wrbell/dad-ornithopter/INDEX.md

# MCO-1D Master Catalog & File Index

Comprehensive index of all active engineering assets and quarantined archives in the MCO-1D repository.

- **[ACTIVE]**: Authoritative configuration, firmware, parametric CAD, or documentation used for the physical build.
- **[ARCHIVE]**: Quarantined legacy iterations, duplicate modules, or unverified prototypes retained for reference.

---

## 1. Single Source of Truth & Governance (`config/`, `bom/`, `tools/`)

| File | Status | Description |
| :--- | :---: | :--- |
| [`config/airframe_spec.json`](config/airframe_spec.json) | **[ACTIVE]** | Canonical JSON specification for airframe mass (`3.642 kg` installed), geometry (`2.20 m` span, `0.28 m` chord, `2.24 m²` area), `10.0:1` capstan drivetrain, CAN nodes `0..7`, and GPIO pins. |
| [`firmware/mco_config.py`](firmware/mco_config.py) | **[ACTIVE]** | Python loader exposing `MCOConfig` to all firmware modules, CAD generators, and tests. |
| [`bom/bom.csv`](bom/bom.csv) | **[ACTIVE]** | Standard 39-component Bill of Materials CSV generated by [`scripts/mco_bom_tool.py`](scripts/mco_bom_tool.py) and validated by [`tools/bom_lint.py`](tools/bom_lint.py). |
| [`willem-suggestions.md`](willem-suggestions.md) | **[ACTIVE]** | Comprehensive technical audit, hardware/CAD/firmware bug post-mortem, and refactoring roadmap. |
| [`AGENTS.md`](AGENTS.md) / [`CLAUDE.md`](CLAUDE.md) | **[ACTIVE]** | Root and domain-specific (`firmware/`, `cad/`, `scripts/`, `docs/`, `tests/`) AI agent instructions. |
| [`tools/`](tools/) | **[ACTIVE]** | Collection standards linters (`agents_md_lint.py`, `ai_file_lint.py`, `bom_lint.py`, `check_docs.py`, `check_prints.py`). |

---

## 2. MCO-1D Mark 1 Documentation Suite (`docs/mark1/`)

| File | Status | Description |
| :--- | :---: | :--- |
| [`MCO-1D_Mark1_Master_Specification.md`](docs/mark1/MCO-1D_Mark1_Master_Specification.md) | **[ACTIVE]** | Master design specification: cascade geometry, S1223 aerodynamics, `10.0:1` capstan drivetrain, mass balance, and power budget. |
| [`MCO-1D_Mark1_Bill_of_Materials.md`](docs/mark1/MCO-1D_Mark1_Bill_of_Materials.md) | **[ACTIVE]** | Auto-generated 39-item procurement and mass ledger (`3,642 g` installed airframe mass; `6,150 g` shipped total; `$3,757.58 USD`). |
| [`MCO-1D_Mark1_Manufacturing_Guide.md`](docs/mark1/MCO-1D_Mark1_Manufacturing_Guide.md) | **[ACTIVE]** | Airframe fabrication manual: LW-PLA rib printing, carbon spar assembly, and `180 N` Dyneema capstan rigging. |
| [`MCO-1D_Mark1_Commissioning_Manual.md`](docs/mark1/MCO-1D_Mark1_Commissioning_Manual.md) | **[ACTIVE]** | Step-by-step airframe assembly, 8x ODrive CAN configuration, 16x AGFRC servo travel setup, and MCP3208 SPI ADC zeroing. |
| [`MCO-1D_Mark1_Operator_Manual.md`](docs/mark1/MCO-1D_Mark1_Operator_Manual.md) | **[ACTIVE]** | Pilot Operating Handbook (POH): Unified Wave Lever zones, takeoff/landing profiles, and emergency checklists. |
| [`MCO-1D_Mark1_Flight_Test_Protocol.md`](docs/mark1/MCO-1D_Mark1_Flight_Test_Protocol.md) | **[ACTIVE]** | 4-phase progressive test clearance: TC-01 (Bench), TC-02 (Tethered lift), TC-03 (Truck sweep), TC-04 (First free flight). |
| [`MCO-1D_Mark1_Builder_Calibration_Sheet.md`](docs/mark1/MCO-1D_Mark1_Builder_Calibration_Sheet.md) | **[ACTIVE]** | Post-build hardware measurement manifest (`FIG-01` to `FIG-08`) and pre-flight signoff sheet ([`PDF`](docs/mark1/MCO-1D_Mark1_Builder_Calibration_Sheet.pdf)). |
| [`MCO-1D_Mark1_Test_Card_Worksheets.md`](docs/mark1/MCO-1D_Mark1_Test_Card_Worksheets.md) | **[ACTIVE]** | Field data worksheets (`WS-00` through `WS-04`) and printable PDFs in [`docs/mark1/worksheets/`](docs/mark1/worksheets/). |
| [`MCO-1D_Mark1_Flight_Envelope_Specification.md`](docs/mark1/MCO-1D_Mark1_Flight_Envelope_Specification.md) | **[ACTIVE]** | Operating corridors, $V$-$n$ structural limits (`[-1.0g, +2.2g]`), and stall speed scaling. |
| [`MCO-1D_Mark1_Software_Reference.md`](docs/mark1/MCO-1D_Mark1_Software_Reference.md) | **[ACTIVE]** | 50 Hz executive loop architecture, safety governors, and CAN frame reference. |
| [`MCO-1.5D_SD7062_Specification.md`](docs/mark1/MCO-1.5D_SD7062_Specification.md) | **[ACTIVE]** | Alternate SD7062 lower-camber wing panel specification. |
| [`MCO-1D_Fasteners_and_Inserts_Mass_Budget.md`](docs/mark1/MCO-1D_Fasteners_and_Inserts_Mass_Budget.md) | **[ACTIVE]** | Fastener, bearing, dead-axle, and heat-set insert mass ledger. |
| [`MCO-1D_Hierarchical_Exploded_Installation_Guide.pdf`](docs/mark1/MCO-1D_Hierarchical_Exploded_Installation_Guide.pdf) | **[ACTIVE]** | 2-page 3-tier installation guide (Bevel Wrist -> Stagecoach Shoulder -> Fuselage Collar). |
| [`MCO-1D_V10_Powertrain_Mount_Installation_Guide.pdf`](docs/mark1/MCO-1D_V10_Powertrain_Mount_Installation_Guide.pdf) | **[ACTIVE]** | V10 Powertrain Stand, Dual-Shear Top Brace, and ODrive mounting manual. |
| [`MCO-1D_V10_Stagecoach_Wrist_Assembly_Guide.pdf`](docs/mark1/MCO-1D_V10_Stagecoach_Wrist_Assembly_Guide.pdf) | **[ACTIVE]** | V10 7-spoke Stagecoach sector drum and 2-DOF bevel wrist assembly guide. |
| [`MCO-1D_Electronics_and_Systems_Guide.pdf`](docs/mark1/MCO-1D_Electronics_and_Systems_Guide.pdf) | **[ACTIVE]** | Avionics, CAN bus topology, and dual-SBEC 7.4V servo power distribution guide. |

---

## 3. Core Flight Software (`firmware/`)

| File | Status | Description |
| :--- | :---: | :--- |
| [`mco_main.py`](firmware/mco_main.py) | **[ACTIVE]** | 50 Hz flight executive loop, sensor polling, command dispatch, and failsafe handling. |
| [`mco_config.py`](firmware/mco_config.py) | **[ACTIVE]** | Single-source-of-truth configuration loader reading [`config/airframe_spec.json`](config/airframe_spec.json). |
| [`mco_kinematics.py`](firmware/mco_kinematics.py) | **[ACTIVE]** | Deterministic 50 Hz metachronal phase oscillator, control allocation mixer, and 8-wing kinematics synthesizer (`MetachronalSynthesizer`), verified by [`tests/test_mco_kinematics.py`](tests/test_mco_kinematics.py). |
| [`mco_odrive_interface.py`](firmware/mco_odrive_interface.py) | **[ACTIVE]** | SocketCAN (`can0`) driver for 8x ODrive controllers (`10.0:1` capstan ratio, reciprocating velocity commands). |
| [`mco_odrive_setup.py`](firmware/mco_odrive_setup.py) | **[ACTIVE]** | ODrive CAN provisioner and calibration script. |
| [`mco_flight_governor.py`](firmware/mco_flight_governor.py) | **[ACTIVE]** | Envelope protection, WIG floor governor, load-factor limiter, and servo rate clamping. |
| [`mco_intent_control.py`](firmware/mco_intent_control.py) | **[ACTIVE]** | 5-channel pilot stick and unified wave-lever intent arbitration. |
| [`mco_performance_model.py`](firmware/mco_performance_model.py) | **[ACTIVE]** | Analytical aerodynamic performance estimator reading `MCOConfig`. |
| [`mco_cg_estimator.py`](firmware/mco_cg_estimator.py) | **[ACTIVE]** | Longitudinal Center of Gravity moment-arm calculator. |
| [`mco_build_measurements.py`](firmware/mco_build_measurements.py) | **[ACTIVE]** | Builder measurement ingestion tool (`knowledge/build_measurements.json`). |
| [`mco_preflight_checks.py`](firmware/mco_preflight_checks.py) | **[ACTIVE]** | Pre-flight Built-In Test (BIT) checking bus voltages, sensors, ADCs, and disk space. |
| [`mco_test_cards.py`](firmware/mco_test_cards.py) | **[ACTIVE]** | Test card runner for TC-01 through TC-04. |
| [`mco_first_run_wizard.py`](firmware/mco_first_run_wizard.py) | **[ACTIVE]** | Interactive hardware commissioning wizard. |
| [`mco_rc_verify.py`](firmware/mco_rc_verify.py) | **[ACTIVE]** | RC transmitter channel and detent verification utility. |
| [`mco_vibration_check.py`](firmware/mco_vibration_check.py) | **[ACTIVE]** | MPU-6050 accelerometer FFT vibration and capstan slip check. |
| [`mco_taxi_park.py`](firmware/mco_taxi_park.py) | **[ACTIVE]** | Ground taxi and wing stow/park coordinator. |
| [`mco_loadcell.py`](firmware/mco_loadcell.py) | **[ACTIVE]** | HX711 24-bit ADC driver for bench load-cell thrust measurements. |
| [`mco_logger.py`](firmware/mco_logger.py) / [`mco_log_analysis.py`](firmware/mco_log_analysis.py) | **[ACTIVE]** | 50 Hz CSV telemetry logger and post-flight log analyzer. |
| [`mco_mavlink.py`](firmware/mco_mavlink.py) | **[ACTIVE]** | Serial MAVLink v2 heartbeat and telemetry interface. |
| [`mco_ground_station.py`](firmware/mco_ground_station.py) / [`mco_gs_server.py`](firmware/mco_gs_server.py) / [`mco_ws_bridge.py`](firmware/mco_ws_bridge.py) | **[ACTIVE]** | Terminal CLI, HTTP server, and WebSocket telemetry bridge. |
| [`mco_panel.py`](firmware/mco_panel.py) / [`mco_sync.py`](firmware/mco_sync.py) / [`mco_hypothesis_tool.py`](firmware/mco_hypothesis_tool.py) | **[ACTIVE]** | Onboard SPI touchscreen diagnostic panel, log sync, and hypothesis inspector. |
| [`mco_wave_library.py`](firmware/mco_wave_library.py) / [`mco_advanced_physics.py`](firmware/mco_advanced_physics.py) | **[ACTIVE]** | Legacy wave hypothesis library (scheduled for replacement per [`willem-suggestions.md`](willem-suggestions.md)). |

---

## 4. Parametric CAD, Print Packages & Tooling (`cad/`, `scripts/`)

| File / Directory | Status | Description |
| :--- | :---: | :--- |
| [`scripts/mco_cli.py`](scripts/mco_cli.py) | **[ACTIVE]** | Unified CLI backing `./mco` (`doctor`, `test`, `sim`, `cad`, `slice`, `bom`, `docs`). |
| [`scripts/mco_bom_tool.py`](scripts/mco_bom_tool.py) | **[ACTIVE]** | Dynamic BOM calculator exporting [`bom/bom.csv`](bom/bom.csv), updating [`config/airframe_spec.json`](config/airframe_spec.json), and generating [`docs/mark1/MCO-1D_Mark1_Bill_of_Materials.md`](docs/mark1/MCO-1D_Mark1_Bill_of_Materials.md). |
| [`scripts/cad/`](scripts/cad/) | **[ACTIVE]** | 15 parametric CadQuery and DXF generators for wing root, S1223/SD7062 wings, and fuselage. |
| [`scripts/docs/`](scripts/docs/) | **[ACTIVE]** | ReportLab PDF assembly manual and field worksheet generators. |
| [`scripts/renders/`](scripts/renders/) | **[ACTIVE]** | PyVista off-screen technical rendering scripts. |
| [`scripts/mcp/prusaslicer_mcp_server.py`](scripts/mcp/prusaslicer_mcp_server.py) | **[ACTIVE]** | FastMCP server driving PrusaSlicer CLI & GUI. |
| [`cad/print_package_wing_root/`](cad/print_package_wing_root/) | **[ACTIVE]** | Wing root 3D print package (`01`–`08` + `PLATE_01_PA12CF_ALL_STRUCTURAL_PARTS.stl`). |
| [`cad/manufactured/`](cad/manufactured/) | **[ACTIVE]** | Generated `.step`, `.stl`, `.3mf`, `.dxf`, and `.f3d` models and render directories. |
| [`cad/slicer_profiles/`](cad/slicer_profiles/) | **[ACTIVE]** | PrusaSlicer `.ini` profiles (`pa12cf_structural`, `pa12cf_solid_gears`, `lwpla_aero_fairing`, `pla_prototype`). |
| [`cad/coordinates/`](cad/coordinates/) | **[ACTIVE]** | Selig S1223 and SD7062 airfoil coordinate files. |
| [`cad/drawings/`](cad/drawings/) | **[ACTIVE]** | 2D engineering drawings and HTML schematics. |

---

## 5. Quarantined Archives (`archive/`, `*/archive/`)

| Archive Location | Status | Contents |
| :--- | :---: | :--- |
| [`firmware/archive/legacy_modules/`](firmware/archive/legacy_modules/) | **[ARCHIVE]** | 14 duplicate/superseded firmware modules (`mco_preflight.py`, `mco_mavlink_bridge.py`, `mco_certification_tools.py`, etc.). |
| [`scripts/archive/fake_audits/`](scripts/archive/fake_audits/) | **[ARCHIVE]** | 18 quarantined fake FEA/CFD/LEGO/interference scripts that printed hardcoded `CERTIFIED` banners. |
| [`archive/tests_tautological/`](archive/tests_tautological/) | **[ARCHIVE]** | 47 quarantined tautological dictionary-lookup test suites. |
| [`archive/ui_claude_artifacts/`](archive/ui_claude_artifacts/) | **[ARCHIVE]** | 5 orphaned React `.jsx` artifacts with no bundler or backend integration. |
| [`docs/archive/`](docs/archive/) & [`docs/latest/`](docs/latest/) | **[ARCHIVE]** | Historical v1–v25 PDFs, quarantined synthetic CFD reports, and Mark 2 conceptual notes. |
