wrbell/dad-ornithopter/docs/latest/MCO_1D_Technical_Handover_v2.docx

MCO-1D METACHRONAL CASCADE ORNITHOPTER

DRONE PROTOTYPE

COMPLETE TECHNICAL HANDOVER DOCUMENT — REVISION 2

Requirements • Assumptions • Design Decisions • Algorithms • Formulae • Constraints • Bibliography

Wave Library: Rev-H-A-B-C-D-E-F-G-H-I-J-K-L-M-N-O2-O3-P

Document Date: 2026-06-11 | Supersedes Revision 1 (2026-06-10)

Classification: Engineering Design Record — Not for Distribution

Revision 2 additions: sprint sweep correction • trim zone analysis • ballistic descent clarification •

crab manoeuvre deep-dive • X-29 analysis • Rev O3-P (Boyd PI anti-windup, stoop latch, intent reset) • external submission evaluation

# 1. Programme Identity and Mission

## 1.1 Project Overview

The Metachronal Cascade Ornithopter (MCO) programme produces a small unmanned drone prototype (MCO-1D, 3.448 kg) as a technology demonstrator for a full-scale piloted Search-and-Rescue aircraft (MCO-1A, 376 kg). The core propulsion mechanism is four cascade-arranged wing pairs, each executing a metachronal stroke — sequential phase offsets between pairs, analogous to crustacean locomotion.

## 1.2 Requirements

- Sustained forward flight at cruise ≥ 9 m/s (17.5 kt).
- Metachronal cascade flapping as the sole propulsion and lift mechanism.
- Intent-based flight control architecture validated on MCO-1D before scaling to MCO-1A.
- Mountain and wilderness SAR mission capability at full scale.
- No hover requirement. No vertical take-off. Forward flight only.
- All wing parameters must stay within physical hardware limits enforced in software unconditionally.

## 1.3 Vehicle Specifications

Parameter | Value / Specification
Designation | MCO-1D (drone prototype)
MTOW | 3.448 kg
Stall speed Vs | 9.42 kt = 4.848 m/s (computed from MTOW, S, CL_max)
Design cruise speed | 9.0 m/s (17.5 kt)
Sprint speed | 14 m/s (27 kt)
Vne (structural limit) | 28 m/s (54 kt)
Total wing area S | 0.9796 m² (4 pairs, both sides; per geometry table)
Wing pairs | 4 (W1 foremost → W4 rearmost)
Chord (all pairs) | 165 mm (constant)
Airfoil | UIUC S1223 (Selig, Re ≈ 200,000)
CL_max | 2.40 (S1223 + VGs at 17%c + Gurney flap at 1%c + raked tip)
Effective AR at 90° sweep | ≈ 4.5
Oswald efficiency e | 0.78 (estimate — # CAL:)
Flap stroke amplitude | ±80° (full stroke = 160°)
Max flap frequency | 3.0 Hz (ODrive + 7:1 rope drive ceiling)
Sweep range | 0° (full forward) to 210° (stowed) — DS3225 mechanical stops
Longitudinal stagger | 138 mm between adjacent wing-pair roots

## 1.4 Wing Semi-Spans and Areas

Wing Pair | Semi-span (m) | Pair area (m²)
W1 (foremost) | 0.772 | 0.2548
W2 | 0.749 | 0.2472
W3 | 0.735 | 0.2426
W4 (rearmost) | 0.712 | 0.2350
Total | — | 0.9796 m²

# 2. Drivetrain and Hardware

Component | Specification
Flap motor (×8) | GoolRC 5010 360 KV brushless, one per wing
Motor controller (×8) | ODrive Micro (CAN-FD bus)
Gear ratio | 7:1 rope drive (motor to wing root)
Drive medium | Dyneema rope over aluminium pulleys
Sweep servo (×8) | DS3225 MG 25 kg·cm (2.45 N·m) at 6 V, 375°/s no-load, 270° range
Pitch servo (×8) | Emax ES08MD II metal gear, ±90° range
Servo PWM board | PCA9685 I²C
Flight computer | Raspberry Pi Zero 2W (mission logic at 50 Hz)
Autopilot / IMU | Pixhawk 6C Mini + M9N GPS + ASPD-4525 airspeed
Rangefinder | TFMini-S (TF-Luna) for AGL altitude
RC link | ExpressLRS 900 MHz
Telemetry | SiK 915 MHz radio
Battery | 6S LiPo 5000 mAh ≈ 540 g — largest single mass item
Computer bus | CAN-FD (ODrive) + I²C (servos) + UART (Pixhawk MAVLink)

## 2.1 DS3225 Sweep Servo Engineering Verification

The sweep servo resists only drag-induced torque about the vertical sweep axis. Lift forces create spar bending moments, not sweep torques.

F_drag = CD_profile × q × S_wing_one_side at V=14m/s, f=3Hz

τ_sweep = F_drag × semi × 0.4 = 0.257 N·m (W1, worst case)

DS3225 rated: 2.45 N·m → Safety factor = 9.5× at sprint speed

At forward sweep the drag moment is restoring (tries to sweep aft) — easier to hold than aft positions.

# 3. Wing Structure (Locked Rev H)

Element | Specification
Airfoil | UIUC S1223 (high-camber, high-lift, Re=200k)
Chord | 165 mm (all pairs)
Vortex generators | At 17%c → raises CL_max from ~1.8 to 2.40
Gurney flap | 1% chord (1.65 mm) at trailing edge
Raked tip | Applied to all pairs
Primary structure | D-box CF skin LE to 65%c
D-box skin | 100 gsm 2×2 twill CF, 0.1 mm thickness
D-box depth | 20 mm at max thickness (20%c)
Spars (3 per wing) | A: 20%c, B: 10%c, C: 55%c — 2.0 mm OD / 1.0 mm ID CF tube
Spar material | Pultruded CF, 600 MPa flexural (conservative)
Spar cross-section | Round (isotropic — identical stiffness in all sweep directions)
Rear membrane | Ripstop 65%c to 100%c
Ribs | LW-PLA, ~20 mm spacing, 3 mm solid root rib

## 3.1 Structural Safety Factors (Confirmed)

Load case | Safety factor
D-box bending at cruise (1g) | 121×
D-box bending at 3.8g (utility category) | 32×
D-box torsion at cruise | 147×
Torsional divergence speed V_div | 128.9 m/s = 4.6 × Vne (28 m/s)
Sweep servo torque at sprint speed | 9.5× (0.257 N·m demand vs 2.45 N·m capacity)

## 3.2 X-29 Aeroelastic Divergence — Does Not Apply

X-29 divergence requires a fixed root that resists torsional twist (forward sweep → bending → wash-in → more lift → catastrophic loop). MCO wings pivot freely — the sweep servo simply holds the commanded angle. No fixed root → no divergence loop. D-box GJ ≈ 0.26 N·m²; V_div = 128.9 m/s.

## 3.3 X-29 Advantages That Do Apply

- Root-first stall: at forward sweep, spanwise flow is inward → root stalls before tip → pitch servos at tips remain in attached flow → retained pitch authority past normal stall AoA.
- X-29 demonstrated control to 67° AoA using this mechanism. MCO pitch limit extended to 14° (vs normal 12°) when forward sweep mode active.
- Forward sweep is dynamically unstable → faster pitch response → more agile. FCC at 50 Hz handles the correction rate required.
- Stronger root LEV during CF-1 clap-and-fling when wings approach from forward-sweep pre-position.

## 3.4 Stagger — Engineering Decision

STAGGER_MM = 138.0 mm. This equals 0.836 × chord. The stagger is set by physical layout constraints and metachronal timing requirements. Proposals to increase stagger to "resolve vortex choking" were evaluated and rejected:

- "Vortex choking" is not a recognised aerodynamic phenomenon.
- Adjacent-wing wake interaction is real but is mitigated by cascade phase offsets, not physical separation.
- Increasing stagger to 247.5 mm would lengthen the fuselage by 79%, shift CG 55 mm aft, and require a complete layout redesign.
- Larger stagger reduces metachronal cascade timing benefit (mechanism relies on proximity).

# 4. Physical Envelope — Hard Limits

ALL limits are enforced unconditionally by enforce_physical_limits() inside ControlState.update(), executing as the final step every 50 Hz loop. No behaviour, CG compensator, external command, or numeric error can produce servo outputs outside these values.

Parameter | Limit and Physical Basis
Flap frequency | 0.0 – 3.0 Hz (ODrive + rope drive hard ceiling)
Wing sweep | 0° – 210° (DS3225 mechanical stops; 0° = full forward, 210° = stowed)
Wing dihedral | −20° – +60° (structural and aerodynamic bounds)
Wing pitch / AoA — normal flight | −8° – +12° (S1223 stalls at ~14°; 2° safety margin)
Wing pitch — fin mode (W1+W4 only) | ±90° (full servo range; fin mode exempt from AoA limit)
Wing pitch — X-29 high-AoA mode | −8° – +14° (root-first stall retains tip authority)
Flap stroke amplitude | ±80° nominal; ±85° hardware stop
Airspeed maximum (Vne) | 28 m/s
Airspeed minimum | Vs × 1.05 = 5.09 m/s (stall check auto-boosts frequency)
Maximum load factor (utility) | 3.8g (per 14 CFR Part 23 and FAA-H-8083-25B)

▸ Fin mode is flagged in _fin_mode_pairs. When W1 and/or W4 are in fin mode, those wings use ±90°; W2 and W3 always use ±12°.

▸ X-29 mode activates when V < 1.4 × Vs AND mean sweep ≈ 30°. Detected via intent flag, not sweep value (sweep may be in transition).

# 5. Aerodynamic Design Decisions

## 5.1 Drag Model — Correct Decomposition

Profile drag and induced drag must be treated separately. Profile drag uses actual wetted area (constant with sweep). Induced drag uses effective lifting area (varies with sweep angle):

D_profile = CD0 × q × S_actual (wetted area constant; CD0 ≈ 0.030 # CAL:)

S_eff = S × |sin θ| (θ = sweep angle from fuselage)

AR_eff = 4 × semi_mean² × |sin θ| / S (effective AR maximised at θ = 90°)

CDi = CL² / (π × AR_eff × e) (induced drag)

D_induced = CDi × q × S_eff

Key result: 90° sweep (straight lateral) minimises total drag at all speeds because AR_eff is maximised. This resolved the sprint sweep error.

## 5.2 Sprint Sweep Correction (Audit Finding 2026-06-10)

Three successive errors in sprint sweep were identified and corrected:

Version | Sprint sweep | Status
Rev A (original) | 135° | WRONG — increases induced drag 30–43% vs 90°
Rev O2 initial | 25–30° (forward) | WRONG — reduces AR_eff, increases CDi
Rev O2 audit (current) | 90° | CORRECT — max AR_eff, min drag at all speeds

The jet-wing analogy (aft sweep = fast) does not apply at low Re where there are no shocks. At V = 14 m/s sprint speed: D(90°) = 5.29 N vs D(135°) = 7.06 N — 25% higher drag at old setting.

## 5.3 Stall Speed

Vs = √(2W / (ρ × S × CL_max))

= √(2 × 33.83 / (1.225 × 0.979 × 2.40))

= 4.848 m/s = 9.42 kt

## 5.4 Lever Speed Zones

Lever % | Zone | Key parameters | Design intent
0–15 | SPRINT | f=2.5→3.0Hz sw=90° dih=−8° | Max thrust, min drag; 90° = max AR
16–30 | POWERED_CRUISE | f=3.0→1.5Hz sw=90°→60° | Deploy as V reduces
31–45 | STD_CRUISE | f=1.5→0.8Hz sw=80°→60° | Normal cruising
46–55 | TRIM | f=0.8→0.2Hz sw=60° | Brackets Ps=0 equilibrium
56–65 | CLEAN_GLIDE | f=0.2→0.15Hz dih=0°→8° | Minimum sink glide
66–75 | APPROACH | f=0.15→0.3Hz dih=8°→18° | Stabilised approach
76–85 | STEEP_DESCENT | f→0.5Hz sw→90° dih→35° | High drag descent
86–95 | NEAR_VERTICAL | f→0.8Hz sw→120° dih→45° | Very steep
96–100 | MAX_AIRBRAKE | f→1.0Hz sw→135° dih→55° | Maximum drag

## 5.5 Trim Zone Analysis

The TRIM zone (45–55%) brackets the Ps=0 equilibrium but does not place it exactly at lever=50%. The correct thrust model uses stroke velocity only (not combined airspeed):

T = CT × 0.5 × ρ × V_stroke_rms² × S × η (stroke velocity only)

D = (CD0 + CDi) × 0.5 × ρ × V_fwd² × S (forward speed only)

Working backwards from STD_CRUISE design intent (f=1.033 Hz holds level flight at V=9 m/s):

V_stroke_rms = 2π × 1.033 × AMP_rad × r_mean / √2 = 2.853 m/s

Required CT×η = D / (q_stroke × S) = 0.736 → CT ≈ 1.13 (# CAL:)

With calibrated CT, Ps=0 falls near lever=40–43% (STD_CRUISE mid-zone). The TRIM zone at 45–55% is a transition band — slight positive Ps at 47% (holds altitude in headwind), near Ps=0 at ~49%, and negative Ps at 53% (transition to glide). The exact equilibrium lever position must be measured at first flight.

⚠ All CT, η values are # CAL: placeholders. The equilibrium lever position will be measured in flight and zone boundaries adjusted if required.

# 6. Boyd Energy-Manoeuvring Theory

## 6.1 Fundamental Formulae

Ps = (T − D) × V / W [specific excess power, m/s]

Es = h + V²/(2g) [specific energy, metres]

Ps > 0: gaining energy. Ps = 0: holding energy state. Ps < 0: spending energy.

## 6.2 Boyd Frequency Controller — Rev O3-P (PI with Anti-Windup)

Original (Rev N): pure proportional → steady-state Ps offset persists.

Rev O3-P upgrade: PI controller with anti-windup:

error = Ps_target − Ps_measured

p_term = K_P × error (K_P = 0.08, unchanged)

i_tent = integral + K_I × error × dt (K_I = 0.04, new)

raw = freq_current + p_term + i_tent

if freq_min ≤ raw ≤ freq_max: integral = i_tent ← anti-windup gate

freq_out = clamp(raw, freq_min, freq_max)

Anti-windup mechanism: the integral only accumulates when the output is not saturated. This prevents the integral from winding up during prolonged sprint (at 3.0 Hz ceiling) or stall recovery, which would then fight the system when the limit condition cleared.

Integral reset: boyd_freq_command.reset() is called by IntentInterpreter._on_intent_change() on every intent transition via BehaviourDispatcher. This prevents cruise integral carrying into a dive or vice versa.

## 6.3 Ps Target Table (17 entries)

Ps Target | Intent | Design Rationale
+3.00 | sprint | Maximise surplus — accelerate
+1.00 | climb | Use surplus for altitude gain
+0.50 | power_dive | Gravity + thrust controlled dive
+0.20 | cruise | Slight surplus — maintain height
+0.20 | turn_gentle | Maintain energy through gentle turn
+0.10 | loiter | Minimal surplus — station keeping
+0.00 | chandelle | Trade V→h on Ps=0 boundary
+0.00 | stoop_pullout | Boyd zero-crossing pullout trigger
+0.00 | turn_moderate | Fly the Ps=0 boundary
+0.00 | zoom_climb | V→h on Ps=0 boundary
−0.30 | spiral | Controlled Es reduction
−0.50 | approach | Deliberate glide-path energy drain
−0.50 | turn_hard | Accept energy loss
−1.00 | landing | Drain Es to Vs²/(2g) at threshold
−2.00 | airbrake | Deliberate Es destruction
−9.99 | stoop_dive | Gravity powered — Ps irrelevant

# 7. Flight Control Architecture

## 7.1 Three-Layer Stack

1. Intent layer (IntentInterpreter): reads RC sticks and switches, detects gestures via GestureDetector, outputs Intent enum value + confidence. Resets Boyd integral on every intent change.
2. Behaviour layer (BehaviourDispatcher): maps Intent → BehaviourNode, runs tick() at 50 Hz, writes target values to ControlState._tgt_*.
3. Execution layer (ControlState.update()): applies bell-curve smoothing (smootherstep), classifies urgency, then calls enforce_physical_limits() and stall_speed_check() as the unconditional final step.

No behaviour or external function can write directly to servos. All output passes through ControlState.update().

## 7.2 Stick and Lever Assignment (Mode 2 TX)

Channel | Function
CH1 (roll stick) | Turn authority / crab direction / lateral input
CH2 (pitch stick) | Pitch attitude control / gesture input
CH3 (throttle) | Not used for thrust (thrust controlled by frequency, not throttle)
CH4 (yaw stick) | Yaw: cascade phase offset / fin pitch
CH5 (mode switch) | 0 = normal flight, 1 = flat-turn / fin mode / crab enable
CH6 (gl_lever) | Glide lever: 0% = sprint → 50% = trim → 100% = max airbrake
CH7 (macro switch) | Macro trigger: opens gesture detection window

## 7.3 Bell-Curve Smoothing (Rev M)

smooth_step(current, target, rate, dt, urgency)

→ smootherstep s(t) = 6t⁵ − 15t⁴ + 10t³ (zero-jerk quintic)

urgency = classify_urgency(intent, Ps, bank, V, h)

Urgency values: 1.0 = recover/emergency; 0.8 = stoop/dart/stoop_auto; 0.6 = zoom_climb; 0.5 = power_dive; 0.3 = cruise/turn/sprint; 0.0 = default/glide.

## 7.4 Stall Detection and X-29 Recovery

q = 0.5 × ρ × V²

n = 1 / cos(bank_deg) (load factor)

S_eff = S × mean(|sin θ_sweep|) (effective lifting area)

CL_req = W × n / (q × S_eff)

CAUTION at CL_req ≥ 0.80 × CL_max. STALL at CL_req ≥ CL_max. Auto-boost adds STALL_RECOVERY_FREQ_BOOST_HZ (0.30 Hz/s) until clear.

X-29 high-AoA mode activates when V < 1.4 × Vs: all wings sweep to 30°, pitch limit extended to 14°. Root stalls first → tip pitch servos retained in attached flow throughout recovery.

# 8. Intent and Behaviour Catalogue (44 Intents)

Intent | Behaviour Class | Category
cruise | CruiseBehaviour | Normal flight
climb | ClimbBehaviour | Normal flight (X-29 mode near stall)
descend / glide / soar | GlideBehaviour | Normal flight
sprint | SprintBehaviour | Performance (90° sweep, Ps=+3)
turn_left / turn_right | TurnBehaviour | Manoeuvre
tight_turn / slip / skid | TurnBehaviour | Manoeuvre
flat_turn_left / flat_turn_right | FlatTurnBehaviour | Manoeuvre (fin + W4 vectored)
crab_left / crab_right | CrabBehaviour | Advanced (Rev O3)
zoom_climb | ZoomClimbMacro | Advanced (inertial pitch assist)
power_dive | PowerDiveBehaviour | Advanced (lever-scaled Ps)
stoop / stoop_auto | StoopMacro | Advanced (gesture-triggered)
dart_left / dart_right | DartMacro | Advanced (fin + fling)
chandelle | ChandellesMacro | Advanced
cf1_burst | CF1Macro | Advanced (5° clap, Rev O2)
spiral_down | GlideBehaviour | Descent
loiter | LoiterBehaviour | Station-keeping
orbit_left / orbit_right | OrbitBehaviour | Station-keeping
approach_normal/steep/abort/site | GlideBehaviour / ClimbBehaviour | Approach
land | GlideBehaviour | Landing
emergency_land / recover | RecoverBehaviour | Safety (X-29 stall recovery)
rth | CruiseBehaviour | Safety
inspection | InspectionBehaviour | Ground / low speed
taxi_fwd / taxi_rev | TaxiFwd / TaxiRevBehaviour | Ground
wing_all/partial/single/slot/gap/rear | WingConfigBehaviour | Wing configuration

# 9. Gesture Detection

## 9.1 GestureDetector (Rev N + Rev O3-P Latch)

Maintains a 0.4-second (20-sample at 50 Hz) rolling history of stick position and lever. Three gestures:

Gesture | Conditions
zoom_climb | Pitch stick pulled back FAST (rate ≥ +1.5 sticks/s) + lever ≤ 20%
stoop_auto | Amplitude ≥ 0.85 full-fwd + rate ≤ −1.5 sticks/s (time-latched) + lever > 60%
power_dive | Steady fwd pitch (−0.3 to −0.7) sustained ≥ 22 samples + lever 25–50%

## 9.2 Stoop Gate — Three Mandatory Conditions (Rev N + Rev O3-P)

Wing stow triggers ONLY when ALL THREE conditions are simultaneously satisfied:

- AMPLITUDE: pitch stick at ≥ 85% of full forward travel.
- RATE: stick reached that position at ≥ 1.5 sticks/second — full travel in < 0.67 s.
- LEVER: lever in glide zone (> 60%).

⚠ Nothing else triggers wing stow. IMU pitch alone never triggers stow. Steady stick at full forward does not trigger stow. Lever on power side never triggers stow.

## 9.3 Rev O3-P Time-Latch Improvement

The rate condition is now time-latched for 0.35 seconds after detection. If a valid fast-push is detected at sample N, the rate gate remains active until t_N + 0.35 s. This prevents a single dropped sample on the RPi Zero 2W shared bus from falsely failing the rate check when the pilot did genuinely throw the stick.

_stoop_rate_latch_t updated each call: self._t_last += dt (0.02 s per sample)

rate_latched = fast_enough OR (t_now − latch_time) ≤ 0.35 s

# 10. Key Manoeuvres — Physics and Parameters

## 10.1 Dart Manoeuvre

- W1 and W4 pitch to 75° (vertical fin mode). W2 and W3 sustain lift at CL = 0.50.

M_yaw = 10.30 N·m → 2.43g lateral at V=14 m/s → 90° in 0.145 s

Phases: PREBUILD → ENGAGE → PIVOT → DISENGAGE (continuous fling, Rev O3) → RESUME.

Rev O3 DISENGAGE — no dead stroke: W1+W4 un-pitch and sweep to 0° simultaneously (Phase A, 0.05 s), then fling stroke 0°→135° immediately (Phase B). First post-dart stroke begins from 0° running start — biologically faithful, no pause.

## 10.2 Enhanced CF-1 Clap-and-Fling (Rev O2)

- Clap angle: 5° (tip gap = 135 mm = 0.82 × chord — safe clearance).
- Vortex strength: Γ ∝ 1/gap → 9.94× stronger than original 35° clap.
- ΔCL ≈ 1.80 (capped at CL_max). Fling tip velocity: 12.7 m/s (running start from 0°).
- Pair sequence: W1 → W3 → W2 → W4 (non-adjacent first for spatial diversity).

## 10.3 Crab Manoeuvre (Rev O3)

Four simultaneous independent control axes — lateral translation without heading change:

Axis | Implementation
Lateral thrust | All port wings at 30° sweep → F_lat = 17.0 N = 3.5g
Heading hold | W1+W4 fin pitch 44° → 5.05 N·m yaw moment cancels induced yaw
Forward thrust | Stbd wings at 60° deployed → normal propulsion
Altitude | Flap frequency maintained at cruise level

Rigorous force decomposition (3D cross-product):

span = (cos θ, sin θ, 0)

V_rel = (V_fwd, 0, −V_stroke)

F_dir = (span × V_rel) / |span × V_rel|

= (−sinθ × V_s, cosθ × V_s, −sinθ × V_fwd) / |...|

At θ=30° port, θ=90° stbd: F_lat = 17.0 N, a_lat = 3.5g (verified)

Yaw balance:

M_induced = F_lat × arm = 17.0 × 0.297 = 5.05 N·m (nose-left)

Fin pitch 44° → M_fin = 10.3 × 44/90 = 5.04 N·m (nose-right)

Residual = 0.01 N·m ≈ zero ✓

Crosswind tolerance: 17 N overcomes crosswind drag to ~13 m/s. Combined with partial heading-into-wind: ~18–20 m/s effective tolerance. Trigger: flat_turn mode (CH5=1) + roll stick > 0.2.

## 10.4 Zoom Climb

Phases: ENTRY (V→Ps=0), CLIMB (Ps=0, h gaining), APEX (V near Vs, switch).

Inertial pitch assist (Rev O3): W1 pre-positioned to 0° over 0.67 s before trigger. At entry, W1 sweeps 0°→90° with first stroke. Angular momentum transfer: 51°/s nose-up reaction for 1.0 s, speed-independent.

## 10.5 Split-Wing Descent (formerly Ballistic Descent)

Name corrected: not ballistic (uncontrolled) — this is a controlled gravity-driven descent.

Configuration: W1+W4 at 0° (edge-on to flow — minimum drag). W2+W3 at 90° (straight lateral — maximum effective area, highest n_max). Frequency: 0.2 Hz maintenance.

Physics: gravity provides the propulsive component along the descent path (W×sin γ). W2+W3 provide the lift component (W×cos γ).

At V=14m/s, 30° descent: n_max (W2+W3 at 90°) = 4.17g (sufficient for pullout)

The 90° sweep for W2+W3 is confirmed correct. 90° maximises S_eff and AR_eff → lowest required CL → maximum stall margin → best pullout load factor.

This function has no active dispatch path currently — it is a correctly-specified placeholder.

## 10.6 Vectored Lateral Thrust

At port sweep θ < 90°, port-side thrust is redirected laterally. The sweet spot is θ_port = 25–35° (stbd CL safe, maximum F_lat). At θ=0° stbd CL approaches CL_max at slow speeds.

All-port at 30°: F_lat = 17.0 N = 9.3× stronger than Rev O2 (W4 only at 0°: 1.82 N)

## 10.7 X-29 High-AoA Mode (Rev O3)

Activates at V < 1.4 × Vs. All wings sweep to 30°. Root stalls first → pitch servos at tips retained. Pitch limit extended to 14°. Used in ClimbBehaviour, RecoverBehaviour, and stall recovery.

# 11. Weight and Balance (FAA-H-8083-1B Method)

## 11.1 CG Formula

CG_mm = Σ(weight_i × arm_i) / Σ(weight_i)

CG_%MAC = (CG_mm − LEMAC_mm) / MAC_mm × 100

## 11.2 Reference Geometry

Parameter | Value
Datum | Nose tip of fuselage (all arms positive aft)
LEMAC | 280 mm aft of datum [# CAL: measure at build]
MAC | 165 mm (= chord)
Forward CG limit | 15% MAC [to be confirmed by flight test]
Aft CG limit | 35% MAC [to be confirmed by flight test]

## 11.3 Three-Layer CG System

4. CGStaticModel (preflight, ground): arm table + pilot weights → CG. Pre-flight BIT gate. All weights # CAL:.
5. CGFlightEstimator (every 5 s): pitch trim deviation (pitch_cmd − pitch_model → delta_AoA × K_pitch → delta_CG). Lateral sweep asymmetry → lateral CG. Kalman-style update α = 0.08 per observation.
6. CGCompensator (50 Hz): adjusts _tgt_pitches and _tgt_sweeps. Authority: ±4° AoA differential W1/W4 ≈ ±10 mm longitudinal. Max 30 mm compensation range.

⚠ All CG calibration gains (K_pitch, K_lateral, K_rate) are # CAL: placeholders. Calibrate at first flight.

# 12. Software Architecture

## 12.1 Module Inventory

Module | Purpose and current line count
mco_wave_library.py | All wave parameters, physics, constants. Rev O3-P. ~6,400 lines.
mco_intent_control.py | Intent enum, 44 behaviours, dispatcher. ~1,010 lines.
mco_main.py | 50 Hz main loop, CG integration, dispatcher. ~484 lines.
mco_cg_estimator.py | Three-layer W&B system. ~642 lines.
mco_preflight.py | BIT checks, pre-flight W&B gate. ~762 lines.
mco_performance_model.py | Thrust/drag/Ps model, calibration params. ~779 lines.
mco_flight_recorder.py | Telemetry logging. ~286 lines.
mco_optimiser.py | In-flight parameter tuning. ~624 lines.
mco_taxi_park.py | Ground operations. ~550 lines.
mco_odrive_interface.py | CAN-FD motor control.
mco_servo_interface.py | I²C PCA9685 servo interface.
mco_mavlink_bridge.py | MAVLink bridge to Pixhawk.
mco_first_run_wizard.py | First-flight calibration wizard.

## 12.2 50 Hz Loop Sequence

7. Read sensors: IMU, GPS, airspeed, rangefinder, battery voltage/current.
8. Build context dict.
9. GestureDetector.update(): slide rolling window, detect zoom/stoop/power_dive.
10. BehaviourDispatcher.update(): detect intent change → _on_intent_change() (resets Boyd integral) → run active behaviour tick() → write _tgt_* values to ControlState.
11. CGFlightEstimator.update() every 250 loops (5 s): update CG offset estimate.
12. CGCompensator.apply(): modulate _tgt_pitches and _tgt_sweeps for CG offset.
13. ControlState.update(): bell-curve smooth toward targets → classify urgency → enforce_physical_limits() → stall_speed_check() — unconditionally last.
14. Write outputs: ODrive motor commands (CAN-FD) + servo PWM (I²C).
15. Log telemetry.

## 12.3 Version String

Rev-H-A-B-C-D-E-F-G-H-I-J-K-L-M-N-O2-O3-P 2026-06-11

▸ Addendum P = Boyd PI anti-windup + stoop rate latch + intent reset on transition

# 13. Calibration Requirements Before First Flight

All items marked # CAL: in the codebase must be measured before the first sortie:

Calibration Item | Measurement Method
Component weights (all COMPONENT_ARMS entries) | Weigh each item on calibrated scale before installation
Component arms (all COMPONENT_ARMS entries) | Measure from nose tip with steel rule after assembly
LEMAC position | Measure leading edge of mean chord from nose tip after build
CT_cal (thrust coefficient × efficiency) | Note lever position holding altitude at cruise; back-calculate from T=D condition
K_pitch (CG longitudinal estimator) | Fly at known battery position; measure trim AoA deviation; K = known_offset / measured_error
K_lateral (CG lateral estimator) | Fly straight with deliberate lateral CG offset; measure sweep asymmetry
CG envelope limits (15–35% MAC) | Confirm by test: fly at forward limit loading; check pitch authority; fly at aft limit; check stability
Stall speed Vs (actual) | Measure in flight; compare to 4.848 m/s prediction
STALL_RECOVERY_FREQ_BOOST_HZ | Tune during low-speed flight testing
Trim lever position for Ps=0 | Measure directly: note lever at which aircraft holds altitude at cruise speed
Oswald efficiency e | Back-calculate from measured glide ratio vs predicted
Boyd PI gains (K_P, K_I) | Tune in flight if Ps tracking is oscillatory or sluggish

# 14. Pending Items and Open Decisions

## 14.1 Open Engineering Tasks

- Add preflight_wb_check() call to Tier 1 BIT in mco_preflight.py.
- Implement run_cf1_clap_fling() execution path (O-C1).
- STOOP priority interrupt to FCC — safety critical, must be hardware-level (O-C2).
- GPS terrain trigger for mountain mode (O-D7).
- T-MT1 validation procedure (O-D8).
- split_wing_descent_params() is an orphan — no active dispatch path. Wire to an intent when stoop continuation is implemented.
- Tier 2 all-pair 0° sweep (with 135° phase offset): defer until single-pair validated in flight.
- NumPy vectorisation of ControlState: valid target for RPi Zero 2W performance, but requires rewriting the 44-behaviour interface. Separate engineering task.

## 14.2 Test Status

⚠ T1–T14 all PENDING. The craft has not yet been built. All # CAL: constants are design estimates.

## 14.3 Design Decisions Awaiting Flight Data

- Exact trim lever for Ps=0 (depends on CT_cal).
- CG envelope limits 15–35% MAC (confirm by test).
- Cascade phase offset for multi-pair 0° sweep.
- STALL_RECOVERY_FREQ_BOOST_HZ optimum value.
- Boyd PI gains K_P = 0.08, K_I = 0.04 (physically motivated estimates; tune in flight).

# 15. Key Assumptions and Constraints

## 15.1 Aerodynamic

- CL_max = 2.40 is the UIUC tunnel value for S1223 + VGs at Re ≈ 200,000. May differ at the MCO's operating Re.
- CD0 = 0.030 is an estimate. Actual value depends on membrane tension, rib finish, and construction quality.
- Oswald efficiency e = 0.78 is estimated from similar configurations. # CAL:
- CT and η (flapping thrust coefficient and efficiency) are # CAL:. The Boyd controller, Ps calculations, and trim lever position all depend on these.
- Static stall model in stall_speed_check(). Dynamic stall during active flapping may differ.

## 15.2 Structural

- D-box analysis uses simplified thin-wall beam model. Actual failure mode depends on adhesive bond quality.
- Wing mass estimates are from material densities. All must be measured.
- Spar isotropic assumption is correct for round pultruded CF tubes.

## 15.3 Control

- FCC loop rate is a true 50 Hz. RPi Zero 2W shared bus (CAN-FD + I²C simultaneously) must sustain this without jitter. Validate before first flight.
- Boyd PI gains K_P = 0.08, K_I = 0.04 are physically motivated. Integral windup is prevented by anti-windup gate and intent reset. Actual tuning required in flight.
- GPS accuracy adequate for RTH and orbit modes. Mountain terrain may produce multipath.

## 15.4 Safety-Critical Constraints (Non-Negotiable)

- enforce_physical_limits() MUST be the final step in every ControlState.update() call. No exception.
- Wing stow triggers only on three simultaneous conditions: amplitude ≥ 0.85, rate ≥ 1.5 sticks/s (time-latched), lever in glide zone. No other path.
- IMU pitch angle alone NEVER triggers wing stow or dive-stow.
- Dive stow only activates with lever on glide side (> 52.5%). Power lever side = power dive, no stow.

# 16. External Submission Evaluation (2026-06-11)

A partial rewrite of mco_wave_library.py was submitted for evaluation. The submission comprised approximately 5% of the library content (four new classes). Evaluation result:

## 16.1 Adopted

Improvement | Decision and Rationale
Boyd PI controller with anti-windup | ADOPTED. Valid engineering improvement. Eliminates steady-state Ps error. Anti-windup gate prevents integrator rundup at saturation. Integrated as Rev O3-P with intent-change reset.
Time-latched stoop rate detection | ADOPTED. Addresses genuine fragility: a single dropped sample on the shared bus could fail the rate gate. 0.35 s latch maintains gate across transient dropouts. Integrated as Rev O3-P.

## 16.2 Rejected

Proposed Change | Rejection Reason
STAGGER_MM = 247.5 (from 138.0) | REJECTED. "Vortex choking" is not a recognised aerodynamic phenomenon. The mitigation for wake re-ingestion is cascade phase offsets (already implemented). Increasing stagger by 79% would lengthen the fuselage from 414 mm to 742 mm, shift CG 55 mm aft, require full layout redesign, and reduce metachronal coupling benefit.
X-29 mode detected by np.isclose(sweeps, 30.0) | REJECTED. Fragile: sweep value is 29.8° during bell-curve transition. Must use intent flag or dedicated boolean, not a live servo value.
NumPy vectorised ControlState as replacement | NOT ADOPTED THIS SESSION. Valid performance target for RPi Zero 2W but requires rewriting the interface all 44 behaviours depend on. Separate future task.

# Appendix A — Complete Physical Constants

Constant | Value and Basis
MTOW_KG | 3.448 kg
RHO | 1.225 kg/m³ (ISA sea level)
G | 9.81 m/s²
VS_KT | 9.42 kt = 4.848 m/s (computed)
CL_MAX | 2.40 (S1223 + VGs + Gurney, UIUC)
CHORD_MM | 165.0 mm
STAGGER_MM | 138.0 mm (0.836 × chord — confirmed, not to be changed)
FLAP_AMP_DEG | ±80.0°
REDUCER_RATIO | 7 (rope drive)
FREQ_LIMIT_MAX_HZ | 3.0 Hz
FREQ_LIMIT_MIN_HZ | 0.0 Hz
SWEEP_LIMIT_MIN_DEG | 0.0° (full forward — confirmed safe, no divergence)
SWEEP_LIMIT_MAX_DEG | 210.0° (stowed)
DIHEDRAL_LIMIT_MIN_DEG | −20.0°
DIHEDRAL_LIMIT_MAX_DEG | +60.0°
PITCH_LIMIT_MIN_DEG | −8.0°
PITCH_LIMIT_MAX_DEG | +12.0° (normal) / +14.0° (X-29 high-AoA mode)
FIN_PITCH_LIMIT_DEG | ±90.0° (fin mode W1+W4 only)
V_LIMIT_MAX_MS | 28.0 m/s (Vne)
DART_FIN_PITCH_DEG | 75.0°
CF1_CLAP_SWEEP_DEG | 5.0° (enhanced Rev O2)
CF1_FLING_END_DEG | 135.0°
CF1_CLAP_GAP_MM | 135 mm = 0.82 × chord (safe structural clearance)
CF1_DELTA_CL_ENHANCED | 1.80 (9.94× vortex strength vs 35° original)
STOOP_STICK_AMPLITUDE_MIN | 0.85 (85% of full throw)
STOOP_STICK_RATE_MIN | 1.5 sticks/s
STOOP_AUTO_LEVER_THRESHOLD | 60.0% (glide zone required)
STOOP_RATE_LATCH_S | 0.35 s (Rev O3-P time-latch window)
INERTIAL_PITCH_PREPOS_S | 0.67 s (W1 sweep 60°→0°)
INERTIAL_PITCH_RATE_DPS | 51.0°/s (fuselage reaction at 90°/s sweep rate)
LEVER_SPRINT_END | 15.0%
LEVER_PWR_CRUISE_END | 30.0%
LEVER_STD_CRUISE_END | 45.0%
LEVER_TRIM_END | 55.0%
X29_FORWARD_SWEEP_DEG | 30.0°
X29_AoA_LIMIT_DEG | 14.0°
CRAB_PORT_SWEEP_DEG | 30.0° (sweet spot: F_lat=17N, stbd CL safe)
CRAB_FIN_PITCH_DEG | 44.0° (cancels 5.05 N·m induced yaw)
Boyd K_P | 0.08 (unchanged from Rev N)
Boyd K_I | 0.04 (new Rev O3-P — eliminates steady-state Ps error)

# Appendix B — Key Formulae Summary

## Stall speed

Vs = √(2W / (ρ × S × CL_max)) = 4.848 m/s

## Specific excess power

Ps = (T − D) × V / W [m/s]

## Specific energy

Es = h + V²/(2g) [m]

## Load factor in banked turn

n = 1 / cos(bank_deg)

## Thrust model (stroke velocity only)

T = CT × 0.5 × ρ × V_stroke_rms² × S × η

V_stroke_rms = 2π × f × AMP_rad × r_mean / √2

## Drag model (forward speed only)

D = (CD0 + CDi) × 0.5 × ρ × V_fwd² × S

CDi = CL² / (π × AR_eff × e)

AR_eff = 4 × semi_mean² × |sin θ| / S

## Boyd PI controller

freq_new = freq_old + K_P×error + integral (anti-windup gated)

integral += K_I × error × dt (only when output unsaturated)

## Required CL in flight

CL_req = W × n / (q × S_eff) q = 0.5 × ρ × V²

## Torsional divergence speed

q_div = GJ / (dCL/dα × e_AC × S × semi)

V_div = √(2 × q_div / ρ) = 128.9 m/s (4.6 × Vne)

## CG position (FAA-H-8083-1B)

CG_mm = Σ(w_i × arm_i) / Σ(w_i)

CG_%MAC = (CG_mm − LEMAC_mm) / MAC_mm × 100

## Vectored thrust force decomposition

lift_dir = (span × V_rel) / |span × V_rel|

span = (cos θ, sin θ, 0) V_rel = (V_fwd, 0, −V_stroke)

F_lat at θ=30°: 17.0 N = 3.5g (confirmed numerically)

## Crab yaw balance

M_induced = F_lat × r_mean × 0.4 = 17.0 × 0.297 = 5.05 N·m

Fin pitch for null yaw = (5.05 / 10.3) × 90° = 44°

## Smootherstep (bell-curve, zero-jerk)

s(t) = 6t⁵ − 15t⁴ + 10t³ t ∈ [0, 1]

# Appendix C — Bibliography

## C.1 Aerodynamics — Airfoil Data

Source | Notes
Selig, M.S. et al. — "Summary of Low-Speed Airfoil Data" Vols 1–6 (UIUC Applied Aerodynamics Group) | Primary source for S1223 geometry and CL/CD data. Free: m-selig.ae.illinois.edu/ads.html
UIUC Airfoil Coordinates Database | S1223 .dat file used for Rev H2 wing construction drawing. m-selig.ae.illinois.edu/ads/coord_database.html
Selig, M.S. — "S1223 Retested Data" (UIUC LSAT, 2005) | Pitching moment data. m-selig.ae.illinois.edu/uiuc_lsat/s1223/

## C.2 Flight Performance and Weight-and-Balance

Source | Notes
FAA-H-8083-1B — Aircraft Weight and Balance Handbook (FAA, 2016) | Authoritative W&B methodology. All CG calculations follow this standard. faa.gov/regulations_policies/handbooks_manuals/aviation/
FAA-H-8083-25B — Pilot's Handbook of Aeronautical Knowledge (FAA, 2016) | Load factor tables (3.8g utility), stall speed formulae, turn performance used throughout manoeuvre design.
FAA-H-8083-15B — Instrument Flying Handbook (FAA) | Energy state management concepts and approach procedures.

## C.3 Energy-Manoeuvring Theory

Source | Notes
Boyd, J.R. — "Aerial Attack Study" (USAF, 1964) | Original E-M theory: Ps, Es formulae, zoom-climb and stoop design philosophy.
Boyd, J.R. — "Patterns of Conflict" (briefing, 1986) | OODA loop and decision-cycle theory underlying the intent-based control architecture.
Kershner, W.K. — "The Student Pilot's Flight Manual" (9th ed.) | Practical energy management for approach and landing phase design.

## C.4 Flapping Wing Aerodynamics

Source | Notes
Weis-Fogh, T. — "Quick estimates of flight fitness in hovering animals, including novel mechanisms for lift production" (J. Exp. Biol. 59, 1973) | Original clap-and-fling theory. Basis for CF-1 vortex strength estimates.
Cheng, B. et al. — "Three-dimensional flow visualization and vorticity dynamics in revolving wings" (Exp. Fluids, 2013) | Vortex circulation vs gap relationship for clap-and-fling scaling (Γ ∝ 1/gap).
Ellington, C.P. et al. — "Leading-edge vortices in insect flight" (Nature 384, 1996) | LEV mechanism underlying CF-1 and forward-sweep lift enhancement.
Dickinson, M.H., Lehmann, F.O., Sane, S.P. — "Wing rotation and the aerodynamic basis of insect flight" (Science 284, 1999) | Unsteady aerodynamic mechanisms at stroke reversal; rotational lift.

## C.5 Metachronal Locomotion

Source | Notes
Ford, M.P. et al. — "Hydrodynamics of metachronal paddling: effects of varying duty cycle" (J. R. Soc. Interface, 2019) | Phase offset optimisation directly applied to cascade timing design.
Murphy, D.W. et al. — "Metachronal swimming in Antarctic krill: gait kinematics" (J. Exp. Biol., 2011) | Phase offset data from biological metachronal locomotion.
Alben, S. et al. — "Dynamics of freely swimming flexible foils" (Phys. Fluids 24, 2012) | Wave propagation in multi-appendage systems; theoretical basis for cascade.

## C.6 Forward Swept Wings and Aeroelasticity

Source | Notes
Putnam, T.W. — "The X-29 Flight Research Program" (NASA TM-86869, 1984) | X-29 divergence mechanism and composite tailoring solution. Basis for MCO divergence analysis (non-applicable).
Norris, G. — "X-29: When Forward Was the Way Ahead" (Aviation Week, 2014) | 67° AoA with retained control — applied to MCO pitch servo effectiveness at high AoA.
Grumman Corporation — X-29 ATD design documents (1984–1992) | Wash-in mechanism, composite tailoring, root-stall aerodynamics.

## C.7 Control Theory

Source | Notes
Franklin, G.F., Powell, J.D., Emami-Naeini, A. — "Feedback Control of Dynamic Systems" (8th ed., Pearson) | PI controller design, anti-windup mechanisms, integral reset strategies.
Åström, K.J. and Hägglund, T. — "PID Controllers: Theory, Design, and Tuning" (ISA, 1995) | Anti-windup back-calculation and integral clamping methods.

## C.8 Structural Analysis

Source | Notes
Budynas & Nisbett — "Shigley's Mechanical Engineering Design" (10th ed., McGraw-Hill) | Bending stress in thin-walled sections; Bredt's formula for torsional stiffness (D-box GJ).
Jones, R.M. — "Mechanics of Composite Materials" (2nd ed., Taylor & Francis) | Carbon fibre modulus and strength; isotropic tube assumption.

## C.9 Hardware and Interfaces

Source | Notes
ODrive Robotics — "ODrive Documentation v0.6" (odriverobotics.com) | CAN-FD protocol, current limits, motor configuration. Used in ODrive troubleshooting.
PX4 / Pixhawk 6C Mini documentation (px4.io) | Flight controller integration, MAVLink, sensor fusion.
ExpressLRS documentation (expresslrs.org) | RC link latency and failsafe.

## C.10 Applicable Standards

Standard | Application
14 CFR Part 23 (FAA) | Load factor limits: 3.8g utility, 4.4g acrobatic, 6.0g aerobatic
FAA-H-8083-1B | W&B methodology throughout CG system
FAA-H-8083-25B | Aerodynamic performance, stall, turns, approach
FAA Advisory Circular AC 43.13-1B | Structural standards applied to safety factor requirements
DO-178C (informational only) | Software development levels noted; not formally applied to prototype

End of document.

MCO-1D Technical Handover — Revision 2 — Rev O3-P — 2026-06-11

Rev-H-A-B-C-D-E-F-G-H-I-J-K-L-M-N-O2-O3-P | Page of

MCO-1D Technical Handover Rev 2 | Rev O3-P | Engineering Design Record
