wrbell/dad-ornithopter/cad/drawings/MCO_1D_VG_Design.pdf

MCO-1D WING DESIGN SPECIFICATION Rev E | AIRFOIL CROSS-SECTION — ALL STRUCTURAL ELEMENTS

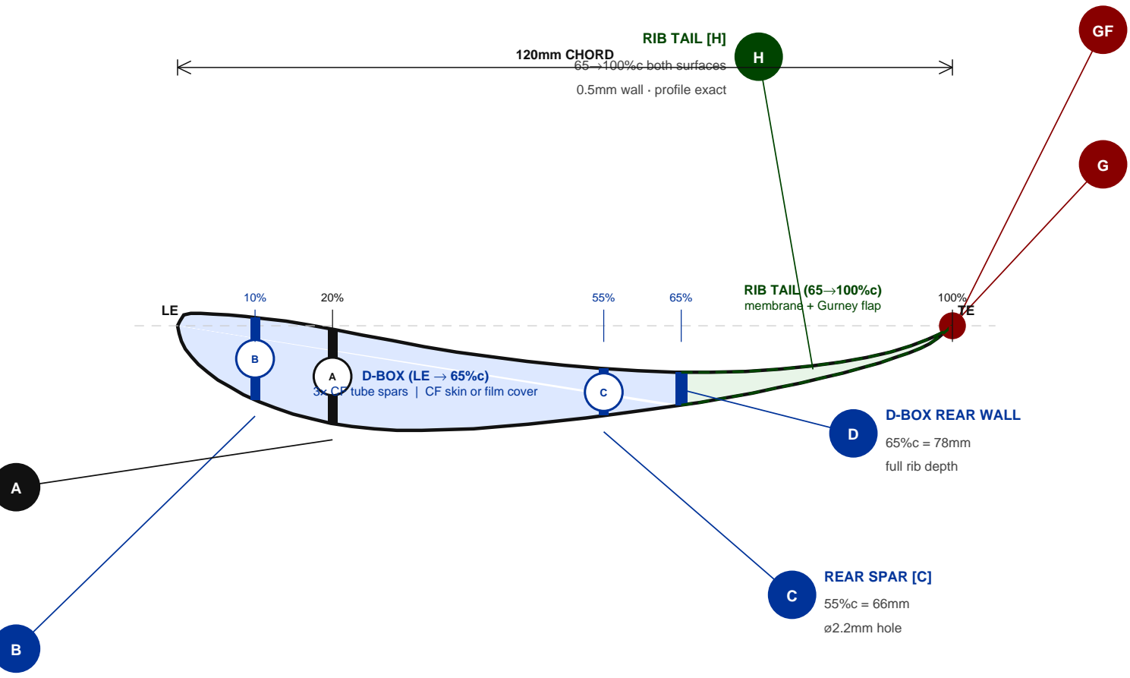
[picture p1: figure]
REAR SPAR [C]; ø2.2mm hole; D-BOX REAR WALL; full rib depth; RIB TAIL [H]; 65→100%c both surfaces; 0.5mm wall · profile exact; D-BOX (LE → 65%c); RIB TAIL (65→100%c) membrane + Gurney flap; 120mm CHORD

DWG: MCO-1D-WING-001 Rev E | May 2026 | S1223 120mm chord | All design decisions consolidated | Page 1 of 5
3× CF tube spars | CF skin or film cover

## DIAGRAM 1 — S1223 SIDE PROFILE: ALL SPARS, D-BOX, RIB TAIL, GURNEY FLAP, TE ROD

MCO-1D WING DESIGN SPECIFICATION Rev E | RIB FACE · HOLE SCHEDULE · VG GEOMETRY

### DIAGRAM 2 — RIB FACE (SPAN-DIRECTION VIEW)

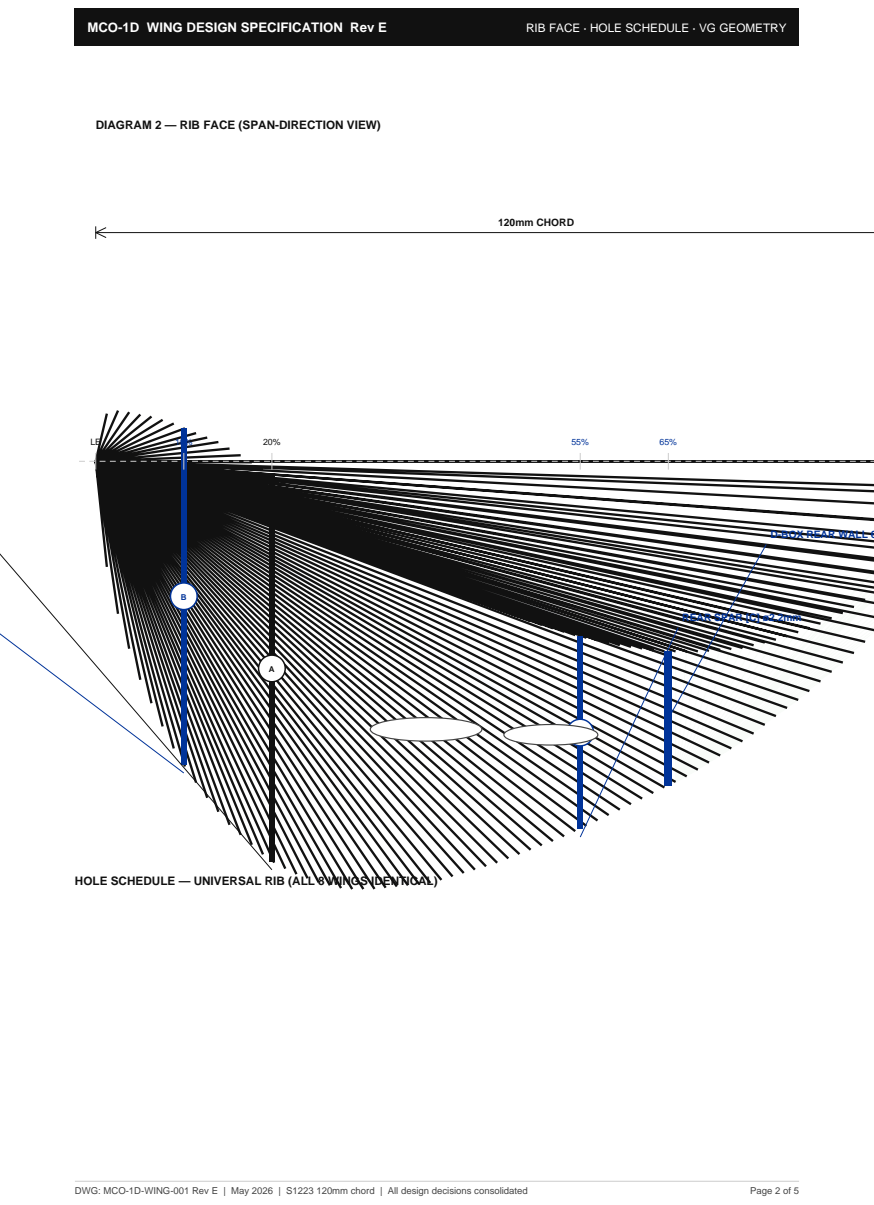
[picture p2: page 2]
DWG: MCO-1D-WING-001 Rev E | May 2026 | S1223 120mm chord | All design decisions consolidated; Page 2 of 5; REAR SPAR [C] ø2.2mm; 120mm CHORD

D-BOX REAR WALL 65%c

HOLE SCHEDULE — UNIVERSAL RIB (ALL 8 WINGS IDENTICAL)

MCO-1D WING DESIGN SPECIFICATION Rev E VORTEX GENERATORS (MICRO AERODYNAMICS STYLE) · COVERT FLAPS

## DIAGRAM 3 — VG BLADE GEOMETRY AND MOUNTING STRIP (ALL VIEWS)

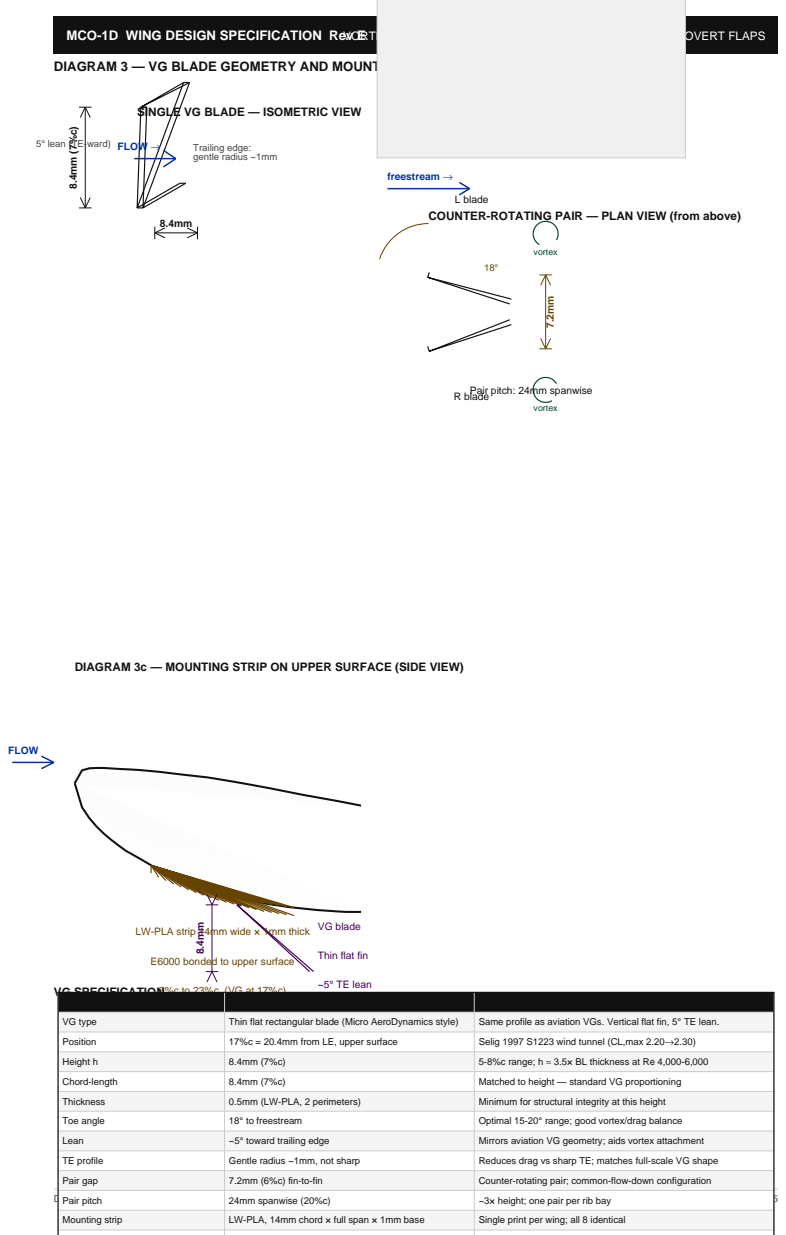
[picture p3: page 3]
DWG: MCO-1D-WING-001 Rev E | May 2026 | S1223 120mm chord | All design decisions consolidated; Page 3 of 5; 5° lean (TE-ward); Trailing edge:; gentle radius ~1mm; FLOW →; freestream →; vortex; VG blade; ~5° TE lean; FLOW; VG SPECIFICATION; Strip bond; E6000 along base; Flexible cure — absorbs flap micro-vibration at 1-2Hz

SINGLE VG BLADE — ISOMETRIC VIEW

L blade
COUNTER-ROTATING PAIR — PLAN VIEW (from above)

R blade Pair pitch: 24mm spanwise

DIAGRAM 3c — MOUNTING STRIP ON UPPER SURFACE (SIDE VIEW) 8.4mm

LW-PLA strip 14mm wide × 1mm thick

E6000 bonded to upper surface

Thin flat fin

Parameter | Value | Basis
VG type | Thin flat rectangular blade (Micro AeroDynamics style) | Same profile as aviation VGs. Vertical flat fin, 5° TE lean.
Position | 17%c = 20.4mm from LE, upper surface | Selig 1997 S1223 wind tunnel (CL,max 2.20→2.30)
Height h | 8.4mm (7%c) | 5-8%c range; h ≈ 3.5× BL thickness at Re 4,000-6,000
Chord-length | 8.4mm (7%c) | Matched to height — standard VG proportioning
Thickness | 0.5mm (LW-PLA, 2 perimeters) | Minimum for structural integrity at this height
Toe angle | 18° to freestream | Optimal 15-20° range; good vortex/drag balance
Lean | ~5° toward trailing edge | Mirrors aviation VG geometry; aids vortex attachment
TE profile | Gentle radius ~1mm, not sharp | Reduces drag vs sharp TE; matches full-scale VG shape
Pair gap | 7.2mm (6%c) fin-to-fin | Counter-rotating pair; common-flow-down configuration
Pair pitch | 24mm spanwise (20%c) | ~3× height; one pair per rib bay
Mounting strip | LW-PLA, 14mm chord × full span × 1mm base | Single print per wing; all 8 identical

MCO-1D WING DESIGN SPECIFICATION Rev E | RAKED WINGTIP · COVERT FLAP · GURNEY FLAP

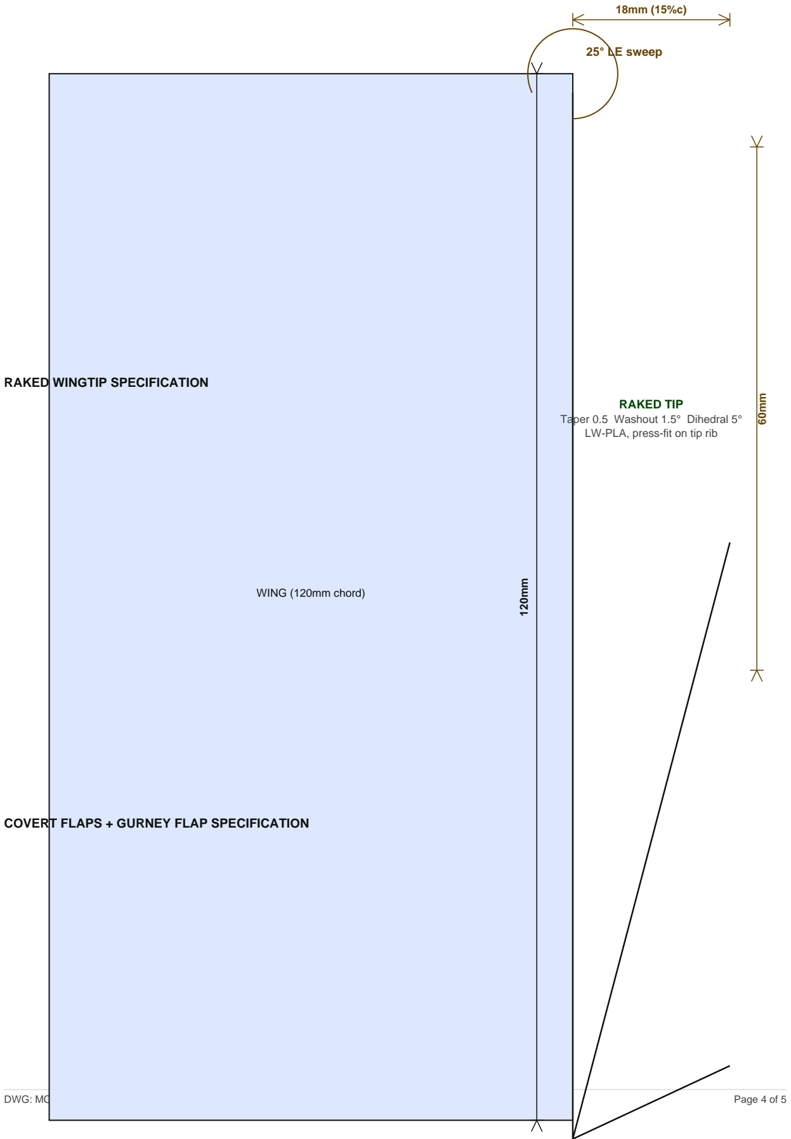
[picture p4: figure]
WING (120mm chord); 25° LE sweep; RAKED TIP Taper 0.5 Washout 1.5° Dihedral 5° LW-PLA, press-fit on tip rib; RAKED WINGTIP SPECIFICATION

DWG: MCO-1D-WING-001 Rev E | May 2026 | S1223 120mm chord | All design decisions consolidated | Page 4 of 5

## DIAGRAM 4 — RAKED WINGTIP PLANFORM AND CROSS-SECTION

### COVERT FLAPS + GURNEY FLAP SPECIFICATION

MCO-1D WING DESIGN SPECIFICATION Rev E | COMPLETE DESIGN SPECIFICATION SUMMARY
DWG: MCO-1D-WING-001 Rev E | May 2026 | S1223 120mm chord | All design decisions consolidated | Page 5 of 5

## MCO-1D WING — CONSOLIDATED SPECIFICATION (ALL CONFIRMED DECISIONS)
