wrbell/dad-ornithopter/docs/latest/README.md

# Pre-Consolidation Document Archive (`docs/latest/`)

> **NOTICE**: The files in this directory represent pre-consolidation engineering snapshots (Revisions v18–v25) generated during earlier development milestones.
>
> All project documentation has been consolidated and rewritten into a clean, unified, authoritative suite under **MCO-1D Mark 1**:
> 👉 **[docs/mark1/](../mark1/)**
>
> Please consult the Mark 1 documentation for all active airframe construction, 39-part BOM sourcing, commissioning, and flight operations.
