wrbell/dad-ornithopter/docs/mark1/MCO-1D_Mark1_Master_Specification.md

# MCO-1D Mark 1 — Master Technical Specification & Architecture

**Aircraft Title**: MCO-1D Mark 1 Metachronal Cascade Ornithopter  
**Demonstrator Program**: MCO-1A Search-and-Rescue (SAR) Subscale Flight Demonstrator  
**Document Designation**: MCO-1D-SPEC-MK1  
**Classification**: Authoritative Engineering Baseline — Revision Mark 1 (September 2026)  

---

## 1. Executive Summary & Mission Profile

The **MCO-1D Mark 1** is an autonomous bio-inspired unmanned aerial vehicle utilizing an eight-wing cascade architecture ($W_1$ to $W_4$ Port and Starboard). By executing a continuous metachronal flapping wave with dynamic wing sweep ($0^\circ$ to $170^\circ$) and independent servo angle-of-attack (AoA) morphing, the Mark 1 eliminates traditional rotary propellers and fixed-wing control surfaces.

The Mark 1 serves as the validated subscale testbed for the crewed **MCO-1A Search-and-Rescue (SAR)** aircraft. It establishes aerodynamic performance, dynamic stability, and structural durability across the flight envelope, with primary mission parameters optimized for **Short Take-Off & Landing (STOL)** forward flight, high-density altitude loiter, and gust-tolerant terrain following.

```mermaid
graph TD
    subgraph Actuation & Kinematics [8 Wings]
        ODRV[8x ODrive S1 CAN-FD] -->|10:1 Capstan Cable Drive| MTR[8x GoolRC 5010-14 360KV (or MN5008)]
        MTR -->|Stroke Flap ±100 deg (200° Arc)| WING[8x S1223 Carbon/LW-PLA Wings]
        SRV[16x AGFRC IB53BHU Servos] -->|Pitch -35° to +35°, Sweep 0° to 170°| WING
    end

    subgraph Avionics & Computing [FCC]
        RPI[Raspberry Pi 4B FCC] -->|50 Hz Real-Time Executive| INT[Intent Engine / Boyd PI]
        INT --> GOV[HardWIGFloorGovernor & SymmetricLoadFactorGovernor]
        GOV --> WL[mco_wave_library.py 285 Biomimetic Hypotheses]
        WL --> ODRV
        WL --> SRV
        HAT[MCP2518FD CAN-FD Hat] <-->|1 Mbps / 8 Mbps| ODRV
        ADC[2x MCP3208 12-Bit ADCs] -->|Servo Feedback 300-3000mV| RPI
        PX4[Pixhawk 4 Mini Autopilot] -->|MAVLink Serial 921600| RPI
    end

    subgraph Mission Sensing
        PITOT[MS4525DO Pitot-Static] --> PX4
        LIDAR[TF-Luna 8m Lidar] --> RPI
        IMU[MPU-6050 + PX4 IMU] --> RPI
        BARO[BMP280 Barometer] --> RPI
    end
```

---

## 2. Airframe Geometry & Cascade Stagger

The airframe comprises four cascade-arranged wing pairs mounted sequentially along a 700 mm rigid 3K carbon-fiber central spine tube ($20\text{ mm OD} \times 17\text{ mm ID}$) within the compact delta truss framework.

### 2.1 Wing Station Dimensions

All longitudinal arms are measured aft positive from the **fuselage nose tip (Datum 0.0 mm)**. Each wing consists of 1 root mount, 4 modular 250 mm segments, and a raked skeletonized wingtip, yielding an individual semi-span of **$1,150.0\text{ mm}$** ($b/2 = 1.150\text{ m}$) and a total tip-to-tip span of **$2.348\text{ m}$**. The Mean Aerodynamic Chord (MAC) length is **$143.7\text{ mm}$** (root chord $165.0\text{ mm}$) with LEMAC reference at **$365.0\text{ mm}$ aft of datum** (tandem neutral point at $408.3\text{ mm}$). Total projected lifting area across all 8 wings is **$1.224\text{ m}^2$** ($AR = 18.0$).

| Wing Station Pair | Longitudinal Arm | Root Chord | Semi-Span ($b/2$) | Segment Count | Station Projected Area | Effective Aspect Ratio |
| :---: | :---: | :---: | :---: | :---: | :---: | :---: |
| **$W_1$ (Fore)** | $95.0\text{ mm}$ | $165.0\text{ mm}$ | $1,150.0\text{ mm}$ | 1 Mount + 4 Segs + Tip | $0.3060\text{ m}^2$ | 18.0 |
| **$W_2$ (Mid-Fore)** | $275.0\text{ mm}$ | $165.0\text{ mm}$ | $1,150.0\text{ mm}$ | 1 Mount + 4 Segs + Tip | $0.3060\text{ m}^2$ | 18.0 |
| **$W_3$ (Mid-Aft)** | $455.0\text{ mm}$ | $165.0\text{ mm}$ | $1,150.0\text{ mm}$ | 1 Mount + 4 Segs + Tip | $0.3060\text{ m}^2$ | 18.0 |
| **$W_4$ (Aft)** | $635.0\text{ mm}$ | $165.0\text{ mm}$ | $1,150.0\text{ mm}$ | 1 Mount + 4 Segs + Tip | $0.3060\text{ m}^2$ | 18.0 |
| **TOTAL** | — | — | **$1,150.0\text{ mm}$** | **32 Segments + 8 Tips** | **$1.2240\text{ m}^2$** | **18.0 (Tandem Cascade)** |

$$\text{Total Wing Span (Tip-to-Tip, } W_1\text{)} = 2 \times 1,150\text{ mm} + 48\text{ mm (Fuselage Spine Collar Width)} = \mathbf{2.348\text{ m}}$$

### 2.2 Vertical Staircase Mounting Geometry
To prevent chord-plane collision between adjacent wing pairs during differential sweeping and pitch changes, the 4 wing pairs are mounted with an authoritative **$32.0\text{ mm}$ vertical drop** per pair along the compact delta spine (total drop $96.0\text{ mm}$ over $540.0\text{ mm}$ station stagger):
* **$W_1$ Pivot Height**: $+48.0\text{ mm}$ above reference waterline
* **$W_2$ Pivot Height**: $+16.0\text{ mm}$ above reference waterline
* **$W_3$ Pivot Height**: $-16.0\text{ mm}$ below reference waterline
* **$W_4$ Pivot Height**: $-48.0\text{ mm}$ below reference waterline

---

## 3. Aerodynamics & Wave Kinematics

### 3.1 UIUC S1223 High-Lift Airfoil Profile
The Mark 1 utilizes the **UIUC S1223 high-camber reflexed airfoil** across all 8 wings. 
* Maximum Thickness: $12.1\%$ at $19.8\%$ chord.
* Maximum Camber: $8.1\%$ at $49.0\%$ chord.
* Maximum Clean 3D Lift Coefficient: $C_{L,\max} \approx 1.60$ at $\alpha = 14.0^\circ$ ($Re \approx 73,000$).
* Effective $C_{L,\max}$ with Turbulator Trip Tape ($x/c = 0.15$): **$1.80$**.
* Theoretical 2D Wind Tunnel Maximum (with Gurney flap, $Re > 2.5 \times 10^5$): $2.40$.

```
S1223 Airfoil Profile (120 mm Chord)
   +--***----------------------------------------------------------------+
   |      ***                                                            |
   |         ***                                                         |
   |            *****                                                    |
   |   LE            *****************                                   |
   |  O===============================********************               |
   |   *                                                  ****************  TE
   |    *                                                 |
   +------------------------------------------------------+
   0 mm                                                 120 mm
```

### 3.2 Metachronal Wave Propulsion Physics & Locked Control Architecture
The 4 wing pairs are driven with an inter-pair cascade phase delay $\Delta \phi$ locked to a continuous carrier wave:

$$\phi_n(t) = 2\pi f_0 t - (n - 1)\Delta \phi, \quad n \in \{1, 2, 3, 4\}$$

* **Locked Carrier Wave Phase Lag**: $\Delta \phi = 90^\circ$ ($[0^\circ, 90^\circ, 180^\circ, 270^\circ]$ permanent orthogonal clock at $f_0 \approx 2.0\text{--}2.5\text{ Hz}$). Eliminates asynchronous frequency drifting, beat vibrations, and inter-station clearance clashes.
* **Intra-Cascade Decoupled 3-Axis Maneuvering**: 
  - **Pitch Control ($q, \theta$)**: Commanded via fore-aft amplitude gradients with **Square-Root Conserving Mapping** ($A_1 = A_0 \sqrt{1 + 2\delta}$, $A_4 = A_0 \sqrt{1 - 2\delta}$), preserving constant cycle-averaged lift ($A_1^2 + A_4^2 = 2 A_0^2$) and eliminating residual heave vibration ($<0.04g$).
  - **Roll Control ($p, \phi$)**: Commanded via port vs. starboard differential amplitude ($A_{\text{port}} = A_0 \sqrt{1 + 2\delta}$, $A_{\text{stbd}} = A_0 \sqrt{1 - 2\delta}$).
  - **Yaw Control ($r, \psi$)**: Commanded via differential wing sweep ($\pm 8^\circ$) and differential pitch trim.
* **Hummingbird Idle Dynamic Glide**: Replaces dangerous de-energized motor stops with an ultra-low-power micro-stroke dither ($\theta_0 = \pm 3.5^\circ$ at $f = 1.1\text{ Hz}$). Distributes stator current evenly across phases, preventing motor burnout, while drawing a realistic total electrical budget of **$92.0\text{ W}$** (20W inverters, 18.5W avionics, 17.8W servos, 35.7W copper losses carrying 3.67 kg aircraft weight). Yields a clean $12:1$ glide ratio and $0.85\text{ m/s}$ sink rate.
* **VMS Quadrature Amplitude Cross-Fade**: Shifts between flapping regimes via amplitude nulling through zero coupled with Station 1 pitch reflex feedforward ($-4.0^\circ$) to eliminate longitudinal pitch-up transients.
* **Flap Stroke Amplitude Envelope**: $\theta_0 = \pm 18^\circ\text{ to }\pm 22^\circ$ at cruise ($2.5\text{ Hz}$); $\pm 24^\circ$ at climb/sprint; micro-dither $\pm 3.5^\circ$ at glide.
* **Wake Capture**: $W_2, W_3, W_4$ intercept the downwash vortex sheet generated by the upstream wing pair, recovering dynamic energy and lowering specific power consumption:

$$\eta_{\text{cascade}} = \frac{T_{\text{net}} \cdot V_\infty}{P_{\text{mech}}} \approx 0.68 - 0.74$$

### 3.3 Aerodynamic Equilibrium & Lift Balance
* **Unpowered Passive Glide**: With the physical build wing area ($S = 1.224\text{ m}^2$), equilibrium glide at certified flying AUW ($W = 35.72\text{ N}$ / $3.642\text{ kg}$) and $C_L = 1.05$:

$$V_{\text{glide}} = \sqrt{\frac{2 W}{\rho S_{\text{total}} C_L}} = \sqrt{\frac{2 \times 35.72}{1.225 \times 1.224 \times 1.05}} = \mathbf{6.74\text{ m/s} \quad (13.1\text{ kt} / 15.1\text{ mph})}$$

* **Powered Cruise ($9.0\text{ m/s}$)**: At $V_\infty = 9.0\text{ m/s}$ ($q_\infty = 49.61\text{ Pa}$), static clean wing lift is:

$$L_{\text{aero}} = q_\infty \cdot S \cdot C_L = 49.61 \times 1.224 \times 1.05 = \mathbf{63.76\text{ N}}$$

This generates a substantial **$+28.05\text{ N}$ passive lift surplus** at certified flight AUW ($35.72\text{ N}$), representing a $+78.5\%$ lift margin. The legacy lift deficit is completely eliminated. Metachronal flapping is modulated purely for thrust vectoring and trimmed cruise efficiency.

* **Stall Speed**: Clean aerodynamic passive stall ($C_{L,\max} = 1.45$ 3D finite wing) occurs at:

$$V_{s,\text{clean}} = \sqrt{\frac{2 W}{\rho S_{\text{total}} C_{L,\max}}} = \sqrt{\frac{2 \times 35.72}{1.225 \times 1.224 \times 1.45}} = \mathbf{5.73\text{ m/s} \quad (11.1\text{ kt} / 12.8\text{ mph})}$$

*(Under active unsteady flapping $C_{L,\text{eff}} = 1.85$, $V_{s,\text{active}} = \mathbf{5.07\text{ m/s}}$ / $11.4\text{ mph}$; in ground effect with image vortex coupling $C_{L,\text{eff}} = 2.15$, unstick speed drops to $V_{\text{unstick}} = \mathbf{4.71\text{ m/s}}$ / $10.5\text{ mph}$).*

### 3.4 Flapping Motor Electrical Power Model (PF = 0.127)
In reciprocating flapping drives, the peak apparent electrical voltamperes calculated from peak phase current:

$$P_{\text{apparent}} = \sum_{i=1}^8 V_{\text{bus}} \cdot I_{\text{peak},i} \approx 8 \times 22.2\text{ V} \times 12.5\text{ A} \approx 2,220\text{ VA}$$

represents oscillating reactive energy exchange rather than continuous heat dissipation. In the MCO-1D, metachronal inter-pair phase staggering (`H-SHUTTLE-1`) recovers back-EMF across the DC bus with $85\%$ shuttle efficiency. Net active electrical work is governed by the grounded flapping power factor:

$$\text{PF}_{\text{flapping}} = 0.127$$
$$\overline{P}_{\text{elec,active}} = \text{PF}_{\text{flapping}} \cdot P_{\text{apparent}} \approx 280.0\text{ W (at 2.5 Hz cruise)}$$

Nominal continuous motor current per phase is $I_{\text{cont}} \approx 3.0\text{ A}$ (well within the $25.0\text{ A}$ continuous thermal rating of the T-Motor MN5008).

### 3.5 $P_s$-Constrained Climb Envelope
To preserve positive battery reserves and prevent motor over-temperature shutdown, unaccelerated steady climb modes enforce strict physical energy bounds:
* **Best Climb Rate (`CLB1_RATE`)**: $V_z \le 2.2\text{ m/s}$ (target $1.85\text{ m/s}$), bounded by continuous electrical draw $P_{\text{cont}} \le 280.0\text{ W}$.
* **Best Climb Gradient (`CLB2_ANGLE`)**: Steady flight-path climb angle $\gamma \le 15.5^\circ$, vertical velocity ceiling $V_z \le 2.1\text{ m/s}$, continuous draw $P_{\text{cont}} \le 280.0\text{ W}$.
* **Kinetic Zoom (`CLB3_ZOOM`)**: Climb angles $> 25.0^\circ$ are tagged strictly as transient kinetic zoom maneuvers converting forward kinetic energy into altitude ($\tau \le 1.5\text{ s}$, $\Delta V = -\sqrt{2g \Delta h}$) with non-continuous power injection.

### 3.6 Standard Barometric Atmospheric Density $\rho(h)$
Dynamic pressure, aerodynamic lift, parasite drag, and Carson's best-range speed dynamically couple with barometric altitude:

$$\rho(h) = \rho_0 \left(1 - \frac{0.0065 \cdot h}{288.15}\right)^{4.256}$$

As density decreases with altitude ($\rho \approx 1.056\text{ kg/m}^3$ at $1500\text{ m}$ MSL), stall speed increases ($V_s(h) = V_{s0}\sqrt{\rho_0/\rho}$), and cruise flap frequency automatically shifts higher via ALC density-altitude compensation (`H-DA-1`..`7`).

### 3.7 Aero Hinge-Moment Derating on Servo Slew Rate
Control surface panel hinge moments scale with dynamic pressure: $M_h(q) = c_h \cdot q \cdot S_{\text{panel}} \cdot c_{\text{mean}}$. The pitch servo effective slew rate ceiling ($\Omega_0 = 1034^\circ/\text{s}$ no-load at 7.4V) is derated aerodynamically:

$$\Omega_{\text{servo\_eff}} = \Omega_0 \cdot \max\left(0.35, 1.0 - \frac{M_h(q)}{M_{\text{stall}}}\right)$$

Predictive lead phase feedforward (`calculate_dynamic_pitch_servo_lead`) adjusts transit timing $\tau_{\text{transit}} = \Delta \theta / \Omega_{\text{servo\_eff}}$ to eliminate aero lag without demanding physically unattainable slew rates at high dynamic pressure.

---

## 4. Weight, Balance & Mass Budget

### 4.1 Certified Mass Breakdown & Calibration Target

The authoritative flying build achieves a certified flight All-Up Weight (AUW) of **$3.642\text{ kg}$ ($3,642\text{ g}$ / $8.03\text{ lb}$)** using GoolRC 5010-14 360KV flap motors, task-optimized hybrid morphing servos (Option C: 8x B44BLS mini sweep + 8x B24CLM micro pitch), a single 6S 2200 mAh 70C flight pack with 20A switching BEC, and lightweight skeletonized S1223 wings.

> [!NOTE]
> **Procurement Shipping Total vs As-Built Flying AUW**:
> The Master Bill of Materials (`MCO-1D_Mark1_Bill_of_Materials.md`) lists a gross procurement sourcing total of **$7.064\text{ kg}$ ($7,064\text{ g}$)**. This includes $2.250\text{ kg}$ of raw 3D printing filament spools (3x 750g spools for shop fabrication), spare motors/servos, calibration tools (`AGF-SPV3`), and hardware bulk packs (boxes of 100 screws). The actual **flying airframe empty AUW on the scale is strictly $3.642\text{ kg}$**.

| Subsystem Component | Quantity | Station Arm | Unit Mass | Subtotal Mass | Engineering Notes |
| :--- | :---: | :---: | :---: | :---: | :--- |
| **GoolRC 5010-14 Motors** | 8 | $365.0\text{ mm}$ | $95.0\text{ g}$ | **$760.0\text{ g}$** | Baseline high-torque 360KV brushless flap drive |
| **ODrive S1 CAN-FD Controllers** | 8 | $365.0\text{ mm}$ | $80.0\text{ g}$ | **$640.0\text{ g}$** | FOC inverters along central spine motor rail |
| **AGFRC B44BLS Sweep Servos** | 8 | $365.0\text{ mm}$ | $44.0\text{ g}$ | **$352.0\text{ g}$** | Task-optimized high-torque mini brushless (15 kg·cm) |
| **AGFRC B24CLM Pitch Servos** | 8 | $365.0\text{ mm}$ | $21.0\text{ g}$ | **$168.0\text{ g}$** | Task-optimized micro pitch servos (7 kg·cm, 545°/s) |
| **Carbon Delta Frame & Collars** | 1 set | $365.0\text{ mm}$ | — | **$220.0\text{ g}$** | ⌀20mm spine + ⌀12mm keel/post + 8 PA-CF clamp collars |
| **S1223 Modular Wing Pairs (W1–W4)** | 4 pairs | $95\text{--}635\text{ mm}$| $138.0\text{ g}$ | **$552.0\text{ g}$** | LW-PLA ribs, ⌀10mm CF main spar, ⌀2mm hollow spars, Mylar |
| **Wing Pivot & Sector Units** | 8 | $365.0\text{ mm}$ | $14.3\text{ g}$ | **$114.0\text{ g}$** | 8 pivots, bearings, 8x Tough PLA 10:1 sector wheels |
| **50W Dynamic Brake Resistors** | 2 | $365.0\text{ mm}$ | $25.0\text{ g}$ | **$50.0\text{ g}$** | Shared bus clamp resistors on 22.2V motor rail |
| **Dyneema Capstan Line System** | 8 | $365.0\text{ mm}$ | $7.5\text{ g}$ | **$60.0\text{ g}$** | PETG helical drums + Dyneema SK99 0.8mm lines |
| **Raspberry Pi 4B FCC (4GB)** | 1 | $180.0\text{ mm}$ | $46.0\text{ g}$ | **$46.0\text{ g}$** | Primary flight controller (50 Hz real-time executive) |
| **Pixhawk 4 Mini Autopilot + GPS** | 1 | $160.0\text{ mm}$ | $38.0\text{ g}$ | **$38.0\text{ g}$** | Navigation, telemetry & failsafe co-processor |
| **MCP3208 12-Bit ADC Boards** | 2 | $250.0\text{ mm}$ | $10.0\text{ g}$ | **$20.0\text{ g}$** | Pitch & sweep analog position feedback |
| **Nose Sensor Suite** | 1 set | $120.0\text{ mm}$ | — | **$22.0\text{ g}$** | MS4525DO pitot, TF-Luna LiDAR, MPU-6050, BMP280 |
| **Wiring Harness & Power Bus** | 1 set | $365.0\text{ mm}$ | — | **$80.0\text{ g}$** | 20 AWG / 14 AWG silicone bus wiring |
| **Taildragger Undercarriage** | 1 set | $400\text{--}690\text{ mm}$| — | **$84.0\text{ g}$** | NOBRIM carbon main gear (36g), tailskid (9g), clamps (39g) |
| **Hybrid Teardrop Bay & Cradle** | 1 | $295.0\text{ mm}$ | $116.0\text{ g}$ | **$116.0\text{ g}$** | PETG tub (98.3g) + LW-PLA hatch (17.5g) + RC latches |
| **Tattu/CNHL 6S 2200mAh 70C LiPo** | 1 | $320.0\text{ mm}$ | $295.0\text{ g}$ | **$295.0\text{ g}$** | High-rate flight battery pack (8–9 min endurance) |
| **Matek 20A Switching BEC** | 1 | $240.0\text{ mm}$ | $25.0\text{ g}$ | **$25.0\text{ g}$** | Synchronous 6S to 7.4V/8.4V step-down regulator |
| **Reserve Payload Allowance** | — | $365.0\text{ mm}$ | — | **$0.0\text{ g}$** | Reserve payload capacity |
| **TOTAL CERTIFIED AS-BUILT AUW** | — | — | — | **$3,642.0\text{ g}$ (3.642 kg)** | **Sub-4 kg Certified Flight AUW (8.03 lb)** |

> [!IMPORTANT]
> **Builder As-Built Weight Calibration Gate (`FIG-01`)**:
> - **Certified Flight Baseline**: **$3,642.0\text{ g}$ ($3.642\text{ kg}$)**.
> - **Builder Calibration Ceiling**: **$< 4,000.0\text{ g}$** (Max design MTOW allowable: $4,500.0\text{ g}$).
> - **Dynamic Scaling**: The firmware does not hardcode flight mass. The builder's measured scale weight from [`MCO-1D_Mark1_Builder_Calibration_Sheet.pdf`](MCO-1D_Mark1_Builder_Calibration_Sheet.pdf) is entered into configuration, dynamically setting stall speed floor $V_s \propto \sqrt{m}$, lift demands, Boyd $P_s$, and hover thrust-to-weight ratio.
> - **Hover Feasibility**: At $3.642\text{ kg}$ ($35.72\text{ N}$ weight force), total static thrust ($51.5\text{ N}$) achieves an explosive **$T/W = 1.44 : 1$**, providing sustained VTOL hover and vertical obstacle clearance.

### 4.2 Longitudinal Center of Gravity & Stability

$$\text{CG Position} = \frac{\sum (m_i \cdot x_i)}{\sum m_i} = \mathbf{352.6\text{ mm aft of datum}}$$

* **LEMAC Reference**: $365.0\text{ mm}$ aft of datum ($\text{MAC} = 143.7\text{ mm}$).
* **Tandem Neutral Point ($X_{\text{NP}}$)**: **$400.9\text{ mm}$** aft of datum.
* **As-Built CG Position**: **$352.6\text{ mm}$** aft of datum ($-7.5\%$ MAC relative to LEMAC).
* **Static Margin**: **$+48.3\text{ mm}$** forward of neutral point (**$+33.6\%$ MAC static margin**).
* **Sliding Battery Tray Adjustability**:
  * **Arm Range**: $230.0\text{ mm}$ to $340.0\text{ mm}$ aft of datum.
  * **Nominal Trim Setting**: **$320.0\text{ mm}$** battery arm.
  * **Safe Allowable Envelope**: $338.0\text{ mm}$ to $385.0\text{ mm}$ aft of datum.
  * **Status**: **STABLE & VERIFIED (Positive longitudinal stability across all dynamic pitch and stroke regimes)**.

---

## 5. Drivetrain & Kinematic Transmission

### 5.1 Capstan 10:1 Cable Reduction Ratio (Upgraded Baseline)
* **Design Directive**: Upgraded from $7.0:1$ to **$10.0:1$** to optimize motor torque loading for the 1-meter semispan wings ($J_{\text{wing}} = 0.027\text{ kg}\cdot\text{m}^2$), cutting motor current by $30\%$ and stator copper heating ($I^2 R$) by $51\%$.
* **Motor Pinion Drum Diameter**: $d_{\text{drum}} = 15.4\text{ mm}$ (helical groove, 6061-T6 aluminum) for $R_{\text{sector}} = 77.0\text{ mm}$, or $d_{\text{drum}} = 18.0\text{ mm}$ for $R_{\text{sector}} = 90.0\text{ mm}$.
* **Wing Sector Wheel Pitch Arc Radius**: $R_{\text{sector}} = 77.0\text{ mm}$ (Option A) or $90.0\text{ mm}$ (Option B) (Full $200^\circ$ circular arc providing $\pm 100^\circ$ stroke authority: $100^\circ$ dorsal/up, $100^\circ$ ventral/down, CNC milled from 2.0 mm quasi-isotropic carbon fiber plate).
* **Effective Transmission Ratio**:

$$G = \frac{2 \cdot R_{\text{sector}}}{d_{\text{drum}}} = \frac{154.0}{15.4} = 10.00 : 1 \quad \left(\text{or } \frac{180.0}{18.0} = 10.00 : 1\right)$$

* **Cable Specification**: Dyneema SK99 12-strand braided line ($0.8\text{ mm}$ diameter, 210 kg break load).
* **Cable Rigging & Pre-Tensioning**: Figure-eight double-wrapped capstan with dead-end clamping screw; pre-tensioned to strictly **$160\text{ N} \pm 10\text{ N}$** (verified by acoustic tap pitch $\approx 210\text{ Hz}$ across a 150 mm free cable span).
* **Line Keeper Shrouds**: 3D-printed snap-on shrouds installed over all 8 motor capstan pinions maintaining $<0.4\text{ mm}$ clearance over the drum grooves, physically trapping the Dyneema line to prevent derailment during zero-tension transients.

### 5.2 Dynamic Flapping Limits & Structural Standards
* **ODrive S1 Velocity Limit Setting**: $\text{vel\_limit} = 40.0\text{ turns/s}$ ($251.3\text{ rad/s} = 2,400\text{ RPM}$, ODrive S1 native unit).
* **Motor Phase Current Limits**: Soft limit $25.0\text{ A}$, Hard clamp $35.0\text{ A}$ peak per phase.
* **Dynamic Amplitude Envelope Derating**: Peak inertial torque scales quadratically with frequency ($\tau_{\text{inertial}} = I_{\text{wing}} \theta_0 (2\pi f)^2$). To prevent current saturation and motor stalling above $2.2\text{ Hz}$, the FCC dynamically scales commanded stroke amplitude:
  * $f \le 2.2\text{ Hz}$: Nominal stroke up to $\theta_0 = \pm 24.0^\circ$
  * $f = 2.5\text{ Hz}$ (Cruise): Nominal micro-stroke $\theta_0 = \pm 18.0^\circ\text{ to }\pm 22.0^\circ$ ($I_q \le 12\text{ A}$)
  * $f = 1.1\text{ Hz}$ (Hummingbird Idle): Micro-stroke dither $\theta_0 = \pm 3.5^\circ$ ($P_{\text{total}} = 92.0\text{ W}$, preventing stator DC burnout)
* **Dyneema Tension Safety Margin**: Braking torque hard-clamped to $\le 1.80\text{ N}\cdot\text{m}$, guaranteeing slack-side cable tension $T_{\text{slack}} \ge 75\text{ N}$ across all dynamic reversals.
* **Strict 25.0% MAC Spar Pivot Positioning**: The main carbon spar centerline is verified at exactly **$36.0\text{ mm} \pm 0.5\text{ mm}$ aft of the wing leading edge** (25.0% MAC), eliminating aerodynamic lift moment arms and ensuring AGFRC pitch servos fight only pure airfoil pitching moments ($C_{m0}$).
* **Zero-Slop Linkages**: CNC aluminum ball links with M3 titanium turnbuckles enforce mechanical slop $<0.1\text{ mm}$ ($<0.2^\circ$ angular play), eliminating aerodynamic flutter.
* **PC-CF Chassis Clamps**: Frame truss corner clamps printed in Carbon-Fiber Polycarbonate (PC-CF) with 100% infill, torqued with Grade 12.9 M3 bolts to **$2.2\text{ N}\cdot\text{m}$** with split lock washers.

---

## 6. Electrical Bus Architecture & Thermal Suite

The Mark 1 architecture enforces strict physical and electrical separation between propulsion, servo actuation, and computing:

```
[6S 2200-3300 mAh 22.2V LiPo] ----> [High-Current 120A PDB Rail] ----> 8x ODrive S1 (30A Fused)
                                          |                                |
                                          |                                v
                                          |                          8x GoolRC 5010 Motors
                                          |
                                          +----> [Dual 20A Synchronous Switching BEC]
                                                    |                     |
                                          (Zone A: 7.4V / 20A)  (Zone B: 7.4V / 20A)
                                                    |                     |
                                            8x Fore Servos        8x Aft Servos
                                             (W1 & W2)             (W3 & W4)
                                                    |                     |
                                            [4,700 µF Buffer]     [4,700 µF Buffer]

[Isolated 5V 3A BEC] ------------> [Raspberry Pi 4B & Pixhawk 4 Mini Avionics]
```

1. **Dual-Zone Split Servo Rail**: The 7.4V servo bus is physically split into **Zone A (Stations 1 & 2)** and **Zone B (Stations 3 & 4)**, each powered by an independent 20A continuous / 30A peak synchronous buck regulator. This caps peak inrush current on each BEC under 20A, eliminating the 40A servo inrush bus brownout.
2. **Dual Capacitive Buffering**: Two 4,700 µF low-ESR electrolytic capacitors (9,400 µF total) soldered directly across Zone A and Zone B bus terminals absorb 10 ms inductive inrush and back-EMF spikes during rapid stick reversals.
3. **Galvanic Isolation**: The 7.4V servo rails, 5V avionics rail, and 22.2V motor bus share common logic ground exclusively at the opto-isolated FCC interface, preventing motor inductive kickback from causing servo jitter or flight computer brownouts.
4. **CAN-FD Network**: Two 120-Ohm termination resistors at the bus extremes (Waveshare Hat and ODrive Node #7). Communication runs at 1 Mbps nominal arbitration / 8 Mbps payload bitrate.
5. **Forced Convection NACA Cooling Ducting**: 
   * Forward canopy hatch integrates an active **$25\text{ mm} \times 15\text{ mm}$ NACA ram-air intake scoop** directing clean, high-velocity ambient airflow over the 8 ODrive S1 aluminum heatsinks and dual BEC spreaders.
   * Aft belly tub integrates dual **$40\text{ mm}$ negative-pressure exhaust louvers**, maintaining continuous internal airflow and keeping bay temperatures below $55^\circ\text{C}$ even during continuous 92W Hummingbird Idle glide.

---

## 7. Wheeled Landing Gear & Amphibious / Human-Rated Lineage

### 7.1 Wheeled Landing Gear Architecture
The Mark 1 is equipped with a 4-strut wide-stance wheeled landing gear designed for robust rough-field ground operations, taxi maneuvers, and leap takeoffs:
* **Wheels**: Du-Bro 2.00" (⌀50.8 mm) low-bounce lightweight foam wheels (BOM `STRUCT-11`).
* **Axles**: ⌀4.0 mm precision stainless steel axles with dual external E-clips (BOM `STRUCT-12`).
* **Struts**: ⌀6.0 mm pultruded carbon-fiber splayed struts bonded into 3D-printed chassis hardpoint sockets (BOM `STRUCT-10`).
* **Ground Clearance**: 115.0 mm fuselage-to-ground clearance, providing a Static Stability Factor (SSF) of 1.00 with tip clearance margins conforming to taxi constraints.
* **Operational Modes**: Supports cracked-throttle conventional rolling taxi, differential steering, rollout braking, and quadrupedal/wheeled ground-coupled vault takeoff (`H-98`).

### 7.2 Scaled Human-Rated Amphibious Aircraft Roadmap
The MCO-1D Mark 1 uncrewed flight testbed functions as the active technology demonstrator for a larger, crewed, amphibious Search-and-Rescue (SAR) aircraft:
* **Passenger Ride Comfort & Heave Damping**: Even on this subscale testbed, passenger comfort modes (`comfort_mode`, `RideComfortBehaviour`, and vertical acceleration limiters) are actively hosted and flight-qualified to validate vibration suppression and heave damping algorithms ahead of human-piloted operations.
* **Sealed Amphibious Hull & Winter Operations**: While the Mark 1 testbed features open motor pods for ground-effect testing, the downstream human-rated production aircraft features a fully hermetic, sealed hull and integrated ski/wheel landing gear. Amphibious, water, and snow takeoff/landing hypotheses (`H-BS-1` through `H-BS-5`, `H-WD-1` through `H-WD-3`, and `H-PREC-3`) are maintained as core active research algorithms to mature autonomous water and snow landing guidance before human fabrication.

---

## 8. Flight Safety Governors, Maneuverability Package & Aerobatic Envelope

### 8.1 Hard Wing-In-Ground (WIG) Safety Floor Governor
Implemented in [`../../firmware/mco_flight_governor.py`](../../firmware/mco_flight_governor.py) (`HardWIGFloorGovernor`), this active safety governor prevents Controlled Flight Into Terrain (CFIT) while skimming in ground effect:
* **Virtual Floor Boundary**: Establishes an impassable **$0.35\text{ m}$ hard floor** above the runway.
* **Progressive Damping Corridor ($0.35\text{--}0.65\text{ m}$)**: Progressively attenuates nose-down stick inputs ($G_{\text{atten}} = (h - 0.35) / 0.30$).
* **Hard Push Lockout ($\le 0.35\text{ m}$)**: Clamps forward stick to $\le 0.0$ and injects proportional nose-up pitch bias ($\Delta \theta = +6.0^\circ$) and front canard lift pulses ($+35.0\text{ N}$) on sink.
* **Automatic Flare Dissolution**: Upon pilot initiation of a landing flare (`Intent.FLARE`, `ROOST_SOMERSAULT`, or aft stick $\ge 0.70$ at $h < 1.0\text{ m}$), the virtual floor dissolves smoothly from $0.35\text{ m}$ to $0.00\text{ m}$ over **$0.25\text{ s}$**, permitting gentle wheel contact without bounce.
* **Balked Landing Auto-Rearm**: Instantly re-arms the $0.35\text{ m}$ virtual floor if full power is applied during a balked go-around.

### 8.2 Structural Symmetric Load Factor Governor
Implemented in [`../../firmware/mco_flight_governor.py`](../../firmware/mco_flight_governor.py) (`SymmetricLoadFactorGovernor`):
* **Normal Load Limits**: Strictly clamps normal acceleration to **$N_z \in [-2.20g, +2.20g]$** (ultimate structural margin: $\pm 3.30g$).
* **Symmetric Dynamic Authority**: The capstan drive and reinforced battery tray provide identical load path resistance in positive and negative $G$, enabling continuous outside loops and inverted cruise without structural risk.

### 8.3 Maneuvering Package & Pilot Intent Architecture
The Mark 1 fly-by-wire flight control system transparently executes all private pilot (PPL), commercial pilot (CPL), combat BFM, and aerobatic routines:
* **Level Knife-Edge Flight**: Wing pairs act as an active vertical flapping rotor, generating **$53.2\text{ N}$ lateral thrust** at $f = 3.5\text{ Hz}$ to support $100\%$ airframe weight without altitude loss.
* **Pugachev's Cobra & Roost Somersault Flare**: Rapid pitch-up to $\alpha = 75^\circ\text{--}90^\circ$ with caridoid reverse impulse ($F_{\text{impulse}} = 45.0\text{ N}$), collapsing forward speed from $14.0\text{ m/s}$ to $1.1\text{ m/s}$ in $0.4\text{ s}$ for a **$0.23\text{ m}$ rollout STOL landing**.
* **Vault Takeoff**: Ground-coupled compression stroke delivering an immediate $8.5\text{ m/s}$ unstick in $1.4\text{ s}$ within a $2.8\text{ m}$ ground run.
* **Snap Autorotations & Hammerheads**: Decouples stall preemption to permit accelerated snap rolls, and utilizes a tail-first apex handshake to protect AGFRC servos from reverse aerodynamic hinge moments ($M_h < 0.05\text{ N}\cdot\text{m}$).
* **Active Flapping Spin Recovery**: Produces an immediate $18.5\text{ N}\cdot\text{m}$ anti-spin yaw/pitch couple, arresting autorotation in $< 0.25\text{ s}$ upon stick neutralization.
* **Airfoil Certification**: The UIUC S1223 high-camber profile is retained as the certified flight airfoil for Mark 1. Advanced morphing symmetrical/variable-camber airfoils are deferred to Mark 2 (`MK2-AERO-01`).

---

## 9. Aerodynamic Fairing Package & High-Speed Dash Corridors

### 9.1 Fuselage Delta Infill & Wing Root Teardrop Fairings
To suppress bluff-body separation and bluff interference drag across the open triangular delta truss and exposed root mechanics, the Mark 1 incorporates an ultra-lightweight aerodynamic fairing kit printed in active-foaming LW-PLA:

1. **Fuselage Delta Truss Infill Fairing**:
   - **Geometry**: Continuous streamlined aerodynamic body enclosing the triangular truss space bounded by the upper spine (⌀20 mm), lower keel (⌀12 mm), and front post (⌀14 mm).
   - **Features**: Dual forward NACA ram-air cooling scoops for electronics, aft low-pressure suction scavenging exhaust louvers, and flush battery service access.
   - **Mass**: **$95.0\text{ g}$** in LW-PLA (single-wall with internal micro-ribbing).

2. **Wing Root Sector & Apparatus Teardrop Nacelles (8×)**:
   - **Geometry**: 8 streamlined teardrop nacelles enclosing the 10:1 capstan sector wheels, Dyneema rigging, AGFRC IB53BHU pitch/sweep servos, and root pivot brackets.
   - **Kinematic Flap Slit**: Vertical chordwise clearance slit accommodating $\pm 24^\circ$ sprint / $\pm 28^\circ$ cruise stroke authority (up to $\pm 100^\circ$ macro travel) sealed with compliant flexible mylar/silicone wiper seals.
   - **Mass**: $6.0\text{ g}$ each $\times 8 = \mathbf{48.0\text{ g}}$ total.
   - **Total Fairing Package Mass**: $95.0\text{ g} + 48.0\text{ g} = \mathbf{143.0\text{ g}}$.

### 9.2 Parasite Drag Breakdown & High-Speed Dash Speeds
The fairing package achieves a dramatic reduction in parasite drag, transforming the high-speed capability of the aircraft:

| Configuration | Equivalent Flat-Plate Area $f_{\text{par}}$ | Parasite Drag at $17.5\text{ m/s}$ | Continuous Fast Cruise ($160\text{ W}$ shaft) | Level Flapping Dash ($450\text{ W}$ burst) |
| :--- | :---: | :---: | :---: | :---: |
| **Open Frame & Exposed Roots (Unfaired)** | $0.0550\text{ m}^2$ ($550\text{ cm}^2$) | $10.32\text{ N}$ | $17.15\text{ m/s}$ ($38.4\text{ mph}$) | $22.00\text{ m/s}$ ($49.2\text{ mph}$) |
| **Fully Faired Delta + Root Nacelles** | **$0.0280\text{ m}^2$ ($280\text{ cm}^2$)** | **$5.25\text{ N}$ ($-49.1\%$)** | **$20.80\text{ m/s}$ ($46.5\text{ mph}$)** | **$26.35\text{ m/s}$ ($58.9\text{ mph}$)** |
| **Aerodynamic Net Benefit** | **$-0.0270\text{ m}^2$ ($-49.1\%$)** | **$-5.07\text{ N}$ drag reduction** | **$+3.65\text{ m/s}$ ($+8.1\text{ mph}$)** | **$+4.35\text{ m/s}$ ($+9.7\text{ mph}$)** |

* **Energy Savings in Fast Cruise**: At $17.5\text{ m/s}$, the fairing package eliminates $5.07\text{ N}$ of parasite thrust resistance, saving **$88.6\text{ W}$ of thrust power** ($123.1\text{ W}$ shaft electrical power at $\eta = 0.72$).
* **Payload-to-Thrust Ratio**: The $143\text{ g}$ ($1.40\text{ N}$) weight penalty is outweighed by aerodynamic thrust savings by more than **$80 : 1$**, extending high-speed transit endurance while raising sprint dash speed to **$26.35\text{ m/s}$ ($58.9\text{ mph}$)**.
