wrbell/dad-ornithopter/docs/archive/MCO_1D_Technical_Handover.docx

MCO-1D METACHRONAL CASCADE ORNITHOPTER

DRONE PROTOTYPE

COMPLETE TECHNICAL HANDOVER DOCUMENT

Requirements • Design Decisions • Algorithms • Formulae • Constraints

Wave Library: Rev-H-A-B-C-D-E-F-G-H-I-J-K-L-M-N-O2-O3

Document Date: 2026-06-11

Classification: Engineering Design Record

# 1. Programme Identity and Mission

## 1.1 Project Overview

The Metachronal Cascade Ornithopter (MCO) is a research programme producing a small unmanned ornithopter drone prototype (MCO-1D) intended as a technology demonstrator and aerodynamic testbed for a full-scale piloted Search-and-Rescue aircraft (MCO-1A).

MCO = Metachronal Cascade Ornithopter. The name describes the core mechanism: four pairs of wings arranged in a cascade (fore-to-aft) each executing a metachronal stroke — a sequential timing offset between adjacent pairs, identical in principle to the limb coordination of swimming crustaceans and flying insects.

## 1.2 Programme Objectives

- Demonstrate sustained forward flight at cruise speed 9 m/s minimum.
- Demonstrate metachronal cascade flapping as a viable multi-wing propulsion scheme.
- Validate the intent-based flight control architecture before scaling to MCO-1A.
- Achieve mountain and wilderness SAR mission capability in the full-scale variant.
- No hover requirement. Forward flight only, no vertical take-off.

## 1.3 Vehicle Specifications

Parameter | Value / Specification
Designation | MCO-1D (drone prototype)
MTOW | 3.448 kg
Stall Speed Vs | 9.42 kt = 4.848 m/s
Design Cruise Speed | 9.0 m/s (17.5 kt)
Sprint Speed | 14 m/s (27 kt)
Vne (structural limit) | 28 m/s (54 kt)
Total Wing Area S | 0.979 m² (4 pairs, both sides)
Number of Wing Pairs | 4 (W1 forward → W4 aft)
Chord (all pairs) | 165 mm (constant)
Airfoil Section | UIUC S1223 (Selig, Re=200,000)
CL_max | 2.40 (S1223 + VGs at 17%c + Gurney flap 1%c)
Aspect Ratio (effective) | ≈4.5 at 90° sweep
Oswald efficiency e | 0.78 (estimated)
Flap stroke amplitude | ±80° (full stroke = 160°)
Max flap frequency | 3.0 Hz (motor + 7:1 rope drive limit)
Sweep range | 0° (forward) to 210° (stowed)
Longitudinal stagger W1–W2–W3–W4 | 138 mm between adjacent roots

## 1.4 Wing Semi-Spans and Areas

Wing Pair | Semi-span (m) | Pair Area (m²)
W1 (foremost) | 0.772 | 0.2548
W2 | 0.749 | 0.2472
W3 | 0.735 | 0.2426
W4 (rearmost) | 0.712 | 0.2350
Total | — | 0.9796 ≈ 0.979 m²

# 2. Drivetrain and Hardware

## 2.1 Propulsion System

Component | Specification
Flap motor (×8) | GoolRC 5010 360 KV brushless, one per wing
Motor controller (×8) | ODrive Micro (CAN-FD bus)
Gear ratio | 7:1 rope drive (motor to wing root)
Drive medium | Dyneema rope over aluminium pulleys
Sweep servo (×8) | DS3225 MG, 25 kg·cm (2.45 N·m) at 6 V, 270° range
Pitch servo (×8) | Emax ES08MD II metal gear, ±90° range
Pitch servo board | PCA9685 PWM, I²C
Flight computer | Raspberry Pi Zero 2W (mission logic, 50 Hz)
Autopilot / IMU | Pixhawk 6C Mini + M9N GPS + ASPD-4525 airspeed
Rangefinder | TFMini-S (TF-Luna) for AGL altitude
Telemetry | SiK 915 MHz radio
RC link | ELRS (ExpressLRS) 900 MHz
Battery | 6S LiPo 5000 mAh (~540 g, largest single mass item)
Control bus | CAN-FD (ODrive) + I²C (servos) + UART (Pixhawk)

## 2.2 DS3225 Sweep Servo — Engineering Verification

Sweep drag torque at sprint (V = 14 m/s, all-aft sweep 90°):

F_drag = CD × q × S_wing = 0.04 × 120.1 × 0.127 = 0.610 N

τ_sweep = F_drag × semi × 0.4 = 0.610 × 0.772 × 0.4 = 0.188 N·m (W1)

DS3225 rated: 2.45 N·m → Safety factor = 2.45 / 0.188 = 13× (corrected field: 9.5× at peak)

Servo torque loads are from DRAG only (not lift). Lift creates bending moments on the spar, not sweep torques. At forward sweep the drag moment is RESTORING (tries to sweep the wing aft) — easier to hold than aft sweep positions.

# 3. Wing Structure

## 3.1 Structural Specification (locked Rev H)

Element | Specification
Airfoil | UIUC S1223 (high-camber, high-lift, Re=200k)
Chord | 165 mm (all pairs)
Vortex generators (VGs) | At 17%c, increase CL_max from ~1.8 to 2.40
Gurney flap | 1% chord (1.65 mm), at trailing edge
Raked tip | Applied to all pairs
Primary structure | D-box, CF skin LE to 65%c
D-box skin | 100 gsm 2×2 twill CF, 0.1 mm thickness
D-box depth | 20 mm at max thickness (20%c)
Spars (3 per wing) | A: 20%c, B: 10%c, C: 55%c — all 2.0 mm OD / 1.0 mm ID CF tube
Spar material | Pultruded CF, 600 MPa flexural strength (conservative)
Spar cross-section | Round (isotropic — same stiffness in all directions)
Rear membrane | Ripstop from 65%c to 100%c
Ribs | LW-PLA, ~20 mm spacing, 3 mm root rib

## 3.2 Structural Safety Factors

Load case | Safety factor
D-box bending at cruise (1g) | 121×
D-box bending at 3.8g (utility category) | 32×
D-box torsion at cruise | 147×
Torsional divergence speed V_div | 128.9 m/s (4.6 × Vne = 28 m/s)
Sweep servo torque at sprint | 9.5× (0.257 N·m demand vs 2.45 N·m cap)

The torsional divergence analysis confirms that the X-29 forward-swept-wing divergence problem does NOT apply to the MCO. Divergence requires a fixed wing root that resists torsional twist. MCO wings pivot freely — the servo holds the sweep angle; there is no fixed root to create the wash-in feedback loop.

## 3.3 Forward Sweep Structural Note

At 0° sweep the wing chord points forward. The round CF spar is isotropic, so structural loading in any direction produces the same bending stiffness. The D-box is symmetric about the chord axis. Forward sweep produces no new structural risk beyond normal flight loads.

X-29 advantages that DO apply to the MCO at forward sweep:

- Root-first stall: spanwise flow inward → root stalls before tip → pitch servos (at tips) remain effective in post-stall regime.
- X-29 demonstrated control to 67° AoA using this mechanism. MCO pitch limit extended to 14° (vs normal 12°) when forward sweep active.
- Static instability at forward sweep → faster pitch response. FCC at 50 Hz handles the corrective loop (X-29 needed 40 corrections/s).

# 4. Physical Envelope — Hard Limits

ALL limits are enforced unconditionally by enforce_physical_limits() inside ControlState.update(), which executes as the final step every 50 Hz loop. No behaviour, function, CG compensator, or external command can produce servo outputs outside these values.

Parameter | Limit and Basis
Flap frequency | 0.0 – 3.0 Hz (ODrive + rope drive hard ceiling)
Wing sweep | 0° – 210° (DS3225 mechanical stops, 0° = full fwd, 210° = stowed)
Wing dihedral | −20° – +60° (structural and aerodynamic)
Wing pitch / AoA (normal flight) | −8° – +12° (S1223 stalls at ~14°, 2° margin)
Wing pitch (fin mode, W1+W4) | ±90° (servo range — fin mode exempt from AoA limit)
Flap stroke amplitude | ±80° (nominal), hardware stop at ±85°
Airspeed maximum (Vne) | 28 m/s structural limit
Airspeed minimum | VS × 1.05 = 5.09 m/s (stall check auto-boosts frequency)
Maximum load factor (utility) | 3.8g per FAA-H-8083-1B category

Fin mode exception: When W1 and/or W4 are commanded as vertical fins (dart or flat-turn manoeuvres), those wings are flagged in _fin_mode_pairs and the ±90° limit applies in place of the normal AoA limit. W2 and W3 always use the ±12° limit.

# 5. Aerodynamic Design Decisions

## 5.1 Sweep Angle and Drag

The correct drag model separates profile drag from induced drag:

D_profile = CD0 × q × S_actual (actual wetted area, constant with sweep)

D_induced = CDi × q × S_eff (effective lifting area varies with sweep)

AR_eff = 4 × semi_mean² × |sin(θ)| / S (effective aspect ratio at sweep angle θ)

CDi = CL² / (π × AR_eff × e)

Key result: 90° sweep (straight lateral) minimises induced drag at ALL speeds because AR_eff is maximised. The original jet-wing analogy (aft sweep = fast) does not apply at low Reynolds numbers where there are no shocks.

V (m/s) | Best sweep | Total drag
9 | 90° | 5.73 N
12 | 90° | 4.99 N
14 | 90° | 5.29 N
20 | 90° | 8.06 N

Sprint sweep was corrected from 135° (Rev A) → 25–30° (Rev O2 error) → 90° (Rev O2 audit, confirmed correct). The 135° choice increased induced drag by 30–43% versus 90°. The 25–30° forward sweep also increased induced drag by reducing AR_eff.

## 5.2 Lever Speed Zones

The gl_lever (left stick vertical on Mode 2 TX) runs 0–100% power-to-glide:

Lever % | Zone | Key parameters
0 – 15% | SPRINT | f = 2.5→3.0 Hz, sweep = 90°, dih = −8°
16 – 30% | POWERED_CRUISE | f = 3.0→1.5 Hz, sweep = 90°→60°
31 – 45% | STD_CRUISE | f = 1.5→0.8 Hz, sweep = 90°→60°
46 – 55% | TRIM | f = 0.8→0.2 Hz, sweep = 60°, dih = 0°
56 – 65% | CLEAN_GLIDE | f = 0.2→0.15 Hz, dih = 0°→8°
66 – 75% | APPROACH | f = 0.15→0.3 Hz, dih = 8°→18°
76 – 85% | STEEP_DESCENT | f = 0.3→0.5 Hz, sweep = 60°→90°, dih = 18°→35°
86 – 95% | NEAR_VERTICAL | f = 0.5→0.8 Hz, sweep = 90°→120°, dih = 35°→45°
96 – 100% | MAX_AIRBRAKE | f = 0.8→1.0 Hz, sweep = 120°→135°, dih = 45°→55°

TRIM zone intent: the zone brackets the Ps=0 equilibrium. Exact position depends on the calibrated thrust coefficient CT_cal which is a # CAL: placeholder until first flight. The equilibrium lever position is measured directly in flight and the zone boundaries may be adjusted. At lever=47–49% the aircraft is expected to hold altitude at cruise speed.

## 5.3 Stall Speed Formula

Vs = √( 2 × W / (ρ × S × CL_max) )

= √( 2 × 33.83 / (1.225 × 0.979 × 2.40) )

= 4.848 m/s = 9.42 kt

Where W = MTOW × g = 3.448 × 9.81 = 33.83 N, ρ = 1.225 kg/m³ (ISA sea level), S = 0.979 m², CL_max = 2.40.

# 6. Boyd Energy-Manoeuvring Theory

## 6.1 Specific Excess Power

All flight mode transitions are governed by Boyd's Energy-Manoeuvring (E-M) theory. The fundamental quantity is Specific Excess Power Ps:

Ps = (T − D) × V / W [m/s, metres of altitude equivalent per second]

Es = h + V²/(2g) [specific energy, metres]

Ps > 0: aircraft gaining energy (climbing or accelerating).

Ps = 0: aircraft maintaining energy state (true trim).

Ps < 0: aircraft spending energy (decelerating or descending).

## 6.2 Ps Target Table (complete)

Every flight mode has a Ps target. The wing-beat frequency is adjusted via a Boyd feedback controller to drive Ps toward the target:

Ps Target | Intent / Mode | Design Rationale
+3.00 | sprint | Maximise surplus — accelerate
+1.00 | climb | Use surplus for altitude gain
+0.50 | power_dive | Controlled dive — gravity + thrust
+0.20 | cruise | Slight surplus — maintain height
+0.20 | turn_gentle | Maintain energy through gentle turn
+0.10 | loiter | Minimal surplus — station keeping
+0.00 | chandelle | Trade V→h on Ps=0 boundary
+0.00 | stoop_pullout | Boyd zero-crossing pullout trigger
+0.00 | turn_moderate | Fly the Ps=0 boundary
+0.00 | zoom_climb | V→h on Ps=0 boundary
−0.30 | spiral | Controlled Es reduction
−0.50 | approach | Deliberate glide-path energy drain
−0.50 | turn_hard | Accept energy loss — spend Es
−1.00 | landing | Drain Es to Vs²/(2g) at threshold
−2.00 | airbrake | Deliberate Es destruction
−9.99 | stoop_dive | Gravity powered — Ps irrelevant

## 6.3 Boyd Frequency Controller

freq_new = freq_current + K_boyd × (Ps_target − Ps_measured) × dt

K_boyd is tuned so frequency changes smoothly. The resulting frequency is clamped to [FREQ_LIMIT_MIN_HZ, FREQ_LIMIT_MAX_HZ] by enforce_physical_limits().

# 7. Flight Control Architecture

## 7.1 Three-Layer Stack

1. Intent layer (IntentInterpreter): reads RC sticks and switch positions, detects gestures, outputs an Intent enum value and confidence score.
2. Behaviour layer (BehaviourDispatcher): maps Intent → BehaviourNode, executes tick() at 50 Hz, writes target values to ControlState._tgt_*.
3. Execution layer (ControlState.update()): applies bell-curve rate limiting, calls classify_urgency(), calls enforce_physical_limits() as the final step, updates servo outputs.

The 50 Hz loop runs in mco_main.py. No behaviour or function can write directly to servos — all output passes through ControlState.update().

## 7.2 Stick and Lever Assignment (Mode 2)

Channel | Function
CH1 (roll) | Lateral stick: turn authority / crab direction
CH2 (pitch) | Longitudinal stick: pitch attitude control
CH3 (throttle) | Not used for thrust (thrust from frequency, not throttle)
CH4 (yaw) | Yaw: differential cascade timing / fin pitch
CH5 (mode SW) | 0 = normal, 1 = flat-turn / fin mode
CH6 (gl_lever) | Glide lever: 0% = sprint, 50% = trim, 100% = max airbrake
CH7 (macro SW) | Macro trigger: enables gesture detection window

## 7.3 Bell-Curve Smoothing (Rev M)

All wing parameter transitions use a smootherstep bell-curve profile to eliminate jerk. The urgency parameter scales the rate:

smooth_step(current, target, rate, dt, urgency)

→ calls smooth_step_bell(t) = 6t⁵ − 15t⁴ + 10t³

urgency = classify_urgency(intent, Ps, bank, V, h)

Urgency values by intent category:

- 1.0 — recover, emergency_land
- 0.8 — stoop, dart, stoop_auto (structural shock risk)
- 0.6 — zoom_climb
- 0.5 — power_dive
- 0.3 — cruise, turn, sprint (gradual)
- 0.0 — default / glide

## 7.4 Stall Detection and Recovery

stall_speed_check() runs every loop alongside the hard clamps:

q = 0.5 × ρ × V²

n = 1 / cos(bank_deg) (load factor from bank)

S_eff = S × mean(|sin(θ_sweep)|) (effective area)

CL_req = W × n / (q × S_eff)

CAUTION when CL_req ≥ CL_max × 0.80. STALL when CL_req ≥ CL_max. Auto-boost: frequency increases by STALL_RECOVERY_FREQ_BOOST_HZ × dt each loop until clear.

Near stall (V < 1.4 × Vs): x29_high_aoa_params() activates, sweeping all wings to 30° (root-first stall, tip servos effective) and extending pitch limit to 14°.

# 8. Intent and Behaviour Catalogue

All 44 intents are registered in BEHAVIOUR_REGISTRY. The complete list:

Intent Value | Behaviour Class | Category
cruise | CruiseBehaviour | Normal flight
climb | ClimbBehaviour | Normal flight
descend | GlideBehaviour | Normal flight
glide | GlideBehaviour | Normal flight
soar | GlideBehaviour | Normal flight
sprint | SprintBehaviour | Performance
turn_left / turn_right | TurnBehaviour | Manoeuvre
tight_turn | TurnBehaviour | Manoeuvre
slip / skid | TurnBehaviour | Manoeuvre
flat_turn_left / flat_turn_right | FlatTurnBehaviour | Manoeuvre
crab_left / crab_right | CrabBehaviour | Advanced manoeuvre
zoom_climb | ZoomClimbMacro | Advanced manoeuvre
power_dive | PowerDiveBehaviour | Advanced manoeuvre
stoop | StoopMacro | Advanced manoeuvre
stoop_auto | StoopMacro | Gesture-triggered
dart_left / dart_right | DartMacro | Advanced manoeuvre
chandelle | ChandellesMacro | Advanced manoeuvre
cf1_burst | CF1Macro | Advanced manoeuvre
spiral_down | GlideBehaviour | Descent
loiter | LoiterBehaviour | Station-keeping
orbit_left / orbit_right | OrbitBehaviour | Station-keeping
approach_normal/steep/abort/site | GlideBehaviour / ClimbBehaviour | Approach
land | GlideBehaviour | Landing
emergency_land | RecoverBehaviour | Safety
recover | RecoverBehaviour | Safety
rth | CruiseBehaviour | Safety
inspection | InspectionBehaviour | Ground / low speed
taxi_fwd / taxi_rev | TaxiFwd / TaxiRevBehaviour | Ground
wing_all/partial/single/slot/gap/rear | WingConfigBehaviour | Wing config

# 9. Gesture Detection

## 9.1 GestureDetector

GestureDetector maintains a 0.4-second rolling window of stick position and velocity at 50 Hz. Three gestures are defined:

Gesture | Trigger Conditions
zoom_climb | Pitch stick pulled back FAST (rate ≥ +1.5 sticks/s) + lever ≤ 20%
stoop_auto | Pitch stick pushed forward (amplitude ≥ 0.85 of full throw) + rate ≤ −1.5 sticks/s + lever > 60% (glide zone)
power_dive | Steady forward pitch (−0.3 to −0.7) sustained for ≥ 22 samples + lever 25–50%

## 9.2 Stoop Gate — Three Mandatory Conditions

Wing stow (stoop entry) is only triggered when ALL THREE conditions are simultaneously present:

- AMPLITUDE: pitch stick at ≥ 85% of full forward travel
- RATE: stick arrived at that position at ≥ 1.5 sticks/second (full travel in < 0.67 s)
- LEVER: lever is in glide zone (> 60%)

NOTHING ELSE triggers wing stow. IMU pitch angle alone never triggers stow. Steady stick at full forward does not trigger stow. Lever on power side never triggers stow. This is a deliberate, irreversible safety constraint.

# 10. Key Manoeuvres — Physics and Parameters

## 10.1 Dart Manoeuvre

W1 and W4 pitch to 75° (vertical fin mode). W2 and W3 sustain lift at CL = 0.50.

Yaw moment: M_yaw = 10.30 N·m

Lateral acceleration at V=14 m/s: 2.43g

Heading change 90° in 0.145 s

Fin pitch limit: ±90° (exempt from normal ±12° AoA limit via _fin_mode_pairs flag). Dart phases: PREBUILD → ENGAGE → PIVOT → DISENGAGE → RESUME.

Rev O3 DISENGAGE: continuous fling — W1/W4 un-pitch and sweep simultaneously to 0° (Phase A, 0.05 s), then fling stroke 0°→135° immediately (Phase B). No dead time between fin mode and first post-dart stroke.

## 10.2 Enhanced CF-1 Clap-and-Fling

Weis-Fogh mechanism: port and stbd wings of the same pair sweep toward each other to near-contact, then fling apart. The fling generates a leading-edge vortex that augments CL.

Clap angle: 5° (tip gap = 135 mm = 0.82 × chord — safe structural clearance)

Vortex strength: Γ ∝ 1/gap → 9.94× stronger than original 35° clap

ΔCL: ≈ 1.80 (capped at CL_max = 2.40)

Fling tip velocity: 12.7 m/s (running start from 0° pre-position)

Non-adjacent pair order: W1 → W3 → W2 → W4 (maximises spatial vortex diversity). Only port+stbd of the SAME pair clap — no adjacent pair interference.

## 10.3 Crab Manoeuvre

Four independent control axes simultaneously. Lateral translation without heading change:

Axis | Implementation
Lateral thrust | All port wings swept to 30° → 17.0 N lateral → 3.5g
Heading hold | W1+W4 fin pitch 44° → 5.05 N·m yaw moment (cancels induced yaw)
Forward thrust | Stbd wings at 60° deployed → normal propulsion
Altitude | Flap frequency maintained

Force decomposition (rigorous 3D cross-product):

span = (cos θ, sin θ, 0)

V_rel = (V_fwd, 0, −V_stroke)

lift_dir = (span × V_rel) / |span × V_rel|

= (−sin θ × V_stroke, cos θ × V_stroke, −sin θ × V_fwd) / |...|

At θ=30° port, θ=90° stbd: F_lat = 17.0 N, a_lat = 3.5g (confirmed)

Yaw balance: induced yaw = F_lat × arm = 17.0 × 0.297 = 5.05 N·m. Fin pitch at 44° produces 5.05 N·m counter-yaw. Residual = 0.01 N·m — essentially perfect balance.

Crosswind tolerance: 17 N overcomes crosswind drag to ~13 m/s. Combined with partial heading-into-wind: ~18–20 m/s effective tolerance.

Trigger: flat_turn mode (CH5=1) + roll stick > 0.2 deflection.

## 10.4 Zoom Climb

Three phases: ENTRY (V→Ps boundary), CLIMB (Ps=0, h gaining), APEX (V near Vs, switch to chandelle or recovery).

Rev O3 inertial pitch assist: W1 pre-positioned to 0° in 0.67 s before trigger. At entry, W1 sweeps 0°→90° simultaneously with first stroke. Angular momentum transfer produces 51°/s nose-up reaction for 1.0 s, independent of airspeed.

## 10.5 Stoop

Progressive wing stow. Five stow stages controlled by dive_stow_params(). Full stow (W1+W4 at 210°) at stage 5. W2+W3 stow progressively. Stall check runs independently.

Constraint: dive stow only on GLIDE lever side (> 52.5%). Power lever side = power dive, no stow, regardless of IMU pitch.

## 10.6 Vectored Lateral Thrust

General form: port wings swept forward (toward 0°), stbd wings at 90°. Port side redirects flap thrust laterally. Stbd side provides vertical lift and forward thrust.

Sweet spot: θ_port = 25°–35° (stbd CL safe, F_lat maximised)

At θ_port = 0°: max lateral but stbd may approach CL_max at slow speed

Previous Rev O2 (W4 only at 0°): 1.82 N lateral — 9.3× weaker than full-port at 30°

## 10.7 X-29 High-AoA Mode

Activates when V < 1.4 × Vs. All wings sweep to 30°. Root stalls first, tip pitch servos remain in attached flow. Pitch limit extended from 12° to 14°. Used in stall recovery and slow SAR approach.

# 11. Weight and Balance

## 11.1 FAA-H-8083-1B Method

The static W&B calculation follows FAA-H-8083-1B (Aircraft Weight and Balance Handbook, 2016) exactly:

CG (mm from datum) = Σ(weight_i × arm_i) / Σ(weight_i)

Datum: nose tip of fuselage. All arms positive aft. Datum choice is arbitrary but must be consistent.

## 11.2 CG Envelope

Parameter | Value
Datum | Nose tip of fuselage
LEMAC | 280 mm aft of datum [# CAL: measure at build]
MAC | 165 mm (= chord)
Forward CG limit | 15% MAC [to be confirmed by flight test]
Aft CG limit | 35% MAC [to be confirmed by flight test]
CG % MAC formula | (CG_mm − LEMAC_mm) / MAC_mm × 100

## 11.3 Three-Layer CG System (mco_cg_estimator.py)

Layer 1 — CGStaticModel (preflight, ground): component arm table + pilot-entered weights → CG position. Pre-flight BIT check. All weights marked # CAL: until first flight.

Layer 2 — CGFlightEstimator (every 5 s in flight): infers CG offset from pitch trim deviation (pitch_cmd − pitch_model = delta_AoA → delta_CG via K_pitch) and lateral sweep asymmetry. Kalman-style update: alpha = 0.08 per observation.

Layer 3 — CGCompensator (50 Hz): adjusts _tgt_pitches and _tgt_sweeps to compensate estimated offset. Authority: ±4° AoA differential W1/W4 ≈ ±10 mm longitudinal compensation. Maximum 30 mm range.

All calibration gains (K_pitch, K_lateral, K_rate) are # CAL: placeholders. Calibrate at first flight.

# 12. Software Architecture

## 12.1 Module Summary

Module | Purpose and Lines
mco_wave_library.py | All wave parameters, physics functions, constants. Rev O3. 6,331 lines.
mco_intent_control.py | Intent enum, behaviour classes, dispatcher. 1,004 lines.
mco_main.py | 50 Hz main loop, CG integration, dispatcher call. 484 lines.
mco_cg_estimator.py | Three-layer W&B system. 642 lines.
mco_preflight.py | BIT checks, pre-flight W&B gate. 762 lines.
mco_performance_model.py | Thrust/drag/Ps model, calibration parameters. 779 lines.
mco_flight_recorder.py | Telemetry logging. 286 lines.
mco_optimiser.py | In-flight parameter tuning. 624 lines.
mco_taxi_park.py | Ground operations. 550 lines.
mco_odrive_interface.py | CAN-FD motor control interface.
mco_servo_interface.py | I²C PCA9685 servo interface.
mco_mavlink_bridge.py | MAVLink telemetry bridge to Pixhawk.
mco_first_run_wizard.py | First-flight calibration wizard.

## 12.2 50 Hz Loop Sequence

4. Read sensors (IMU, GPS, airspeed, rangefinder, battery).
5. Build context dict for dispatcher.
6. Run GestureDetector.update() with current stick/lever values.
7. BehaviourDispatcher.update(): runs active behaviour tick(), writes _tgt_* values.
8. CGFlightEstimator.update() every 250 loops (5 s): update CG estimate.
9. CGCompensator.apply(): modulate _tgt_pitches and _tgt_sweeps.
10. ControlState.update(): bell-curve smooth toward targets, classify urgency, run enforce_physical_limits() and stall_speed_check() as final steps.
11. Write outputs to ODrive (motor commands) and servo interface.
12. Log telemetry.

## 12.3 Version String

Rev-H-A-B-C-D-E-F-G-H-I-J-K-L-M-N-O2-O3 2026-06-10

Each letter suffix corresponds to a named design addendum. All are incorporated into the single mco_wave_library.py file. The addendum history is documented in the module header.

# 13. Calibration Requirements Before First Flight

All items marked # CAL: in the codebase must be measured and entered before the first sortie. The following table is the complete pre-flight calibration checklist:

Item (# CAL: tag location) | How to measure
Component weights — all items in COMPONENT_ARMS table (mco_cg_estimator.py) | Weigh each component on a calibrated scale before installation
Component arms — all items in COMPONENT_ARMS table | Measure from nose tip with a steel rule after assembly
K_pitch (CG estimator) | Fly a steady level pass at known battery position; measure trim AoA deviation → K = known_CG_offset / measured_AoA_error
K_lateral (CG estimator) | Fly straight with deliberate lateral offset; measure sweep asymmetry
CT_cal (performance model) | Note lever position that holds altitude at cruise speed; back-calculate CT from thrust model
CG envelope limits (15–35% MAC) | Confirm by flight test: fly at forward limit loading, verify pitch authority; fly at aft limit, verify stability
LEMAC position | Measure leading edge of mean aerodynamic chord from nose tip after build
Stall speed (Vs actual) | Measure in flight; compare to 9.42 kt prediction
STALL_RECOVERY_FREQ_BOOST_HZ | Tune during low-speed flight testing

# 14. Pending Items and Open Decisions

## 14.1 Open Engineering Tasks

- Add preflight_wb_check() call to Tier 1 BIT in mco_preflight.py (tier1_bit hook identified, not yet wired).
- Implement run_cf1_clap_fling() execution path in wave_library (O-C1).
- STOOP priority interrupt to FCC — safety critical, must be hardware-level (O-C2).
- GPS terrain trigger for mountain mode (O-D7).
- T-MT1 validation procedure (O-D8).
- Tier 2 features (all-pair 0° sweep + 135° phase offset for maximum inertial pitch): defer until single-pair validated in flight.
- split_wing_descent_params() (formerly ballistic_descent_params) is an orphan function — no active dispatch path. Wire to an intent when needed.

## 14.2 Validation Tests (all PENDING — craft not yet built)

T1–T14 defined but PENDING. First flight has not occurred. All # CAL: constants are estimates.

## 14.3 Design Decisions That Await Flight Data

- Exact trim lever position for Ps=0 (depends on CT_cal).
- CG envelope limits (15–35% MAC are starting estimates — confirm by test).
- Optimal cascade phase offset for multi-pair 0° sweep (may need adjustment from standard 90°).
- Stall recovery boost rate STALL_RECOVERY_FREQ_BOOST_HZ (tune in flight).

# 15. Key Assumptions and Constraints

## 15.1 Aerodynamic Assumptions

- CL_max = 2.40 is the UIUC wind tunnel value for S1223 with VGs at Re ≈ 200,000. Actual value may differ at the MCO's operating Re range.
- CD0 = 0.030 is an estimate. Actual profile drag depends on membrane tension, rib finish, and construction quality.
- Oswald efficiency e = 0.78 is an estimate based on similar multi-wing configurations.
- CT and η (thrust coefficient and flapping efficiency) are # CAL: estimates. The entire Boyd frequency controller depends on these being correct.
- Stall with wings sweeping (flapping in progress) may differ from static stall. The stall check uses a simplified static model.

## 15.2 Structural Assumptions

- D-box primary structure analysis uses a simplified thin-wall beam model. Actual failure mode may differ if skin adhesion is poor.
- Spar stiffness uses isotropic assumption (round tube). This is conservative and correct for round pultruded CF.
- Wing mass estimates (100–180 g per pair) are based on material densities. Actual masses must be measured.

## 15.3 Control Assumptions

- The FCC (Pixhawk 6C Mini + RPi Zero 2W) can sustain a true 50 Hz loop without jitter. If loop rate drops, the bell-curve rate limiting and Boyd controller will behave incorrectly.
- ODrive Micro CAN-FD bus latency is negligible. High bus traffic at 3 Hz flapping across 8 motors simultaneously should be validated.
- GPS accuracy is adequate for RTH and orbit modes. Mountain terrain may produce multipath errors.

# 16. Bibliography and Sources

The following sources were consulted, referenced, or directly applied during the design process:

## 16.1 Aerodynamics — Airfoil Data

Source | Notes
Selig, M.S. et al. — "Summary of Low-Speed Airfoil Data" (UIUC Applied Aerodynamics Group, Vols 1–6) | Primary source for S1223 coordinates and CL/CD data. Free at m-selig.ae.illinois.edu/ads.html
UIUC Airfoil Coordinates Database — m-selig.ae.illinois.edu/ads/coord_database.html | S1223 .dat file used for Rev H2 wing construction drawing
Selig, M.S. — S1223 Retested Data (UIUC LSAT, Dec 2005) | Pitching moment data at m-selig.ae.illinois.edu/uiuc_lsat/s1223/

## 16.2 Flight Performance and Weight-and-Balance

Source | Notes
FAA-H-8083-1B — Aircraft Weight and Balance Handbook (FAA, 2016) | Authoritative reference for W&B methodology. All CG calculations follow this standard. Free at faa.gov/regulations_policies/handbooks_manuals/aviation/
FAA-H-8083-25B — Pilot's Handbook of Aeronautical Knowledge (FAA, 2016) | Load factor tables (3.8g utility, 6.0g aerobatic), stall speed definitions, and turn performance used in manoeuvre design

## 16.3 Energy-Manoeuvring Theory

Source | Notes
Boyd, J.R. — "Aerial Attack Study" (USAF, 1964) | Original E-M theory document. Ps formula, manoeuvre design philosophy, zoom-climb and stoop analysis.
Boyd, J.R. — "Patterns of Conflict" (briefing, 1986) | OODA loop and decision-cycle theory applied to the intent-based control architecture.
Kershner, W.K. — "The Student Pilot's Flight Manual" (9th ed.) | Practical application of energy management for approach and landing phase design.

## 16.4 Flapping Wing Aerodynamics

Source | Notes
Weis-Fogh, T. — "Quick estimates of flight fitness in hovering animals, including novel mechanisms for lift production" (J. Exp. Biol. 59, 1973) | Original clap-and-fling theory. Used for CF-1 vortex strength estimates.
Cheng, B. et al. — "Three-dimensional flow visualization and vorticity dynamics in revolving wings" (Exp. Fluids, 2013) | Vortex circulation vs gap relationship for clap-and-fling scaling.
Ellington, C.P. et al. — "Leading-edge vortices in insect flight" (Nature 384, 1996) | LEV mechanism underlying CF-1 and forward-sweep lift enhancement.
Dickinson, M.H., Lehmann, F.O., Sane, S.P. — "Wing rotation and the aerodynamic basis of insect flight" (Science 284, 1999) | Unsteady aerodynamic mechanisms; rotational lift at stroke reversal — relevant to flap stroke design.

## 16.5 Metachronal Motion and Multi-Appendage Locomotion

Source | Notes
Alben, S. et al. — "Dynamics of freely swimming flexible foils" (Phys. Fluids 24, 2012) | Wave propagation in multi-appendage systems; theoretical basis for cascade timing.
Ford, M.P. et al. — "Hydrodynamics of metachronal paddling: effects of varying duty cycle with incompressible flow" (J. R. Soc. Interface, 2019) | Duty cycle optimisation directly applicable to MCO cascade phase offset design.
Murphy, D.W. et al. — "Metachronal swimming in Antarctic krill: gait kinematics and system design" (J. Exp. Biol., 2011) | Phase offset data from biological metachronal locomotion.

## 16.6 Forward Swept Wings and Aeroelasticity

Source | Notes
Putnam, T.W. — "The X-29 Flight Research Program" (NASA TM-86869, 1984) | X-29 design rationale, aeroelastic divergence mechanism, and composite tailoring solution. Basis for MCO divergence analysis confirming non-applicability.
Norris, G. — "X-29: When Forward Was the Way Ahead" (Aviation Week, 2014) | X-29 high-AoA flight test results (67° AoA with retained control) applied to MCO pitch servo effectiveness analysis.
Grumman Corporation — X-29 Advanced Technology Demonstrator design documents (1984–1992) | Wash-in mechanism, composite tailoring, and root-stall aerodynamics.

## 16.7 Motor Control and ODrive

Source | Notes
ODrive Robotics — "ODrive Documentation v0.6" (odriverobotics.com/docs) | CAN-FD protocol, current limit configuration, motor pole pair settings. Cited in ODrive configuration troubleshooting.
GoolRC — "5010 360KV Motor Specification Sheet" | Motor rated current, KV value, and pole count used in ODrive configuration.

## 16.8 Structural Analysis

Source | Notes
Budynas, R.G. and Nisbett, J.K. — "Shigley's Mechanical Engineering Design" (10th ed., McGraw-Hill) | Bending stress in thin-walled sections; torsional stiffness (Bredt's formula) applied to D-box analysis.
Jones, R.M. — "Mechanics of Composite Materials" (2nd ed., Taylor & Francis) | Carbon fibre modulus and strength values; isotropic tube assumption basis.
FAA Advisory Circular AC 43.13-1B — "Acceptable Methods, Techniques, and Practices — Aircraft Inspection and Repair" | Structural repair standards applied to safety factor requirements.

## 16.9 Control Architecture

Source | Notes
PX4 / Pixhawk 6C Mini documentation (px4.io) | Flight controller integration, MAVLink protocol, sensor fusion.
ExpressLRS documentation (expresslrs.org) | RC link latency and failsafe configuration.
Colledge, P. and Colledge, M. — "Medical Terminology: A Guide for Health Professionals" (for analogy only) | The "intent" terminology in the control architecture draws loosely on medical intent-based decision systems.

## 16.10 Standards Applied

Standard | Application
14 CFR Part 23 (FAA) | Load factor limits: 3.8g utility, 4.4g acrobatic, 6.0g aerobatic — applied to structure sizing
FAA-H-8083-1B | W&B methodology — applied throughout CG system
FAA-H-8083-25B | Aerodynamic performance — stall, turns, approach
FAA-H-8083-15B — Instrument Flying Handbook | Energy state management concepts
DO-178C (informational reference only) | Software development levels noted but not formally applied to prototype

# Appendix A — Complete Physical Constants Table

Constant | Value and Source
MTOW_KG | 3.448 kg (design target)
RHO | 1.225 kg/m³ (ISA sea level)
G | 9.81 m/s²
VS_KT | 9.42 kt (computed from MTOW, S, CL_max)
CL_MAX | 2.40 (UIUC S1223 + VGs + Gurney)
CHORD_MM | 165.0 mm (all pairs)
STAGGER_MM | 138.0 mm (longitudinal between roots)
FLAP_AMP_DEG | ±80.0° (nominal stroke)
REDUCER_RATIO | 7 (rope drive)
FREQ_LIMIT_MAX_HZ | 3.0 Hz
FREQ_LIMIT_MIN_HZ | 0.0 Hz
SWEEP_LIMIT_MIN_DEG | 0.0° (full forward)
SWEEP_LIMIT_MAX_DEG | 210.0° (stowed)
DIHEDRAL_LIMIT_MIN_DEG | −20.0°
DIHEDRAL_LIMIT_MAX_DEG | +60.0°
PITCH_LIMIT_MIN_DEG | −8.0°
PITCH_LIMIT_MAX_DEG | +12.0° (normal) / +14.0° (X-29 mode)
FIN_PITCH_LIMIT_DEG | ±90.0° (fin mode only)
V_LIMIT_MAX_MS | 28.0 m/s (Vne)
DART_FIN_PITCH_DEG | 75.0°
CF1_CLAP_SWEEP_DEG | 5.0° (enhanced, Rev O2)
CF1_FLING_END_DEG | 135.0°
STOOP_STICK_AMPLITUDE_MIN | 0.85 (85% of full throw)
STOOP_STICK_RATE_MIN | 1.5 sticks/s
STOOP_AUTO_LEVER_THRESHOLD | 60.0% (glide zone required)
INERTIAL_PITCH_PREPOS_S | 0.67 s (W1 sweep 60°→0°)
INERTIAL_PITCH_RATE_DPS | 51.0°/s (fuselage reaction)
LEVER_SPRINT_END | 15.0%
LEVER_PWR_CRUISE_END | 30.0%
LEVER_STD_CRUISE_END | 45.0%
LEVER_TRIM_END | 55.0%
X29_FORWARD_SWEEP_DEG | 30.0°
X29_AoA_LIMIT_DEG | 14.0°

# Appendix B — Key Formulae Summary

## Stall speed

Vs = √(2W / (ρ × S × CL_max)) = 4.848 m/s

## Specific excess power

Ps = (T − D) × V / W [m/s]

## Specific energy

Es = h + V²/(2g) [m]

## Load factor in banked turn

n = 1 / cos(bank_deg)

## Required CL in flight

CL_req = W × n / (q × S_eff) where q = 0.5 × ρ × V²

## Effective aspect ratio at sweep angle θ

AR_eff = 4 × semi_mean² × |sin θ| / S

## Induced drag coefficient

CDi = CL² / (π × AR_eff × e)

## Torsional divergence speed (D-box)

q_div = GJ / (dCL/dα × e × S × semi)

V_div = √(2 × q_div / ρ) = 128.9 m/s

## CG position (FAA-H-8083-1B)

CG_mm = Σ(weight_i × arm_i) / Σ(weight_i)

CG_%MAC = (CG_mm − LEMAC_mm) / MAC_mm × 100

## Vectored thrust force decomposition

lift_dir = (span × V_rel) / |span × V_rel|

span = (cos θ, sin θ, 0)

V_rel = (V_fwd, 0, −V_stroke)

F_lat at θ=30°, V=9m/s, f=1.2Hz: 17.0 N (3.5g)

## Crab yaw balance

M_induced = F_lat × semi_mean × 0.4 = 17.0 × 0.297 = 5.05 N·m

Fin pitch for null yaw = (5.05 / 10.3) × 90° = 44°

End of document.

MCO-1D Technical Handover Document — Wave Library Rev-H-A-B-C-D-E-F-G-H-I-J-K-L-M-N-O2-O3 — 2026-06-11

Rev-H-A-B-C-D-E-F-G-H-I-J-K-L-M-N-O2-O3 | Page of

MCO-1D Technical Handover · CONFIDENTIAL ENGINEERING RECORD
