wrbell/dad-ornithopter/cad/bread_stamps/stamp_front_and_back_views.png

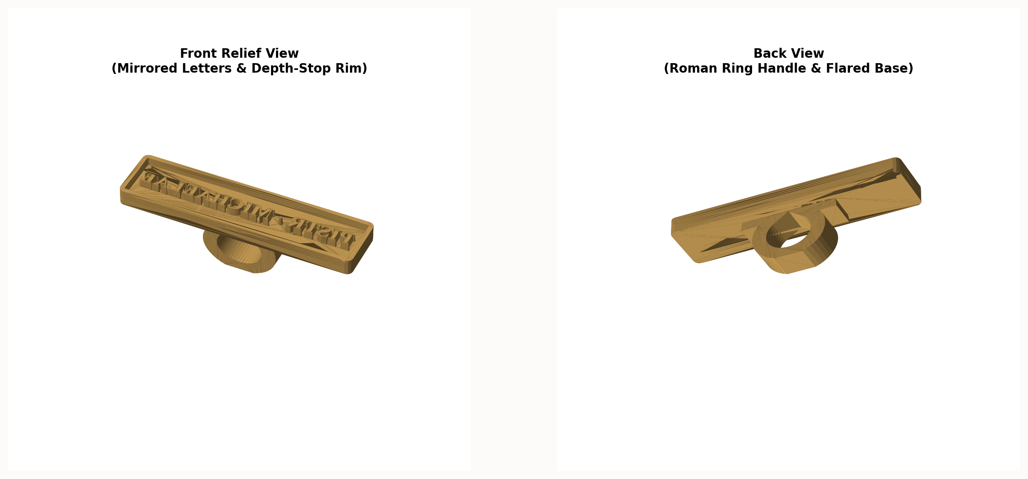
cad/bread_stamps/stamp_front_and_back_views.png
