wrbell/dad-ornithopter/cad/bread_stamps/stamp_vs_bread_imprint.png

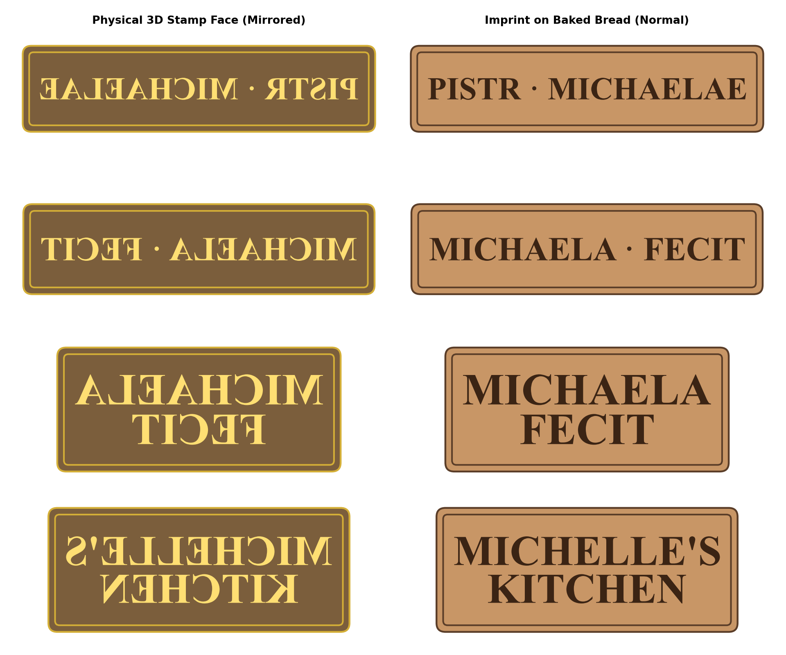
cad/bread_stamps/stamp_vs_bread_imprint.png
