wrbell/dad-ornithopter/cad/bread_stamps/stamps_3d_preview.png

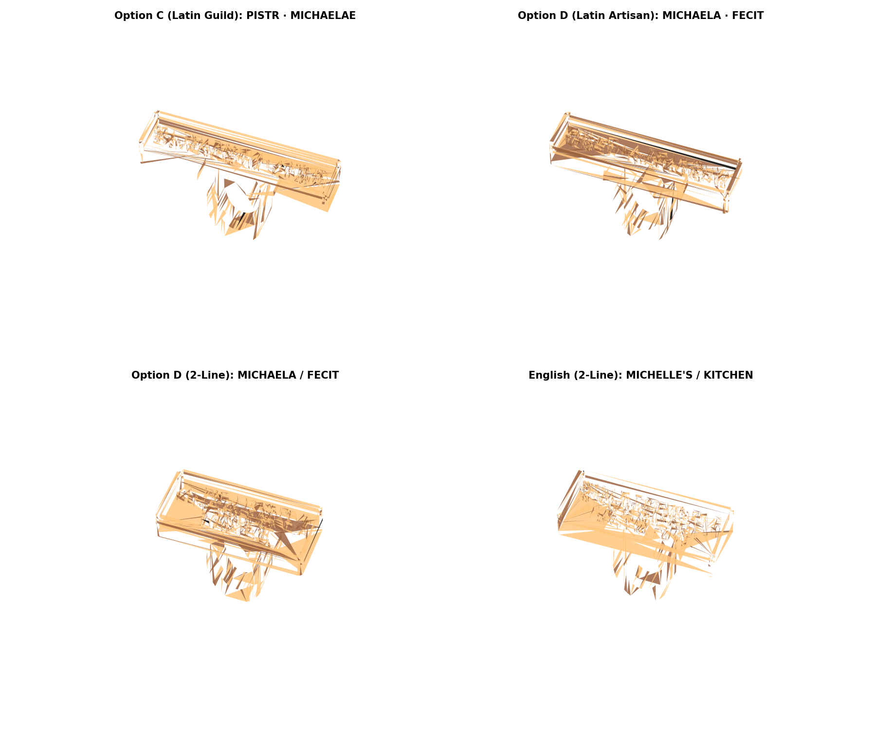
cad/bread_stamps/stamps_3d_preview.png
