wrbell/dad-ornithopter/cad/bread_stamps/stamps_3d_render_composite.png

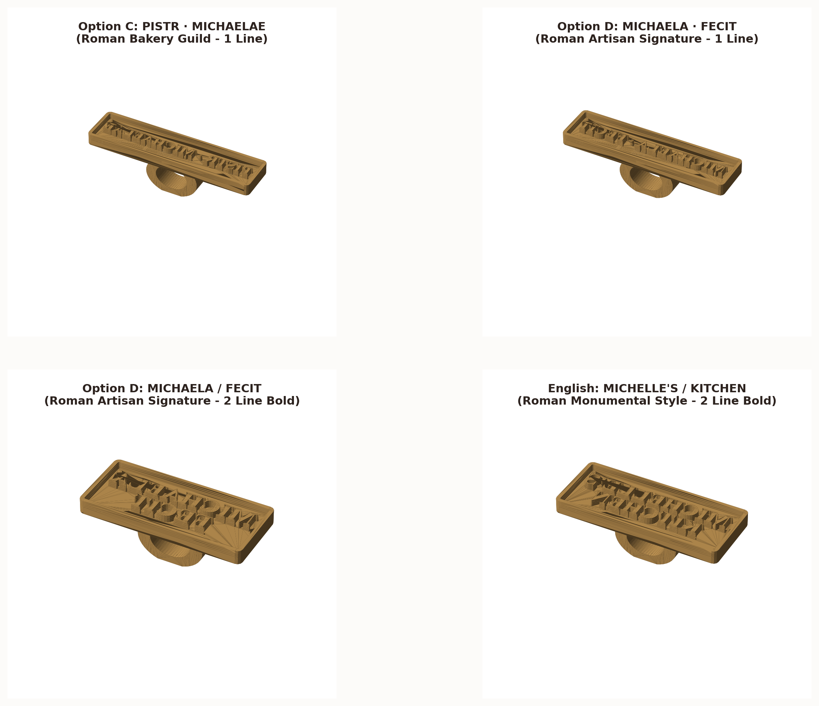
cad/bread_stamps/stamps_3d_render_composite.png
