wrbell/dad-ornithopter/cad/manufactured/mco_core_one_bed_overview.png

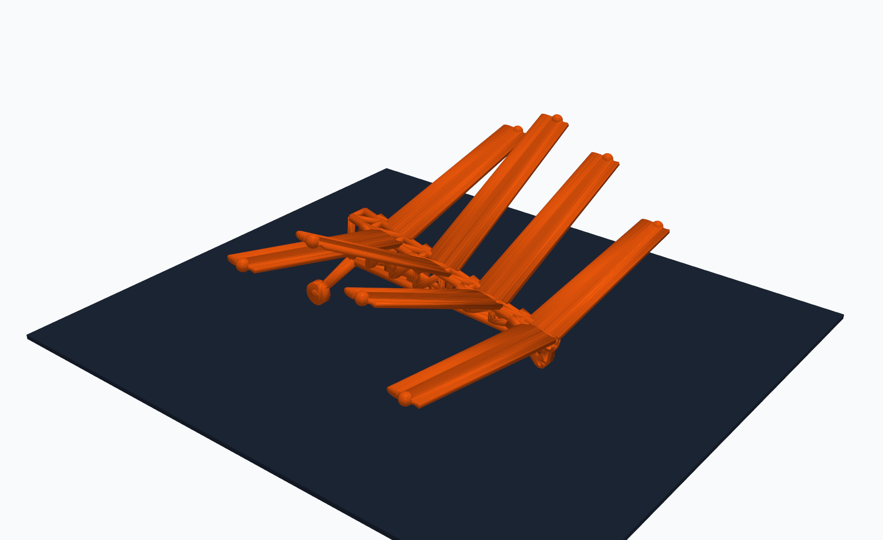
cad/manufactured/mco_core_one_bed_overview.png
