wrbell/dad-ornithopter/bom/bom.csv

level | part_no | rev | description | qty | uom | make_buy | material | source | cad_file | id | category | unit_price | unit_mass_g | installed_mass_g | url | notes
1 | GoolRC-5010-360KV | - | GoolRC 5010-14 360KV High-Torque Multi-Rotor Brushless Motor | 8 | ea | buy | Al/Cu/NdFeB | Amazon / Banggood / AliExpress |  | PROP-01 | 1. Propulsion & Kinematic Drivetrain | 19.50 | 95.00 | 760.0 | https://www.amazon.com/dp/B073F9L5T2 | Baseline flight motor: 95g per motor, 360KV, 6S rated. (T-Motor MN5008 ~200KV retained as heavy-duty upgrade option).
1 | ODR-S1-CAN | - | ODrive S1 High-Performance CAN Motor Controller | 8 | ea | buy | FR4 PCB / Al Heatsink | ODrive Robotics |  | PROP-02 | 1. Propulsion & Kinematic Drivetrain | 79.00 | 80.00 | 640.0 | https://odriverobotics.com/shop/odrive-s1 | 1 per motor. FOC oscillation drive at 50 Hz loop. Node IDs 0-7 on CAN-FD.
1 | KAL50FB2R00 | - | 50W 2.0-Ohm Central Dynamic Bus Brake Resistor (Shared DC Rail) | 2 | ea | buy | Al-Housed Wirewound | ODrive Robotics / Mouser |  | PROP-03 | 1. Propulsion & Kinematic Drivetrain | 3.50 | 25.00 | 50.0 | https://odriverobotics.com/shop/50w-brake-resistor | 2 shared clamp resistors on main 22.2V motor power rail (PDB). Replaces 8 individual per-motor resistors.
1 | SD-M-0001 | - | 10:1 Capstan Sector Wheel (200 deg Arc, 3D-Printed Tough PLA) | 8 | ea | make | Tough PLA (100% Infill) | In-House 3D Print (Tough PLA) | cad/manufactured/v10_stagecoach_sector_drum.step | PROP-04 | 1. Propulsion & Kinematic Drivetrain | 0.75 | 14.30 | 114.0 | https://sendcutsend.com | Legacy ID MCO1D-SEC-10TO1-PLA. 100% infill Tough PLA 10:1 sector wheel (R=60mm, 200 deg arc).
1 | MAR-SK99-08MM | - | Dyneema SK99 0.8mm Braided Capstan Line (100m Spool) | 1 | spool | buy | UHMWPE SK99 | Marlow Ropes / West Marine |  | PROP-05 | 1. Propulsion & Kinematic Drivetrain | 34.00 | 50.00 | 4.0 | https://www.marlowropes.com/product/excel-d12-sk99 | High modulus polyethylene. Break strength 210 kg. Pre-tensioned to 150-200 N on drum.
1 | SD-M-0002 | - | Precision 3D-Printed Helical Capstan Motor Drums (High-Temp PETG / Brass Insert) | 8 | ea | make | PETG + C3604 Brass Insert | In-House 3D Print (PETG) | cad/manufactured/v10_stepped_capstan_pinion.step | PROP-06 | 1. Propulsion & Kinematic Drivetrain | 0.75 | 7.50 | 56.0 | https://sendcutsend.com | Legacy ID MCO1D-DRUM-PETG. 100% infill PETG drum with M3 brass set-screw insert.
1 | B44BLS-SWEEP | - | AGFRC B44BLS High-Torque Mini Brushless Sweep Servos (15 kg-cm) | 9 | ea | buy | Al Case / Steel Gear | AGF-RC Official / Amazon |  | ACT-01A | 2. Morphing Actuation & Servo Systems | 42.00 | 44.00 | 352.0 | https://www.agf-rc.com | 8 installed on wing sweep stations + 1 spare. 15 kg-cm torque @ 8.4V, 444 deg/s.
1 | B24CLM-PITCH | - | AGFRC B24CLM Ultra-Light Micro Coreless Pitch Servos (7.0 kg-cm) | 9 | ea | buy | Al Case / Titanium Gear | AGF-RC Official / Amazon |  | ACT-01B | 2. Morphing Actuation & Servo Systems | 28.50 | 21.00 | 168.0 | https://www.agf-rc.com | 8 installed on wing pitch/AoA stations + 1 spare. 7.0 kg-cm torque @ 8.4V, 545 deg/s.
1 | AGF-SPV3 | - | AGF-SPV3 USB Servo Programmer | 1 | ea | buy | ABS / PCB | AGF-RC Official |  | ACT-02 | 2. Morphing Actuation & Servo Systems | 24.99 | 25.00 | 0.0 | https://www.agf-rc.com/usb-servo-programmer-agf-spv3.html | Mandatory commissioning bench tool: limits travel to 170 deg and configures 333 Hz PWM rate.
1 | CAB-JST-SH-4P-30 | - | JST-SH 4-Pin Shielded Feedback Wire Extensions (30cm) | 16 | ea | buy | Tinned Cu / Silicone | SparkFun / Amazon |  | ACT-03 | 2. Morphing Actuation & Servo Systems | 0.85 | 4.00 | 0.0 | https://www.sparkfun.com/products/14427 | Routes 4th analog position wire (300-3000 mV) to MCP3208 12-bit ADC boards (mass included in PWR-06 harness).
1 | DUB-25T-TI-HORN | - | Titanium Servo Horn Clamps (25T Spline, M2 Hardpoints) | 20 | ea | buy | Ti-6Al-4V / 7075-T6 | Du-Bro / Amazon |  | ACT-04 | 2. Morphing Actuation & Servo Systems | 2.20 | 3.50 | 0.0 | https://www.dubro.com | Clamping style servo horns with zero backlash (mass accounted in ACT-01A/B installed assemblies).
1 | RPI4-MODBP-4GB | - | Raspberry Pi 4B Single Board Computer (4GB RAM) | 1 | ea | buy | FR4 PCB | CanaKit / Adafruit / SparkFun |  | AV-01 | 3. Avionics, Computing & Sensors | 55.00 | 46.00 | 46.0 | https://www.adafruit.com/product/4296 | Primary Flight Control Computer (FCC). Runs 50 Hz real-time executive mco_main.py.
1 | WS-18151-CANFD | - | Waveshare MCP2518FD CAN-FD Hat for Raspberry Pi | 1 | ea | buy | FR4 PCB | Waveshare Official / Amazon |  | AV-02 | 3. Avionics, Computing & Sensors | 19.99 | 22.00 | 0.0 | https://www.waveshare.com/2-ch-can-fd-hat.htm | High-speed SPI CAN-FD Hat. Operates at 1 Mbps nominal bitrate to ODrives (mass accounted in bus harness).
1 | HB-PX4-MINI-KIT | - | Holybro Pixhawk 4 Mini Autopilot & M8N GPS Module | 1 | ea | buy | ABS / PCB | Holybro Official / GetFPV |  | AV-03 | 3. Avionics, Computing & Sensors | 149.00 | 38.00 | 38.0 | https://holybro.com/products/pixhawk-4-mini | MAVLink bridge at 921600 baud. Provides master IMU, barometer, and GPS telemetry.
1 | MS4525DO-DS | - | MS4525DO Digital Pitot-Static Airspeed Sensor | 1 | ea | buy | Al Pitot / PCB | Holybro / Amazon |  | AV-04 | 3. Avionics, Computing & Sensors | 26.00 | 14.00 | 14.0 | https://holybro.com/products/digital-air-speed-sensor | Nose-mounted pitot tube forward of wing wash. Critical for dynamic stall protection.
1 | SEN-16977 | - | Benewake TF-Luna Micro LiDAR Rangefinder (8m I2C) | 1 | ea | buy | ABS / Optical | SparkFun / Benewake |  | AV-05 | 3. Avionics, Computing & Sensors | 24.50 | 5.00 | 5.0 | https://www.sparkfun.com/products/16977 | 0.1 to 8.0 m precision ground altitude. Drives landing flare and terrain-following.
1 | GY-521-MPU6050 | - | MPU-6050 6-Axis IMU Sensor Module | 1 | ea | buy | FR4 PCB | Amazon / SparkFun |  | AV-06 | 3. Avionics, Computing & Sensors | 4.50 | 3.00 | 2.0 | https://www.sparkfun.com/products/11028 | Secondary I2C (0x68) high-frequency body vibration and attitude rate monitor.
1 | ADA-2651 | - | BMP280 Precision Barometric Pressure Sensor | 1 | ea | buy | FR4 PCB | Adafruit / Amazon |  | AV-07 | 3. Avionics, Computing & Sensors | 3.80 | 2.00 | 1.0 | https://www.adafruit.com/product/2651 | I2C (0x76) barometric altitude fallback when LiDAR range exceeds 8.0 m.
1 | MCP3208-CI-P | - | Microchip MCP3208 8-Channel 12-Bit SPI ADC Boards | 2 | ea | buy | Silicon DIP / PCB | Mouser / Microchip |  | AV-08 | 3. Avionics, Computing & Sensors | 4.85 | 10.00 | 20.0 | https://www.mouser.com/ProductDetail/Microchip/MCP3208-CI-P | ADC #1 on CE1 for pitch feedback; ADC #2 on CE0 for sweep feedback (372-3723 counts).
1 | ADA-381 | - | DS18B20 1-Wire Digital Ambient Air Temperature Sensor | 1 | ea | buy | TO-92 | Adafruit / Mouser |  | AV-09 | 3. Avionics, Computing & Sensors | 2.50 | 2.50 | 0.0 | https://www.adafruit.com/product/381 | Connected to GPIO 4 (1-Wire). Computes real-time air density rho for aerodynamic scaling.
1 | FRSKY-AP-RS | - | FrSky Archer Plus RS 2.4 GHz SBUS Receiver | 1 | ea | buy | FR4 PCB | Aloft Hobbies / GetFPV |  | AV-10 | 3. Avionics, Computing & Sensors | 28.00 | 4.50 | 0.0 | https://alofthobbies.com/products/frsky-archer-plus-rs | SBUS input to Pixhawk 4 Mini. Failsafe auto-triggers RTH if link lost > 1.0 s.
1 | SEN-13879-KIT | - | HX711 24-Bit ADC + 5 kg S-Type Precision Load Cell Kit | 1 | kit | buy | Alloy Steel / PCB | SparkFun / Amazon |  | AV-11 | 3. Avionics, Computing & Sensors | 15.00 | 45.00 | 0.0 | https://www.sparkfun.com/products/13879 | Used during TC-01 and TC-02 ground bench test stands for live thrust and lift logging (not flown).
1 | AS5600L-POT | - | AS5600L 12-Bit Programmable I2C Magnetic Rotary Position Encoders | 8 | ea | buy | FR4 PCB / NdFeB | Mouser / Digi-Key / AliExpress |  | AV-12 | 3. Avionics, Computing & Sensors | 4.50 | 2.00 | 0.0 | https://www.mouser.com/ProductDetail/ams-OSRAM/AS5600L | Optional contactless magnetic encoders at pitch shafts (requires I2C multiplexer PCA9548A if installed).
1 | TAT-6S-2200-70C | - | Tattu / CNHL 6S 2200 mAh 70C LiPo Battery (22.2V, XT60) | 1 | ea | buy | LiCoO2 Polymer | Tattu Official / CNHL / Amazon |  | PWR-01 | 4. Power Storage & Electrical Distribution | 39.99 | 295.00 | 295.0 | https://genstattu.com | Locked sweet-spot flight battery (22.2V nominal, 48.84 Wh, 295g).
1 | MTK-UBEC-DUO-40A | - | Dual-Channel High-Current Synchronous Step-Down BEC System (2x 20A Cont / 30A Peak, 6S to 7.4V/8.4V) | 2 | ea | buy | FR4 PCB / Heatsink | Matek Systems / KDE Direct / GetFPV |  | PWR-02 | 4. Power Storage & Electrical Distribution | 24.00 | 25.00 | 25.0 | https://www.mateksys.com/?portfolio=ubec-duo | Dual-channel split power architecture (1 unit installed + 1 spare): powers Zone A and Zone B servo rails.
1 | PBS-SRV-BUS-16-DUAL | - | 16-Port High-Current Servo Power Bus Board (Dual-Zone Isolated Rails, 100A Burst) | 1 | ea | buy | 2oz Cu FR4 PCB | PowerBox Systems / FrSky |  | PWR-03 | 4. Power Storage & Electrical Distribution | 38.00 | 35.00 | 0.0 | https://www.powerbox-systems.com | Distributes 7.4V power with isolated Zone A (Port 1-8) and Zone B (Port 9-16) planes (mass in PWR-06 harness).
1 | EEU-FR1C472 | - | Panasonic 4,700 uF 16V Low-ESR Electrolytic Buffer Capacitors (Dual Zone) | 2 | ea | buy | Al Electrolytic | Mouser / Panasonic |  | PWR-04 | 4. Power Storage & Electrical Distribution | 2.25 | 8.00 | 0.0 | https://www.mouser.com/ProductDetail/Panasonic/EEU-FR1C472 | Soldered directly across Zone A and Zone B bus terminal blocks (<15mm lead length).
1 | MTK-PDB-120A | - | High-Current 8-Way Motor Power Distribution Rail (120A) | 1 | ea | buy | Cu Busbar / FR4 | Matek Systems / Amazon |  | PWR-05 | 4. Power Storage & Electrical Distribution | 14.50 | 18.00 | 0.0 | https://www.mateksys.com | Feeds 22.2V main propulsion power to 8x ODrive S1 units (mass in PWR-06 harness).
1 | AMASS-SIL-CONN-KIT | - | High-Flex 14 AWG / 22 AWG Silicone Wire & XT60/XT30 Connector Kit | 1 | kit | buy | Silicone / Tinned Cu | Amass / Amazon |  | PWR-06 | 4. Power Storage & Electrical Distribution | 18.50 | 120.00 | 80.0 | https://www.amazon.com | Installed airframe silicone wiring harness, PDB busbars, and connectors (80g installed).
1 | TI-INA226-BRK | - | Texas Instruments INA226 High-Side Current & Power Monitor Breakout (0.005 Ohm Shunt) | 1 | ea | buy | FR4 PCB | Adafruit / Mouser / Texas Instruments |  | PWR-07 | 4. Power Storage & Electrical Distribution | 12.50 | 4.50 | 0.0 | https://www.adafruit.com/product/4982 | Inline on 7.4V servo bus, I2C (0x40) to Pi 4B GPIO 2/3.
1 | DP-RND-20X17-1000 | - | High-Modulus 3K Roll-Wrapped Carbon Fiber Upper Spine Longeron (20mm OD x 17mm ID x 1000mm, cut to 700mm) | 1 | ea | buy | 3K Carbon Fiber | DragonPlate / Rock West Composites |  | STRUCT-01 | 5. Airframe, Wing Structure & Mechanics | 42.00 | 92.50 | 65.0 | https://dragonplate.com/carbon-fiber-round-tubes | Locked compact delta frame spine (cut to 700mm, 65g installed). 20mm OD x 1.5mm wall (J=7,508 mm4).
1 | DP-RND-12X10-1000 | - | 3K Roll-Wrapped Carbon Fiber Lower Keel Tube (12mm OD x 10mm ID x 1000mm, cut to 675mm) | 1 | ea | buy | 3K Carbon Fiber | DragonPlate / Rock West Composites |  | STRUCT-02 | 5. Airframe, Wing Structure & Mechanics | 28.00 | 53.60 | 36.0 | https://dragonplate.com/carbon-fiber-round-tubes | Locked compact delta frame keel tension tie (cut to 675mm, 36g installed).
1 | DP-RND-14X12-1000 | - | 3K Roll-Wrapped Carbon Fiber Front Vertical Truss Post (14mm OD x 12mm ID x 1000mm, cut to 160mm) | 1 | ea | buy | 3K Carbon Fiber | DragonPlate / Rock West Composites |  | STRUCT-03 | 5. Airframe, Wing Structure & Mechanics | 32.00 | 63.30 | 10.0 | https://dragonplate.com/carbon-fiber-round-tubes | Locked compact delta frame front post tying Corner 1 to Corner 2 (cut to 160mm, 10g installed).
1 | SD-M-0003 | - | Pinned Split-Clamp Modular Wing Mount Collars (26mm OD, 50mm length, 20mm bore) | 8 | ea | make | PA-CF / 6061-T6 | SendCutSend / In-House Print | cad/manufactured/v10_stagecoach_merged_core.step | STRUCT-04 | 5. Airframe, Wing Structure & Mechanics | 18.00 | 24.50 | 109.0 | https://sendcutsend.com | Legacy ID MCO1-CLAMP-20MM-PINNED. 8 modular clamp collars on 20mm spine (combined with STRUCT-01..03 = 220g delta frame).
1 | SD-M-0004 | - | Universal Rib & Segment Filament: ColorFabb LW-PLA Lightweight PLA (750g Spools) | 3 | spool | make | ColorFabb LW-PLA | ColorFabb Official / MatterHackers | cad/manufactured/s1223_wing_segment_25cm_2.4mm.step | STRUCT-05 | 5. Airframe, Wing Structure & Mechanics | 48.00 | 632.00 | 160.0 | https://colorfabb.com/lw-pla-natural | Legacy ID CF-LW-PLA-750. 3 spools procured; 160g foaming LW-PLA printed across all 8 wing skeletons.
1 | DP-TUBE-10MM-1200 | - | Pultruded Carbon Fiber Leading Edge Spar Tubes (10mm OD x 1.0mm wall x 1200mm, 8 Rods) | 8 | ea | buy | Pultruded Carbon Fiber | DragonPlate / Rock West Composites |  | STRUCT-06 | 5. Airframe, Wing Structure & Mechanics | 12.50 | 58.00 | 280.0 | https://dragonplate.com/carbon-fiber-rods | Continuous main spar at 25.0% MAC (cut to 1150mm, 35ginstalled per wing = 280g across 8 wings).
1 | DP-TUBE-2MM-MICRO | - | Hollow Carbon Fiber Secondary Alignment Spar Tubes (2.0mm OD x 1.0mm ID x 1000mm, 10-Pack) | 4 | pack | buy | Pultruded Carbon Fiber | DragonPlate / Rock West Composites / Amazon |  | STRUCT-07 | 5. Airframe, Wing Structure & Mechanics | 21.99 | 41.25 | 40.0 | https://dragonplate.com | Pultruded micro hollow carbon tubes (40g installed across 8 wings).
1 | ORA-LIGHT-TRANSP | - | Ultralight Mylar Wing Covering Film (Oralight 2m Spools) | 4 | roll | buy | Polyester Film (36 g/m2) | Oracover / Horizon Hobby |  | STRUCT-08 | 5. Airframe, Wing Structure & Mechanics | 24.00 | 72.00 | 72.0 | https://www.oracover.de | 36 g/m2 iron-on covering wrapping all 8 wings (1.224 m2 planform; STRUCT-05..08 = 552g = 4x 138g wing pairs).
1 | SD-M-0005 | - | Hybrid Teardrop Electronics Pod with NACA Ram-Air Duct & Negative-Pressure Louvers | 1 | ea | make | PETG Tub / LW-PLA Hatch | In-House 3D Print (PETG Tub / LW-PLA Hatch) | cad/manufactured/mco_electronics_bay_assembly.step | STRUCT-09 | 5. Airframe, Wing Structure & Mechanics | 5.50 | 118.00 | 116.0 | https://sendcutsend.com | Legacy ID MCO1D-POD-HYBRID-NACA. 370mm pod with integrated NACA nose intake (116g installed).
1 | DUB-200MW | - | Du-Bro 200MW 2.00 in (50mm x 14mm) Super Light Foam Wheels (Flight Spares) | 2 | ea | buy | EVA Foam / Nylon Hub | Du-Bro Official / Horizon Hobby |  | STRUCT-10 | 5. Airframe, Wing Structure & Mechanics | 7.95 | 13.60 | 0.0 | https://www.dubro.com | Closed-cell ultralight EVA foam tires with 4.0mm axle bore (flight-line backup spares).
1 | MMC-1254K18 | - | Precision Ground 4.00mm x 40mm Stainless Steel Axles with Retaining Hardware | 2 | ea | buy | 416 Stainless Steel | McMaster-Carr |  | STRUCT-11 | 5. Airframe, Wing Structure & Mechanics | 4.50 | 3.90 | 0.0 | https://www.mcmaster.com/precision-shafts | 416 stainless ground axle spares with E-clips.
1 | B0BL71QR5G | - | NOBRIM Carbon Fiber Main Landing Gear YAK50E Wheel Kit (Taildragger Main Arch) | 1 | kit | buy | 3K Carbon / EVA Wheels | NOBRIM / FLTHOBBY / Amazon |  | STRUCT-12 | 5. Airframe, Wing Structure & Mechanics | 19.99 | 36.00 | 36.0 | https://www.amazon.com/dp/B0BL71QR5G | Locked taildragger main gear clamped at X=400.0mm. 275mm track, 55mm EVA foam wheels.
1 | SD-M-0006 | - | 3D-Printed Resilient PETG Taildragger Tailskid Assembly | 1 | ea | make | PETG | In-House 3D Print (PETG) | cad/manufactured/mco_representative_tailskid.step | STRUCT-13 | 5. Airframe, Wing Structure & Mechanics | 1.25 | 9.00 | 9.0 | https://sendcutsend.com | Legacy ID MCO1D-SKID-PETG. Curved leaf spring tailskid at Corner 3 (X=690mm, 9g installed).
1 | SD-M-0007 | - | 3D-Printed Carbon-Fiber Polycarbonate (PC-CF) Frame Clamps Kit (Corners 1, 2, 3 & Saddle) | 1 | kit | make | CarbonX PC-CF | In-House 3D Print (PC-CF 100% Infill) | cad/manufactured/mco_clamps_and_skid_complete_kit.step | STRUCT-14 | 5. Airframe, Wing Structure & Mechanics | 9.50 | 48.00 | 39.0 | https://sendcutsend.com | Legacy ID MCO1D-CLAMPS-PCCF. Printed in CarbonX PC-CF with 100% infill (39g installed after trim).
1 | SD-M-0008 | - | Fuselage Compact Delta Truss Aerodynamic Infill Fairing (ColorFabb LW-PLA) | 1 | ea | make | ColorFabb LW-PLA | In-House 3D Print (LW-PLA) | cad/manufactured/mco_compact_delta_fuselage.step | STRUCT-15 | 5. Airframe, Wing Structure & Mechanics | 6.50 | 95.00 | 0.0 | https://colorfabb.com/lw-pla-natural | Legacy ID MCO1D-FAIR-DELTA-PLA. Optional aerodynamic fairing skin (omitted in naked bench/initial flight configuration).
1 | SD-M-0009 | - | Streamlined Teardrop Wing Root Nacelles Kit (8x Units with Flapping Wiper Seals) | 1 | kit | make | ColorFabb LW-PLA | In-House 3D Print (LW-PLA / Mylar) | cad/manufactured/mco_naca0018_wrist_fairing_lwpla.step | STRUCT-16 | 5. Airframe, Wing Structure & Mechanics | 4.50 | 48.00 | 0.0 | https://colorfabb.com/lw-pla-natural | Legacy ID MCO1D-FAIR-ROOTS-8X. Optional 8x 6.0g streamlined teardrop wrist fairings.
1 | SD-M-0010 | - | 3D-Printed Capstan Line Keeper Shrouds Kit (8x Pinion Anti-Derailment Shrouds) | 1 | kit | make | PETG | In-House 3D Print (PETG) | cad/manufactured/v10_powertrain_top_brace.step | STRUCT-17 | 5. Airframe, Wing Structure & Mechanics | 4.50 | 8.00 | 0.0 | https://sendcutsend.com | Legacy ID MCO1D-CAPSTAN-SHROUDS-8X. Snap-on shrouds maintaining <0.4mm clearance over Dyneema SK99 grooves.
1 | BOCA-MF106ZZ-16PK | - | MF106ZZ Flanged Miniature Ball Bearings (6mm ID x 10mm OD x 3mm Width, 16-Pack) | 1 | pack | buy | Chrome Steel | Boca Bearings / Amazon |  | HW-01 | 6. Precision Hardware, Fasteners & Consumables | 32.00 | 38.40 | 0.0 | https://www.bocabearings.com | Double shielded flanged bearings installed in split collars (mass included in STRUCT-04 / PROP-04 subassemblies).
1 | MMC-92745A315 | - | Grade 5 Titanium (Ti-6Al-4V) Precision Ground 6.00mm x 50mm Pivot Pins | 8 | ea | buy | Ti-6Al-4V | McMaster-Carr / Titanium Joe |  | HW-02 | 6. Precision Hardware, Fasteners & Consumables | 9.50 | 6.40 | 0.0 | https://www.mcmaster.com/titanium-pins | High shear strength (880 MPa) pivot pins (mass included in STRUCT-04 / PROP-04 subassemblies).
1 | MMC-91290A124 | - | Grade 12.9 Alloy Steel M3 Socket Head Cap Screws & M3 Nyloc Nuts (100-Piece Assortment) | 2 | pack | buy | Grade 12.9 Alloy Steel | McMaster-Carr |  | HW-03 | 6. Precision Hardware, Fasteners & Consumables | 14.50 | 65.00 | 0.0 | https://www.mcmaster.com/screws | M3x16 and M3x20 clamping bolts (installed fastener mass included in subassembly allocations).
1 | HEN-LOC-243-10ML | - | Loctite 243 Medium Strength Threadlocker & Retaining Compound | 1 | bottle | buy | Anaerobic Methacrylate | McMaster-Carr / Henkel |  | HW-04 | 6. Precision Hardware, Fasteners & Consumables | 14.50 | 15.00 | 0.0 | https://www.mcmaster.com/loctite | Mandatory on all metal-to-metal motor mount, servo horn, and sector wheel fasteners.
1 | MMC-FOAM-NEO-3MM | - | Closed-Cell Neoprene Vibration Dampening Foam Mounts (3mm) | 1 | sheet | buy | Closed-Cell Neoprene | McMaster-Carr |  | HW-05 | 6. Precision Hardware, Fasteners & Consumables | 8.00 | 12.00 | 0.0 | https://www.mcmaster.com/foam | Isolates Pixhawk 4 Mini and Raspberry Pi FCC from 50 Hz airframe motor harmonics.
1 | TE-CAN-120R | - | Aviation 120-Ohm Precision CAN Termination Resistor Jumpers | 2 | ea | buy | Metal Film | Mouser / TE Connectivity |  | HW-06 | 6. Precision Hardware, Fasteners & Consumables | 0.50 | 1.00 | 0.0 | https://www.mouser.com | Installed at the physical ends of the CAN-FD bus (Pi Hat end and Node #7 end).
1 | SEC-CNC-BALL-M3-16PK | - | Zero-Slop CNC Aluminum Ball Links & M3 Titanium Pushrod Turnbuckles Kit (16-Pack) | 1 | kit | buy | 7075-T6 / Ti-6Al-4V | Secraft / Dubro / Amazon |  | HW-07 | 6. Precision Hardware, Fasteners & Consumables | 32.00 | 20.00 | 0.0 | https://www.secraft.net | Zero-backlash (<0.1mm play) linkages connecting AGFRC servos to wing root pitch horns.
1 | MCO1D-TH-GASKET-8PK | - | High-Temp FR4 / Ceramic-Filled Silicone Motor Thermal Isolator Gaskets (0.5mm, 8-Pack) | 1 | pack | buy | FR4 / Silicone | McMaster-Carr / SendCutSend |  | HW-08 | 6. Precision Hardware, Fasteners & Consumables | 6.50 | 4.80 | 0.0 | https://www.mcmaster.com | 0.5mm thermal isolator gaskets mounted between GoolRC 5010 motor faces and brackets.
1 | RUTHEX-ASSORT-M2-M3 | - | C3604 Brass Heat-Set Threaded Inserts Assortment (M2.0, M2.5, M3 Ruthex / CNC Style, 150-Pack) | 1 | pack | buy | C3604 Brass | Ruthex / CNC Kitchen / Amazon |  | HW-09 | 6. Precision Hardware, Fasteners & Consumables | 12.50 | 27.10 | 0.0 | https://www.ruthex.net | 114 inserts required across airframe (installed insert mass included in 3D-printed subassemblies).
