wrbell/dad-ornithopter/cad/manufactured/v9_stepped_pinion_assembly.step

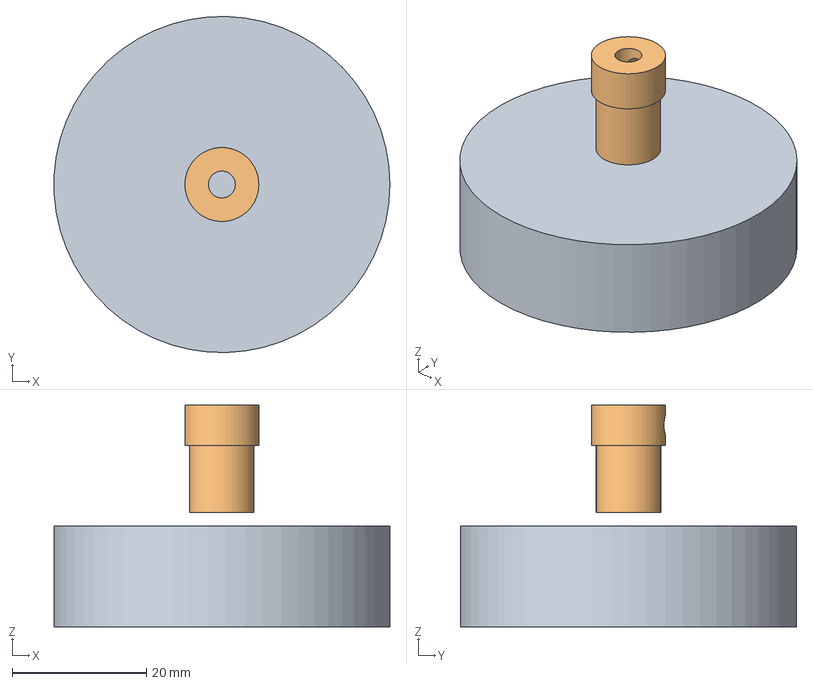
[picture p18: CAD file, 2026-10-16]
cad/manufactured/v9_stepped_pinion_assembly.step
50.0 x 50.0 x 33.0 mm
