wrbell/dad-ornithopter/cad/manufactured/mco_main_gear_saddle_clamp.step

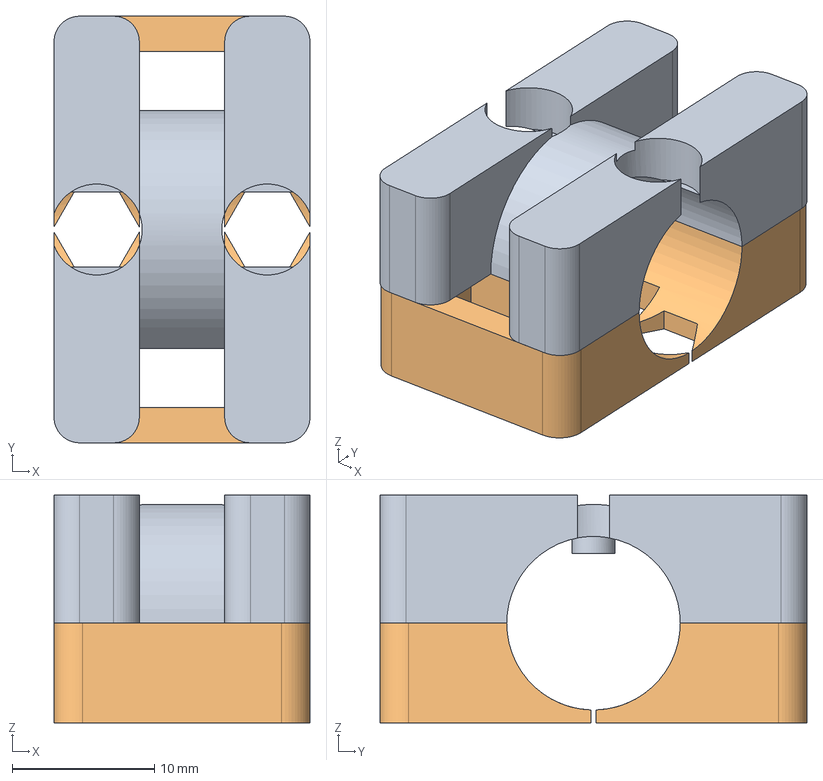
[picture p19: CAD file, 2026-10-16]
cad/manufactured/mco_main_gear_saddle_clamp.step
18.0 x 30.0 x 16.0 mm
