wrbell/dad-ornithopter/cad/manufactured/s1223_full_wing_skeleton_assembly.stl

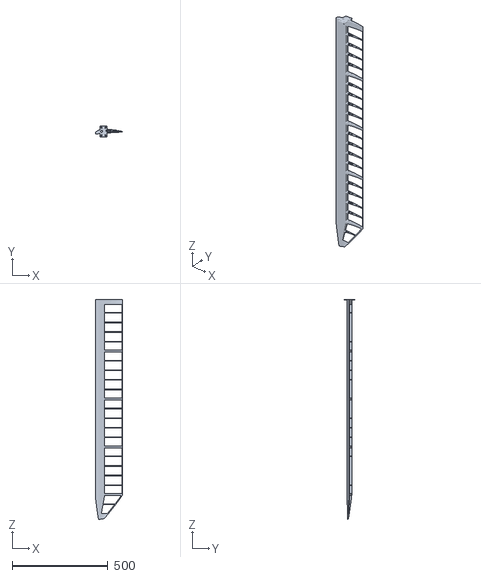
[picture p20: CAD file, 2026-10-16]
cad/manufactured/s1223_full_wing_skeleton_assembly.stl
143.7 x 56.0 x 1149.8
