wrbell/dad-ornithopter/cad/manufactured/v10_complete_wing_root_assembly.step

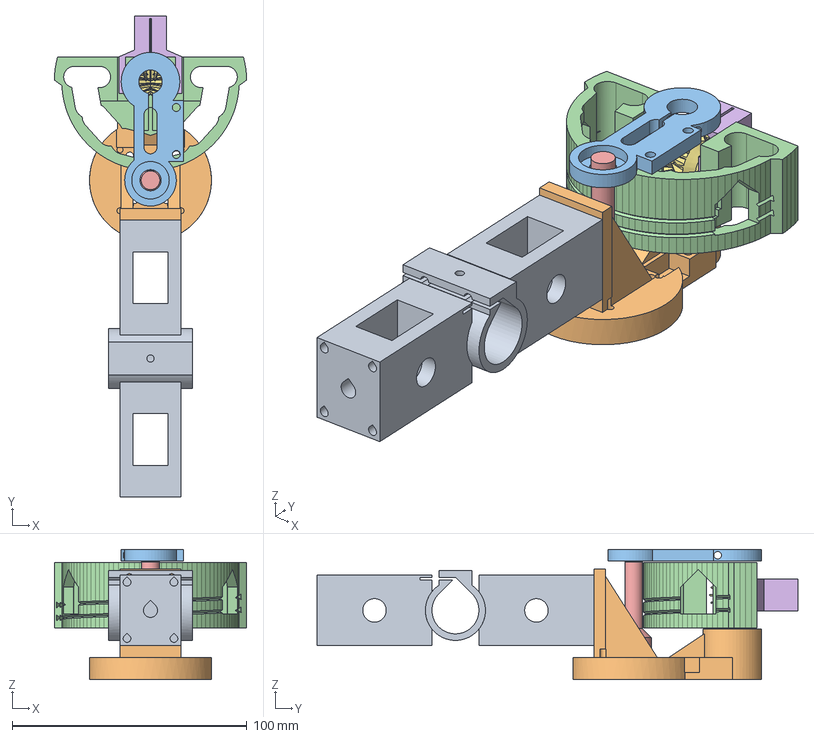
[picture p21: CAD file, 2026-10-16]
cad/manufactured/v10_complete_wing_root_assembly.step
82.0 x 205.0 x 55.5 mm
