wrbell/dad-ornithopter/cad/manufactured/mco_clamps_and_skid_complete_kit.step

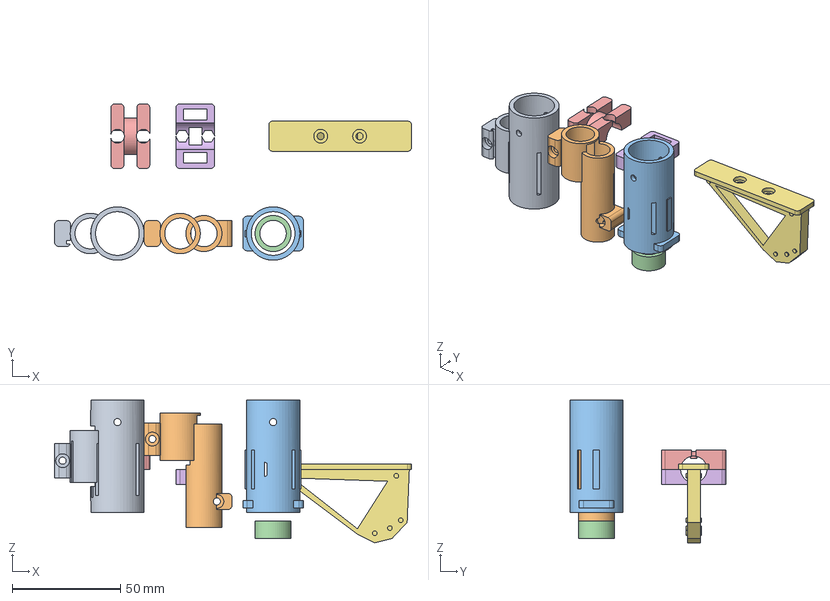
[picture p22: CAD file, 2026-10-16]
cad/manufactured/mco_clamps_and_skid_complete_kit.step
165.1 x 72.3 x 66.0 mm
