wrbell/dad-ornithopter/cad/manufactured/mco_main_gear_saddle_upper.stl

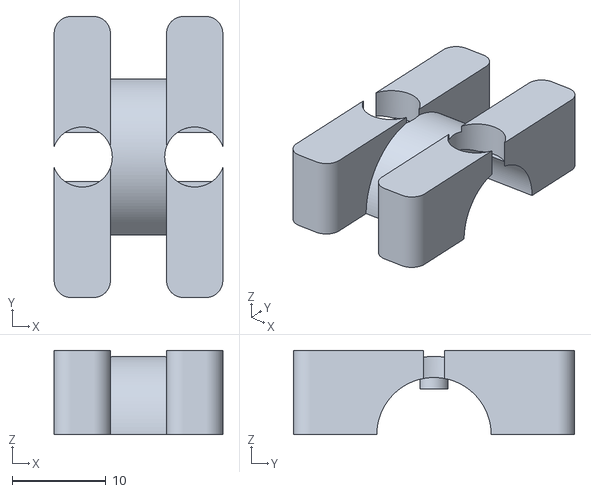
[picture p23: CAD file, 2026-10-16]
cad/manufactured/mco_main_gear_saddle_upper.stl
18.0 x 30.0 x 9.00
