wrbell/dad-ornithopter/cad/manufactured/mco_main_gear_saddle_lower.stl

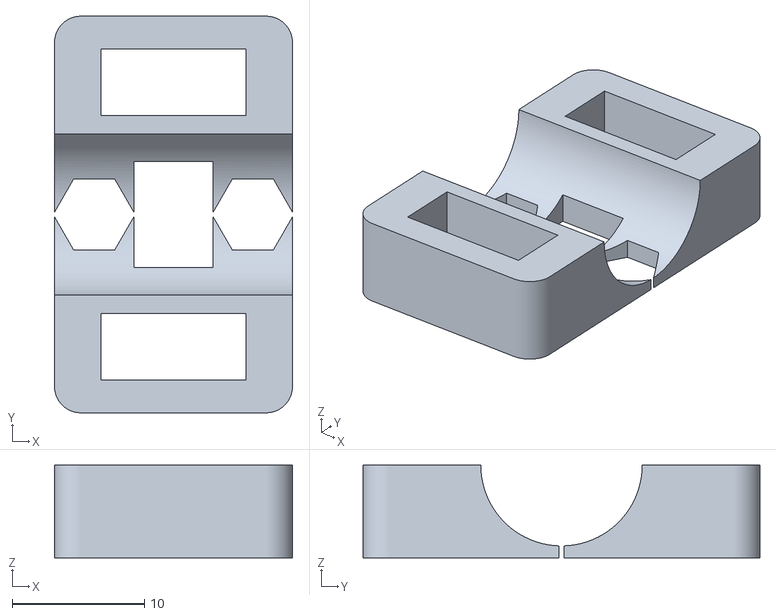
[picture p24: CAD file, 2026-10-16]
cad/manufactured/mco_main_gear_saddle_lower.stl
18.0 x 30.0 x 7.00
