wrbell/dad-ornithopter/cad/manufactured/v10_powertrain_chassis_assembly.step

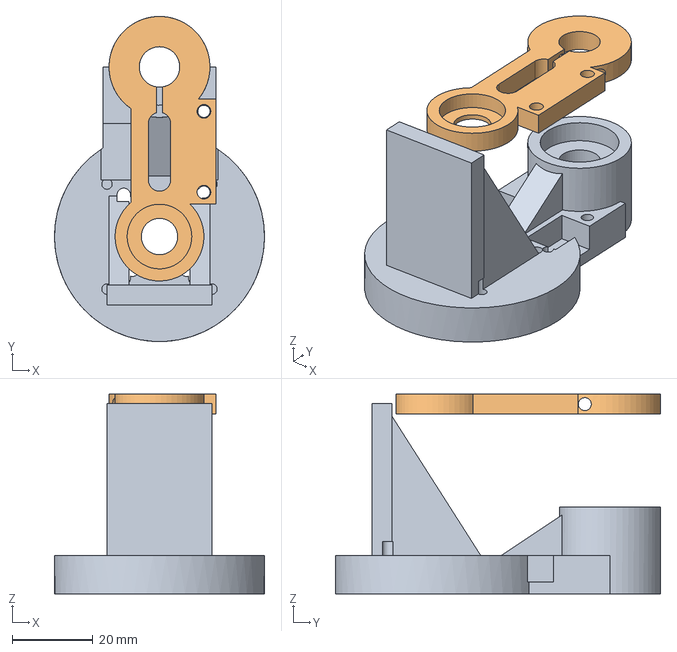
[picture p25: CAD file, 2026-10-16]
cad/manufactured/v10_powertrain_chassis_assembly.step
52.0 x 80.5 x 49.5 mm
