wrbell/dad-ornithopter/cad/manufactured/mco_electronics_bay_assembly.step

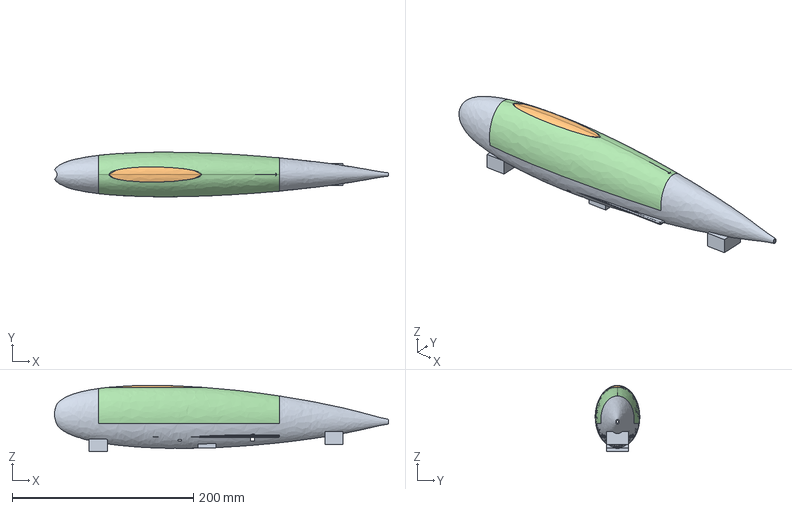
[picture p26: CAD file, 2026-10-16]
cad/manufactured/mco_electronics_bay_assembly.step
368.3 x 49.3 x 73.1 mm
