wrbell/dad-ornithopter/cad/manufactured/mco_fuselage_assembly.step

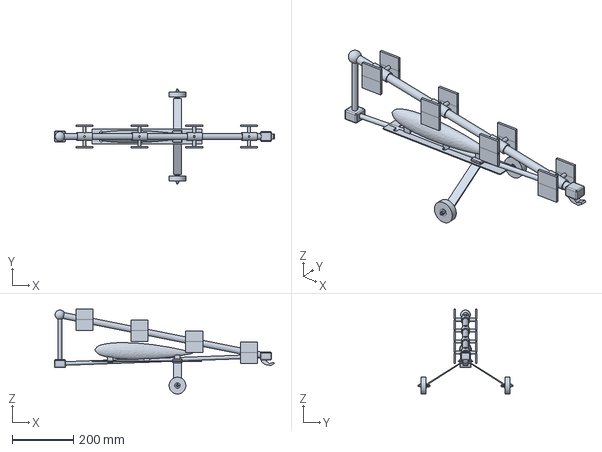
[picture p27: CAD file, 2026-10-16]
cad/manufactured/mco_fuselage_assembly.step
721.0 x 310.0 x 278.2 mm
