wrbell/dad-ornithopter/cad/manufactured/mco_core_one_complete_aircraft.step

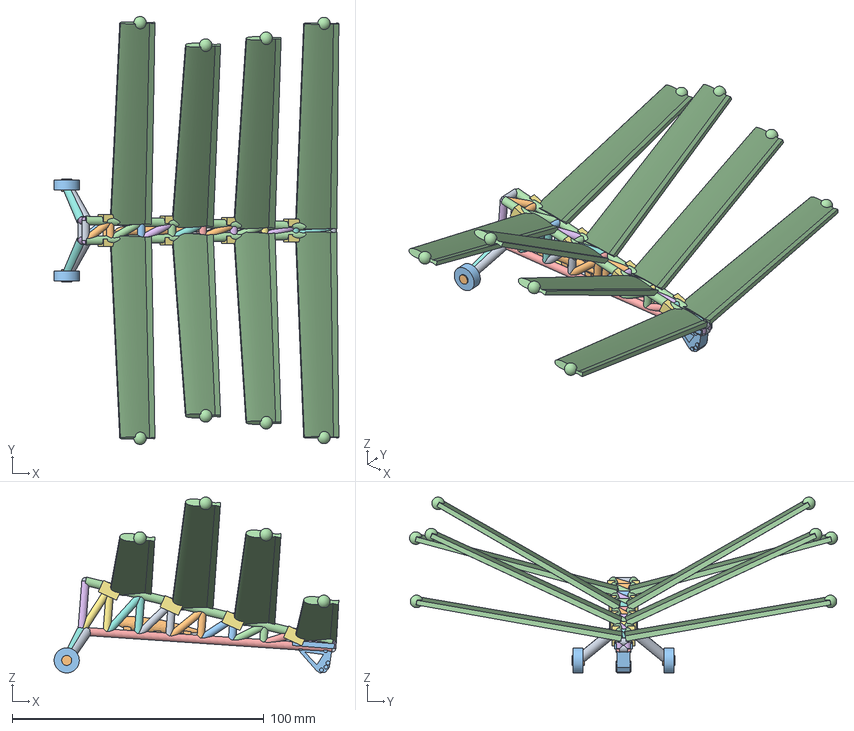
[picture p28: CAD file, 2026-09-30]
cad/manufactured/mco_core_one_complete_aircraft.step
113.0 x 169.9 x 69.8 mm
