wrbell/dad-ornithopter/cad/manufactured/mco_complete_8wing_aircraft.step

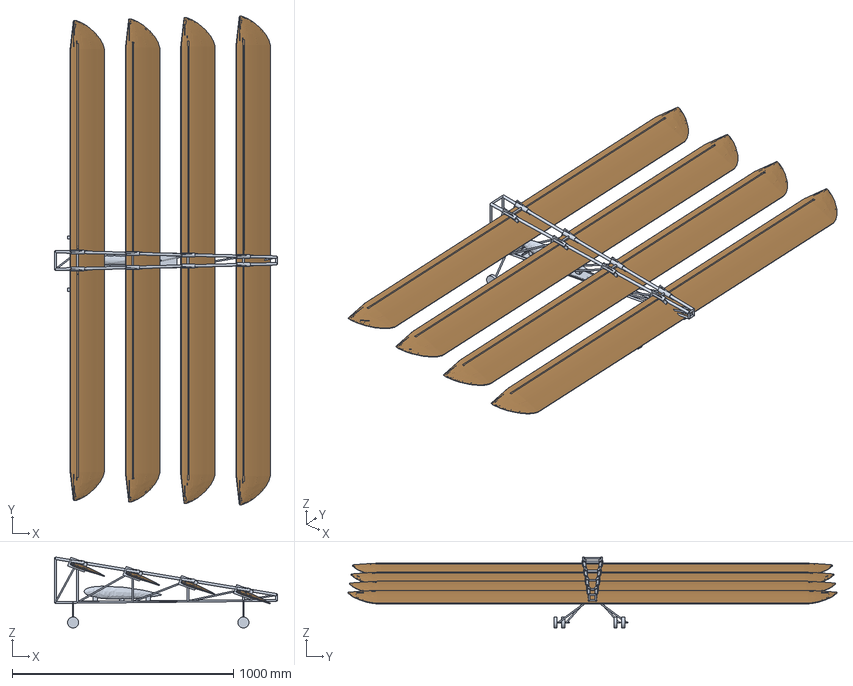
[picture p29: CAD file, 2026-09-28]
cad/manufactured/mco_complete_8wing_aircraft.step
1008.0 x 2208.5 x 320.7 mm
