wrbell/dad-ornithopter/cad/manufactured/stepped_capstan_complete_assembly.stl

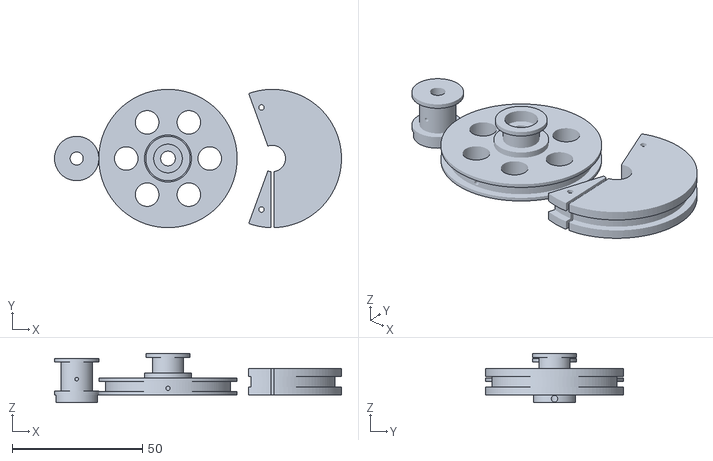
[picture p30: CAD file, 2026-09-28]
cad/manufactured/stepped_capstan_complete_assembly.stl
110.0 x 53.0 x 18.9
