wrbell/dad-ornithopter/cad/bread_stamps/Option_C_PISTR_MICHAELAE_with_handle.stl

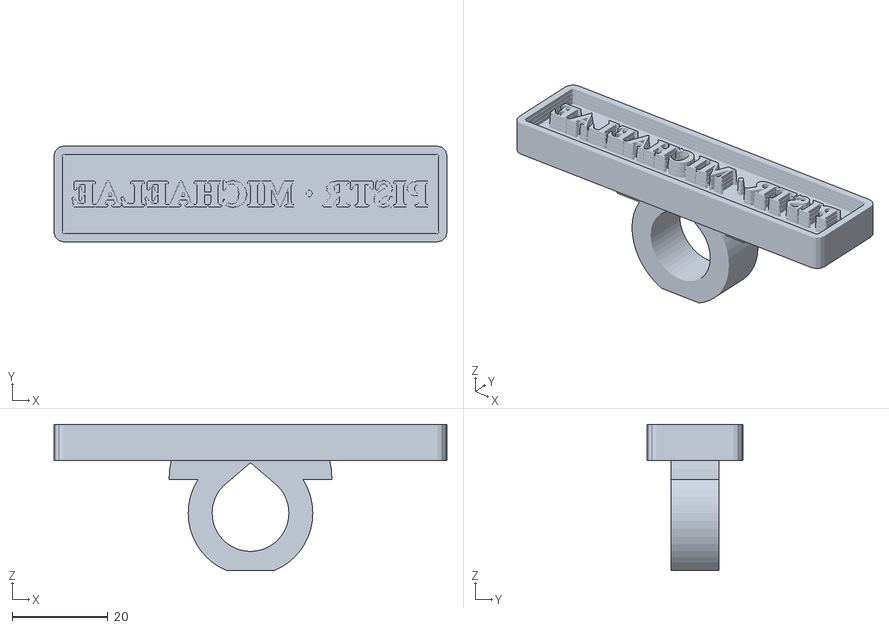
[picture p31: CAD file, 2026-09-28]
cad/bread_stamps/Option_C_PISTR_MICHAELAE_with_handle.stl
82.0 x 20.0 x 30.5
