wrbell/dad-ornithopter/cad/reference/lego/lego_minifigure_seated.stl

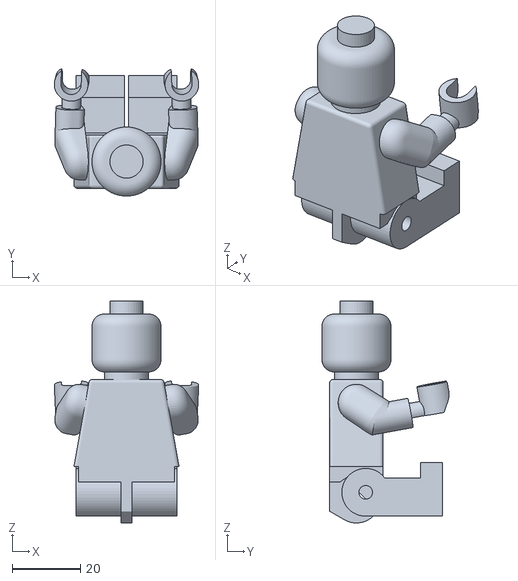
[picture p32: CAD file, 2026-10-16]
cad/reference/lego/lego_minifigure_seated.stl
42.4 x 37.3 x 65.1
