wrbell/dad-ornithopter/cad/S1223-IL Airfoil - 165mm - V1.STEP

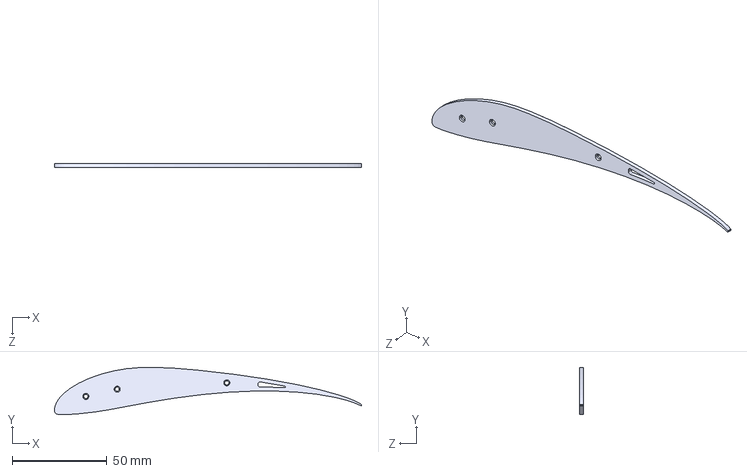
[picture p33: CAD file, 2026-09-28]
cad/S1223-IL Airfoil - 165mm - V1.STEP
161.7 x 24.9 x 2.00 mm
