wrbell/dad-ornithopter/cad/wrist/01_Motor__gear_v8.stl

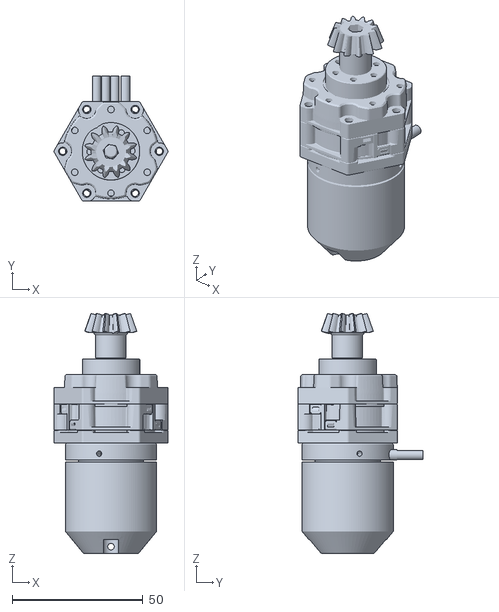
[picture p34: CAD file, 2026-10-16]
cad/wrist/01_Motor__gear_v8.stl
43.6 x 47.8 x 91.8
