wrbell/dad-ornithopter/cad/bread_stamps/English_MICHELLES_KITCHEN_with_handle.stl

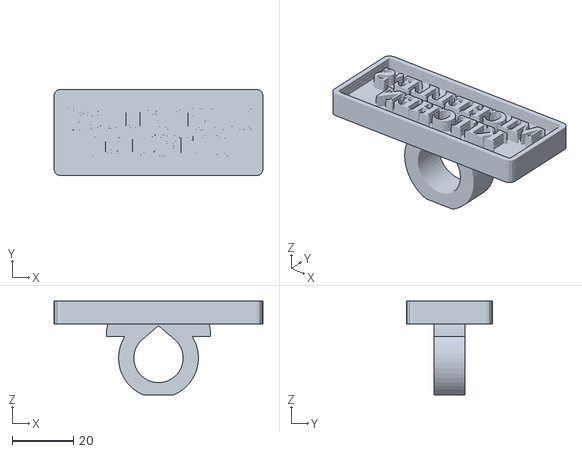
[picture p35: CAD file, 2026-09-28]
cad/bread_stamps/English_MICHELLES_KITCHEN_with_handle.stl
68.0 x 28.0 x 30.5
