wrbell/dad-ornithopter/cad/reference/lego/lego_minifigure_1to1_scale.stl

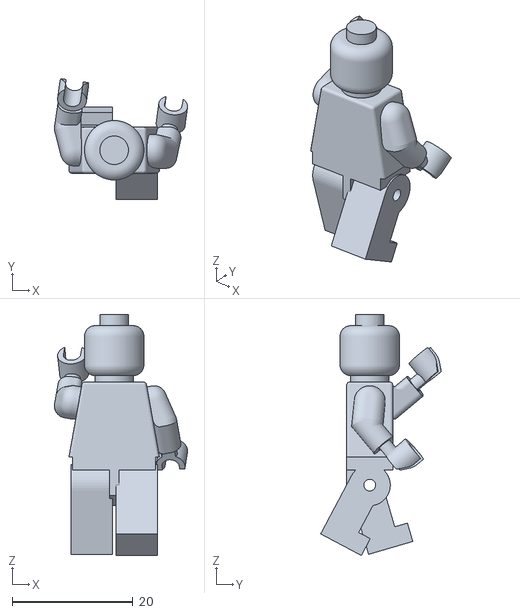
[picture p36: CAD file, 2026-10-16]
cad/reference/lego/lego_minifigure_1to1_scale.stl
22.1 x 20.0 x 40.0
