wrbell/dad-ornithopter/cad/S1223-IL Airfoil Mount - 165mm - V2.STEP

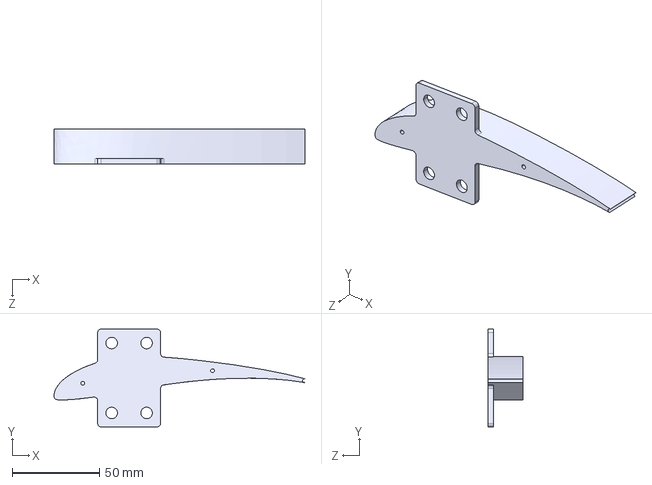
[picture p37: CAD file, 2026-09-28]
cad/S1223-IL Airfoil Mount - 165mm - V2.STEP
143.7 x 56.0 x 20.0 mm
