wrbell/dad-ornithopter/cad/bread_stamps/Option_D_MICHAELA_FECIT_with_handle.stl

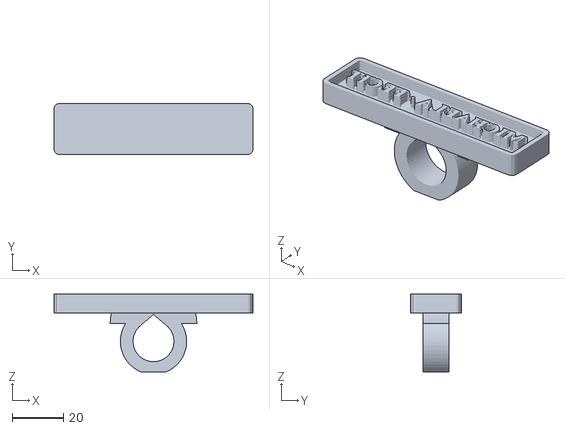
[picture p38: CAD file, 2026-09-28]
cad/bread_stamps/Option_D_MICHAELA_FECIT_with_handle.stl
78.0 x 20.0 x 30.5
