wrbell/dad-ornithopter/cad/reference/lego/lego_minifigure.stl

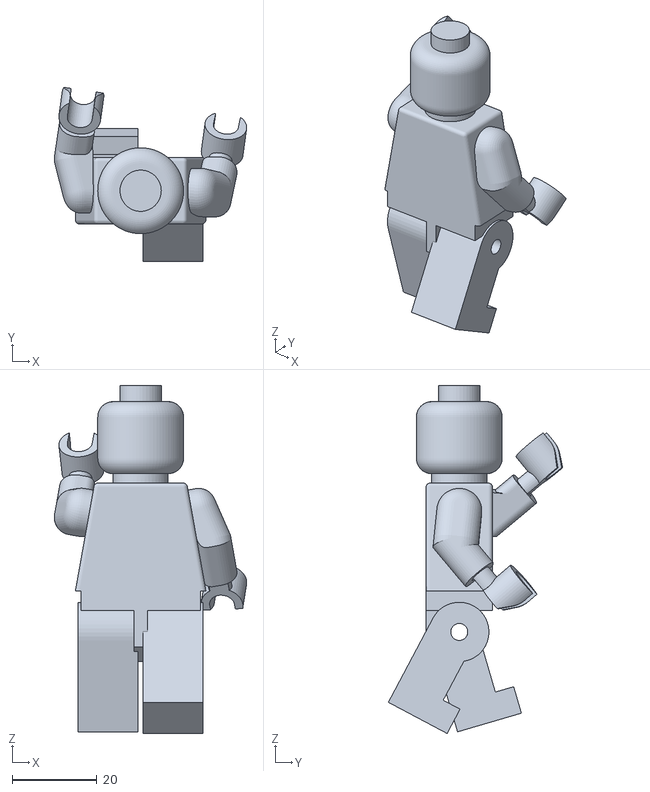
[picture p39: CAD file, 2026-10-16]
cad/reference/lego/lego_minifigure.stl
45.4 x 41.1 x 82.1
