wrbell/dad-ornithopter/cad/wrist/03_New_update_bearings_v28.stl

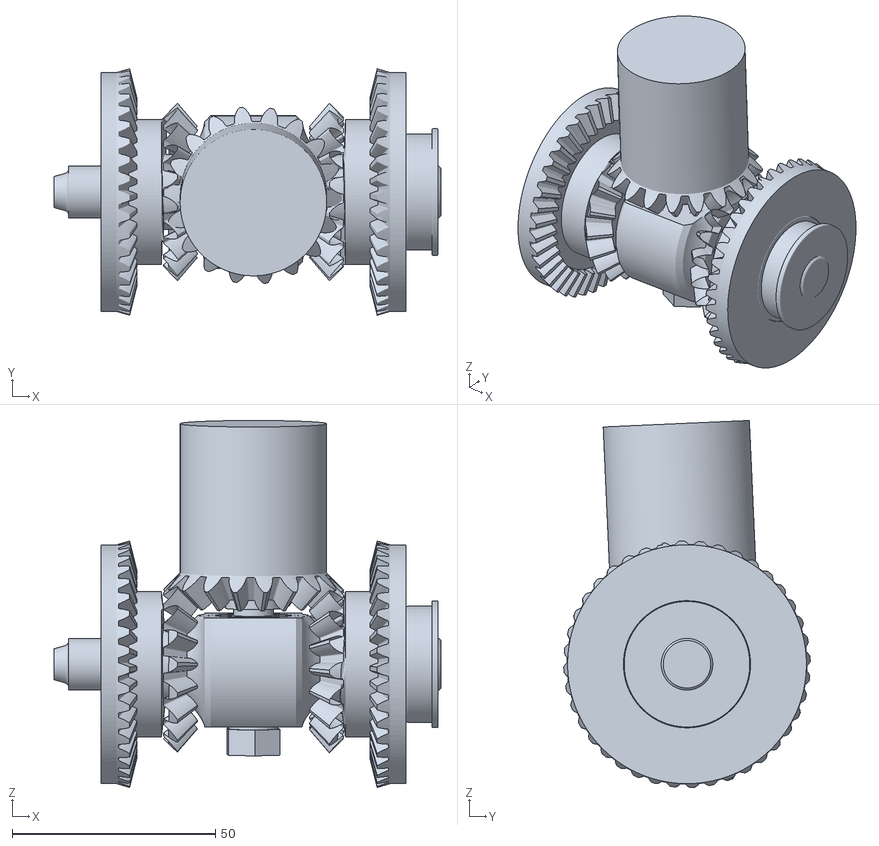
[picture p40: CAD file, 2026-10-16]
cad/wrist/03_New_update_bearings_v28.stl
95.2 x 60.6 x 90.3
