wrbell/dad-ornithopter/cad/bread_stamps/Option_D_2Line_MICHAELA_FECIT_flat_back.stl

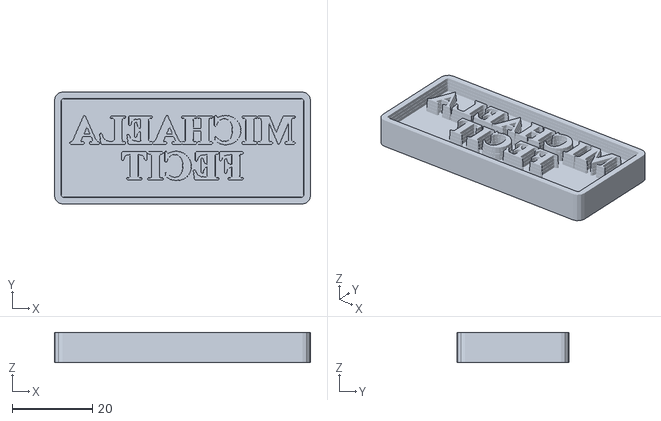
[picture p41: CAD file, 2026-09-28]
cad/bread_stamps/Option_D_2Line_MICHAELA_FECIT_flat_back.stl
64.0 x 28.0 x 7.50
