wrbell/dad-ornithopter/cad/reference/lego/lego_minifigure_seated_1to1_scale.stl

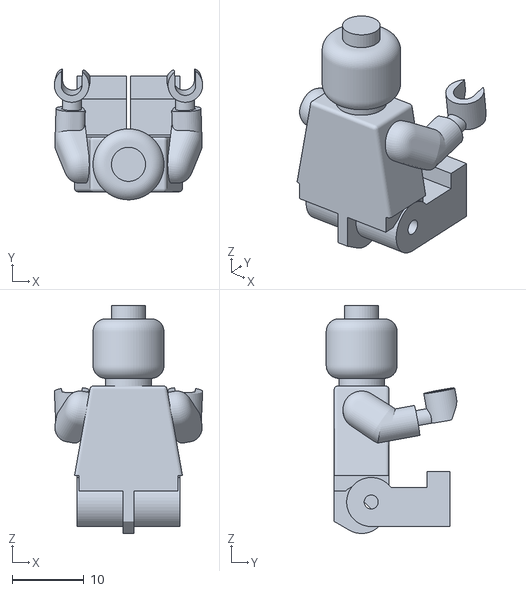
[picture p42: CAD file, 2026-10-16]
cad/reference/lego/lego_minifigure_seated_1to1_scale.stl
20.6 x 18.2 x 31.7
