wrbell/dad-ornithopter/cad/wrist/00_Bottom_Piece_v1_v1.stl

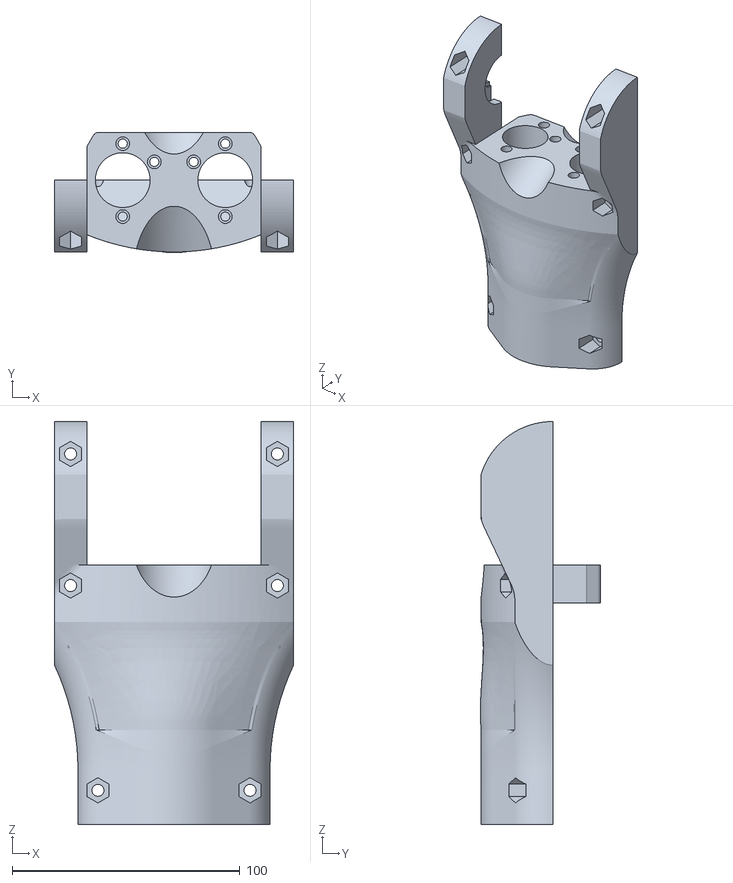
[picture p43: CAD file, 2026-10-16]
cad/wrist/00_Bottom_Piece_v1_v1.stl
105.0 x 52.9 x 176.8
