wrbell/dad-ornithopter/cad/bread_stamps/Option_D_MICHAELA_FECIT_flat_back.stl

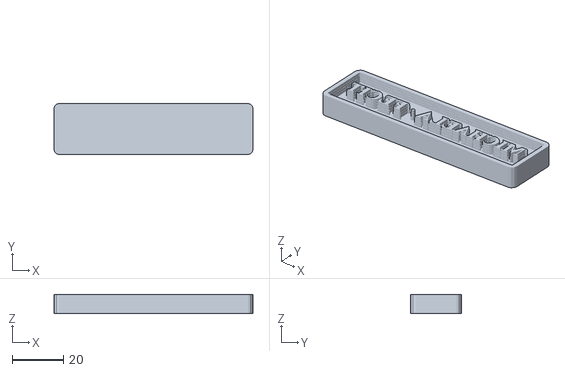
[picture p44: CAD file, 2026-09-28]
cad/bread_stamps/Option_D_MICHAELA_FECIT_flat_back.stl
78.0 x 20.0 x 7.50
