wrbell/dad-ornithopter/cad/wrist/06_Magnet_v1.stl

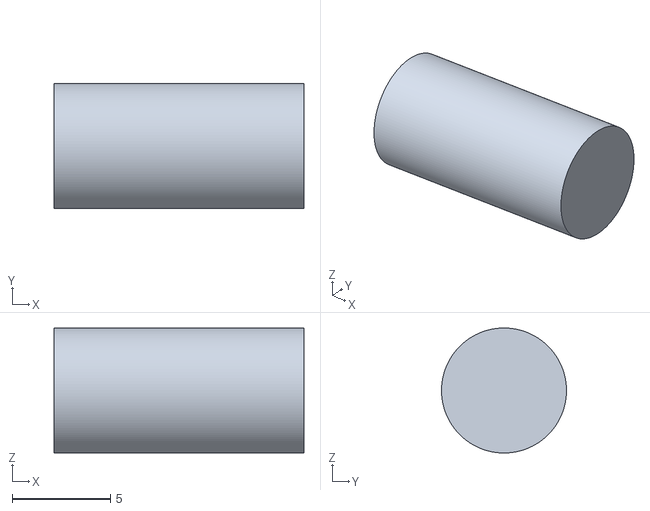
[picture p45: CAD file, 2026-10-16]
cad/wrist/06_Magnet_v1.stl
12.7 x 6.35 x 6.35
