wrbell/dad-ornithopter/cad/bread_stamps/Option_D_2Line_MICHAELA_FECIT_with_handle.stl

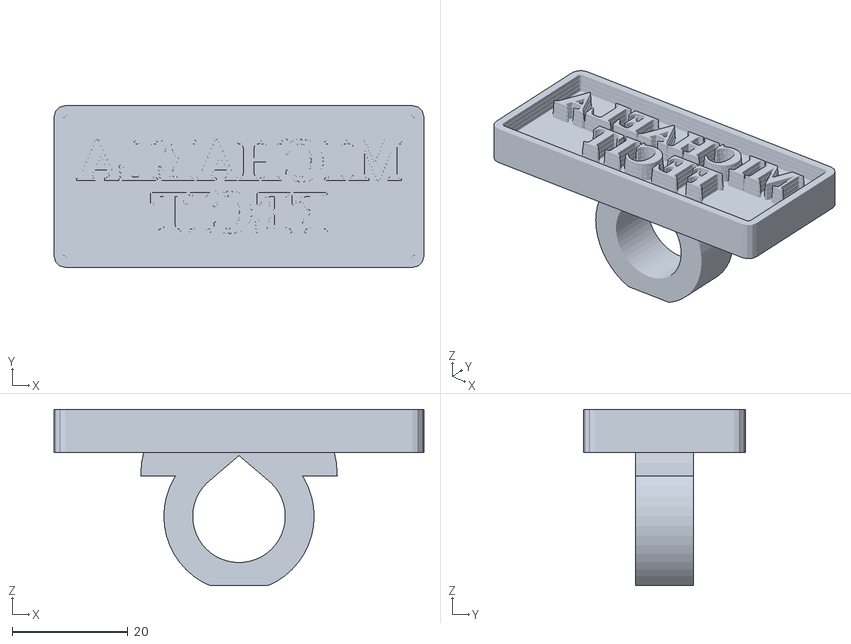
[picture p46: CAD file, 2026-09-28]
cad/bread_stamps/Option_D_2Line_MICHAELA_FECIT_with_handle.stl
64.0 x 28.0 x 30.5
