wrbell/dad-ornithopter/cad/wrist/04_Top_piece_v1.stl

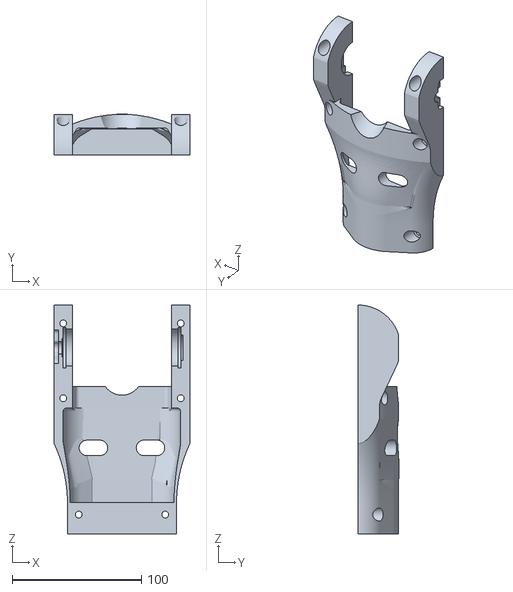
[picture p47: CAD file, 2026-10-16]
cad/wrist/04_Top_piece_v1.stl
105.0 x 31.9 x 176.8
