wrbell/dad-ornithopter/cad/bread_stamps/Option_C_PISTR_MICHAELAE_flat_back.stl

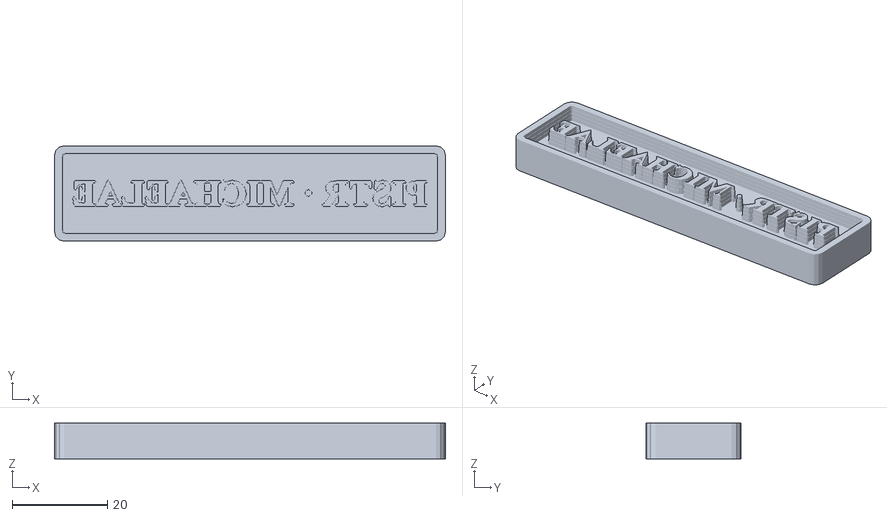
[picture p48: CAD file, 2026-09-28]
cad/bread_stamps/Option_C_PISTR_MICHAELAE_flat_back.stl
82.0 x 20.0 x 7.50
