wrbell/dad-ornithopter/cad/wrist/05_Thrifty_Bot_Absolute_Magnetic_Encoder_v4.stl

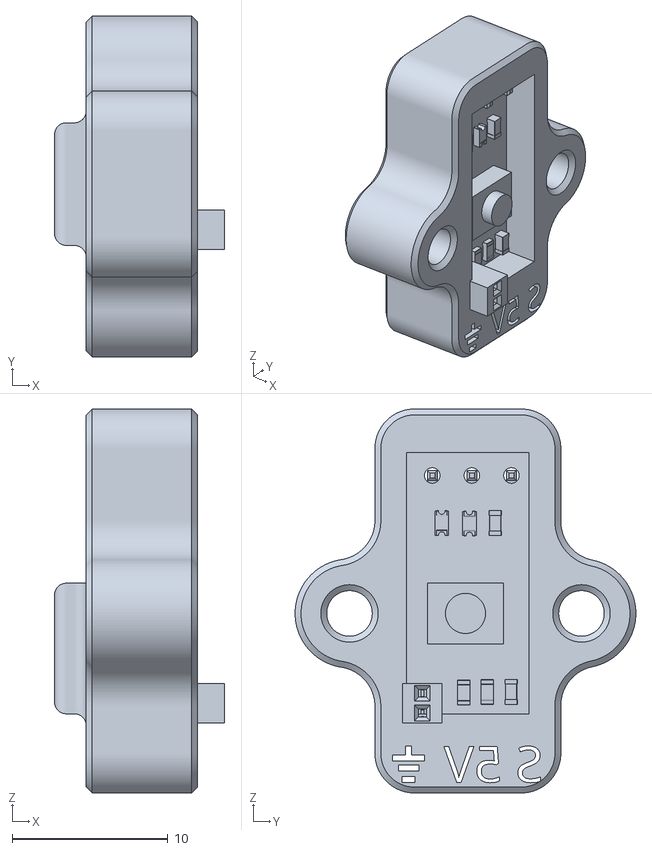
[picture p49: CAD file, 2026-10-16]
cad/wrist/05_Thrifty_Bot_Absolute_Magnetic_Encoder_v4.stl
10.9 x 21.9 x 24.6
