wrbell/dad-ornithopter/cad/bread_stamps/English_MICHELLES_KITCHEN_flat_back.stl

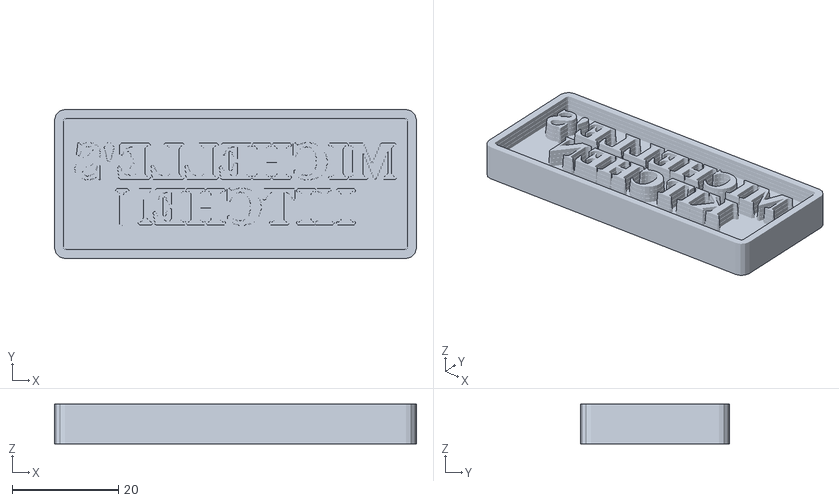
[picture p50: CAD file, 2026-09-28]
cad/bread_stamps/English_MICHELLES_KITCHEN_flat_back.stl
68.0 x 28.0 x 7.50
