wrbell/dad-ornithopter/cad/manufactured/mco_corner2_bot_fwd_clamp.step

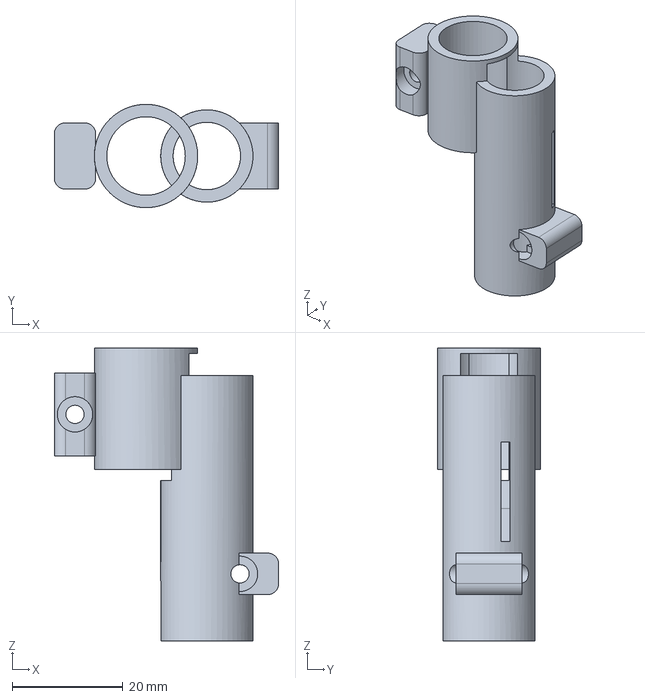
[picture p51: CAD file, 2026-10-16]
cad/manufactured/mco_corner2_bot_fwd_clamp.step
40.6 x 18.7 x 53.0 mm
