wrbell/dad-ornithopter/cad/manufactured/mco_corner1_top_fwd_clamp.step

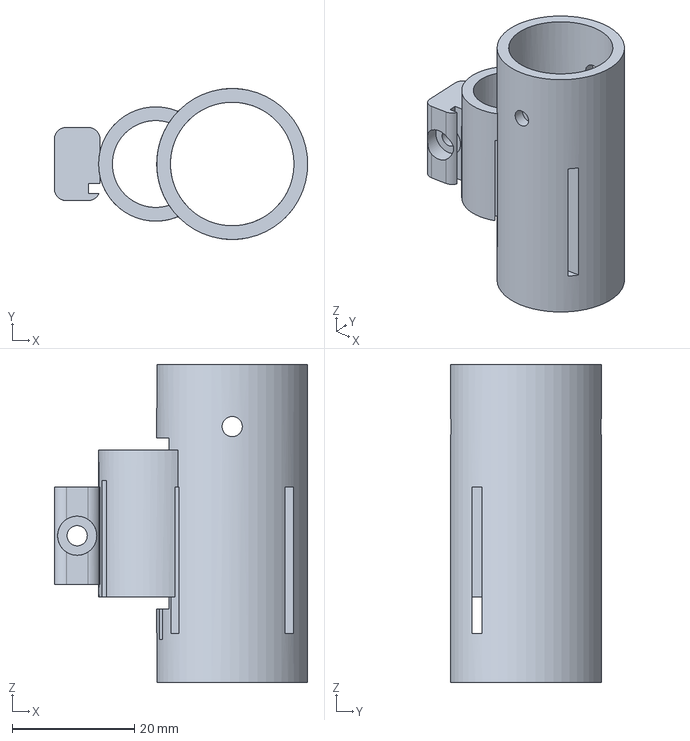
[picture p52: CAD file, 2026-10-16]
cad/manufactured/mco_corner1_top_fwd_clamp.step
41.5 x 24.7 x 52.0 mm
