wrbell/dad-ornithopter/cad/manufactured/sd7062_wing_segment_25cm_starboard_2.4mm.step

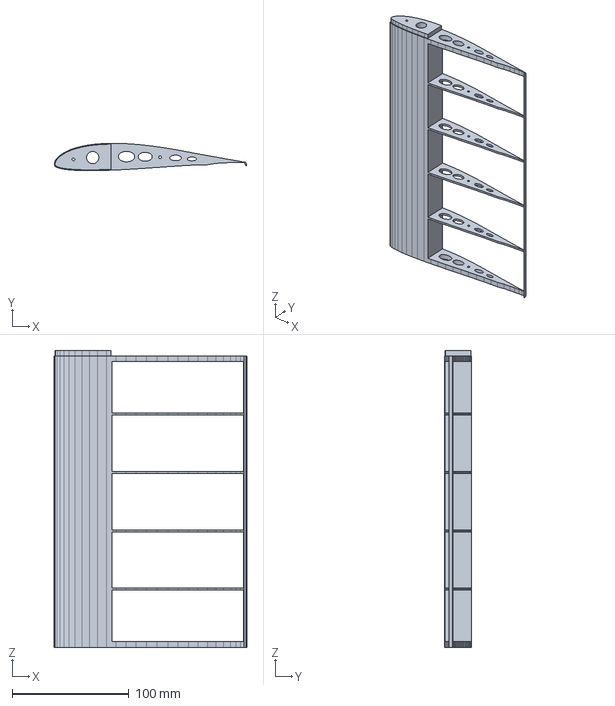
[picture p53: CAD file, 2026-10-16]
cad/manufactured/sd7062_wing_segment_25cm_starboard_2.4mm.step
165.0 x 23.5 x 254.5 mm
