wrbell/dad-ornithopter/cad/manufactured/v10_powertrain_stand.step

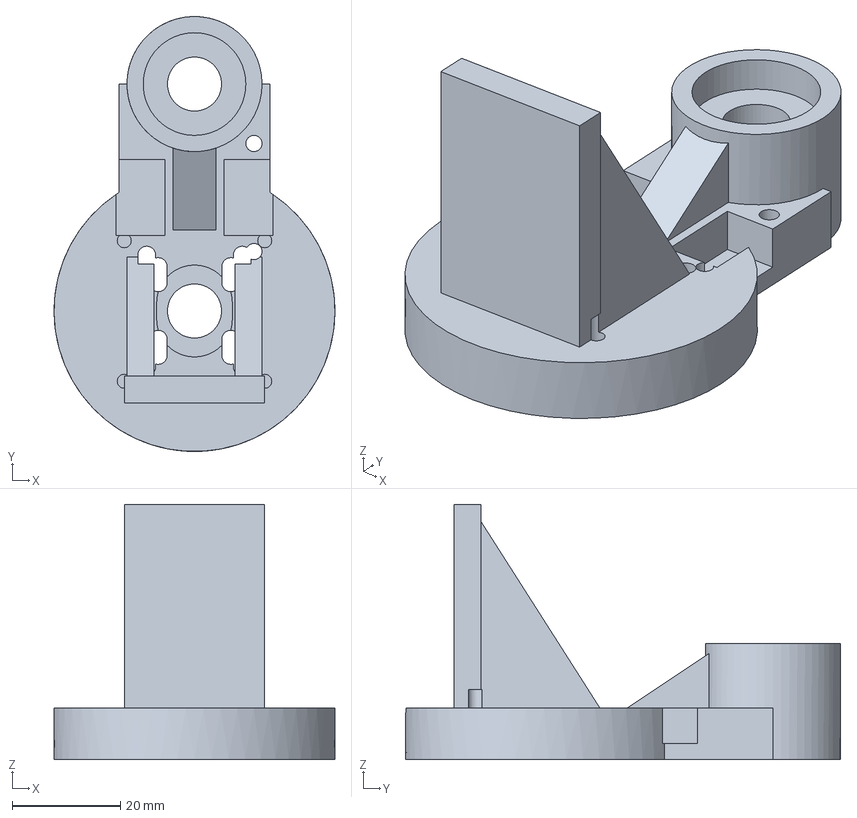
[picture p54: CAD file, 2026-10-16]
cad/manufactured/v10_powertrain_stand.step
52.0 x 80.5 x 47.2 mm
