wrbell/dad-ornithopter/cad/manufactured/v9_topological_sector_drum.stl

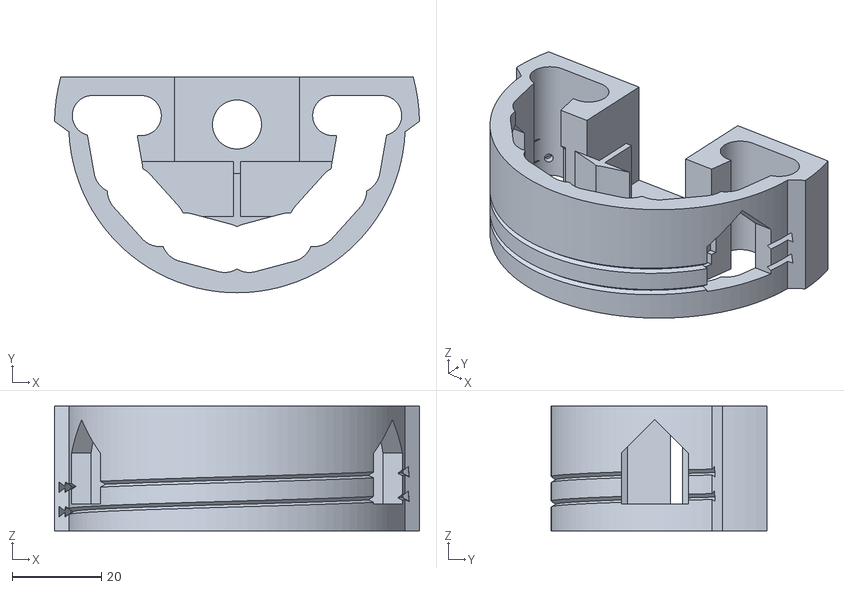
[picture p55: CAD file, 2026-10-16]
cad/manufactured/v9_topological_sector_drum.stl
82.0 x 48.4 x 28.0
