wrbell/dad-ornithopter/cad/manufactured/sd7062_airfoil_mount_port_2.4mm.step

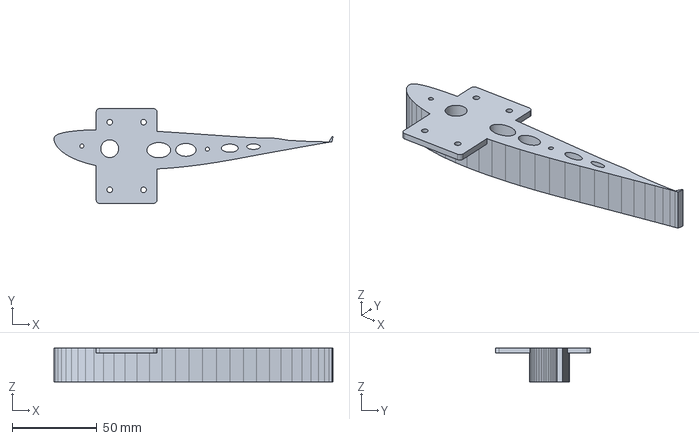
[picture p56: CAD file, 2026-10-16]
cad/manufactured/sd7062_airfoil_mount_port_2.4mm.step
165.0 x 56.0 x 20.0 mm
