wrbell/dad-ornithopter/cad/manufactured/sd7062_wing_joint_coupler_2.4mm.step

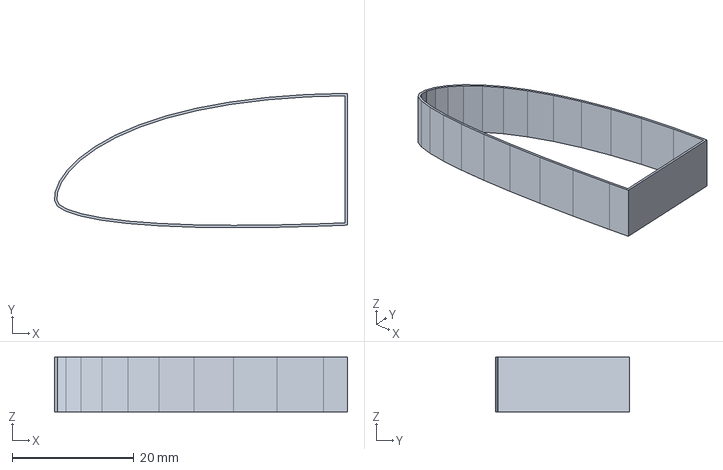
[picture p57: CAD file, 2026-10-16]
cad/manufactured/sd7062_wing_joint_coupler_2.4mm.step
48.0 x 22.0 x 9.00 mm
