wrbell/dad-ornithopter/cad/manufactured/v9_topological_fairing.step

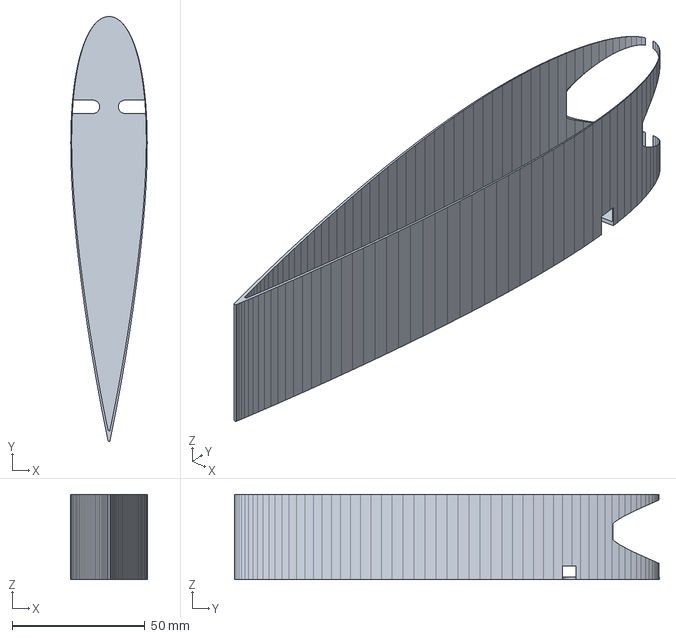
[picture p58: CAD file, 2026-10-16]
cad/manufactured/v9_topological_fairing.step
28.8 x 160.0 x 32.0 mm
