wrbell/dad-ornithopter/cad/manufactured/sd7062_wing_rib_lightened_165mm.stl

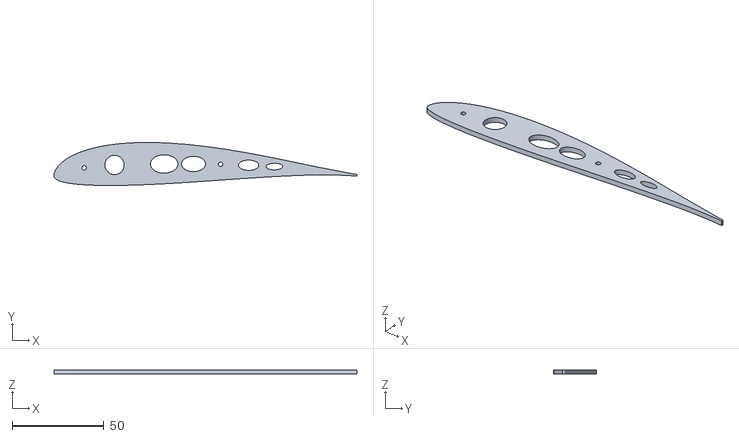
[picture p59: CAD file, 2026-10-16]
cad/manufactured/sd7062_wing_rib_lightened_165mm.stl
165.0 x 23.5 x 2.40
