wrbell/dad-ornithopter/cad/manufactured/mco_corner3_aft_tail_clamp.step

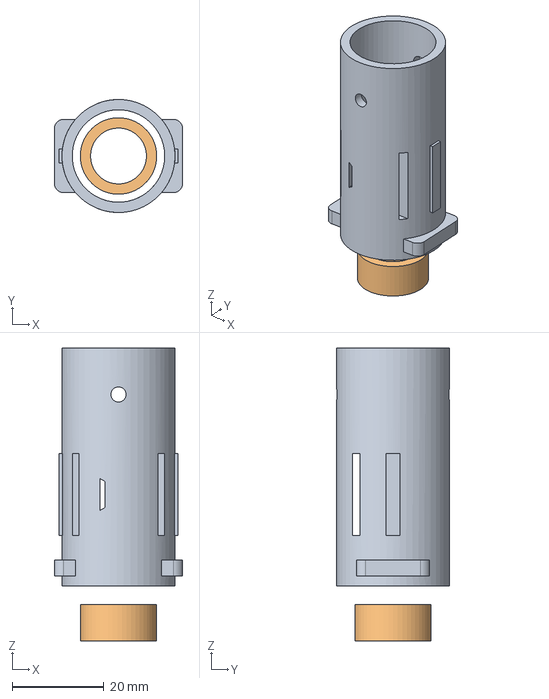
[picture p60: CAD file, 2026-10-16]
cad/manufactured/mco_corner3_aft_tail_clamp.step
28.0 x 24.7 x 64.0 mm
