wrbell/dad-ornithopter/cad/manufactured/sd7062_wing_rib_165mm.step

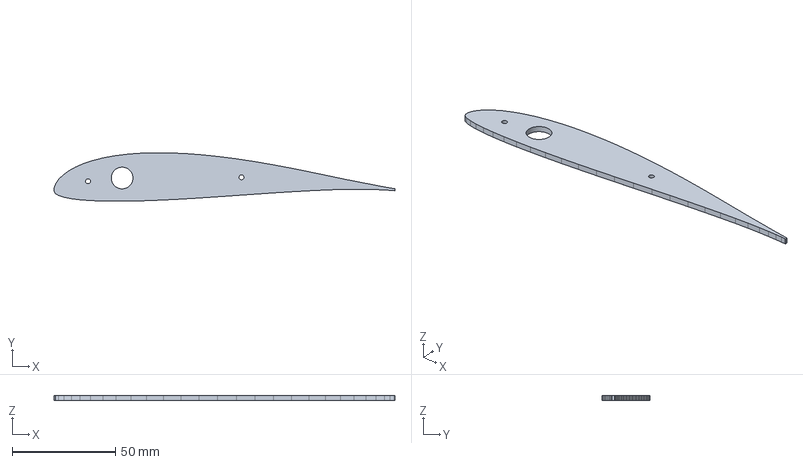
[picture p61: CAD file, 2026-10-16]
cad/manufactured/sd7062_wing_rib_165mm.step
165.0 x 23.5 x 2.40 mm
