wrbell/dad-ornithopter/cad/manufactured/v10_powertrain_top_brace.step

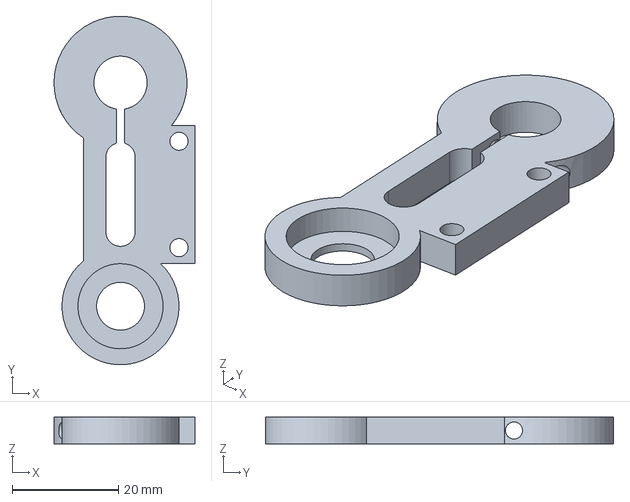
[picture p62: CAD file, 2026-10-16]
cad/manufactured/v10_powertrain_top_brace.step
26.5 x 65.5 x 5.00 mm
