wrbell/dad-ornithopter/cad/manufactured/mco_naca0018_wrist_fairing_lwpla.step

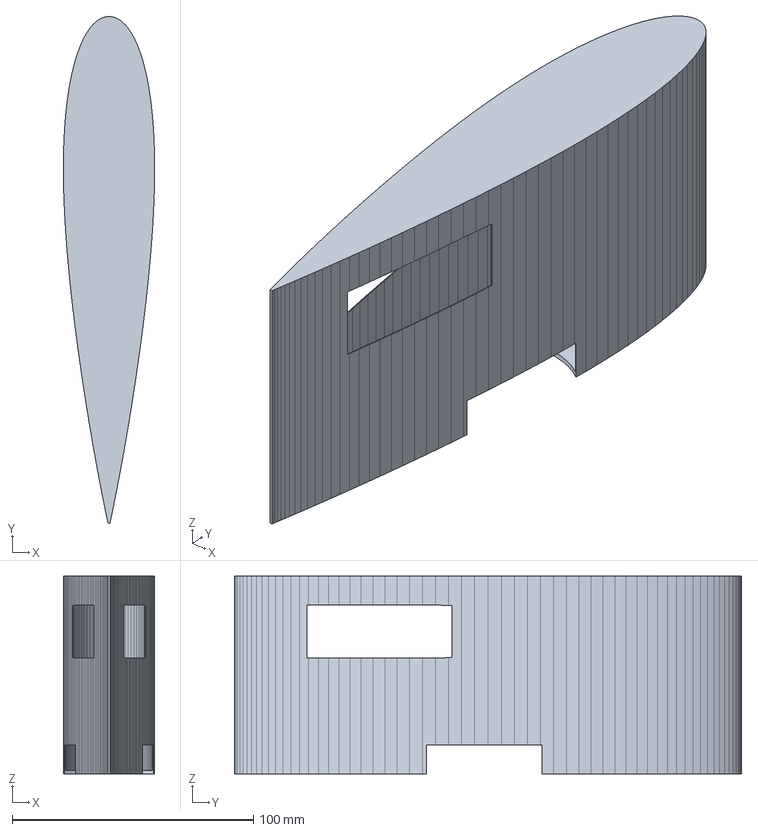
[picture p63: CAD file, 2026-10-16]
cad/manufactured/mco_naca0018_wrist_fairing_lwpla.step
37.8 x 210.0 x 82.0 mm
