wrbell/dad-ornithopter/cad/manufactured/mco_electronics_bay_tub.step

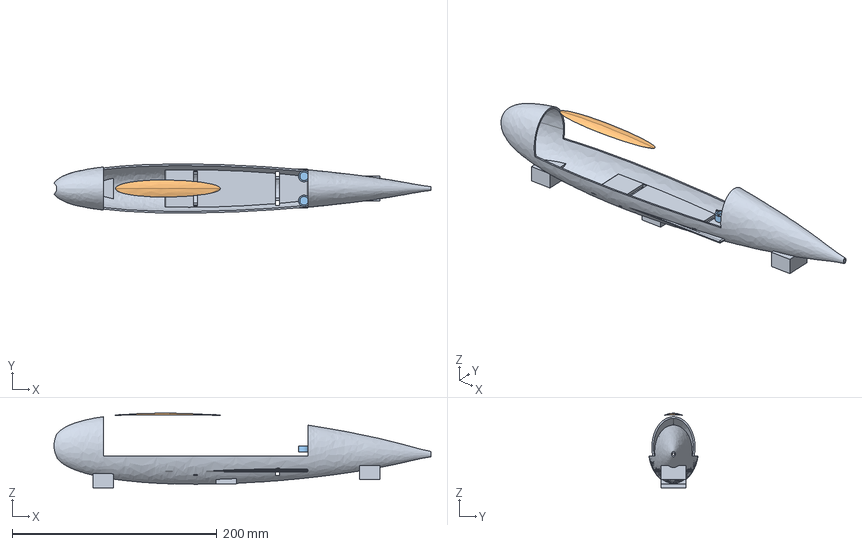
[picture p64: CAD file, 2026-10-16]
cad/manufactured/mco_electronics_bay_tub.step
368.3 x 48.1 x 73.1 mm
