wrbell/dad-ornithopter/cad/manufactured/sd7062_wingtip_smooth_2.4mm.stl

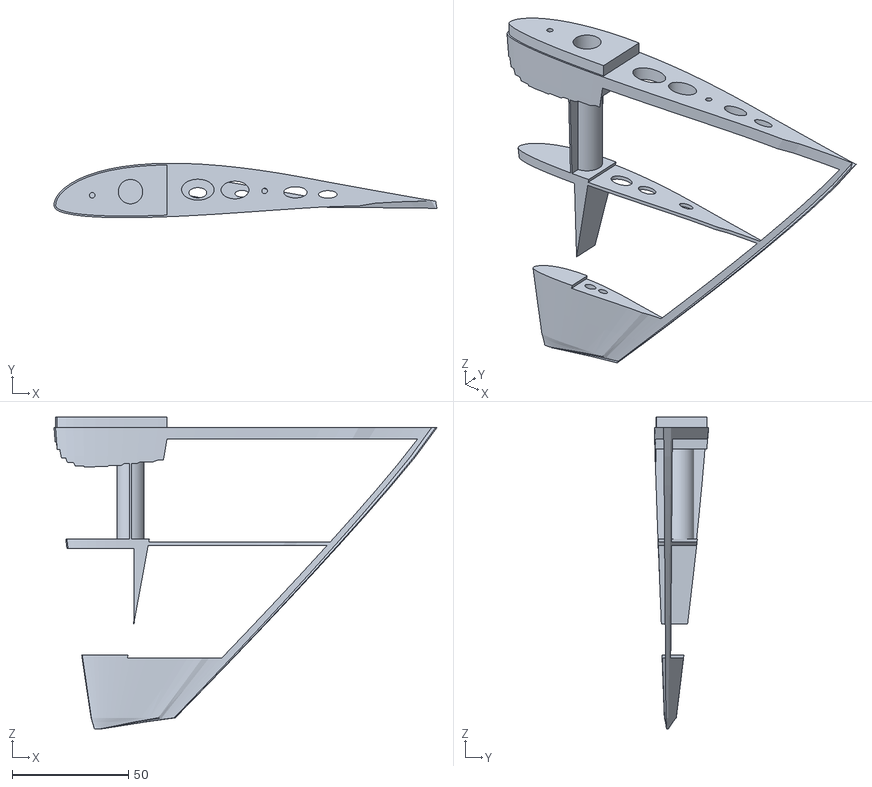
[picture p65: CAD file, 2026-10-16]
cad/manufactured/sd7062_wingtip_smooth_2.4mm.stl
165.0 x 23.5 x 134.2
