wrbell/dad-ornithopter/cad/manufactured/mco_electronics_bay_canopy_hatch.step

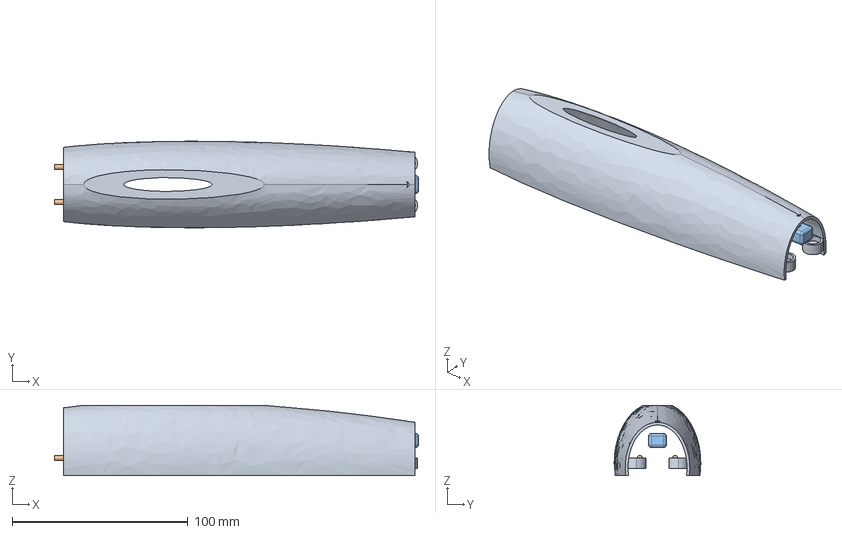
[picture p66: CAD file, 2026-10-16]
cad/manufactured/mco_electronics_bay_canopy_hatch.step
207.0 x 49.3 x 40.0 mm
