wrbell/dad-ornithopter/cad/manufactured/v9_topological_merged_core.stl

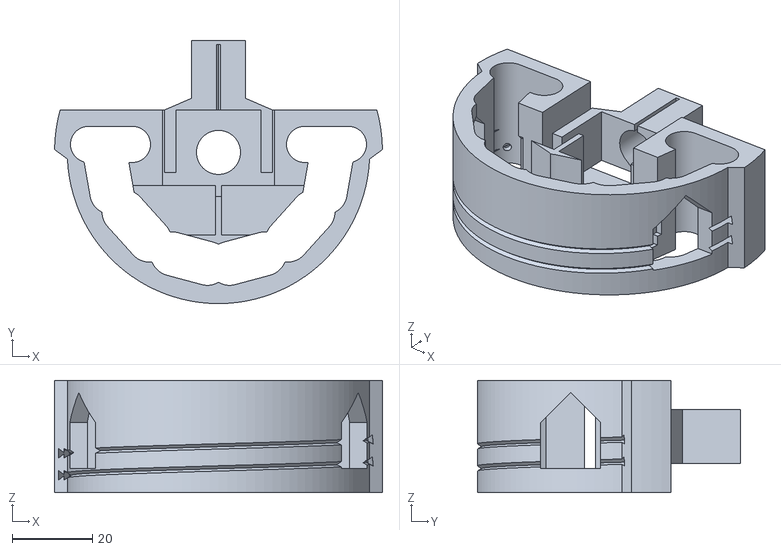
[picture p67: CAD file, 2026-10-16]
cad/manufactured/v9_topological_merged_core.stl
82.0 x 65.8 x 28.0
