wrbell/dad-ornithopter/cad/manufactured/v9_actuation_yoke.step

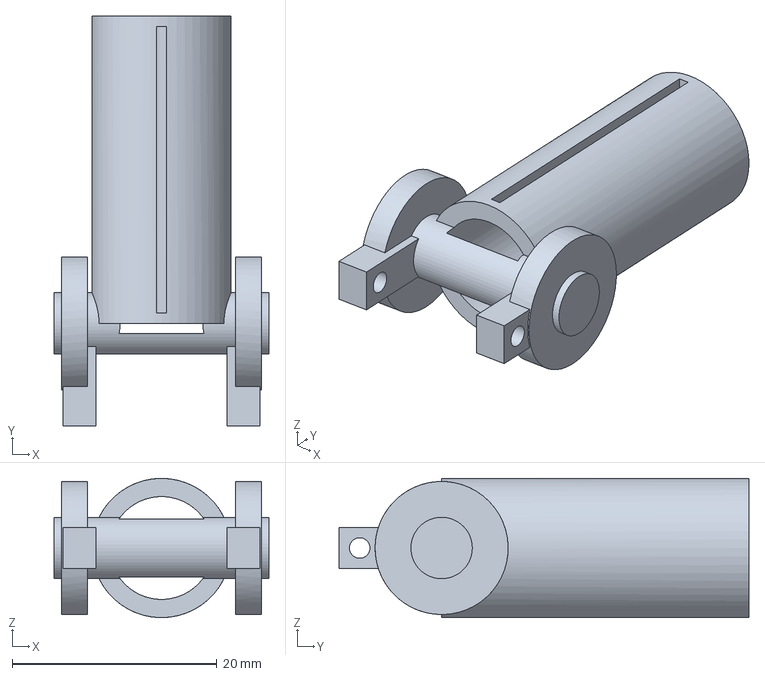
[picture p68: CAD file, 2026-10-16]
cad/manufactured/v9_actuation_yoke.step
21.0 x 40.0 x 13.6 mm
