wrbell/dad-ornithopter/cad/manufactured/mco_topological_wing_collar_v1.step

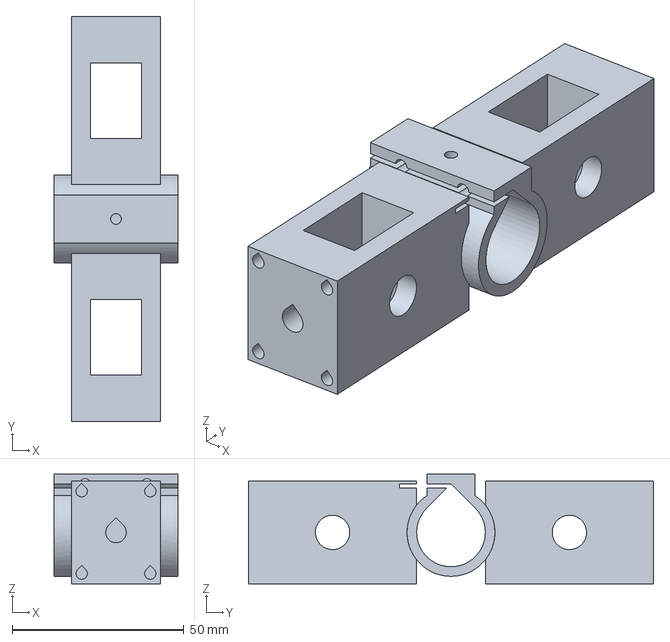
[picture p69: CAD file, 2026-10-16]
cad/manufactured/mco_topological_wing_collar_v1.step
36.0 x 118.0 x 32.0 mm
