wrbell/dad-ornithopter/cad/manufactured/mco_core_one_lego_edition.step

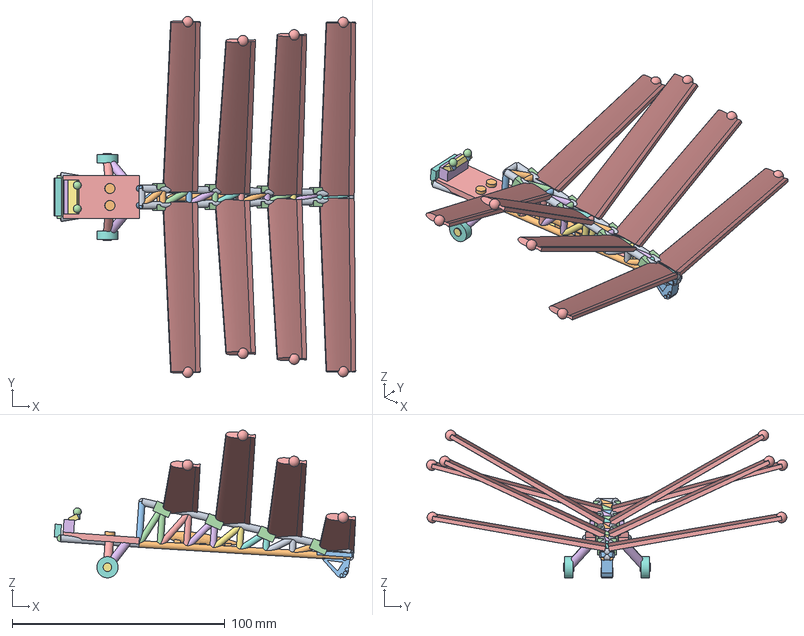
[picture p70: CAD file, 2026-10-16]
cad/manufactured/mco_core_one_lego_edition.step
141.9 x 169.9 x 69.5 mm
