wrbell/dad-ornithopter/cad/manufactured/bearing_6708_annular.stl

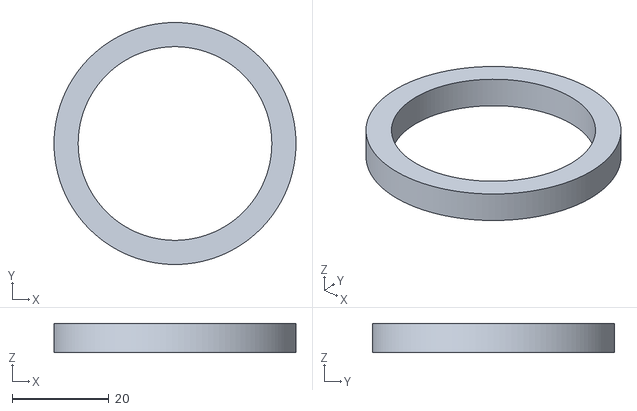
[picture p71: CAD file, 2026-10-16]
cad/manufactured/bearing_6708_annular.stl
50.0 x 50.0 x 6.00
