wrbell/dad-ornithopter/cad/manufactured/mco_representative_tailskid.step

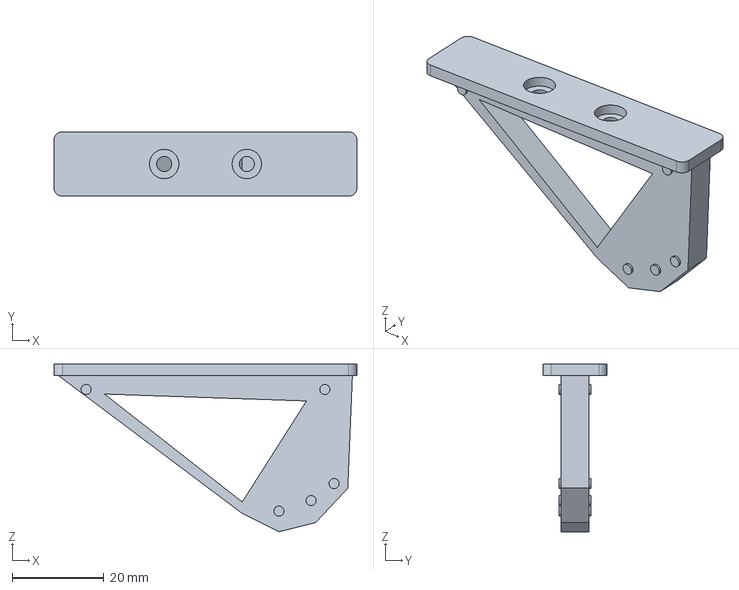
[picture p72: CAD file, 2026-10-16]
cad/manufactured/mco_representative_tailskid.step
66.0 x 14.0 x 36.5 mm
