wrbell/dad-ornithopter/cad/manufactured/v9_topological_spar.stl

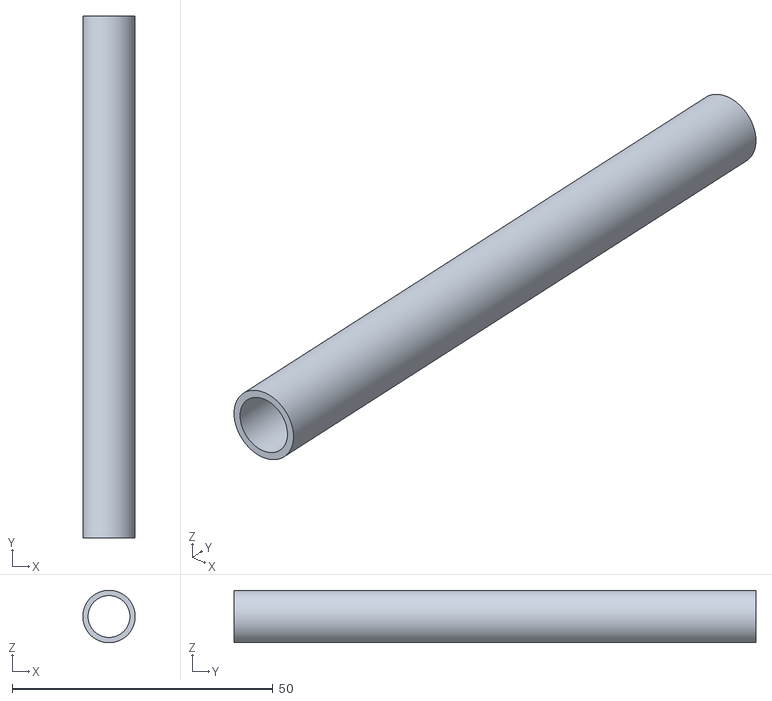
[picture p73: CAD file, 2026-10-16]
cad/manufactured/v9_topological_spar.stl
10.1 x 100.0 x 10.0
