wrbell/dad-ornithopter/cad/manufactured/s1223_wingtip_smooth_starboard_2.4mm.step

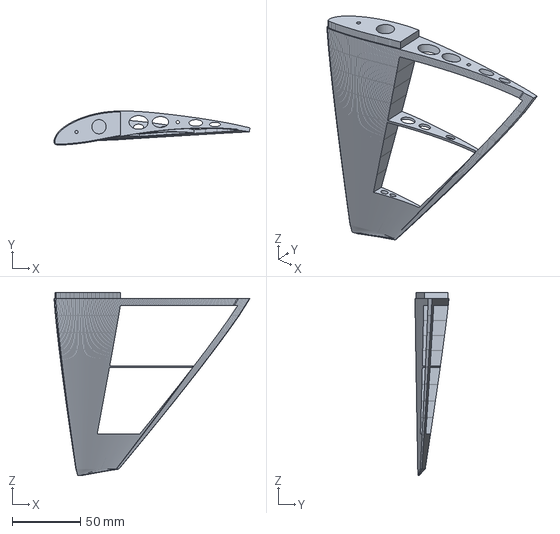
[picture p74: CAD file, 2026-10-03]
cad/manufactured/s1223_wingtip_smooth_starboard_2.4mm.step
143.7 x 24.9 x 134.2 mm
