wrbell/dad-ornithopter/cad/manufactured/s1223_starboard_25acm_segment_2.4mm.step

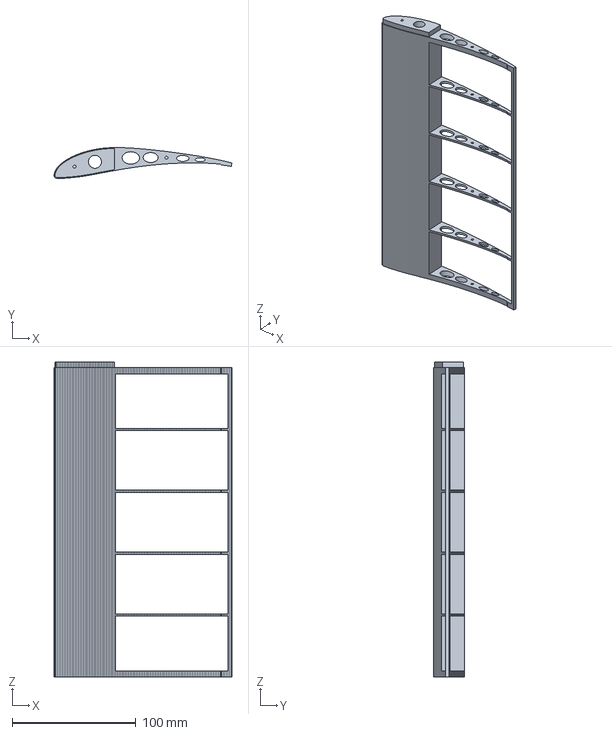
[picture p75: CAD file, 2026-10-03]
cad/manufactured/s1223_starboard_25acm_segment_2.4mm.step
143.7 x 24.9 x 254.5 mm
