wrbell/dad-ornithopter/cad/manufactured/s1223_wing_joint_coupler_2.4mm.step

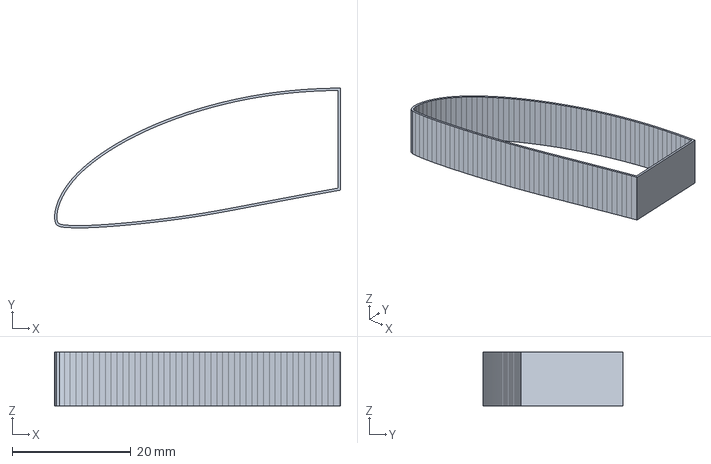
[picture p76: CAD file, 2026-10-03]
cad/manufactured/s1223_wing_joint_coupler_2.4mm.step
48.1 x 23.5 x 9.00 mm
