wrbell/dad-ornithopter/cad/manufactured/s1223_vortex_raked_wingtip_165mm_port.stl

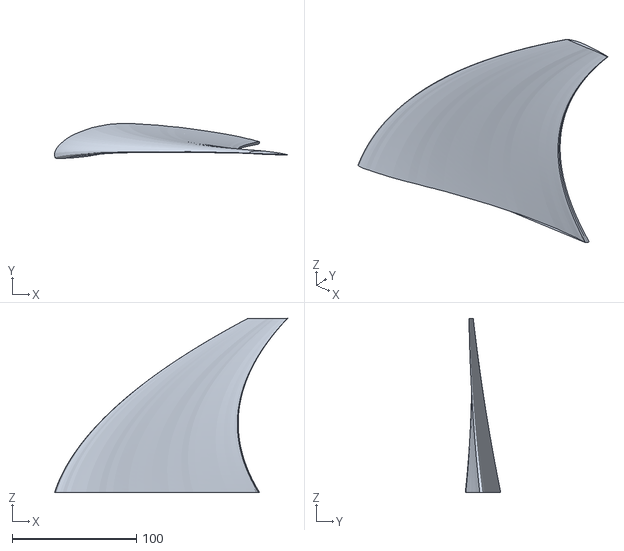
[picture p77: CAD file, 2026-09-28]
cad/manufactured/s1223_vortex_raked_wingtip_165mm_port.stl
187.4 x 28.5 x 140.0
