wrbell/dad-ornithopter/cad/manufactured/Airbus wingtip Right.3mf

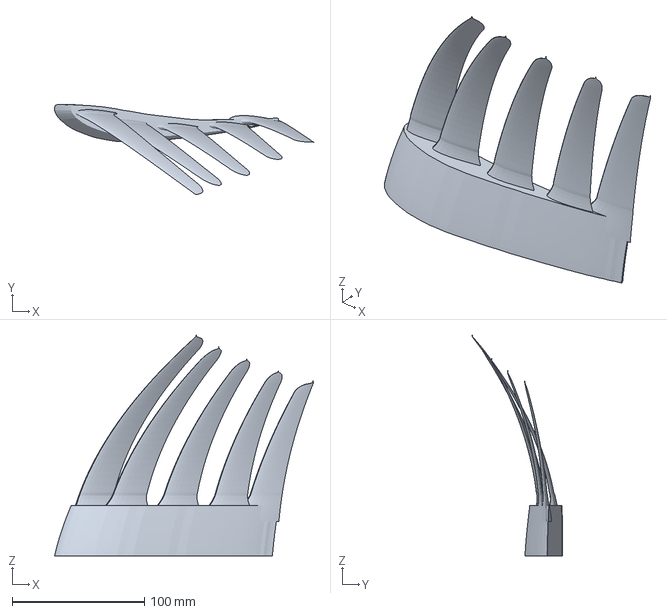
[picture p78: CAD file, 2026-09-28]
cad/manufactured/Airbus wingtip Right.3mf
196.1 x 68.4 x 167.2 mm
