wrbell/dad-ornithopter/cad/manufactured/s1223_vortex_raked_wingtip_starboard.stl

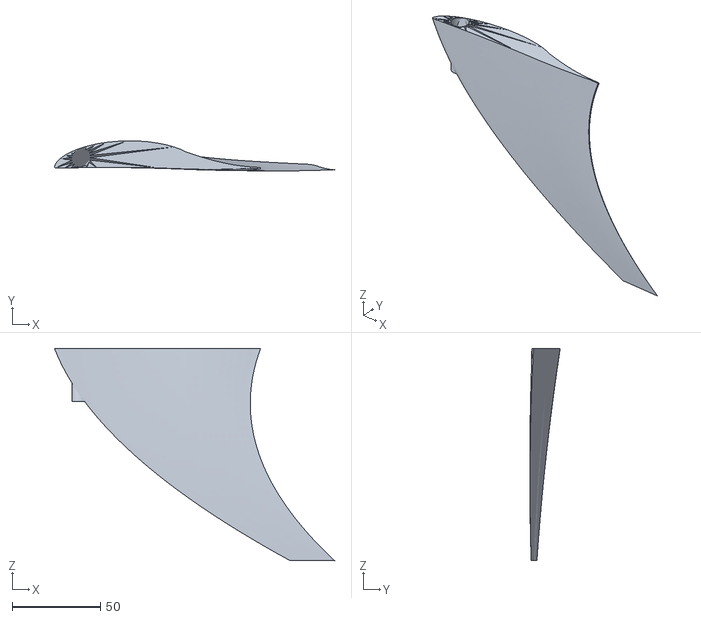
[picture p79: CAD file, 2026-09-28]
cad/manufactured/s1223_vortex_raked_wingtip_starboard.stl
158.4 x 17.2 x 120.0
