wrbell/dad-ornithopter/cad/manufactured/s1223_bird_of_prey_feather_wingtip_starboard.stl

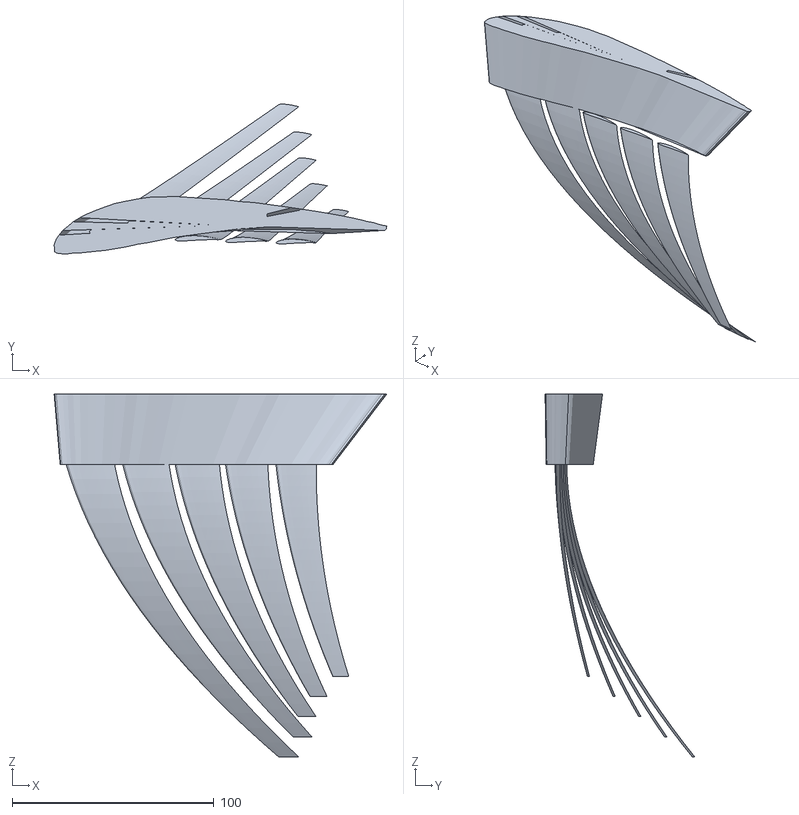
[picture p80: CAD file, 2026-09-28]
cad/manufactured/s1223_bird_of_prey_feather_wingtip_starboard.stl
165.0 x 74.3 x 180.0
