wrbell/dad-ornithopter/cad/manufactured/stepped_capstan_intermediate_pulley.stl

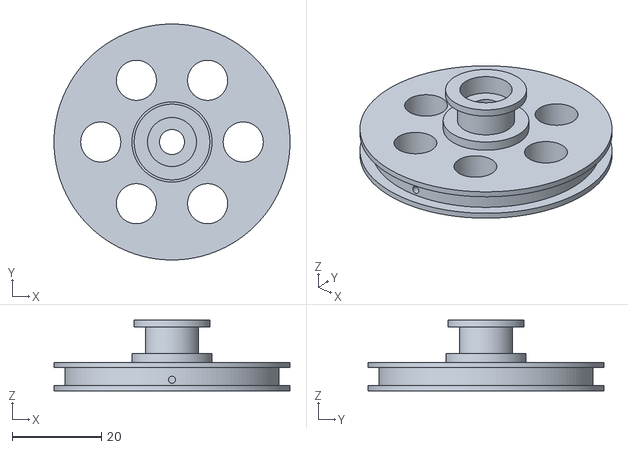
[picture p81: CAD file, 2026-09-28]
cad/manufactured/stepped_capstan_intermediate_pulley.stl
53.0 x 53.0 x 15.9
