wrbell/dad-ornithopter/cad/manufactured/S1223 25cm seg skeleton.3mf

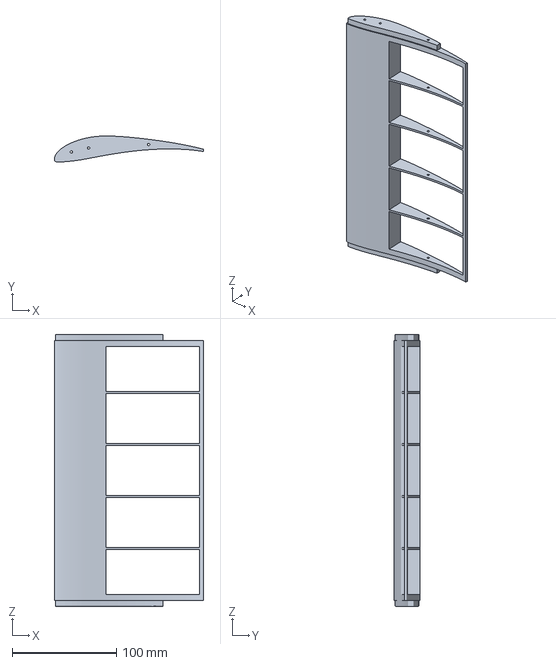
[picture p82: CAD file, 2026-09-28]
cad/manufactured/S1223 25cm seg skeleton.3mf
143.7 x 24.9 x 261.4 mm
