wrbell/dad-ornithopter/cad/manufactured/s1223_optimal_single_wingtip_port.step

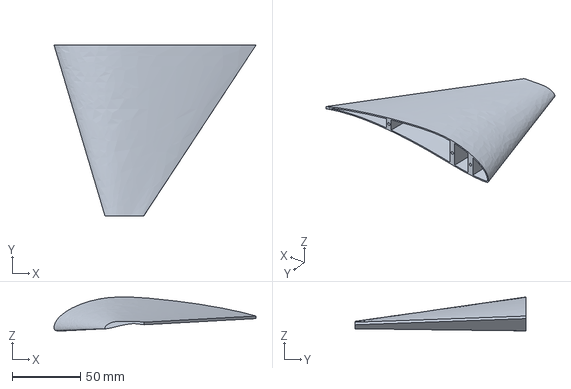
[picture p83: CAD file, 2026-09-28]
cad/manufactured/s1223_optimal_single_wingtip_port.step
148.0 x 125.0 x 24.8 mm
