wrbell/dad-ornithopter/cad/manufactured/s1223_universal_rib_120mm.stl

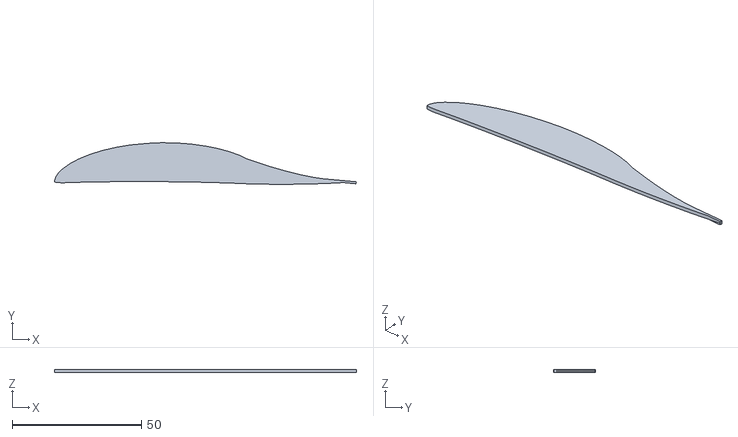
[picture p84: CAD file, 2026-09-28]
cad/manufactured/s1223_universal_rib_120mm.stl
116.6 x 16.1 x 1.20
