wrbell/dad-ornithopter/cad/manufactured/generic_airfoil_wing_starboard.step

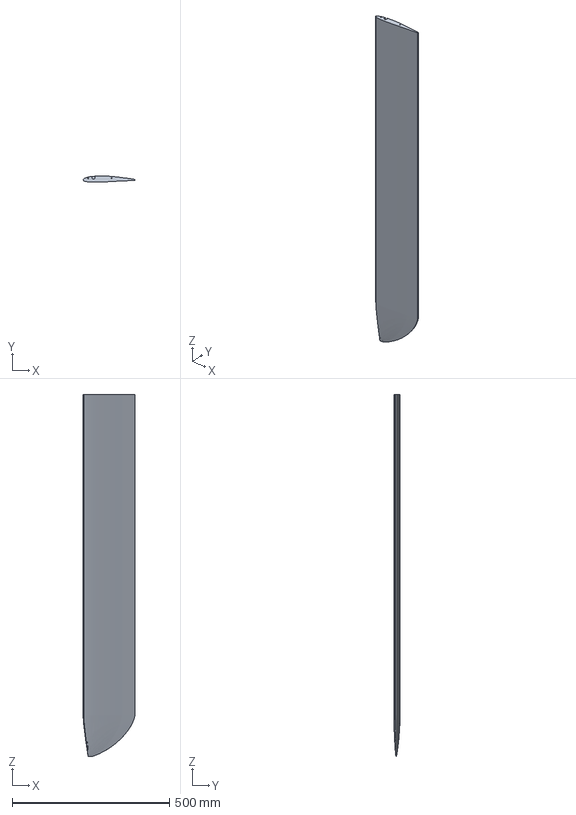
[picture p85: CAD file, 2026-09-28]
cad/manufactured/generic_airfoil_wing_starboard.step
165.0 x 20.1 x 1150.0 mm
