wrbell/dad-ornithopter/cad/manufactured/stepped_capstan_wing_sector_drum.stl

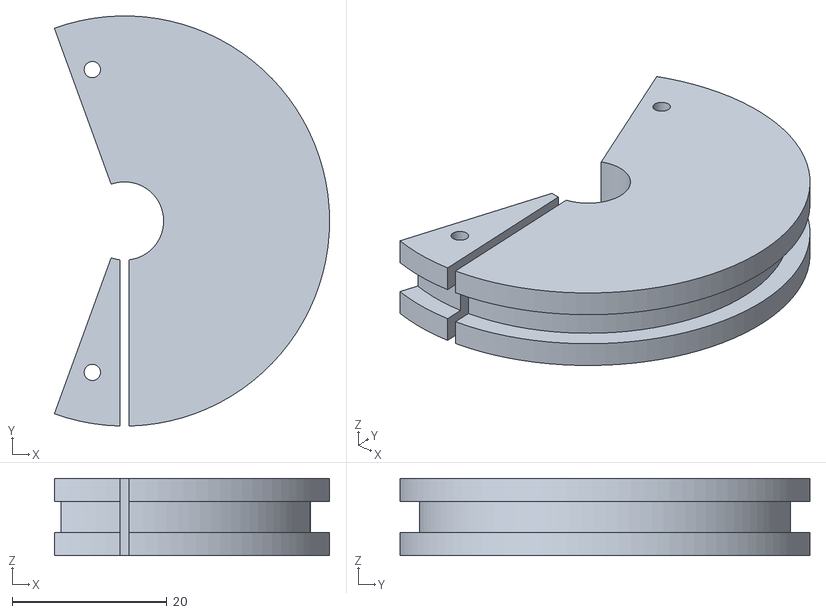
[picture p86: CAD file, 2026-09-28]
cad/manufactured/stepped_capstan_wing_sector_drum.stl
35.6 x 53.0 x 10.0
