wrbell/dad-ornithopter/cad/manufactured/stepped_capstan_motor_pinion.stl

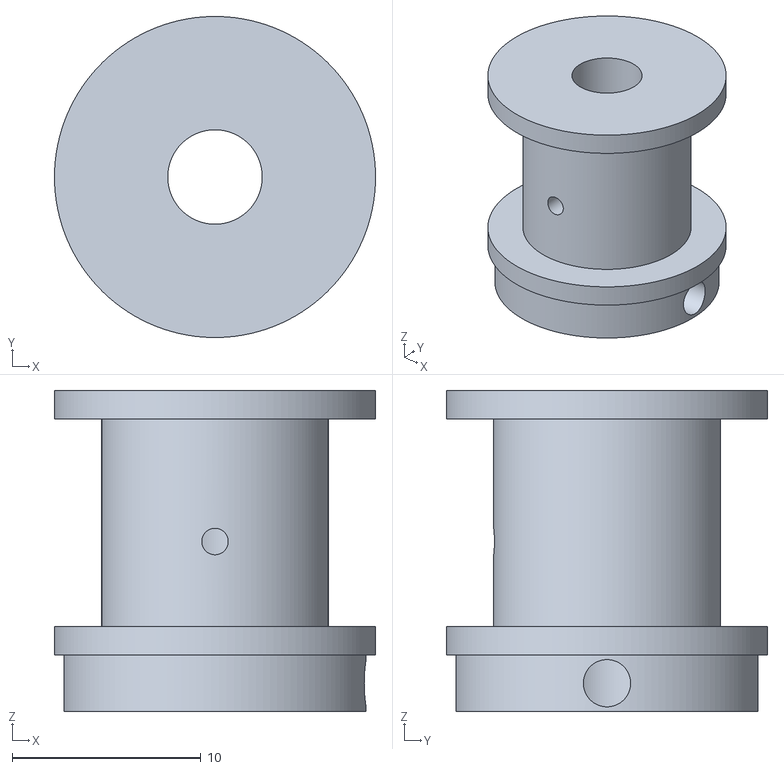
[picture p87: CAD file, 2026-09-28]
cad/manufactured/stepped_capstan_motor_pinion.stl
17.0 x 17.0 x 17.0
