wrbell/dad-ornithopter/cad/manufactured/sector_wheel_7to1_100deg.stl

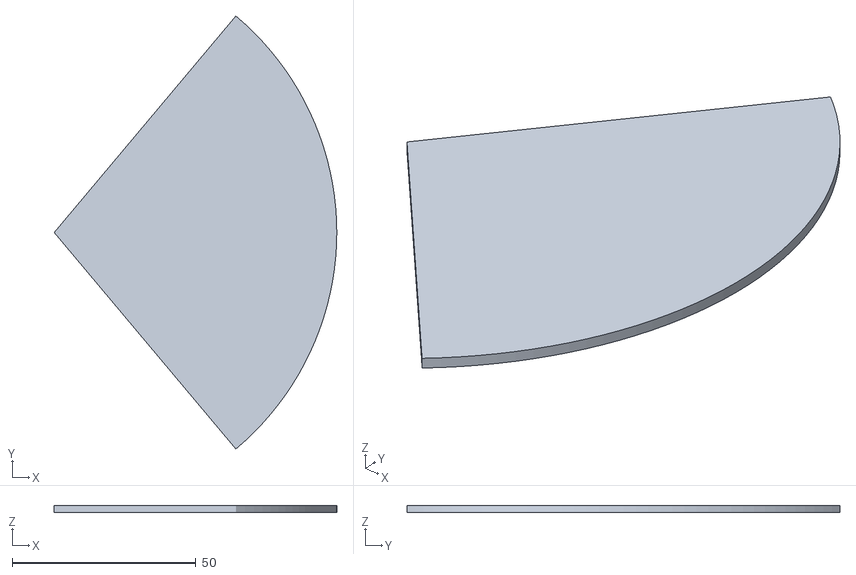
[picture p88: CAD file, 2026-09-28]
cad/manufactured/sector_wheel_7to1_100deg.stl
77.0 x 118.0 x 2.00
