wrbell/dad-ornithopter/cad/manufactured/palm_v2.stl

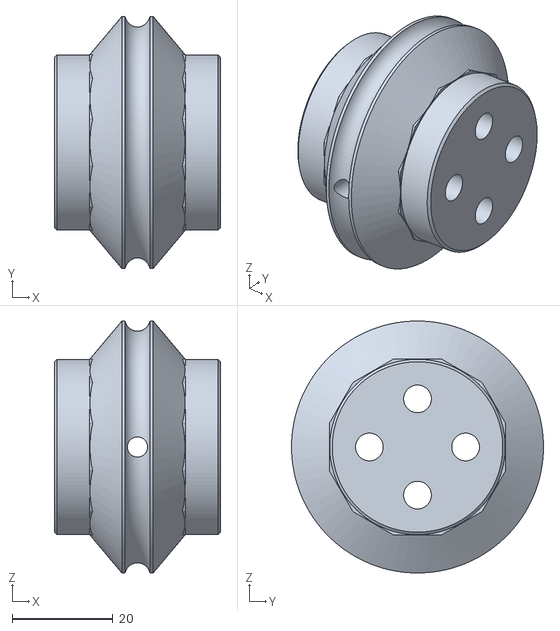
[picture p89: CAD file, 2026-09-28]
cad/manufactured/palm_v2.stl
33.0 x 50.0 x 50.0
