wrbell/dad-ornithopter/cad/manufactured/s1223_wing_segment_10cm_2.4mm_thickskin30.stl

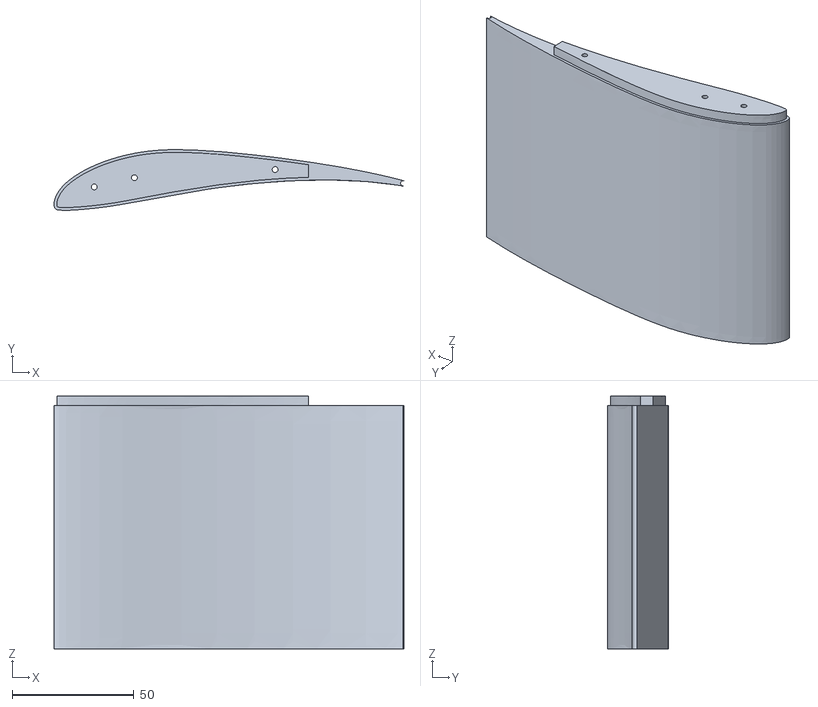
[picture p90: CAD file, 2026-09-28]
cad/manufactured/s1223_wing_segment_10cm_2.4mm_thickskin30.stl
143.7 x 24.9 x 103.8
