wrbell/dad-ornithopter/cad/manufactured/s1223_dbox_modifier_30pct.stl

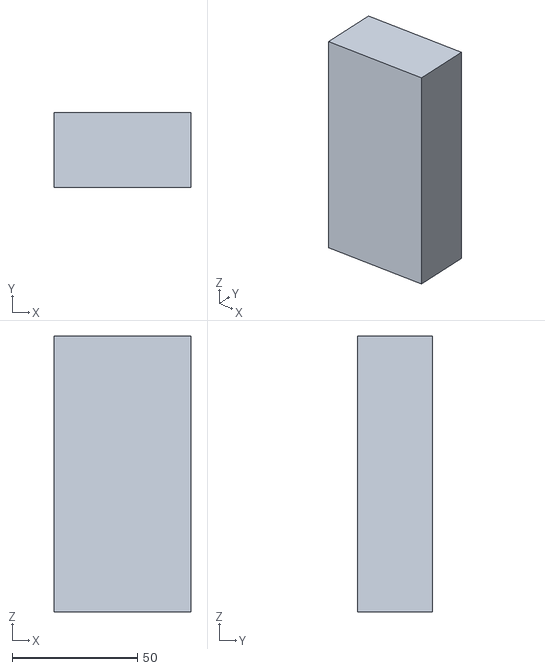
[picture p91: CAD file, 2026-09-28]
cad/manufactured/s1223_dbox_modifier_30pct.stl
54.5 x 30.0 x 110.0
