wrbell/dad-ornithopter/cad/manufactured/test_mount_through.stl

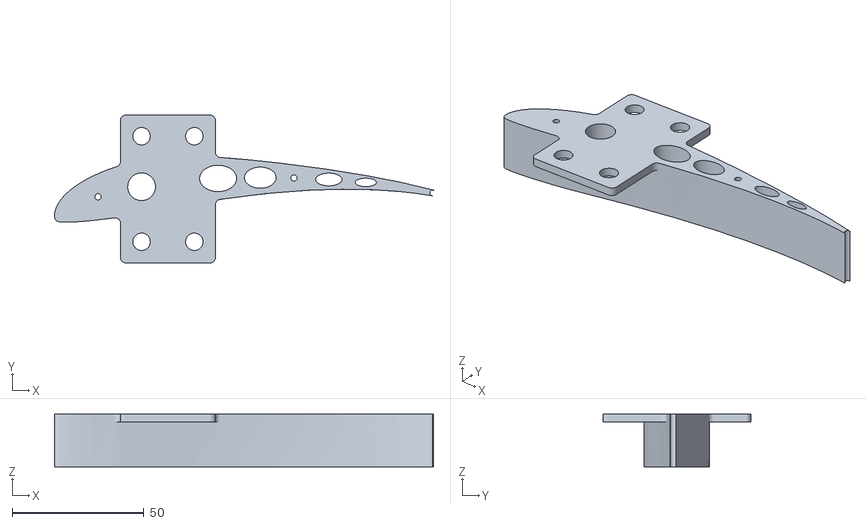
[picture p92: CAD file, 2026-09-28]
cad/manufactured/test_mount_through.stl
143.7 x 56.0 x 20.0
