wrbell/dad-ornithopter/(list of files, cad)

Other CAD files:
cad/manufactured/s1223_matched_full_wing.stl
cad/manufactured/v9_quickswap_bevel_gear_x3.step
cad/print_package_wing_root/05_v10_stepped_capstan_pinion.step
cad/manufactured/v9_differential_gimbal_yoke.step
cad/print_package_wing_root/08_v9_quickswap_bevel_gear_single.step
cad/wrist/02_Motor__gear_v8.stl
cad/manufactured/v9_differential_bevel_wrist_cartridge.step
cad/print_package_wing_root/03_v10_powertrain_dual_shear_top_brace.step
cad/manufactured/v9_quickswap_bevel_gear.step
cad/print_package_wing_root/04_v10_stagecoach_sector_drum.step
cad/manufactured/v10_stagecoach_merged_core.step
cad/print_package_wing_root/01_mco_bilateral_fuselage_collar_v1.step
cad/manufactured/v10_stepped_capstan_pinion.step
cad/print_package_wing_root/07_v9_quickswap_bevel_gear_x3_plate.step
cad/manufactured/v10_stagecoach_sector_drum.step
cad/print_package_wing_root/PLATE_01_PA12CF_ALL_STRUCTURAL_PARTS.step
cad/print_package_wing_root/02_v10_powertrain_mount_stand.step
cad/print_package_wing_root/06_v9_differential_gimbal_yoke.step
cad/manufactured/sd7062_starboard_25cm_segment_2.4mm.step
cad/manufactured/sd7062_wing_segment_25cm_2.4mm.step
cad/manufactured/sd7062_starboard_mount_2.4mm.stl
cad/manufactured/sd7062_wing_rib_chordline_165mm.stl
cad/manufactured/sd7062_port_25cm_segment_2.4mm.stl
cad/manufactured/sd7062_wingtip_smooth_port_2.4mm.step
cad/manufactured/sd7062_wing_segment_25cm_port_2.4mm.step
cad/manufactured/sd7062_airfoil_mount_starboard_2.4mm.step
cad/manufactured/sd7062_wingtip_smooth_starboard_2.4mm.step
cad/manufactured/mco_compact_delta_fuselage.step
cad/manufactured/s1223_wingtip_smooth_2.4mm.step
cad/manufactured/s1223_starboard_wingtip_2.4mm.step
cad/manufactured/s1223_wingtip_smooth_port_2.4mm.step
cad/manufactured/s1223_wing_segment_10cm_2.4mm.step
cad/manufactured/s1223_airfoil_mount_starboard_2.4mm.step
cad/manufactured/s1223_wing_segment_25cm_2.4mm.step
cad/manufactured/s1223_starboard_mount_2.4mm.step
cad/manufactured/s1223_wing_segment_25cm_starboard_2.4mm.step
cad/manufactured/s1223_starboard_25cm_segment_2.4mm.step
cad/manufactured/s1223_bird_of_prey_blended_starboard.step
cad/manufactured/s1223_bird_of_prey_blended_port.step
cad/manufactured/s1223_optimal_single_wingtip_starboard.step
cad/manufactured/s1223_bird_of_prey_symm_rounded_starboard.step
cad/manufactured/s1223_bird_of_prey_continuous_starboard.step
cad/manufactured/s1223_vortex_raked_wingtip_port.stl
cad/manufactured/S1223-IL Airfoil - 165mm - V1.stl
cad/manufactured/s1223_vortex_raked_wingtip_165mm_starboard.stl
cad/manufactured/S1223-IL Airfoil Mount - 165mm - V2.stl
cad/manufactured/s1223_bird_of_prey_equidistant_starboard.step
cad/manufactured/s1223_bird_of_prey_organic_port.step
cad/manufactured/generic_airfoil_wing_port.step
cad/manufactured/s1223_bird_of_prey_fingers_port.step
cad/manufactured/s1223_bird_of_prey_continuous_port.step
cad/manufactured/s1223_bird_of_prey_symm_rounded_port.step
cad/manufactured/s1223_bird_of_prey_feather_wingtip_port.stl
cad/manufactured/s1223_bird_of_prey_equidistant_port.step
cad/manufactured/s1223_bird_of_prey_organic_starboard.step
cad/manufactured/s1223_bird_of_prey_fingers_starboard.step
cad/S1223-IL Airfoil Mount - 165mm - V2.3mf
cad/manufactured/MCO-1D_V10_Wing_Root_Assembly.f3d
cad/manufactured/archive/mco_integrated_2dof_wrist.step
cad/manufactured/archive/mco_integrated_2dof_wrist.stl
cad/manufactured/archive/mco_merged_sector_wrist_assembly.step
cad/manufactured/archive/mco_merged_sector_wrist_assembly.stl
cad/manufactured/archive/mco_skeletonized_sector_wheel.step
cad/manufactured/archive/mco_skeletonized_sector_wheel.stl
cad/manufactured/archive/mco_spine_bilateral_mating_collar.step
cad/manufactured/archive/mco_spine_bilateral_mating_collar.stl
cad/manufactured/archive/mco_ultracompact_2dof_wrist.step
cad/manufactured/archive/mco_ultracompact_2dof_wrist.stl
cad/manufactured/archive/mco_ultracompact_merged_core_10to1.step
cad/manufactured/archive/mco_ultracompact_merged_core_10to1.stl
cad/manufactured/archive/mco_ultracompact_naca0018_fairing.step
cad/manufactured/archive/mco_ultracompact_naca0018_fairing.stl
cad/manufactured/archive/mco_ultracompact_naca0018_fairing_enclosing.step
cad/manufactured/archive/mco_ultracompact_naca0018_fairing_enclosing.stl
cad/manufactured/archive/mco_ultracompact_sector_wheel_10to1.step
cad/manufactured/archive/mco_ultracompact_sector_wheel_10to1.stl
cad/manufactured/archive/v4_2dof_wrist_yoke.step
cad/manufactured/archive/v4_2dof_wrist_yoke.stl
cad/manufactured/archive/v4_goolrc5010_pinion_assembly.step
cad/manufactured/archive/v4_goolrc5010_pinion_assembly.stl
cad/manufactured/archive/v4_merged_core.step
cad/manufactured/archive/v4_merged_core.stl
cad/manufactured/archive/v4_naca0018_fairing.step
cad/manufactured/archive/v4_naca0018_fairing.stl
cad/manufactured/archive/v4_sector_wheel_flatface_spar.step
cad/manufactured/archive/v4_sector_wheel_flatface_spar.stl
cad/manufactured/archive/v4_spar_tube.stl
cad/manufactured/archive/v5_embedded_fairing.step
cad/manufactured/archive/v5_embedded_fairing.stl
cad/manufactured/archive/v5_embedded_sector_drum.step
cad/manufactured/archive/v5_embedded_sector_drum.stl
cad/manufactured/archive/v5_embedded_wrist_yoke.step
cad/manufactured/archive/v5_monolithic_merged_core.step
cad/manufactured/archive/v5_monolithic_merged_core.stl
cad/manufactured/archive/v6_embedded_wrist_yoke.step
cad/manufactured/archive/v6_monolithic_merged_core.step
cad/manufactured/archive/v6_monolithic_merged_core.stl
cad/manufactured/archive/v6_unbroken_fairing.step
cad/manufactured/archive/v6_unbroken_sector_drum.step
cad/manufactured/archive/v6_unbroken_sector_drum.stl
cad/manufactured/archive/v7_skeleton_fairing.step
cad/manufactured/archive/v7_skeleton_fairing.stl
cad/manufactured/archive/v7_skeleton_merged_core.step
cad/manufactured/archive/v7_skeleton_merged_core.stl
cad/manufactured/archive/v7_skeleton_sector_drum.step
cad/manufactured/archive/v7_skeleton_sector_drum.stl
cad/manufactured/archive/v7_skeleton_spar.stl
cad/manufactured/archive/v7_skeleton_wrist_yoke.step
cad/manufactured/archive/v8_rightsized_fairing.step
cad/manufactured/archive/v8_rightsized_fairing.stl
cad/manufactured/archive/v8_rightsized_merged_core.step
cad/manufactured/archive/v8_rightsized_merged_core.stl
cad/manufactured/archive/v8_rightsized_sector_drum.step
cad/manufactured/archive/v8_rightsized_sector_drum.stl
cad/manufactured/archive/v8_rightsized_wrist_yoke.step
cad/manufactured/archive/v8_rightsized_wrist_yoke.stl
cad/manufactured/archive/v8_stepped_pinion_assembly.step
cad/manufactured/generic_airfoil_wing_port.3mf
cad/manufactured/generic_airfoil_wing_port.stl
cad/manufactured/generic_airfoil_wing_starboard.3mf
cad/manufactured/generic_airfoil_wing_starboard.stl
cad/manufactured/mco_clamps_and_skid_complete_kit.3mf
cad/manufactured/mco_clamps_and_skid_complete_kit.stl
cad/manufactured/mco_compact_delta_fuselage.3mf
cad/manufactured/mco_compact_delta_fuselage.stl
cad/manufactured/mco_complete_8wing_aircraft.3mf
cad/manufactured/mco_complete_8wing_aircraft.stl
cad/manufactured/mco_core_one_complete_aircraft.3mf
cad/manufactured/mco_core_one_complete_aircraft.stl
cad/manufactured/mco_core_one_lego_edition.3mf
cad/manufactured/mco_core_one_lego_edition.stl
cad/manufactured/mco_corner1_top_fwd_clamp.3mf
cad/manufactured/mco_corner1_top_fwd_clamp.stl
cad/manufactured/mco_corner2_bot_fwd_clamp.3mf
cad/manufactured/mco_corner2_bot_fwd_clamp.stl
cad/manufactured/mco_corner3_aft_tail_clamp.3mf
cad/manufactured/mco_corner3_aft_tail_clamp.stl
cad/manufactured/mco_electronics_bay_assembly.3mf
cad/manufactured/mco_electronics_bay_assembly.stl
cad/manufactured/mco_electronics_bay_canopy_hatch.3mf
cad/manufactured/mco_electronics_bay_canopy_hatch.stl
cad/manufactured/mco_electronics_bay_tub.3mf
cad/manufactured/mco_electronics_bay_tub.stl
cad/manufactured/mco_fuselage_assembly.3mf
cad/manufactured/mco_fuselage_assembly.stl
cad/manufactured/mco_main_gear_saddle_clamp.3mf
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
