wrbell/dad-ornithopter/cad/drawings/MCO_1D_Wing_Construction.pdf

MCO-1D · WING CONSTRUCTION DRAWING · Rev H2 · June 2026 S1223 AEROFOIL CROSS-SECTION | Page 1 / 3
Coordinates: UIUC Airfoil Database · m-selig.ae.illinois.edu · Max thickness 12.1%c at 19.8%c · Max camber 8.1%c at 49%c

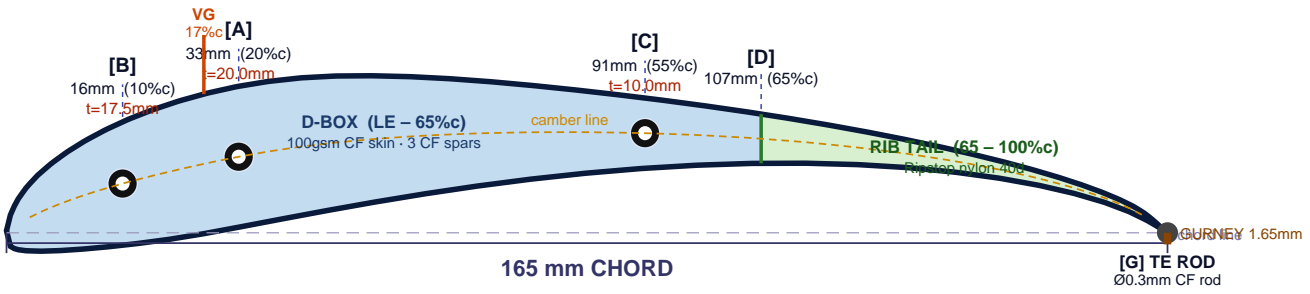
[picture p93: figure]
chord line; 165 mm CHORD; [G] TE ROD Ø0.3mm CF rod; GURNEY 1.65mm; D-BOX (LE – 65%c); camber line; Ripstop nylon 40d

100gsm CF skin · 3 CF spars | RIB TAIL (65 – 100%c)
S1223 (UIUC Selig) · 165mm chord · 100gsm CF skin · 2.0mm CF spars · LW-PLA ribs · Ripstop membrane | DWG: MCO-1D-WING-001 Rev H2
UIUC S1223 · m-selig.ae.illinois.edu/ads/coord/s1223.dat · Selig 1997 · Experimental prototype only | MCO-1D-WING-001 Rev H2

MCO-1D · WING CONSTRUCTION DRAWING · Rev H2 · June 2026 SPAR STATIONS · AEROFOIL THICKNESS | Page 2 / 3

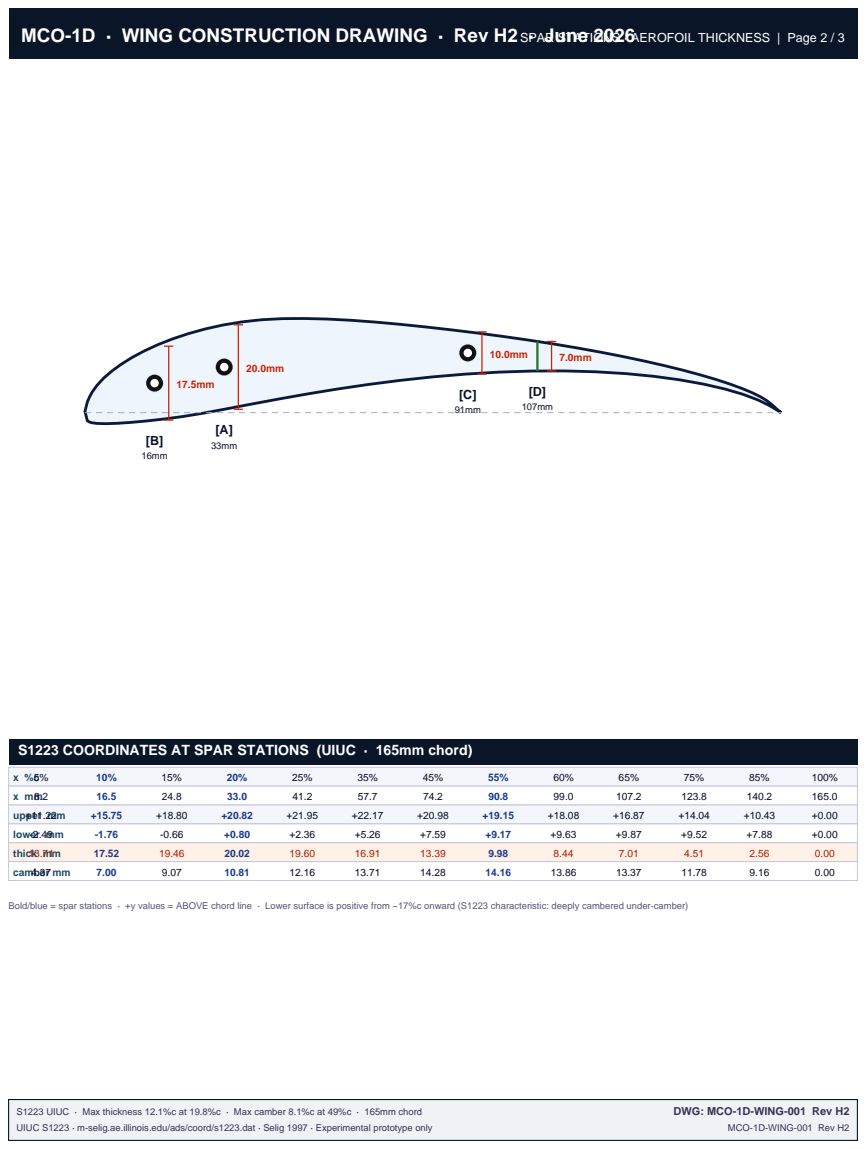
[picture p94: page 2]
upper mm +11.22; lower mm -2.49; thick mm 13.71; camber mm 4.37; S1223 UIUC · Max thickness 12.1%c at 19.8%c · Max camber 8.1%c at 49%c · 165mm chord; DWG: MCO-1D-WING-001 Rev H2

S1223 COORDINATES AT SPAR STATIONS (UIUC · 165mm chord)

Bold/blue = spar stations · +y values = ABOVE chord line · Lower surface is positive from ~17%c onward (S1223 characteristic: deeply cambered under-camber)

MCO-1D · WING CONSTRUCTION DRAWING · Rev H2 · June 2026 COMPLETE BUILD SPECIFICATION | Page 3 / 3

### AEROFOIL

Profile | S1223 — UIUC Airfoil Database (m-selig.ae.illinois.edu/ads/coord/s1223.dat) Selig 1997
Chord | 165 mm (locked Rev H)
Max thickness | 12.1%c at 19.8%c → 20.0mm at 32.7mm from LE
Max camber | 8.1%c at 49%c → 13.4mm at 80.9mm from LE
Lower surface note | POSITIVE (above chord line) from ~17%c to TE — deeply cambered under-camber (S1223 characteristic)
CL,max clean | 2.20 (Re=2×10■, Selig 1997)
CL,max + VGs + Gurney | 2.40

### STRUCTURAL MEMBERS

[A] Main spar | 2.0mm OD / 1.0mm ID pultruded CF tube · 20%c = 33mm · thickness at station 20.0mm · ø2.2mm rib hole · thin CA
[B] Fwd spar | 2.0mm OD / 1.0mm ID pultruded CF tube · 10%c = 17mm · thickness at station 17.5mm · ø2.2mm rib hole · thin CA
[C] Rear spar | 2.0mm OD / 1.0mm ID pultruded CF tube · 55%c = 91mm · thickness at station 10.0mm · ø2.2mm rib hole · thin CA
[D] D-box rear wall | 65%c = 107mm · full-depth LW-PLA element · 0.5mm wall · 3 perimeters · 20% infill · closes torsion box
[G] TE rod | 0.3mm solid CF rod at trailing edge · ø0.5mm rib hole · E6000 hem bond · membrane anchor + TE stiffness + Gurney alignment

### SKIN AND COVERING

CF skin (D-box) | 100gsm 2×2 twill CF woven · 1 ply upper + lower · LE to 65%c · West System epoxy · 0/90° to chord
Membrane (rib tail) | Ripstop nylon 40 denier · E6000 to rib tail edges · 65–100%c both surfaces · TE hemmed around [G] rod

### RIB CONSTRUCTION

Material | LW-PLA · gyroid 12% infill · 3 perimeters
Standard rib wall | 1.0mm (Rev H — ribs are shape-limited; peak load 0.79N in sprint — 1.0mm adequate, saves 84g)
Root rib | 3.0mm solid LW-PLA
Tip rib | 2.0mm solid LW-PLA
Rib spacing | 20mm (17%c) · membrane deflection at cruise: 0.03mm
Lightening hole | 35×9mm oval between [B] and [A] spars

### AERODYNAMIC FEATURES

VGs | 17%c upper surface · h=8.4mm · 18° toe · counter-rotating pairs · LW-PLA strip · E6000
Gurney flap | 1.65mm (1%c) · integral LW-PLA · lower surface at TE · perpendicular to chord
Covert flaps | 0.125mm PET · 50–62%c upper · 3 strips 15mm apart · E6000 hinge at 50%c · passive
Raked wingtip | 25° LE sweep · 15%c (25mm) ext. · 1.5° washout · 5° dihedral

### WING PAIRS

W1 (front) | Semi-span 772mm · tip-to-tip 1544mm · area 0.255m²
W2 | Semi-span 749mm · tip-to-tip 1498mm · area 0.247m²
W3 | Semi-span 735mm · tip-to-tip 1470mm · area 0.243m²
W4 (rear) | Semi-span 712mm · tip-to-tip 1424mm · area 0.235m²
Total | Area 0.979m² · CL,max 2.40 · Vs=4.85m/s at 3.45kg MTOW · stagger 138mm
MCO-1D Wing Build Specification · Rev H2 · UIUC S1223 · 165mm chord | DWG: MCO-1D-WING-001 Rev H2
