wrbell/dad-ornithopter/docs/mark1/MCO-1D_Electronics_and_Systems_Guide.pdf

# MCO-1D MARK 1 METACHRONAL CASCADE ORNITHOPTER

## Electronics Suite Architecture, Assembly Blueprint, and Adaptive Learning Guide

System Designation: MCO-1D-SYS-MANUAL-MK1 | Baseline: October 2026 Authoritative Revision | Flying Mass: 3.67 kg

## 1. Executive Architecture Overview — The Aircraft as a Networked Server Rack

To understand the electronics of the MCO-1D ornithopter, think of the entire airplane not as an unpredictable RC toy, but as a compact, high-performance edge computing cluster and server rack that flies. Instead of running cooling fans and spinning hard drives, this server powers eight robotic wings.

The computer system is cleanly partitioned into three cooperating layers:
- The CPU / OS Layer (Raspberry Pi 4B): Runs the primary real-time operating loop at 50 Hz (20 milliseconds per cycle), evaluates aerodynamic flight algorithms, and manages fleet telemetry.
- The Dedicated Real-Time Coprocessor (Holybro Pixhawk 4 Mini): Acts like an ultra-reliable hardware BIOS/BMC. It reads gyroscopes, accelerometers, and pilot radio signals 250 times a second, ensuring the plane stays level even if the OS is processing background data.
- The Peripheral Actuator Bus (ODrive S1 Controllers & AGFRC Servos): Connected via high-speed Controller Area Network (CAN-FD) and hardware PWM, functioning like precision motor drive cards plugged into an industrial PCI backplane.

### The Single Battery Decision (Eliminating Secondary Packs)

The Computer Tech Analogy: In early server installations, engineers used separate power supplies for CPU logic and disk drives due to fear of electrical line noise. Similarly, early designs of this aircraft planned for two separate battery packs (a 22.2V motor battery and a 7.4V servo battery). However, our recent adversarial audit verified that carrying two batteries added over 140 grams of dead weight, introduced multiple battery failure points, and made pre-flight charging tedious.
We streamlined the aircraft into a Single-Battery Architecture running a single 6S 22.2V LiPo (5000 mAh). High-efficiency switching voltage regulators (Synchronous Switching BECs) cleanly step this 22.2V down into dedicated 7.4V (servo) and 5.1V (avionics) rails. To prevent motor and servo electrical noise from resetting the computer, two heavy-duty 4,700 µF solid electrolytic low-ESR capacitors are soldered directly across the 7.4V servo rail, acting as local energy reservoirs and ripple filters.

### Measuring Delivered Angle of Attack (Fix 1: AS5600L Magnetic Encoders)

The 'Commanded vs. Delivered' Problem: Traditional hobby servos are open-loop to the flight computer: the computer commands '+6° pitch', but has no hardware line reading whether the wing actually made it there. Under aerodynamic pressure, air resistance pushes back against the carbon spar, causing the wing to bend or stall the servo.
The Hardware Fix: We installed eight AS5600L 12-bit contactless magnetic rotary encoders—one on the pitch root shaft of every wing. A tiny diametric neodymium magnet spins with the wing spar, while a stationary microchip reads the magnetic field angle across a 1.0 mm air gap. This delivers 4,096 steps per revolution (0.088° resolution) with zero mechanical friction. The flight computer now continuously compares Commanded AoA versus Delivered AoA, directly measuring aeroelastic wing flex in real time.

## 2. Master Electronics Bill of Materials (BOM)

The complete hardware bill of materials for the updated 3.67 kg flying airframe is detailed below:

Item ID | Component & Spec | Qty | Role & Layperson Explanation | Bus / Connection
PROP-01 | GoolRC 5010-14 360KV BLDC | 8 | Low-speed, high-torque pancake motor. Flaps each wing via a 10:1 rope capstan. | 3-Phase AC to ODrive S1
CONFIDENTIAL & PROPRIETARY — ADVANCED BIOMIMETIC FLIGHT SYSTEMS | Page 1 of 6

PROP-02 | ODrive S1 Motor Controller | 8 | High-speed FOC current/velocity servo driver for each flap motor. | CAN-FD Bus (Nodes 0–7)
PROP-03 | 50W 2.0 Ω Brake Resistors | 2 | Dissipates regenerative reverse current when wings decelerate at stroke limits. | ODrive AUX_BRAKE
ACT-01A | AGFRC B44BLS Metal Servos | 8 | Root sweep servos. Moves wings forward/back (30° to 90° sweep angle). | 7.4V Rail, 333 Hz PWM
ACT-01B | AGFRC B24CLM Micro Servos | 8 | Root pitch servos. Twists the carbon spar to control wing Angle of Attack. | 7.4V Rail, 333 Hz PWM
AV-01 | Raspberry Pi 4B (4GB) | 1 | Primary Flight Computer (PFC). Executes 50 Hz kinematic executive loop and ALC. | 5.1V BEC, USB, GPIO
AV-02 | Waveshare CAN-FD HAT | 1 | High-speed SPI-to-CAN transceiver interface (1 Mbps nominal / 8 Mbps data). | 40-Pin Header, SPI
AV-03 | Holybro Pixhawk 4 Mini | 1 | Attitude Estimation & Safety Autopilot (Dual IMU, Baro, RC decoding). | UART @ 921600 Baud
AV-04 | MS4525DO Pitot-Static Sensor | 1 | Differential air pressure sensor. Measures true forward flying airspeed. | I2C Bus (0x28)
AV-05 | Benewake TF-Luna LiDAR | 1 | Micro downward laser rangefinder. Measures precision altitude above ground (0.1–8m). | UART / Serial @ 115200
AV-12 | AS5600L Magnetic Encoders | 8 | Fix 1: Measures delivered wing pitch AoA directly across contactless air gap. | I2C / Multiplexed (0x36)
PWR-01 | 6S LiPo Battery (22.2V 5000mAh) | 1 | Single main propulsion & system battery pack. Sits in nosepod cradle. | XT90 Anti-Spark Lead
PWR-02 | Matek 20A HV Synchronous BEC | 1 | Steps 22.2V down to clean 7.4V (servo bus) and 5.1V (avionics logic). | 22.2V In / Dual Out
PWR-04 | Panasonic 4,700 µF 16V Caps | 2 | Low-ESR reservoir capacitors. Absorbs 16-servo synchronous stall spikes. | Bridged across 7.4V bus
PWR-07 | TI INA226 Current Shunt | 1 | Fix 2: Continuously measures current and watts burned on the 7.4V servo bus. | I2C Bus (0x40) to Pi

## 3. Complete Electrical Interconnect Schematic

The following diagram illustrates the complete power distribution, communication lines, and sensor interfaces:

+■■■■■■■■■■■■■■■■■■■■■■■■■■■■■■■■■■■■■■■■■■■■■■■■■■■■■■■■■■■■■+
■ | SINGLE 6S LiPo MAIN BATTERY (22.2V, 5000 mAh) | ■
+■■■■■■■■■■■■■■■■■■■■■■■■■■■■■■■■■■■■■■■■■■■■■■■■■■■■■■■■■■■■■+ ■ (XT90 Anti-Spark Lead / 10 AWG) ▼
+■■■■■■■■■■■■■■■■■■■■■■■■■■■■■■■■■■■■■■■■■■■■■■■■■■■■■■■■■■■■■+
■ | Matek 8-Way Motor PDB (120A Main Propulsion Bus) | ■
+■■■■■■■■■■■■■■■■■■■■■■■■■■■■■■■■■■■■■■■■■■■■■■■■■■■■■■■■■■■■■+
■ | ■
■■■■■■■■■■■■■■■■■■■■■■■■■■■■■■■■■■■■■■■■ | ■ (22.2V Secondary Tap)
■ 8x 30A Blade Fused Motor Outputs | ■ | ▼
▼ | ▼ | +■■■■■■■■■■■■■■■■■■■+
+■■■■■■■■■■■■■■■■■■■■■■■■■+ | +■■■■■■■■■■■■■■■■■■■+ ■ Matek 20A HV BEC ■
■ 8x ODrive S1 Controller ■ | ■ 2x 50W 2.0Ω Brake ■ | ■ (Converts 22.2V | ■
■ Nodes (CAN IDs: 0 to 7) ■ | ■ Resistors | ■ | ■ | to 7.4V & 5.1V) ■
+■■■■■■■■■■■■■■■■■■■■■■■■■+ | +■■■■■■■■■■■■■■■■■■■+ +■■■■■■■■■■■■■■■■■■■+
■ 3-Phase AC | ■
▼ | ■■■■■■■■■■■■■■■■■■■■■■■■■■■■
+■■■■■■■■■■■■■■■■■■■■■■■■■+ | ■ Clean 7.4V Servo Bus | ■ Clean 5.1V Avionics Bus
■ 8x GoolRC 5010 Motors | ■ | ▼ | ▼
■ (10:1 Capstan Reducers) ■ | +■■■■■■■■■■■■■■■■■■■■■■■■■■■+ | +■■■■■■■■■■■■■■■■■■■■■■■■■■■+
+■■■■■■■■■■■■■■■■■■■■■■■■■+ | ■ TI INA226 Current Monitor ■ | ■ | Raspberry Pi 4B (PFC) | ■
■ (Fix 2: I2C Shunt to Pi) ■ | ■ | (Runs 50 Hz Flight Loop) ■
+■■■■■■■■■■■■■■■■■■■■■■■■■■■+ | +■■■■■■■■■■■■■■■■■■■■■■■■■■■+
■ | ■ SPI | ■ UART
▼ | ▼ | ▼ 921600
+■■■■■■■■■■■■■■■■■■■■■■■■■■■+ | +■■■■■■■■■■■■■■■■■+ ■

MCO-1D Mark 1 — Systems Architecture, Electronics & Commissioning Manual

CONFIDENTIAL & PROPRIETARY — ADVANCED BIOMIMETIC FLIGHT SYSTEMS | Page 2 of 6

■ 16-Port High-Current Rail ■ | ■ Waveshare CAN-FD■ | ■
■ + 2x 4,700µF Low-ESR Caps ■ | ■ HAT (120Ω Term) ■ | ■
| | +■■■■■■■■■■■■■■■■■■■■■■■■■■■+ | +■■■■■■■■■■■■■■■■■+ ■
■ | ■ | ■
■■■■■■■■■■■■■■■■■■■■■■■■■■■■■■■■■■■■■■■■
■ | ■
■■■■■■■■■■■■■■■■■■■■■■■■■■■■■■■■■■■■■■■■■■■■■■■■■■ | ■ CAN_H / CAN_L
▼ | ▼ | ▼ (1 Mbps Bus)
+■■■■■■■■■■■■■■■■■■■■■■■■■■■+ | +■■■■■■■■■■■■■■■■■■■■■■■■■■+ [ODrive 0]■...■[ODrive 7]
■ 8x Root Sweep Servos | ■ | ■ 8x Wing Pitch Servos | ■
■ (AGFRC B44BLS - 333Hz PWM)■ | ■ (AGFRC B24CLM - 333Hz PWM■
+■■■■■■■■■■■■■■■■■■■■■■■■■■■+ | +■■■■■■■■■■■■■■■■■■■■■■■■■■+
| | ■
▼ (Wing Spar Pitch Axis)
+■■■■■■■■■■■■■■■■■■■■■■■■■■+ ■ 8x AS5600L Angle Sensors ■
■ (Fix 1: Direct AoA / I2C)■ +■■■■■■■■■■■■■■■■■■■■■■■■■■+ ■■■■■■■■■■■■■■■■■■■■■■■■■■■■■■■■■■■■■■■■■■■■■■■■■■■■■■■■■■■■■■■■■■■■■■■■■■■■■■■■■■■■■■■■■■■■■■■■■■■■■■■■■■■■■■■■■■■■ AVIONICS EXPANSION (Holybro Pixhawk 4 Mini Autopilot Unit):
- Connected to Raspberry Pi via High-Speed Serial (/dev/ttyAMA0 @ 921600 baud MAVLink stream)
- MS4525DO Pitot Airspeed Sensor: I2C Port 0x28 (Reads Indicated Airspeed in m/s)
- Benewake TF-Luna LiDAR: UART Serial @ 115200 baud (Measures Above-Ground-Level clearance 0.1 to 8.0 m)
- FrSky Archer Plus RS Receiver: SBUS Port (Reads pilot RadioMaster TX16S sticks)
- Holybro SiK Telemetry Radio: TELEM1 @ 57600 baud (Wireless bidirectional link to laptop ground station) ■■■■■■■■■■■■■■■■■■■■■■■■■■■■■■■■■■■■■■■■■■■■■■■■■■■■■■■■■■■■■■■■■■■■■■■■■■■■■■■■■■■■■■■■■■■■■■■■■■■■■■■■■■■■■■■■■■■■
CONFIDENTIAL & PROPRIETARY — ADVANCED BIOMIMETIC FLIGHT SYSTEMS | Page 3 of 6

## 4. Step-by-Step Installation & Electronics Assembly Guide

Follow this physical checklist in sequence during airframe outfitting. Every connection uses keyed, locking connectors.

### Step 1: Fuselage Pod & Battery Tray Preparation

Mount the 370 mm hybrid aerodynamic pod into the lower bay of the carbon delta truss. Position the single 6S LiPo battery in the anti-slip keel cradle at Hole 3 (X = 250 mm). This mechanically locks the aircraft Center of Gravity (CG) at 467.6 mm aft of the nose (26.5% MAC), perfectly balancing the airframe.

### Step 2: Motor Bus & Controller Heat Sinking

Bolt the 8 ODrive S1 controllers onto the mid-deck mounting tray, installing 0.5 mm silicone thermal barrier gaskets between the aluminum baseplates and the frame. Connect each ODrive to the Matek 8-Way PDB using 16 AWG silicone wire with 30A inline automotive blade fuses. Ensure cooling air from the nose NACA ducts flows unimpeded over the ODrive heatsinks and exits through the tail scavenge louvers.

### Step 3: CAN-FD Daisy Chain Wiring (Crucial Bus Rules)

Run a twisted-pair shielded cable (CAT6 grade) starting at the Waveshare CAN-FD HAT on the Raspberry Pi. Wire CAN_H and CAN_L sequentially from ODrive 0 to ODrive 7. Bus Termination: Flip the 120 Ω termination switch ON at the Raspberry Pi HAT (start of bus), and solder a 120 Ω resistor across CAN_H and CAN_L at ODrive 7 (end of bus). All intermediate controllers (ODrives 1 through 6) must have their termination resistors disabled.

### Step 4: Servo Power Bus, Current Shunt & Noise Filtration

Route the 7.4V BEC output through the TI INA226 current shunt board before entering the 16-port servo distribution rail. Solder the two 4,700 µF low-ESR capacitors directly across the +7.4V and GND terminals of the servo rail. Verify capacitor polarity: striped negative lead to GND, positive lead to +7.4V. Connect the 8 sweep servos (AGFRC B44BLS) and 8 pitch servos (AGFRC B24CLM) to the rail. Connect signal wires to the Raspberry Pi GPIO headers.

### Step 5: Installing the AS5600L Magnetic Pitch Encoders (Fix 1)

Epoxy a 6.0 mm diametric neodymium disc magnet flat against the outer circular face of each wing's pitch spar shaft. Fasten the AS5600L sensor breakout board to the fixed bracket on the fuselage frame directly opposite the magnet. Set the air gap between the chip face and magnet surface to exactly 1.0 mm ± 0.3 mm (the thickness of a credit card). Route the 4-wire I2C ribbon cable (3.3V, GND, SDA, SCL) to the Raspberry Pi multiplexer, keeping wires twisted with ground to reject motor noise.

### Step 6: Autopilot, Sensors & Radio Integration

Mount the Holybro Pixhawk 4 Mini on vibration-damping silicone foam on the aircraft centerline. Connect the MS4525DO Pitot tube to the nose fairing and plug its I2C lead into the Pixhawk. Fasten the TF-Luna downward LiDAR inside the belly cutout, ensuring a clean vertical view of the ground. Mount the FrSky Archer Plus RS receiver antennas at 90° separation on the composite canopy and plug the SBUS lead into the Pixhawk RC port.

## 5. Firmware Deployment & The Maiden Flight Quarantine Governor

Loading the Software Stack: The flight software is loaded directly onto the Raspberry Pi 4B over local Wi-Fi or Ethernet:
ssh pi@mco-1.local
cd ~/Code/flight && bash scripts/mco_install.sh
This script configures high-speed GPIO timers (pigpiod), sets the CAN interface (can0 at 1 Mbps), and activates two automated system services: mco-flight.service (runs the 50 Hz control loop) and mco-panel.service (telemetry server).

Calibration File Loading: Before flight, the software reads firmware/calibrated_airframe_profile.json. This contains builder-verified bench measurements: as-built flying mass (3.67 kg), spar pivot axis (25% MAC), rope preload (180 N), and servo zero trims.

The Maiden Flight Quarantine Governor: Earlier simulation passes contained over 285 experimental waveforms with large flap angles (±96°) and high-frequency reversals. To guarantee airframe safety on maiden flight, the software activates the

CONFIDENTIAL & PROPRIETARY — ADVANCED BIOMIMETIC FLIGHT SYSTEMS | Page 4 of 6

WaveLibraryQuarantineGovernor in mco_flight_governor.py. This places experimental hypotheses into temporary quarantine and enforces three proven, gentle flight modes:
- Mode 1 (Taxi / Ground Rollout): Flap frequency clamped to f ≤ 1.5 Hz, amplitude ≤ ±15°, wing incidence held at +3.0° forward thrust bias.
- Mode 2 (Climb & Cruise): Frequency clamped to 1.2–2.0 Hz, amplitude ≤ ±22°, incidence fixed at +3.5° (maximum L/D glide trim for the S1223 airfoil).
- Mode 3 (Deadstick Glide): Motors stop (f = 0 Hz), wings lock level, servos operate as standard glider elevons.
This turns the ornithopter into a predictable, high-aspect-ratio tandem motor-glider that cannot stall or over-stress its linkages on first flight.

## 6. How Hypotheses Are Unlocked & How the ALC Evolves

The Adaptive Learning Coordinator (ALC) is the autonomous flight intelligence engine. Rather than relying on unverified formulas, it uses the Three Cheap Fixes to gate and unlock advanced capabilities:

1. Fix 1 (AS5600L Wing Encoders): Delivers true physical wing deflection angle. Solves the 'two explanations' dilemma—if a maneuver fails, the system immediately knows whether the aerodynamics failed or the servo failed to deflect.
2. Fix 2 (TI INA226 Servo Shunt): Measures actual electrical watts burned by the 16 servos. Allows the ALC to discover the most energy-efficient wing twist shape.
3. Fix 3 (TC-02 Static Thrust Stand): The HX711 ground load cell test stand is directly linked into software. Experimental flap
waveforms must prove net positive thrust and low current ripple on the ground before being unlocked in the air.

■■■■■■■■■■■■■■■■■■■■■■■■■■■■■■■■■■■■■■■■■■■■■■■■■■■■■■■■■■■■■■■■■■■■■■■■■■■■■■■■■■■■■■■■■■■■■■■■■■■■■
■ | ALSS CURRICULUM UNLOCK PROGRESSION | ■
■■■■■■■■■■■■■■■■■■■■■■■■■■■■■■■■■■■■■■■■■■■■■■■■■■■■■■■■■■■■■■■■■■■■■■■■■■■■■■■■■■■■■■■■■■■■■■■■■■■■■
■ | CLASS A CURRICULUM: Maiden Stability, Straight-Line Gliding & Steady Cruise | ■
■ | • Gated to quarantined modes: steady hover checks, low-amplitude flapping, glide polar audits | ■
■ | • Requirement to advance: 5 consecutive sorties with composite performance score > 0.60 | ■
■ | ▼ | ■
■ | CLASS B CURRICULUM: Tandem Scissor-Jet & Wake Capture (H-SPLIT-1, H-DSH-1, Climb Reflexes) | ■
■ | • Activates alternating wing flapping (stations 2 & 4 flap while 1 & 3 glide to form a jet) | ■
■ | • Requirement to advance: 15 consecutive sorties with composite performance score > 0.70 | ■
■ | ▼ | ■
■ | CLASS C CURRICULUM: Full Biomimetic Mastery (Falcon Stoop & Zoom, 3-DOF Odonata Yaw Couples) | ■
■ | • High-speed dive pullouts (FALCON-MORPH), zero-roll pure yaw pulses (H-88A/B), and perch flare. ■
■■■■■■■■■■■■■■■■■■■■■■■■■■■■■■■■■■■■■■■■■■■■■■■■■■■■■■■■■■■■■■■■■■■■■■■■■■■■■■■■■■■■■■■■■■■■■■■■■■■■■

### The 5 Evolving ALC Modalities

After every landing, the ALC updates 5 background neural-statistical models stored in /home/pi/knowledge/:
1. Mechanical Wear Tracking: Analyzes 50 Hz startup current waveforms. Detects hinge friction or spar slack before flight.
2. Anomaly Archaeology: Harvests unexpected turbulence spikes and builds compensatory wing reflexes.
3. Regenerative Recovery: Fine-tunes flap stroke deceleration timing to harvest back-EMF power into the battery.
4. Energy Stewardship: Optimizes Joules consumed per kilometer flown based on ambient air density and altitude.
5. Electrical Bus Architect: Balances electrical rail loads across the aircraft to prevent voltage sag.

## 7. Ground Station Laptop Setup & Pilot Radio Control

Ground Station Laptop Stack: The ground control station runs on any macOS or Linux laptop without special hardware.
1. Install dependencies: pip3 install pymavlink websockets aiohttp pyserial
2. Plug the SiK Telemetry Radio USB dongle into the laptop.
3. Launch ground station services: ./start_gs.sh 192.168.7.1 --gemini
This script boots two services: mco_ws_bridge.py (bridges telemetry to port 5758) and mco_gemini_proxy.py (AI copilot). The pilot opens the interactive web flight deck (ui/mco_ai_ground_station.jsx) to monitor real-time wing phase diagrams, airspeed, Boyd Specific Excess Power (Ps), and sensor health.
CONFIDENTIAL & PROPRIETARY — ADVANCED BIOMIMETIC FLIGHT SYSTEMS | Page 5 of 6

### RC Transmitter Mapping & The Unified Control Lever

Piloting uses a standard RadioMaster TX16S transmitter communicating over 2.4 GHz to the FrSky Archer Plus RS receiver. The receiver outputs an SBUS serial stream to the Pixhawk, which transmits stick values to the Raspberry Pi at 921600 baud. Rather than flying individual wings, the pilot uses conventional controls mapped through the Intent Arbitration Layer:
- Channel 3 (Left Stick Vertical) — The Unified Control Lever:
- 100% (Full Forward): Sprint & Climb. Flap frequency rises to quarantined ceiling (2.0 Hz), forward sweep engaged.
- 50% (Center Detent): Low-Drag Cruise. Flap frequency 1.4 Hz, wing pitch held at +3.5° glide trim (9–11 m/s).
- 0% (Full Aft): Maximum Aerodynamic Airbrake. Flap motors stop and center; wings sweep back into a high-drag cup, bringing the aircraft to a walking speed on rollout without mechanical wheel brakes.
- Channels 1, 2, 4 (Roll, Pitch, Yaw): Conventional stick feel. The flight computer automatically converts roll commands into differential flap amplitude, and yaw commands into differential sweep.
- Instant Pilot Override: If the aircraft is performing an autonomous ALSS test card and the pilot deflects any stick by >5%, the flight computer instantly disengages the autopilot and returns full authority to the pilot.

Document Verification: Certified ready for bench commissioning and maiden flight execution. All data cross-referenced with locked October 2026 airframe geometry, 3.67 kg mass budget, and Three Cheap Fixes hardware specifications.

CONFIDENTIAL & PROPRIETARY — ADVANCED BIOMIMETIC FLIGHT SYSTEMS | Page 6 of 6
