wrbell/dad-ornithopter/docs/archive/MCO-1D_Commissioning_Manual_v18.pdf

MCO-1D Commissioning Manual — Revision 18 — August 2026 — Page 1

# MCO-1D ORNITHOPTER

### Commissioning Manual — Revision 18 — July 2026

The complete guide from assembly through Discovery flights. Every step is numbered. Do not skip steps.

Aircraft | MCO-1D metachronal cascade ornithopter — SAR testbed
MTOW | 3.448 kg (33.8 N) — measure actual after build
Stall speed | 4.85 m/s (9.4 kt) out of ground effect
VNE | 28.0 m/s (54.4 kt)
Freq limit | 3.0 Hz hard cap — cannot be overridden
Wings | 8 — four tandem pairs W1 (front) to W4 (rear)
Wing spans | W1=772, W2=749, W3=735, W4=712 mm semi (measure actual)
Root chord ext. | 230-250 mm at bolt circle, tapered to 165 mm over 180 mm
Winglets | 6-inch 4-slot, cant 75-80°, 35° aft sweep
Surface devices | Turbulator tape upper 33-58 mm, lower 119-132 mm; covert flaps at 71 mm and 111 mm chord positions
Motors | 8 × GoolRC 5010-14 360 KV — one per wing
Controllers | 8 × ODrive S1 — ONE BOARD PER MOTOR
Encoder | On-board absolute magnetic — cold-start position known immediately
Control | Joystick L/R=Roll, F/A=Pitch. Pedals=Yaw. Lever=Throttle.
Hover mode | V<3 m/s: lever→altitude rate (50%=hold ±5%, ±400 fpm full)
FW mode | V>5 m/s: standard fixed-wing conventions throughout
Blend zone | 3-5 m/s: smooth automatic transition between modes
Mechanisms | 15 optimizer-weighted: 5 roll, 5 pitch, 5 yaw
Pitot airspeed | Pixhawk MS4525DO — required for hover mode and all morphing
Health monitor | Real S1 FET+motor temps at 5 Hz; errors at 1 Hz
TC-01 gate | FREE_HOVER / STOL_FIRST / STOL_ONLY / REDESIGN
Wave Library | 49,180 lines — 33 hypotheses, 180 variants, 164 GS cmds
Revision | 18 — July 2026

MCO-1D Commissioning Manual — Revision 18 — August 2026 — Page 2

### TABLE OF CONTENTS

PART I — WHAT THIS AIRCRAFT IS
1. What the MCO-1D Is
2. Eight Wings and Metachronal Cascade
3. Per-Wing Sensing
4. Wing Morphing Programme
5. ODrive S1 Architecture
6. Control System — Three Modes
7. Motor Health Monitoring
8. TC-01 Hover Feasibility Gate
9. Safety Rules
PART II — HARDWARE
10. Wing Assemblies
11. ODrive S1 Controllers
12. Encoder Magnets
13. Brake Resistors
14. Servos and ADC Chips
15. Pitot Tube
16. Load Cell (Bench Only)
17. Flight Computer, Sensors, Power, Radio
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
