wrbell/dad-ornithopter/cad/drawings/v2_assembly_drawing.png

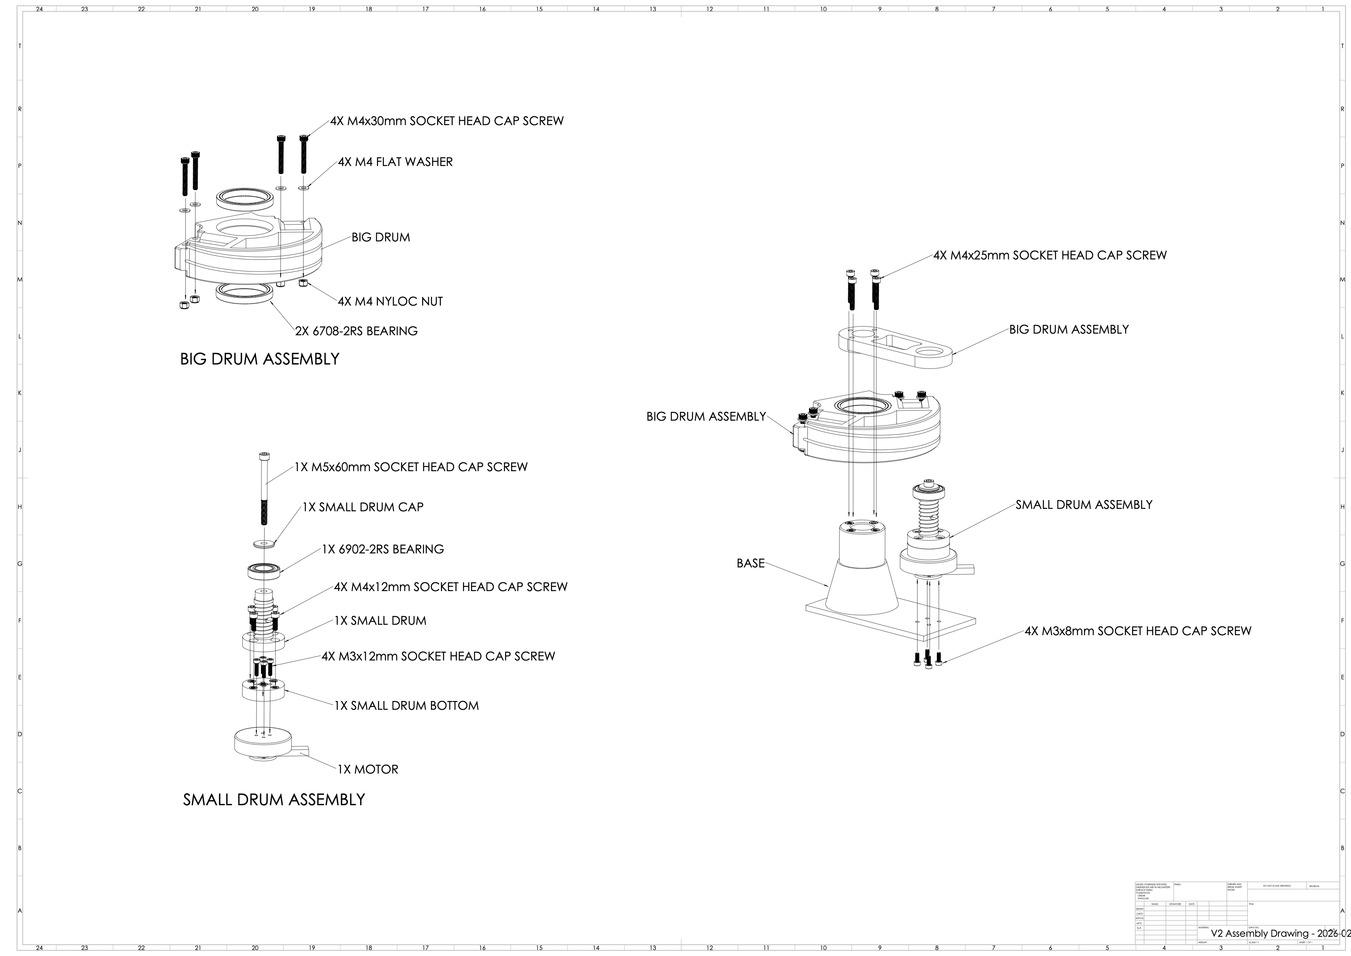
cad/drawings/v2_assembly_drawing.png
