wrbell/dad-ornithopter/cad/drawings/v2_spring_installation_schematic.png

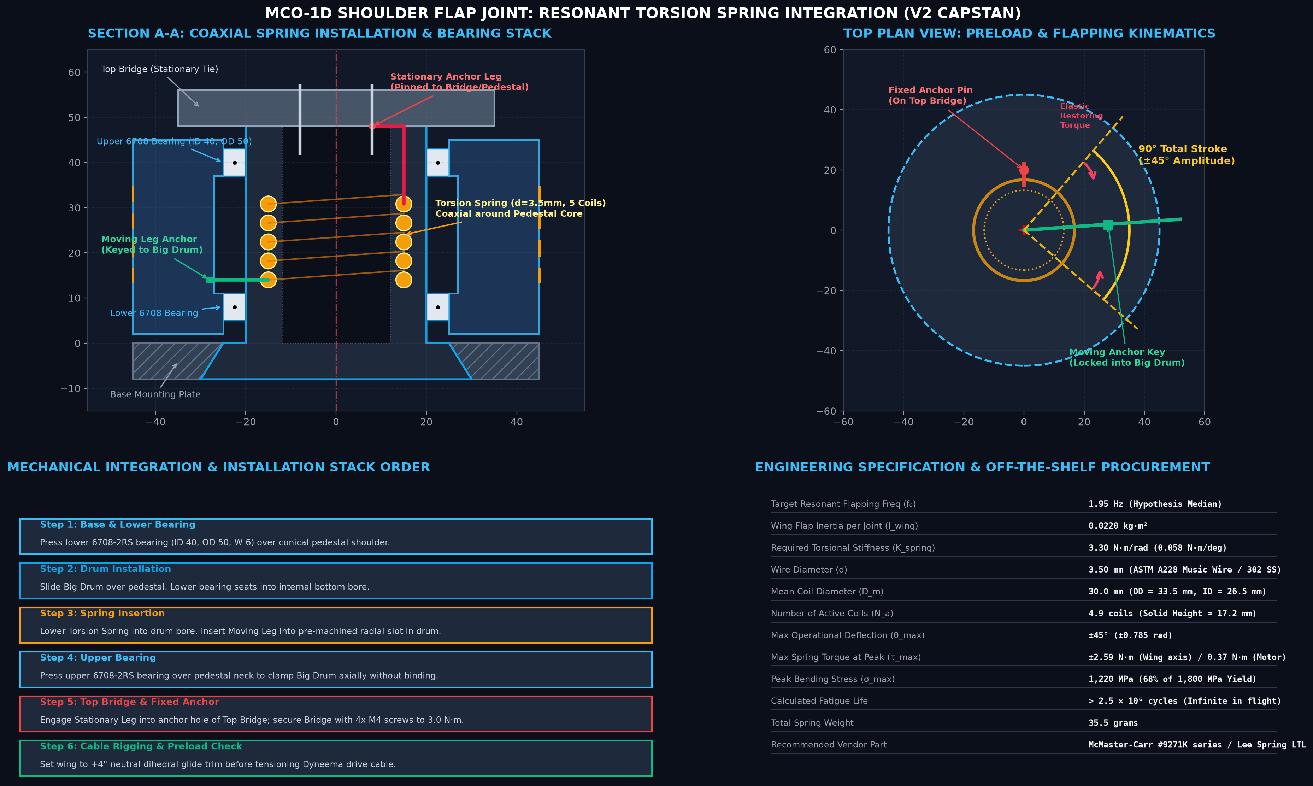
cad/drawings/v2_spring_installation_schematic.png
