wrbell/dad-ornithopter/cad/manufactured/feather_wingtip_blended_preview.png

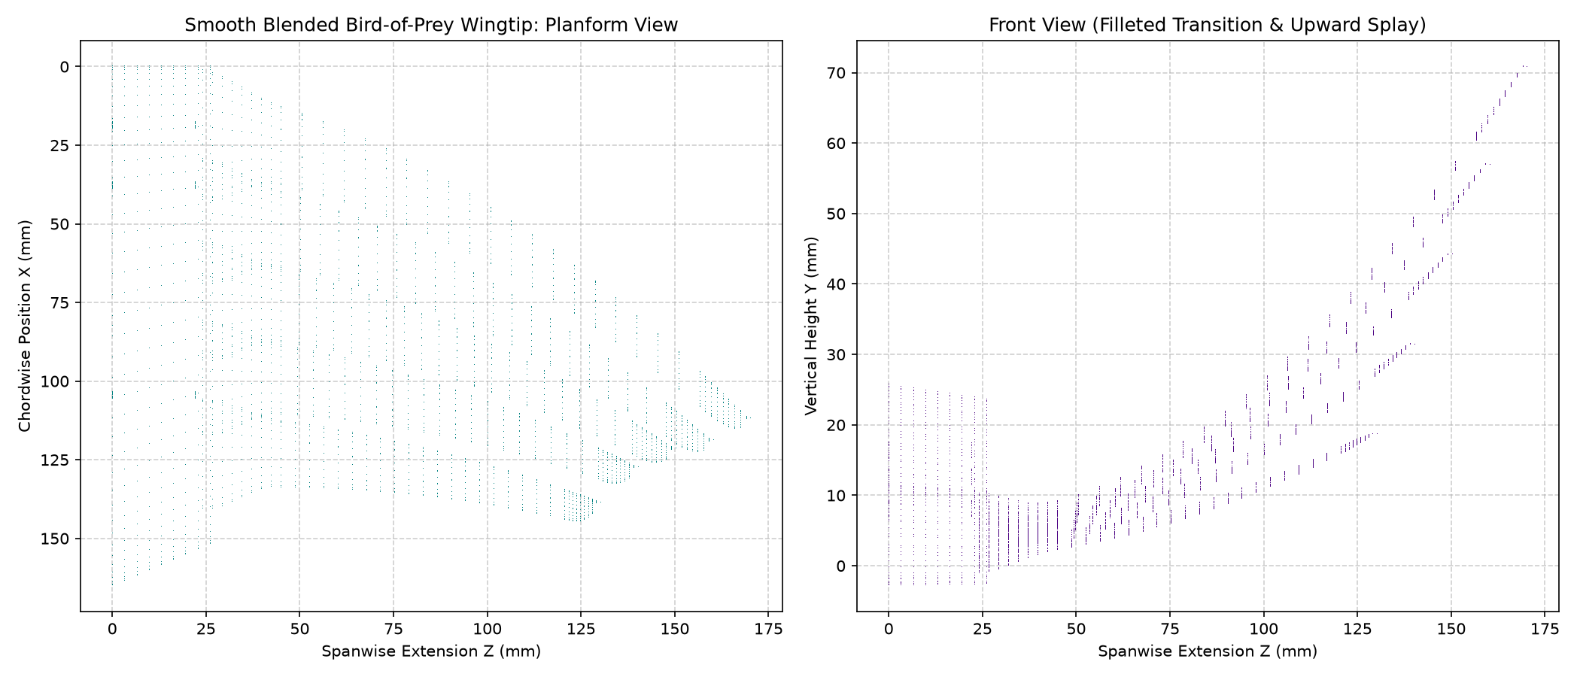
cad/manufactured/feather_wingtip_blended_preview.png
