wrbell/dad-ornithopter/cad/manufactured/feather_wingtip_equidistant_preview.png

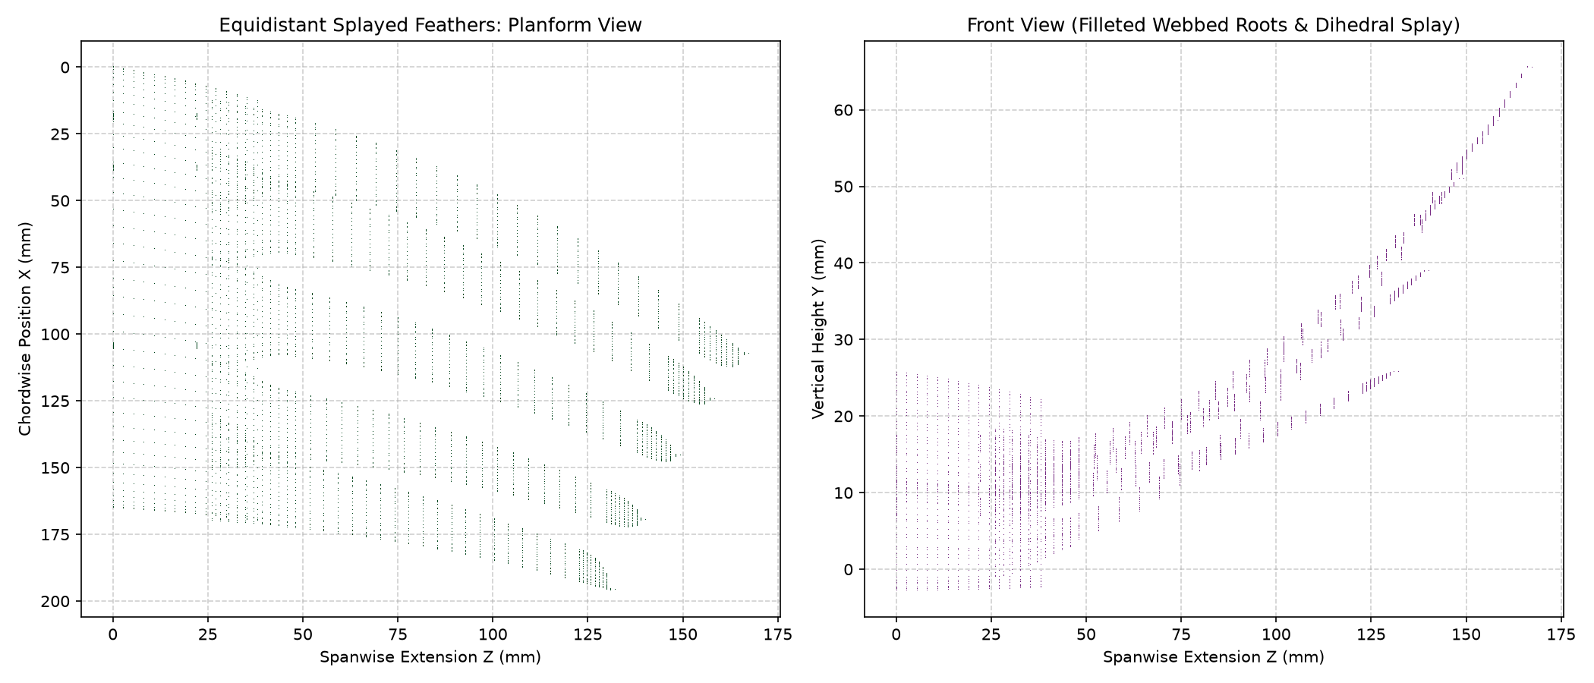
cad/manufactured/feather_wingtip_equidistant_preview.png
