wrbell/dad-ornithopter/cad/manufactured/feather_wingtip_fingers_preview.png

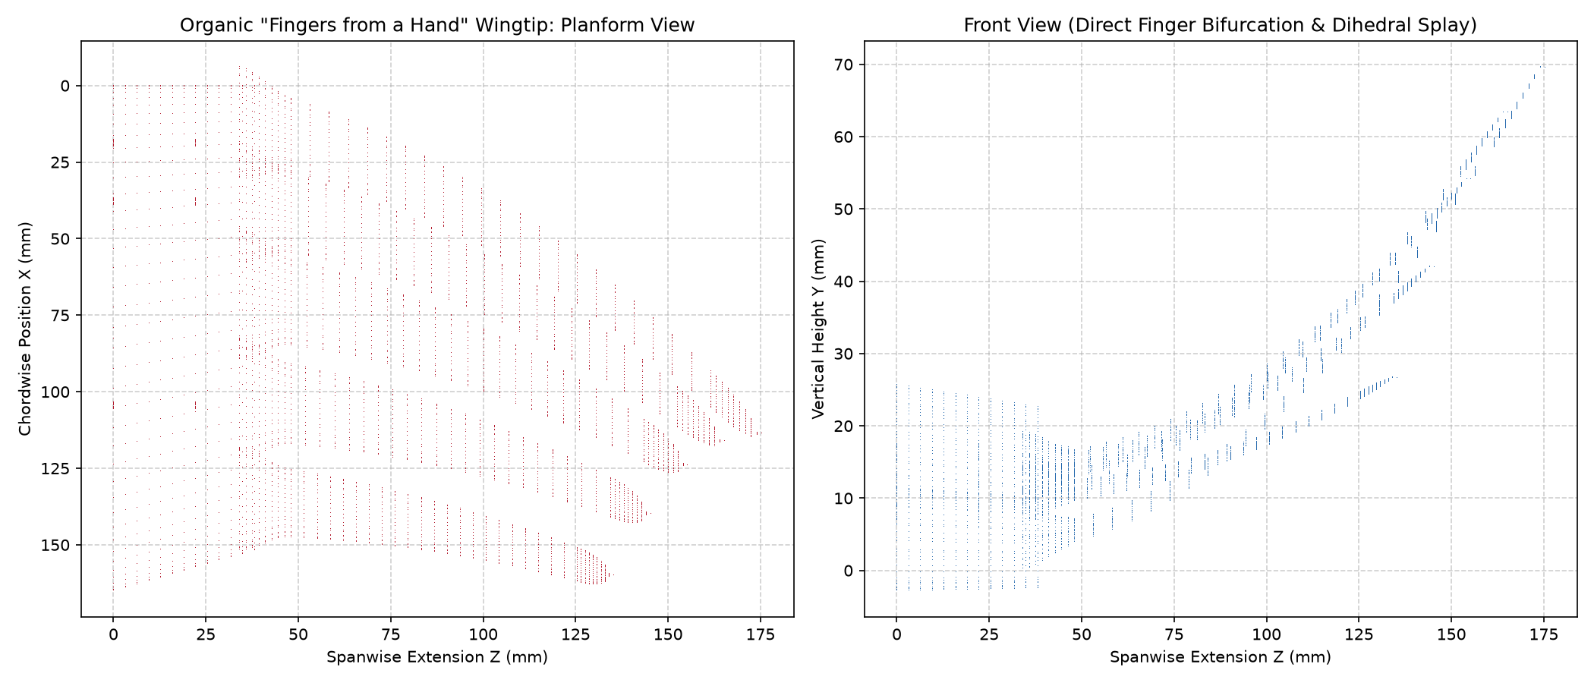
cad/manufactured/feather_wingtip_fingers_preview.png
