wrbell/dad-ornithopter/cad/manufactured/mco_aircraft_photo1_match.png

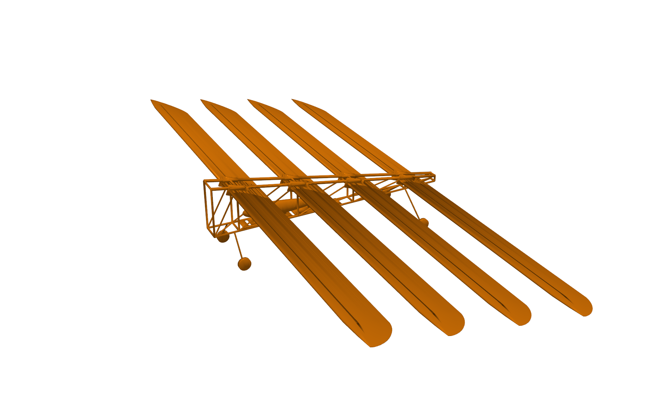
cad/manufactured/mco_aircraft_photo1_match.png
