wrbell/dad-ornithopter/cad/manufactured/mco_aircraft_photo2_match.png

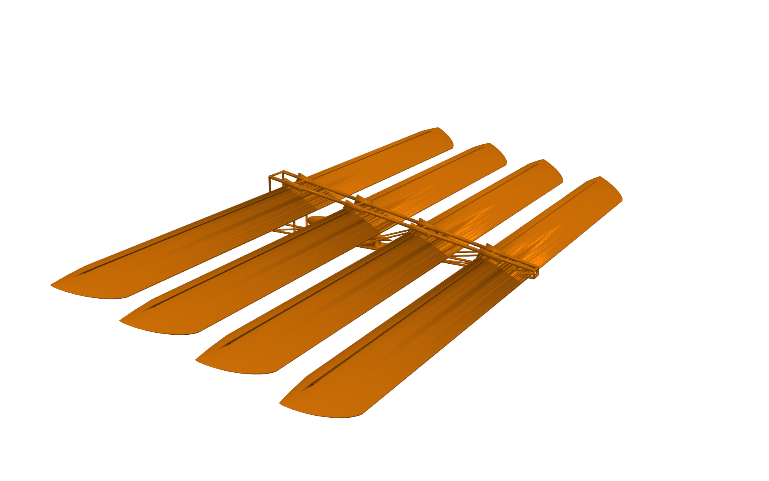
cad/manufactured/mco_aircraft_photo2_match.png
