wrbell/dad-ornithopter/cad/manufactured/mco_aircraft_photo3_match.png

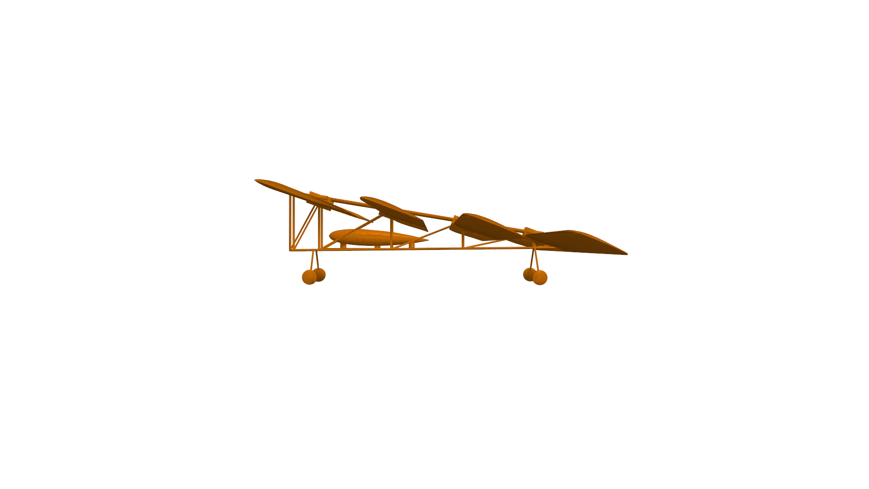
cad/manufactured/mco_aircraft_photo3_match.png
