wrbell/dad-ornithopter/cad/manufactured/mco_aircraft_photo4_match.png

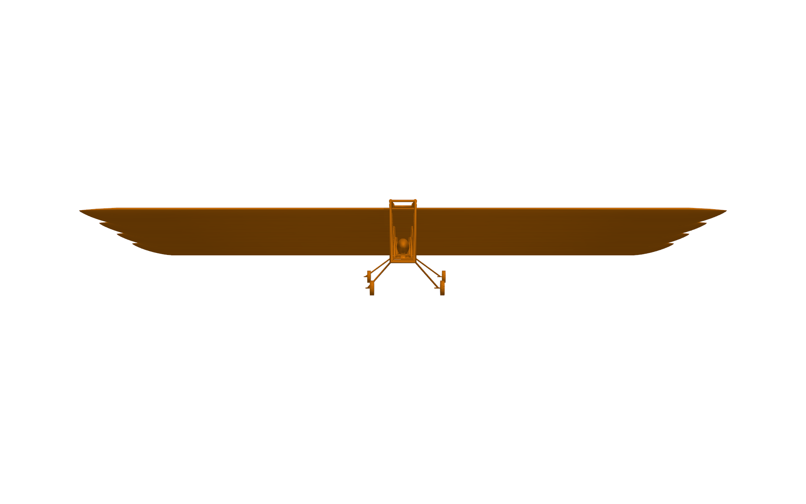
cad/manufactured/mco_aircraft_photo4_match.png
