wrbell/dad-ornithopter/cad/manufactured/mco_core_one_front_wave.png

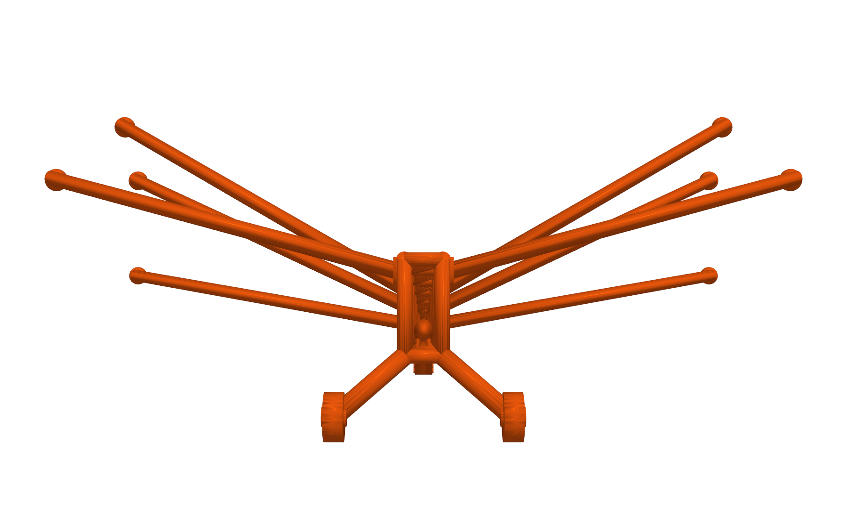
cad/manufactured/mco_core_one_front_wave.png
