wrbell/dad-ornithopter/cad/manufactured/mco_core_one_gear_truss_zoom.png

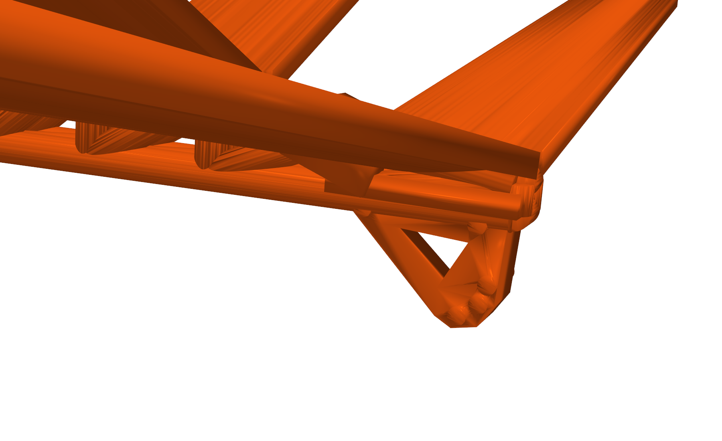
cad/manufactured/mco_core_one_gear_truss_zoom.png
