wrbell/dad-ornithopter/cad/manufactured/mco_core_one_iso_dynamic.png

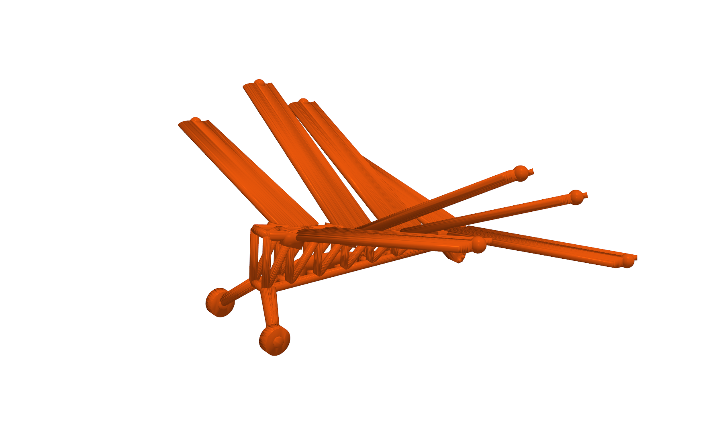
cad/manufactured/mco_core_one_iso_dynamic.png
