wrbell/dad-ornithopter/cad/manufactured/mco_core_one_lego_cockpit_annotated.png

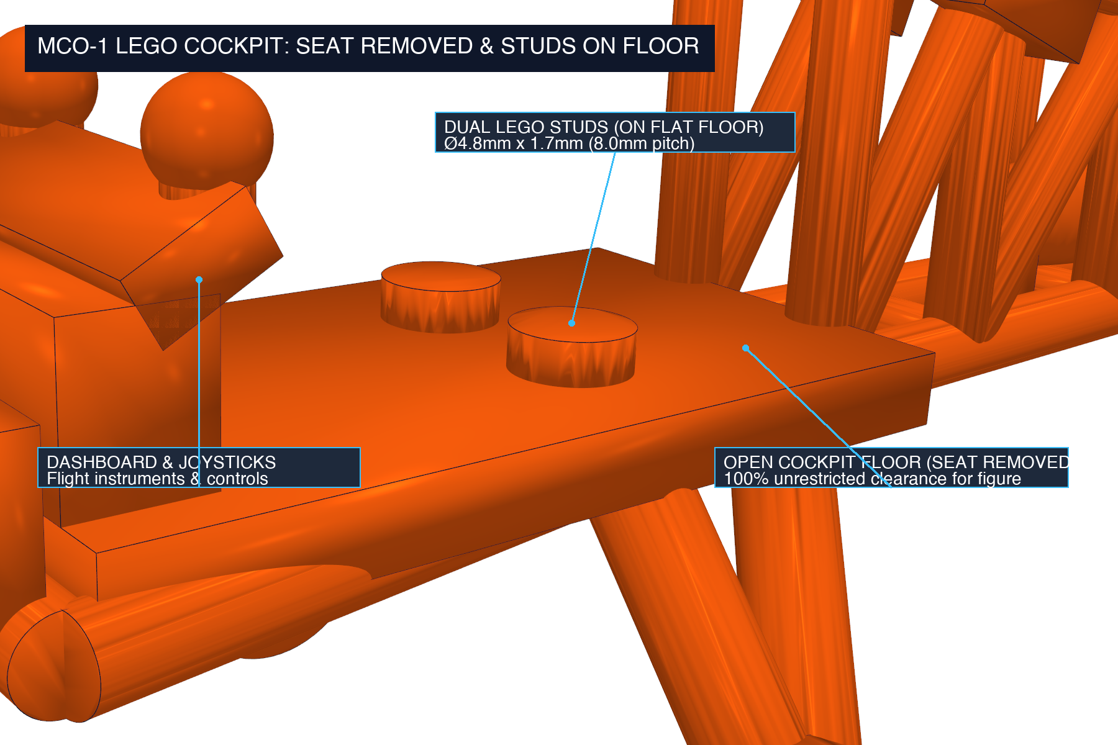
cad/manufactured/mco_core_one_lego_cockpit_annotated.png
