wrbell/dad-ornithopter/cad/manufactured/mco_core_one_lego_cockpit_side.png

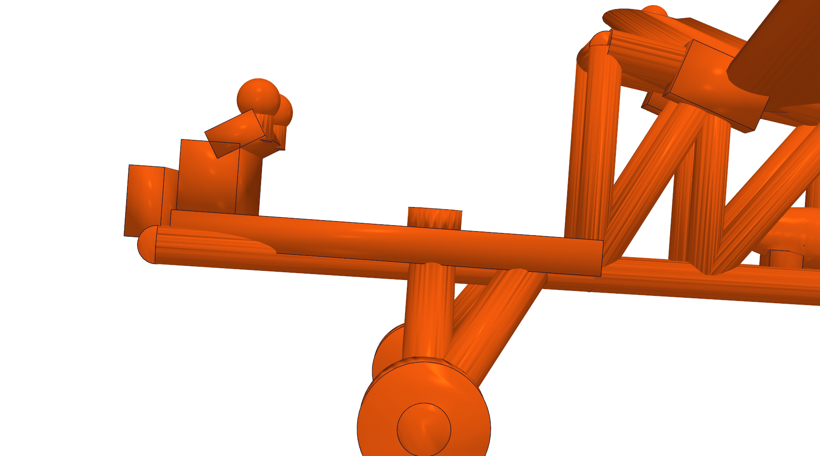
cad/manufactured/mco_core_one_lego_cockpit_side.png
