wrbell/dad-ornithopter/cad/manufactured/mco_core_one_lego_cockpit_top_down.png

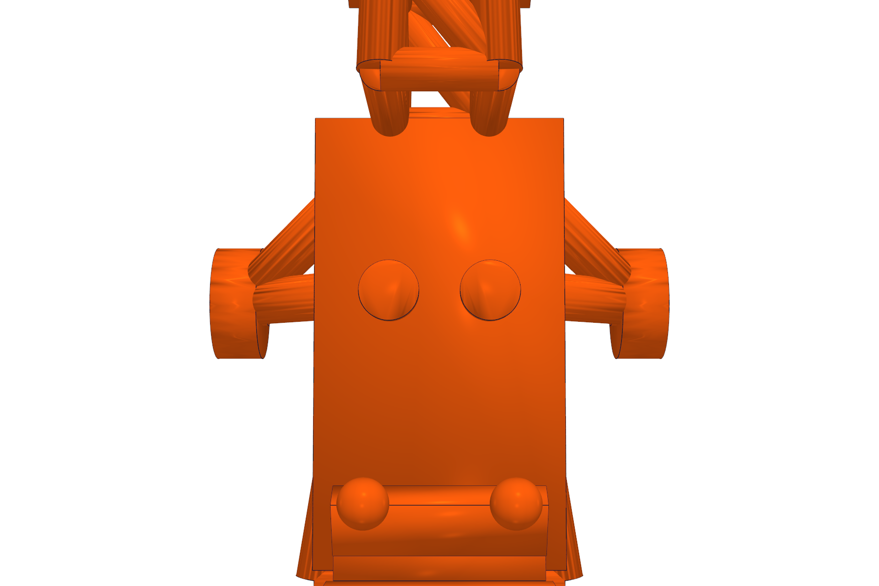
cad/manufactured/mco_core_one_lego_cockpit_top_down.png
