wrbell/dad-ornithopter/cad/manufactured/mco_core_one_lego_front_view.png

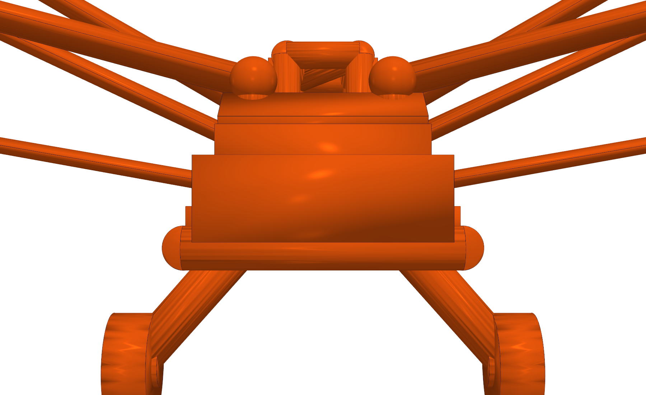
cad/manufactured/mco_core_one_lego_front_view.png
