wrbell/dad-ornithopter/cad/manufactured/mco_core_one_side_profile.png

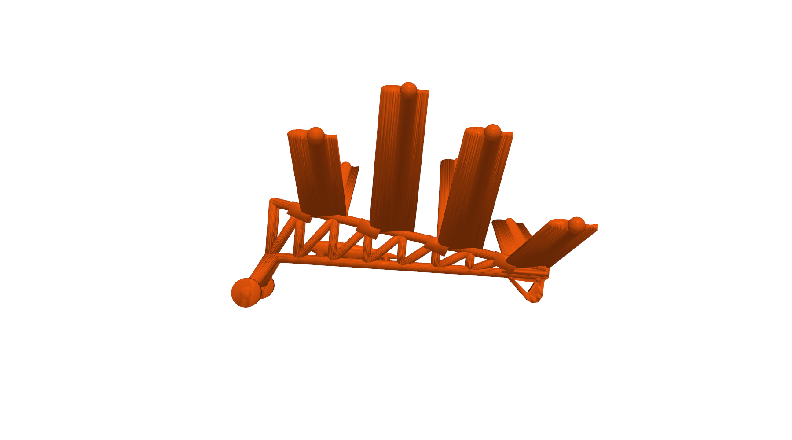
cad/manufactured/mco_core_one_side_profile.png
