wrbell/dad-ornithopter/cad/manufactured/mco_fuselage_front.png

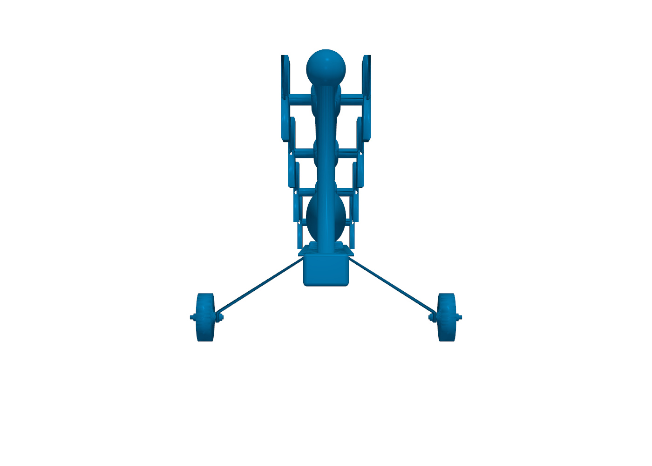
cad/manufactured/mco_fuselage_front.png
