wrbell/dad-ornithopter/cad/manufactured/mco_fuselage_iso.png

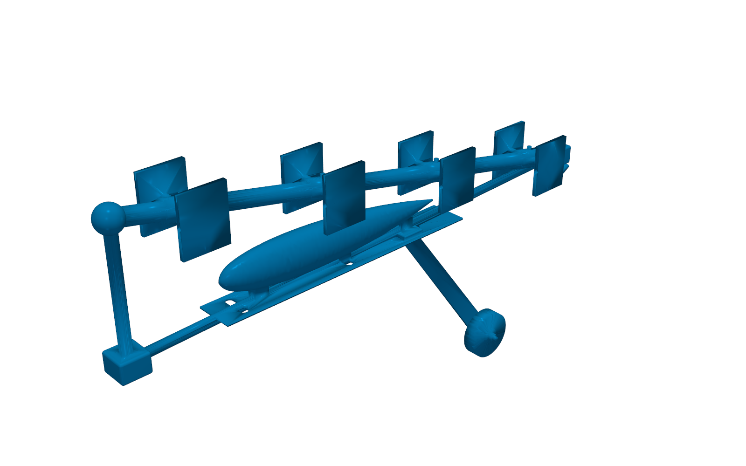
cad/manufactured/mco_fuselage_iso.png
