wrbell/dad-ornithopter/cad/manufactured/mco_fuselage_side.png

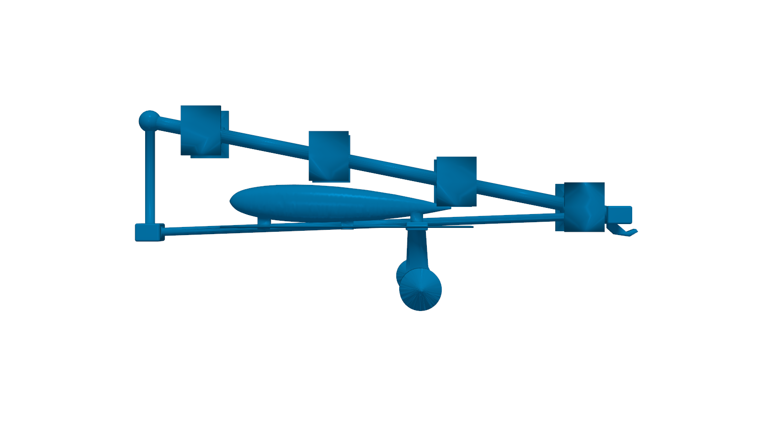
cad/manufactured/mco_fuselage_side.png
