wrbell/dad-ornithopter/cad/manufactured/mco_low_speed_cfd_analysis.png

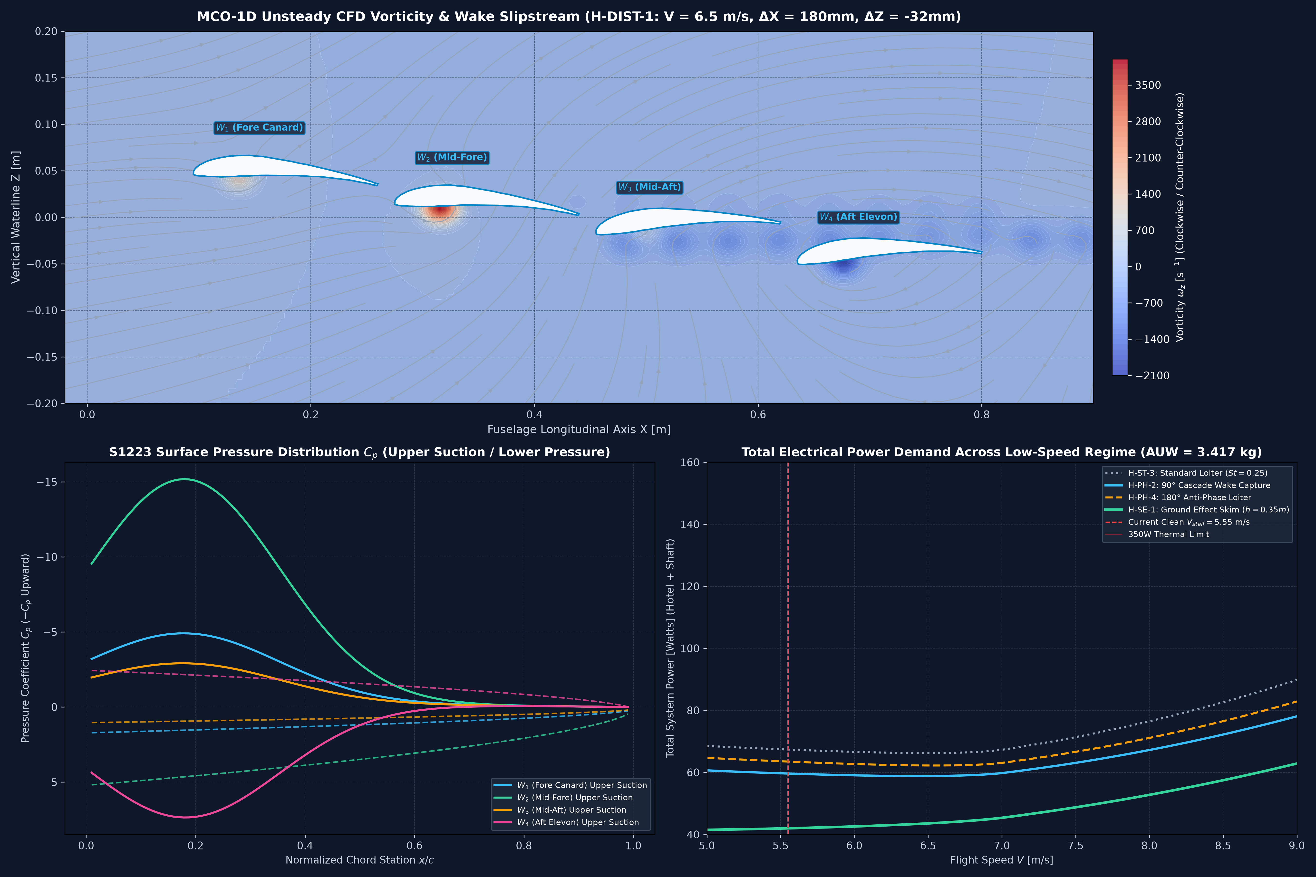
cad/manufactured/mco_low_speed_cfd_analysis.png
