wrbell/dad-ornithopter/cad/manufactured/mco_topological_collar_4view.png

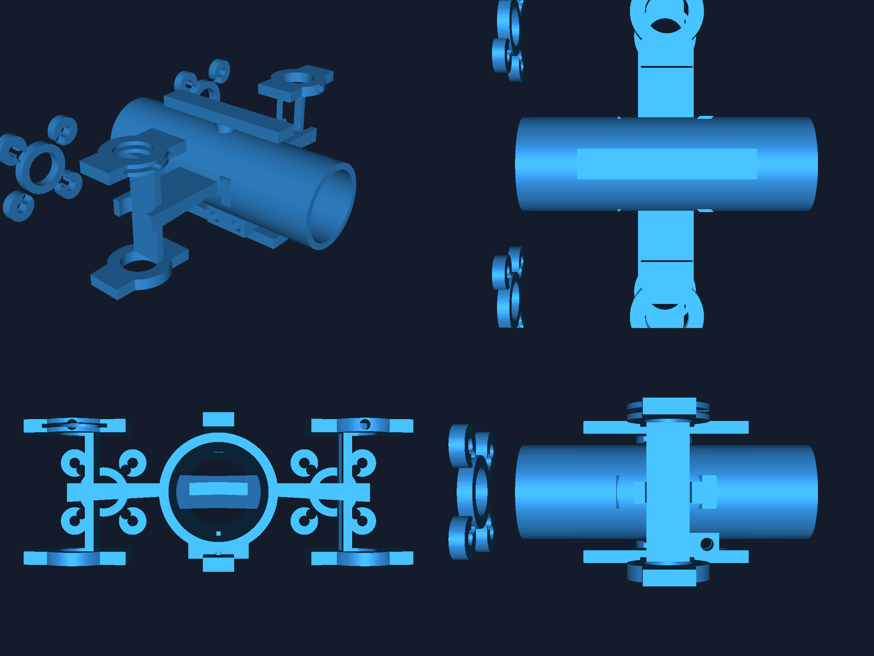
cad/manufactured/mco_topological_collar_4view.png
