wrbell/dad-ornithopter/cad/manufactured/nobrim_yak50e_1.jpg

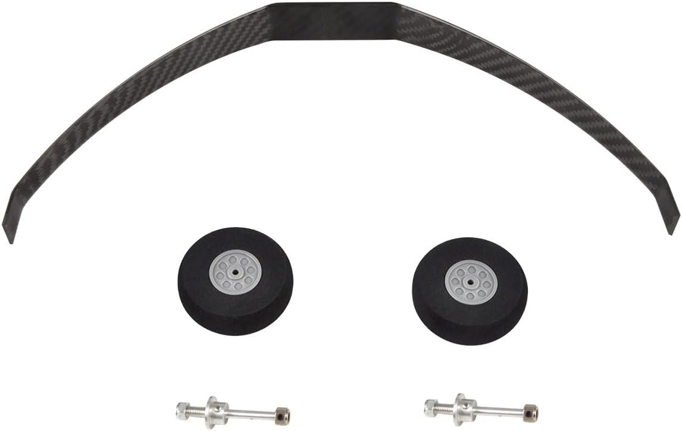
cad/manufactured/nobrim_yak50e_1.jpg
