wrbell/dad-ornithopter/cad/manufactured/nobrim_yak50e_2.jpg

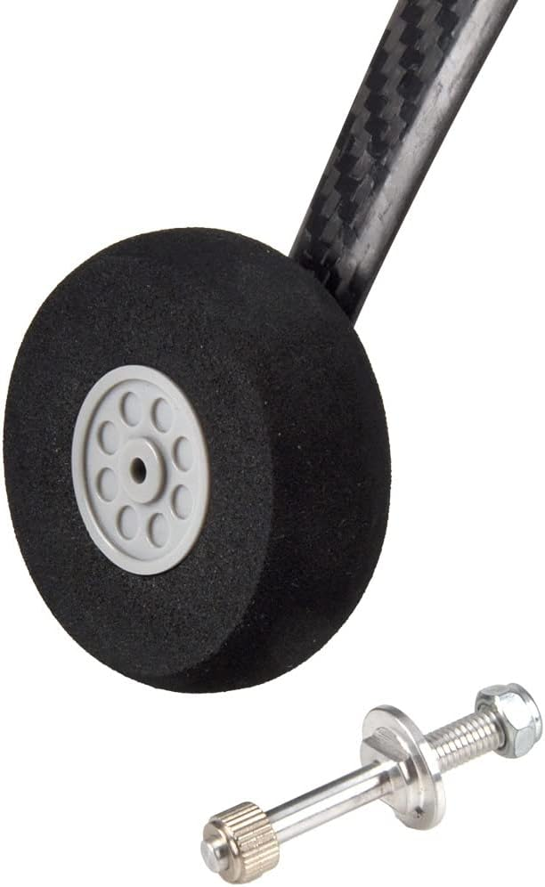
cad/manufactured/nobrim_yak50e_2.jpg
