wrbell/dad-ornithopter/cad/manufactured/nobrim_yak50e_3.jpg

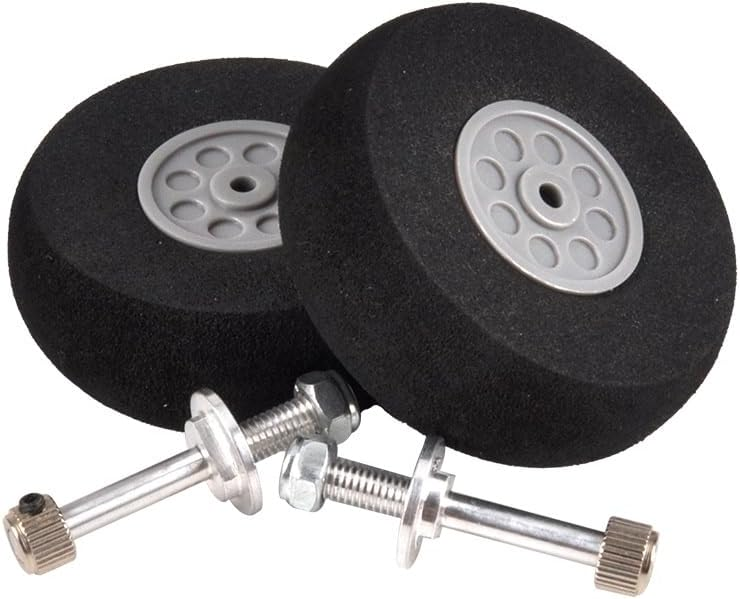
cad/manufactured/nobrim_yak50e_3.jpg
