wrbell/dad-ornithopter/cad/manufactured/nobrim_yak50e_dims.jpg

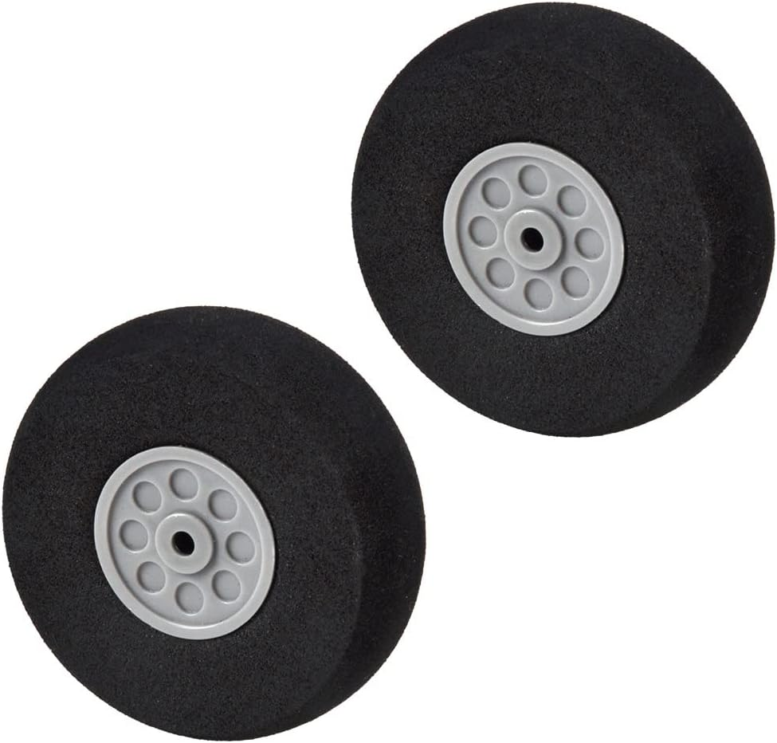
cad/manufactured/nobrim_yak50e_dims.jpg
