wrbell/dad-ornithopter/cad/manufactured/palm_v2_4view.png

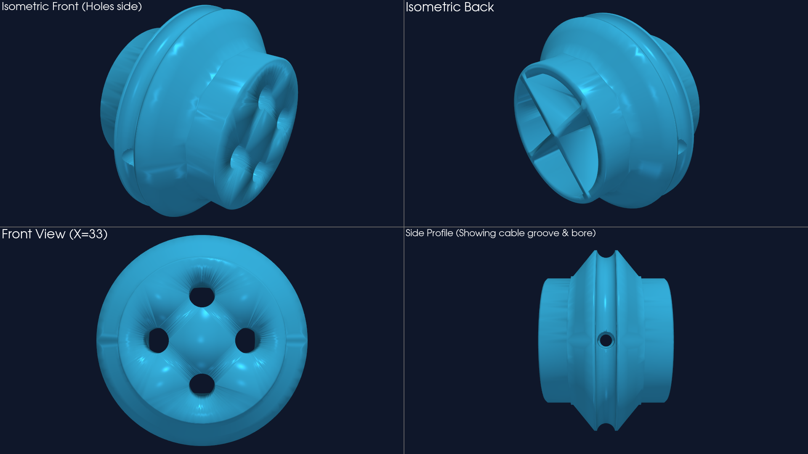
cad/manufactured/palm_v2_4view.png
