wrbell/dad-ornithopter/cad/manufactured/renders/01_isometric_without_fairing.png

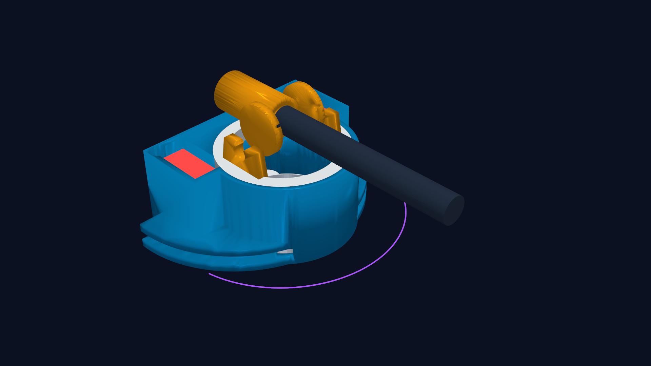
cad/manufactured/renders/01_isometric_without_fairing.png
