wrbell/dad-ornithopter/cad/manufactured/renders/02_isometric_with_fairing_translucent.png

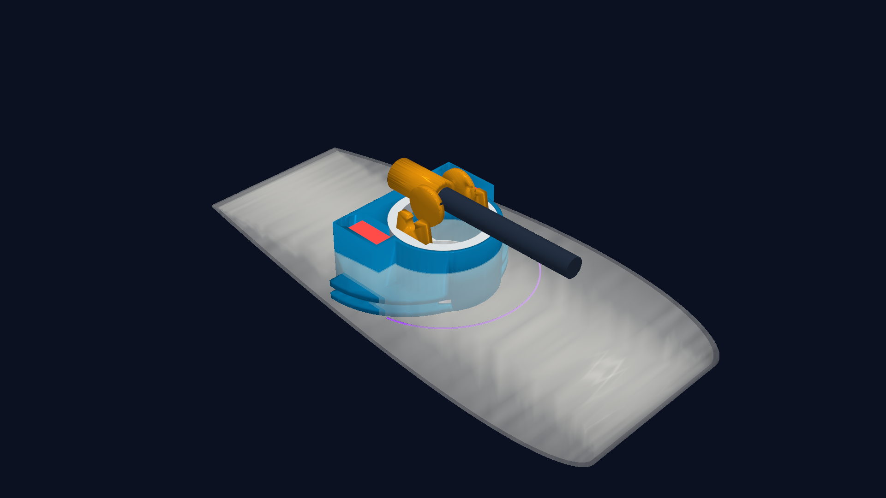
cad/manufactured/renders/02_isometric_with_fairing_translucent.png
