wrbell/dad-ornithopter/cad/manufactured/renders/04_top_without_fairing.png

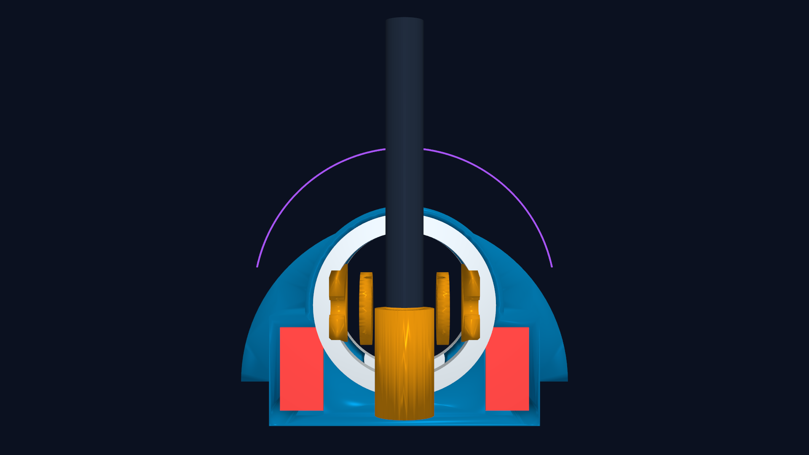
cad/manufactured/renders/04_top_without_fairing.png
