wrbell/dad-ornithopter/cad/manufactured/renders/05_top_with_fairing.png

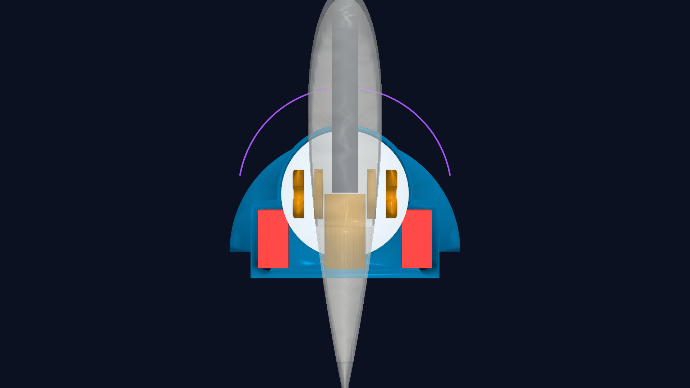
cad/manufactured/renders/05_top_with_fairing.png
