wrbell/dad-ornithopter/cad/manufactured/renders/05_top_with_fairing_translucent.png

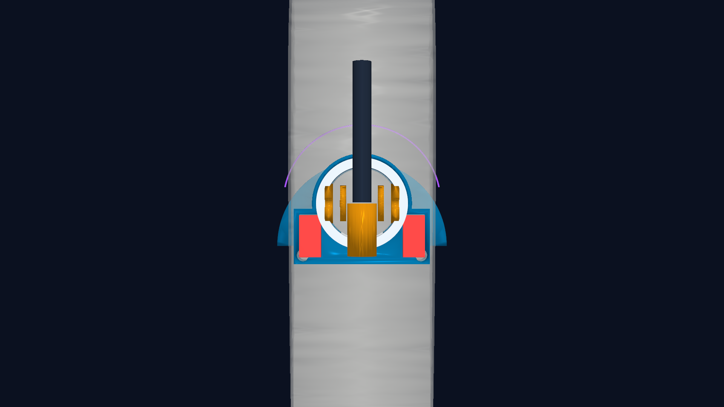
cad/manufactured/renders/05_top_with_fairing_translucent.png
