wrbell/dad-ornithopter/cad/manufactured/renders/06_front_without_fairing.png

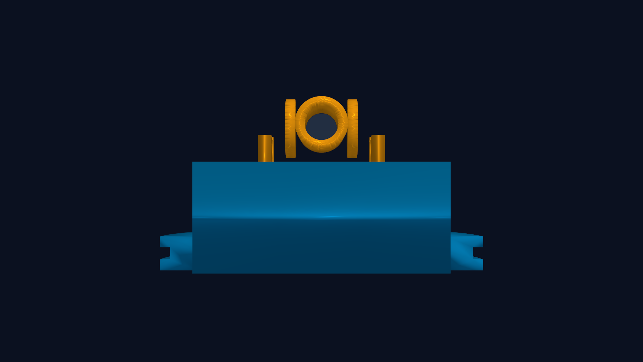
cad/manufactured/renders/06_front_without_fairing.png
