wrbell/dad-ornithopter/cad/manufactured/renders/07_front_with_fairing.png

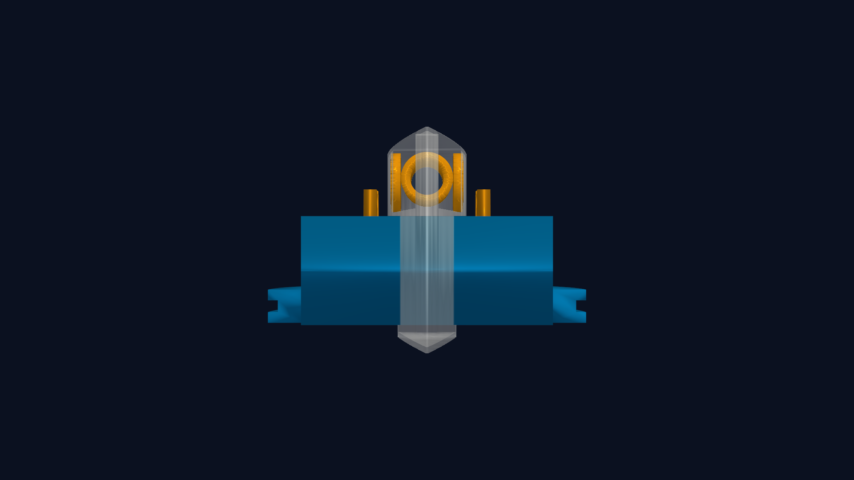
cad/manufactured/renders/07_front_with_fairing.png
