wrbell/dad-ornithopter/cad/manufactured/renders/08_side_with_fairing_translucent.png

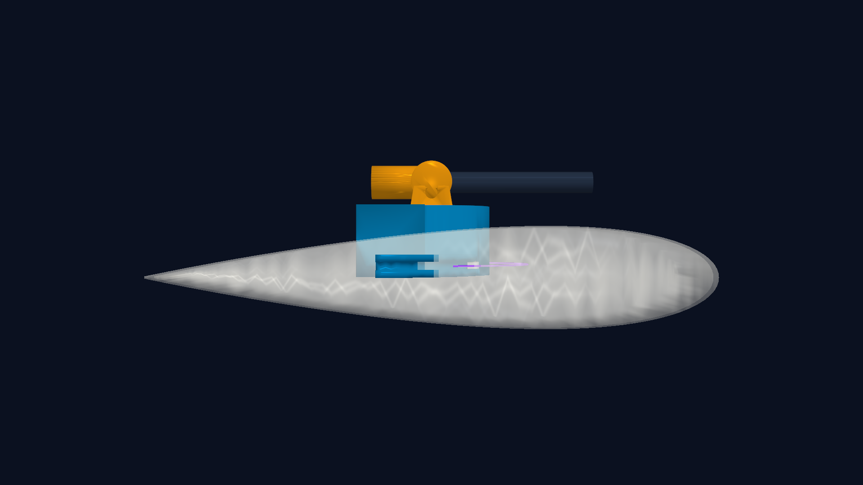
cad/manufactured/renders/08_side_with_fairing_translucent.png
