wrbell/dad-ornithopter/cad/manufactured/renders/09_side_with_fairing.png

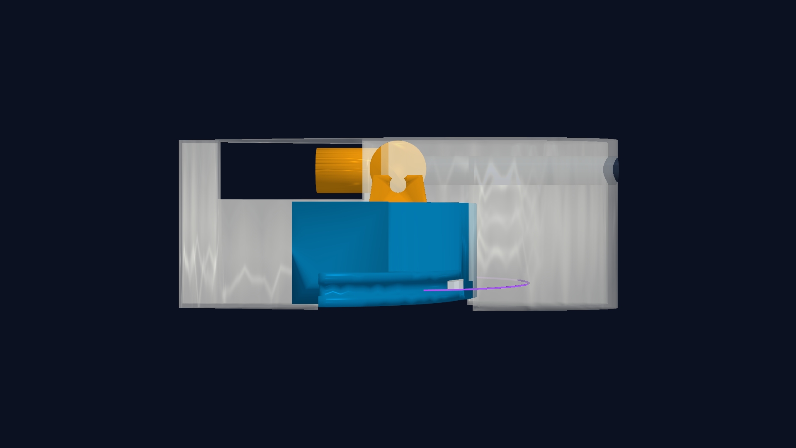
cad/manufactured/renders/09_side_with_fairing.png
