wrbell/dad-ornithopter/cad/manufactured/renders/11_rear_quarter_with_fairing.png

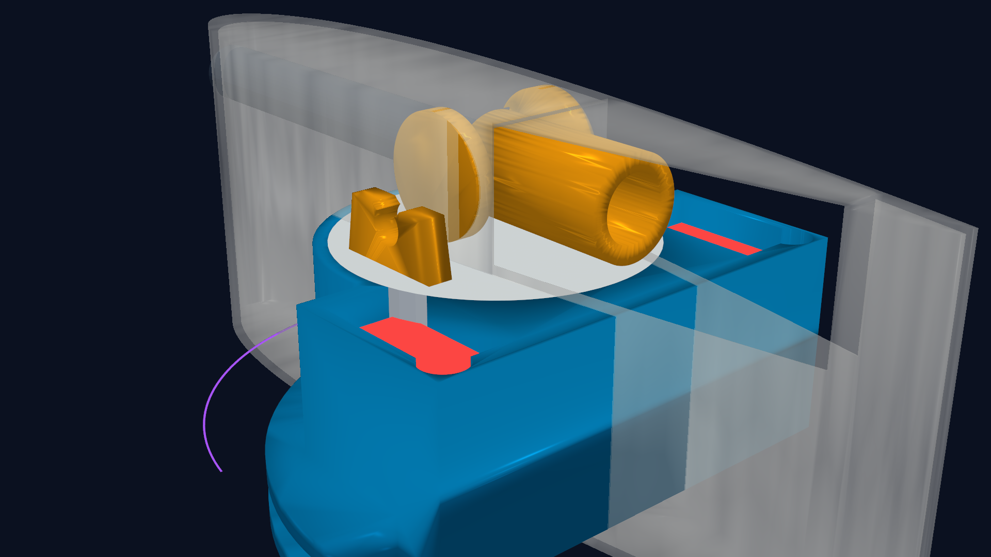
cad/manufactured/renders/11_rear_quarter_with_fairing.png
