wrbell/dad-ornithopter/cad/manufactured/renders/12_rear_quarter_without_fairing.png

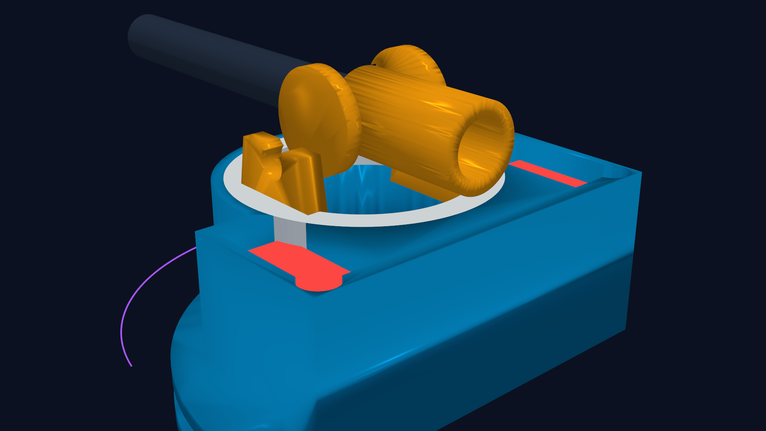
cad/manufactured/renders/12_rear_quarter_without_fairing.png
