wrbell/dad-ornithopter/cad/manufactured/renders/13_rear_quarter_with_fairing.png

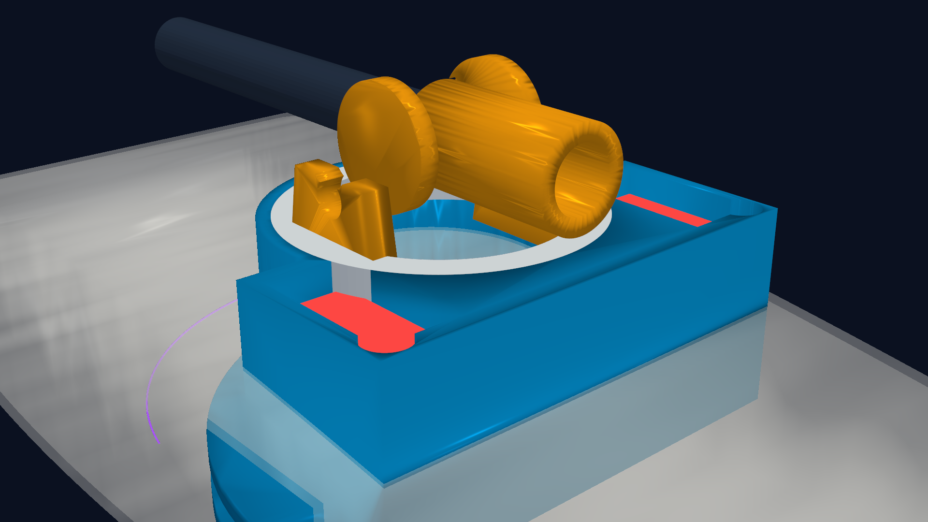
cad/manufactured/renders/13_rear_quarter_with_fairing.png
