wrbell/dad-ornithopter/cad/manufactured/renders_exploded/mco_01_hierarchical_exploded_isometric.png

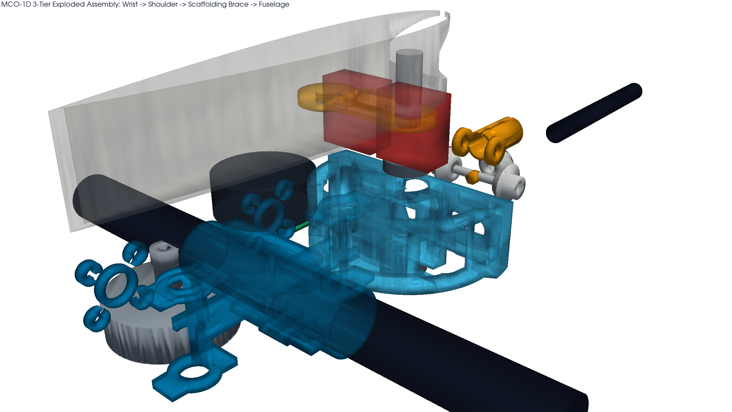
cad/manufactured/renders_exploded/mco_01_hierarchical_exploded_isometric.png
