wrbell/dad-ornithopter/cad/manufactured/renders_exploded/mco_02_wrist_to_shoulder_closeup.png

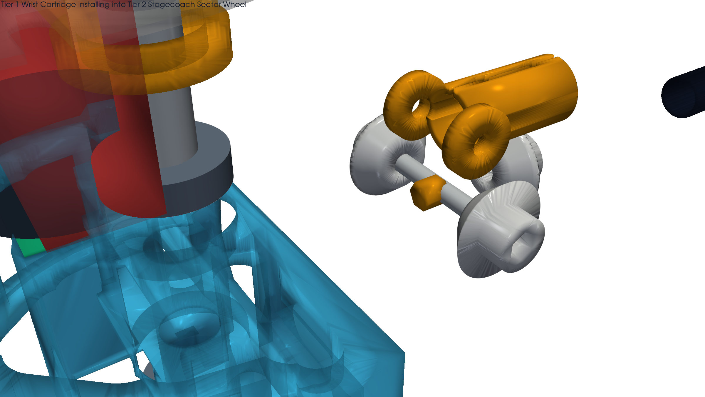
cad/manufactured/renders_exploded/mco_02_wrist_to_shoulder_closeup.png
