wrbell/dad-ornithopter/cad/manufactured/renders_exploded/mco_03_shoulder_to_scaffolding_brace.png

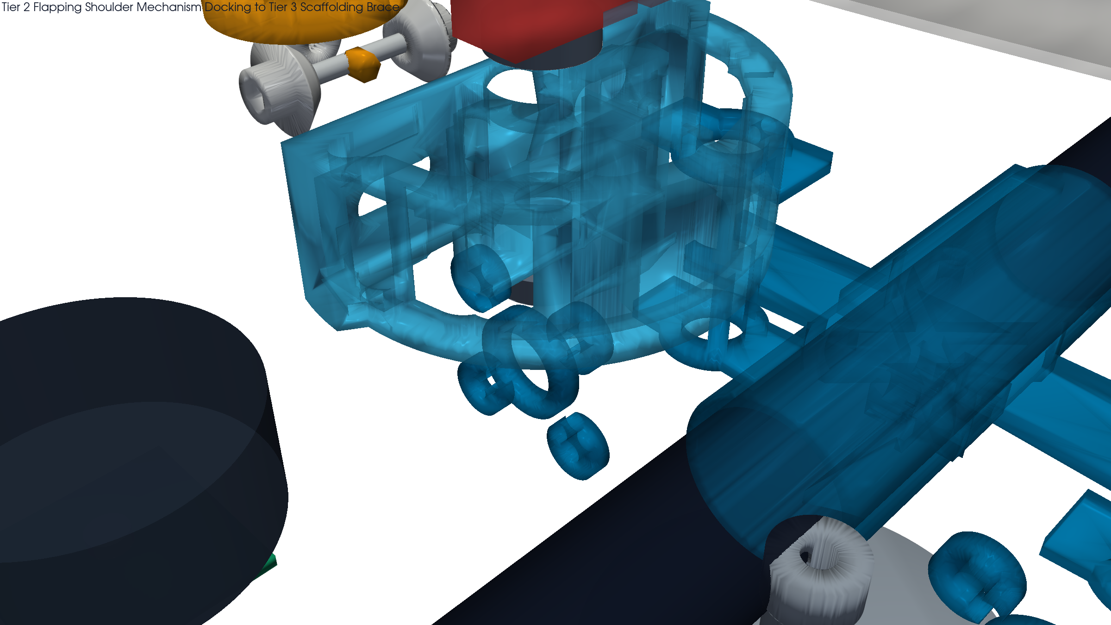
cad/manufactured/renders_exploded/mco_03_shoulder_to_scaffolding_brace.png
