wrbell/dad-ornithopter/cad/manufactured/renders_exploded/mco_04_side_elevation_exploded.png

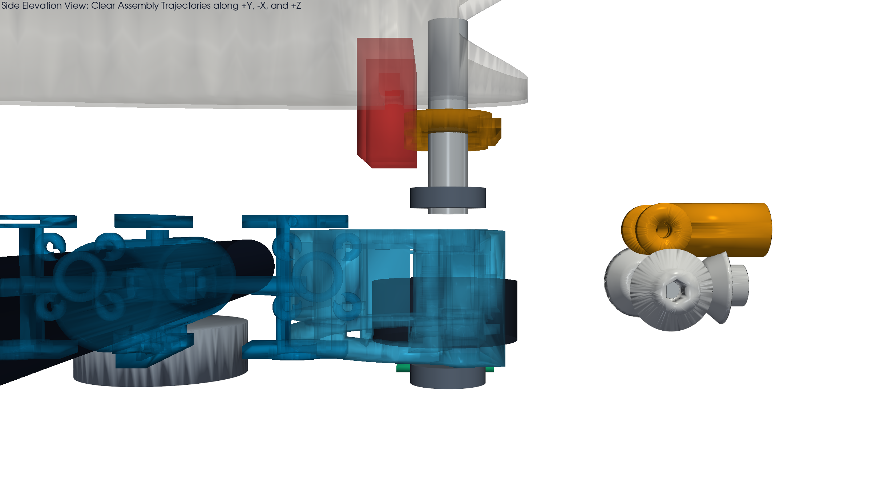
cad/manufactured/renders_exploded/mco_04_side_elevation_exploded.png
