wrbell/dad-ornithopter/cad/manufactured/renders_package/plate_01_bed_layout_isometric.png

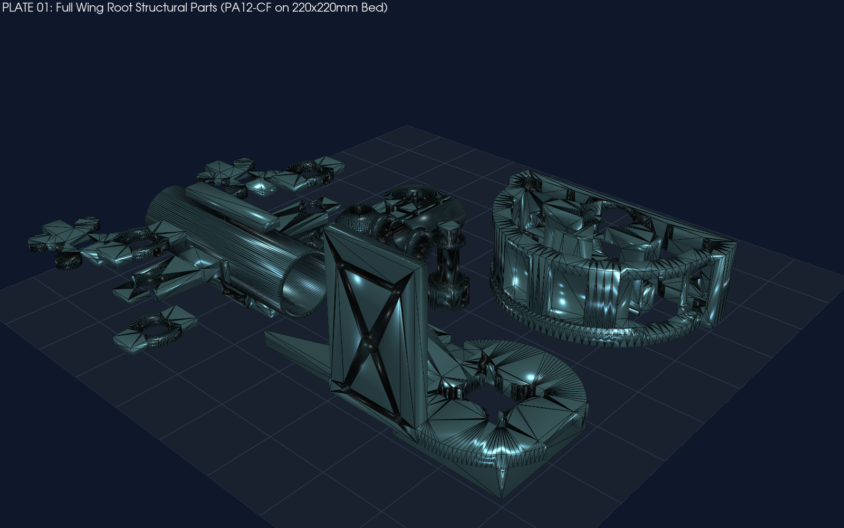
cad/manufactured/renders_package/plate_01_bed_layout_isometric.png
