wrbell/dad-ornithopter/cad/manufactured/renders_package/plate_01_bed_layout_top_down.png

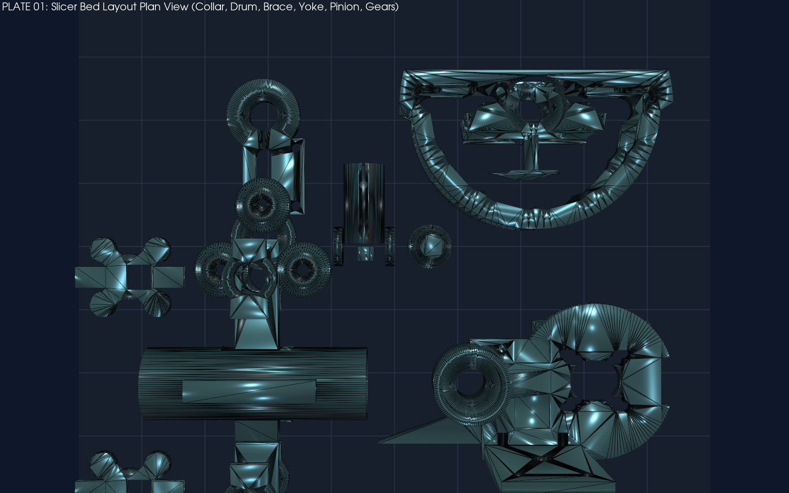
cad/manufactured/renders_package/plate_01_bed_layout_top_down.png
