wrbell/dad-ornithopter/cad/manufactured/renders_v10/v10_01_isometric_stagecoach_drum.png

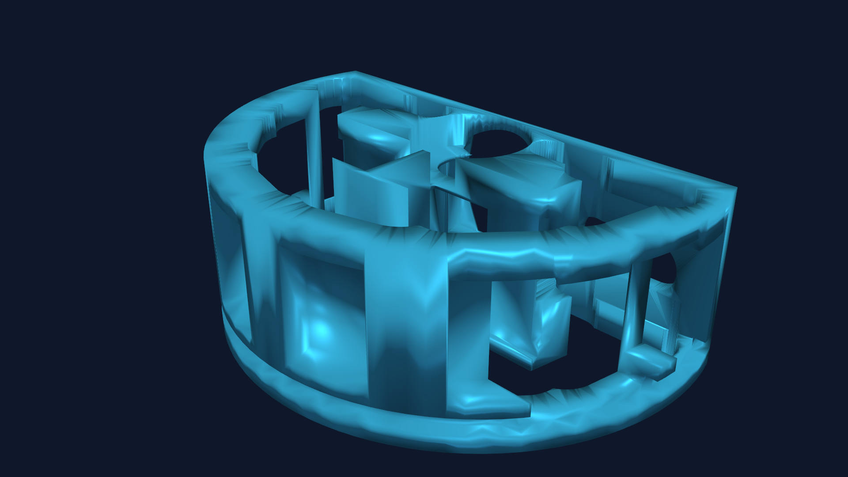
cad/manufactured/renders_v10/v10_01_isometric_stagecoach_drum.png
