wrbell/dad-ornithopter/cad/manufactured/renders_v10/v10_02_side_profile_servo_cooling_gates.png

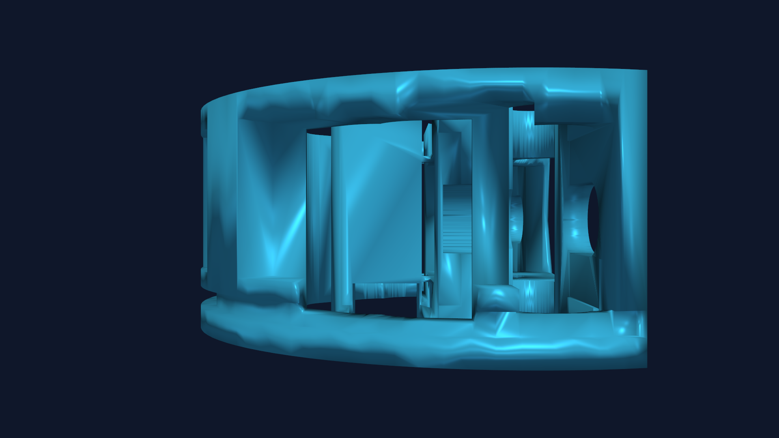
cad/manufactured/renders_v10/v10_02_side_profile_servo_cooling_gates.png
