wrbell/dad-ornithopter/cad/manufactured/renders_v10/v10_03_top_planform_stagecoach_spokes.png

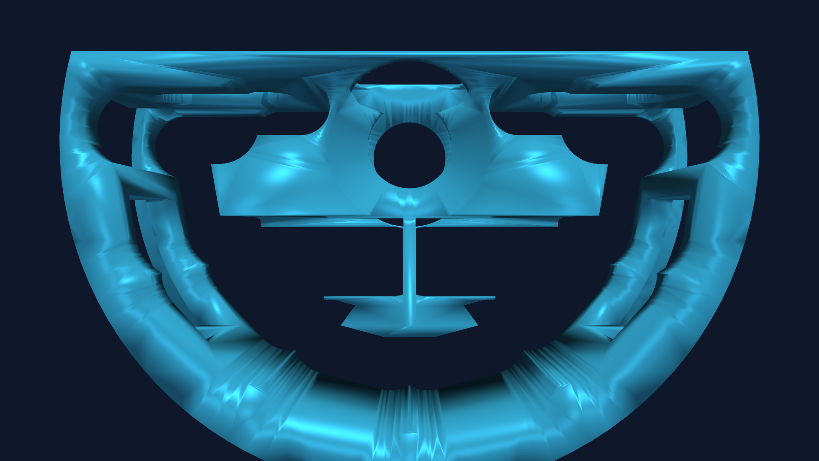
cad/manufactured/renders_v10/v10_03_top_planform_stagecoach_spokes.png
