wrbell/dad-ornithopter/cad/manufactured/renders_v10/v10_04_front_elevation_ram_air_vents.png

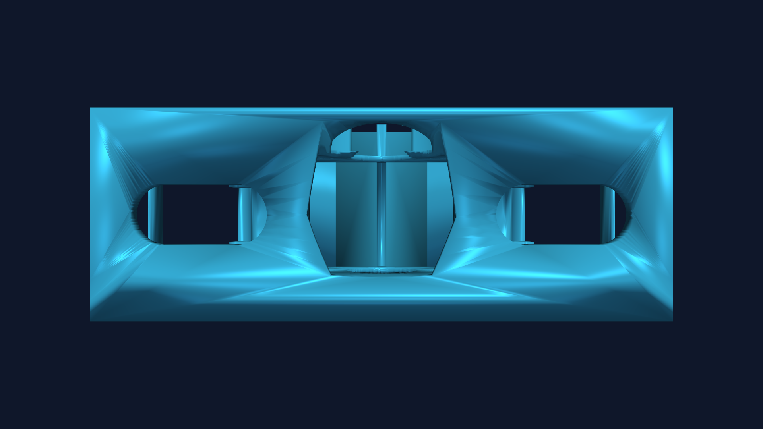
cad/manufactured/renders_v10/v10_04_front_elevation_ram_air_vents.png
