wrbell/dad-ornithopter/cad/manufactured/renders_v10/v10_05_bottom_perspective_chimney_draft.png

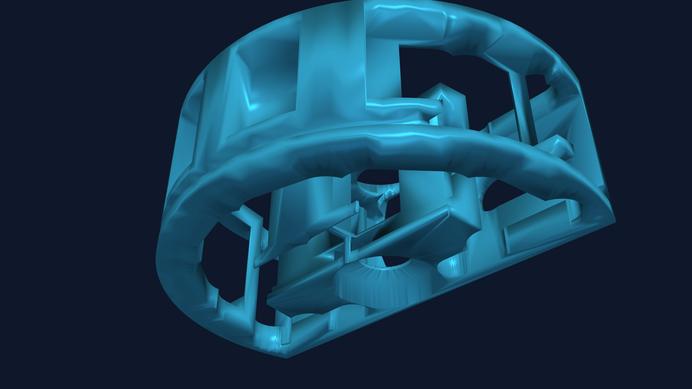
cad/manufactured/renders_v10/v10_05_bottom_perspective_chimney_draft.png
