wrbell/dad-ornithopter/cad/manufactured/renders_v10/v10_06_differential_assembly_integration.png

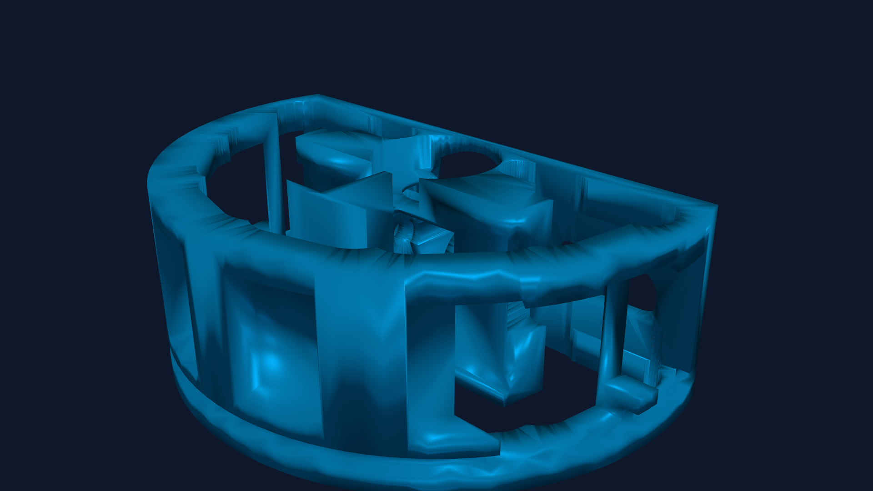
cad/manufactured/renders_v10/v10_06_differential_assembly_integration.png
