wrbell/dad-ornithopter/cad/manufactured/renders_v10/v10_powertrain_01_full_assembly_isometric.png

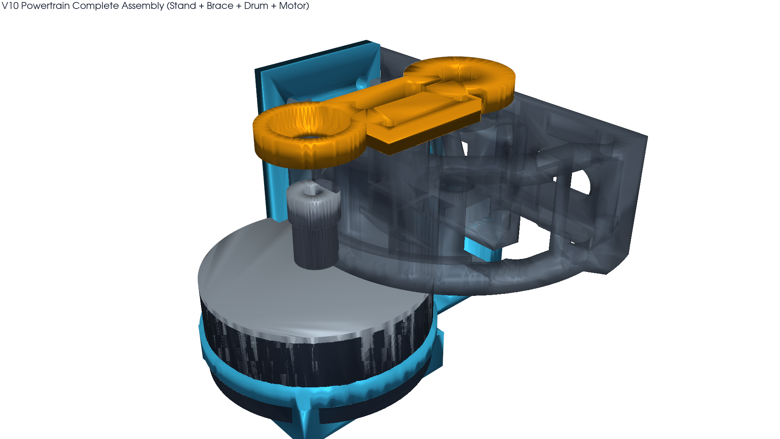
cad/manufactured/renders_v10/v10_powertrain_01_full_assembly_isometric.png
