wrbell/dad-ornithopter/cad/manufactured/renders_v10/v10_powertrain_03_sector_wheel_groove_and_bumpers.png

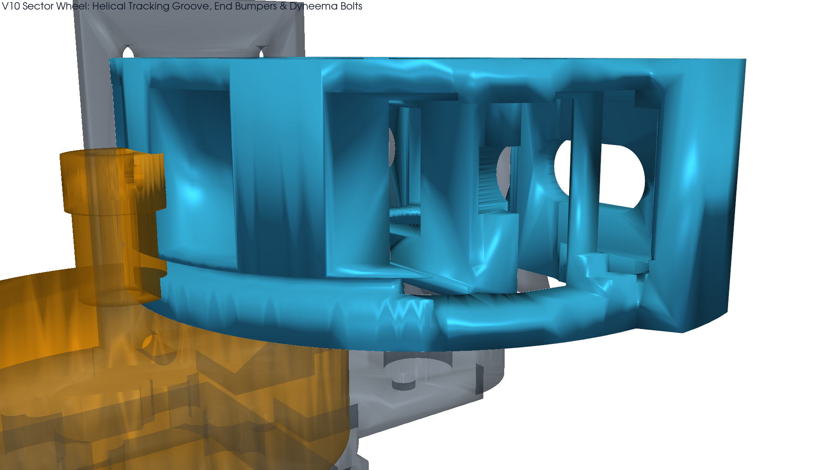
cad/manufactured/renders_v10/v10_powertrain_03_sector_wheel_groove_and_bumpers.png
