wrbell/dad-ornithopter/cad/manufactured/renders_v10/v10_powertrain_04_fuselage_spine_interface.png

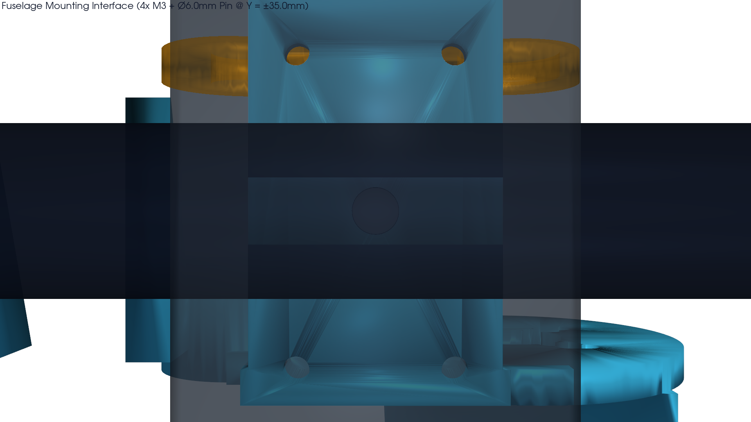
cad/manufactured/renders_v10/v10_powertrain_04_fuselage_spine_interface.png
