wrbell/dad-ornithopter/cad/manufactured/renders_v10/v10_powertrain_05_dual_shear_box_truss_elevation.png

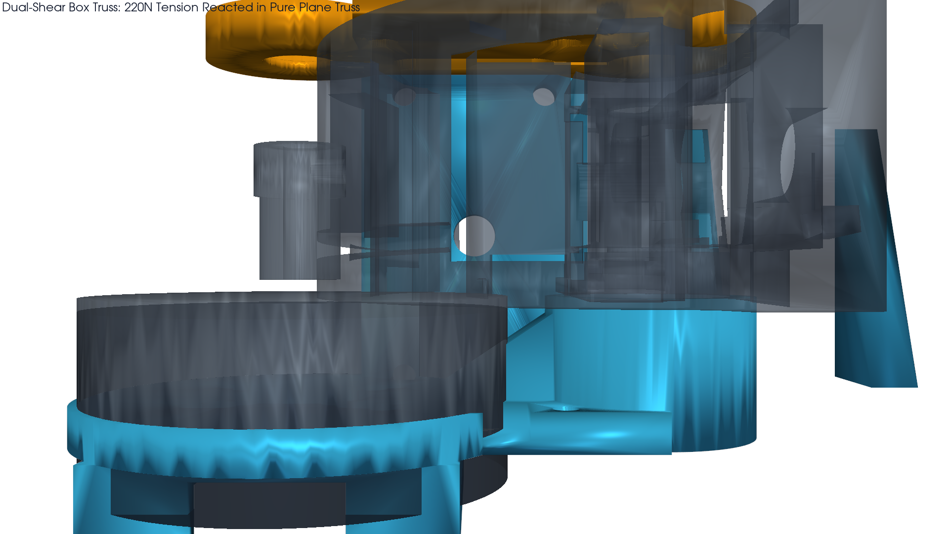
cad/manufactured/renders_v10/v10_powertrain_05_dual_shear_box_truss_elevation.png
