wrbell/dad-ornithopter/cad/manufactured/s1223_full_wing_skeleton_assembly.png

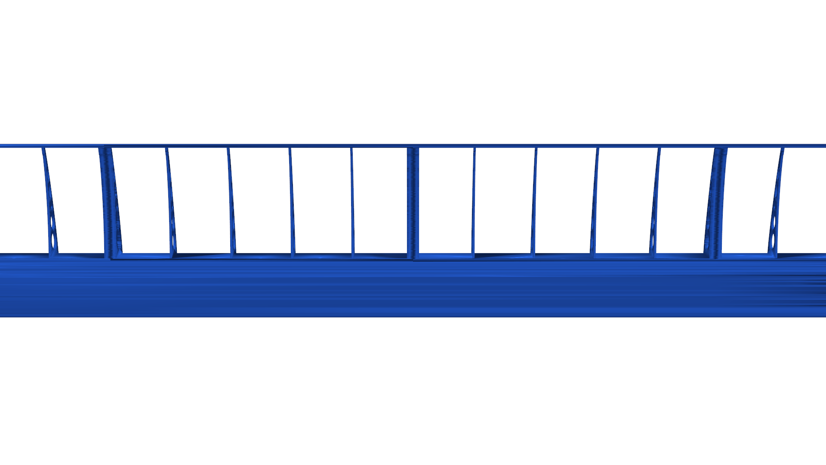
cad/manufactured/s1223_full_wing_skeleton_assembly.png
