wrbell/dad-ornithopter/cad/manufactured/s1223_matched_joint_zoom.png

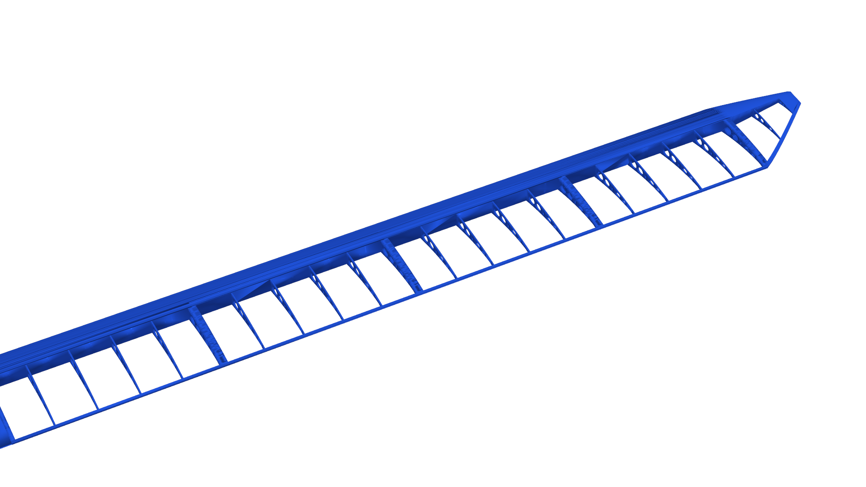
cad/manufactured/s1223_matched_joint_zoom.png
