wrbell/dad-ornithopter/cad/manufactured/s1223_matched_mount.png

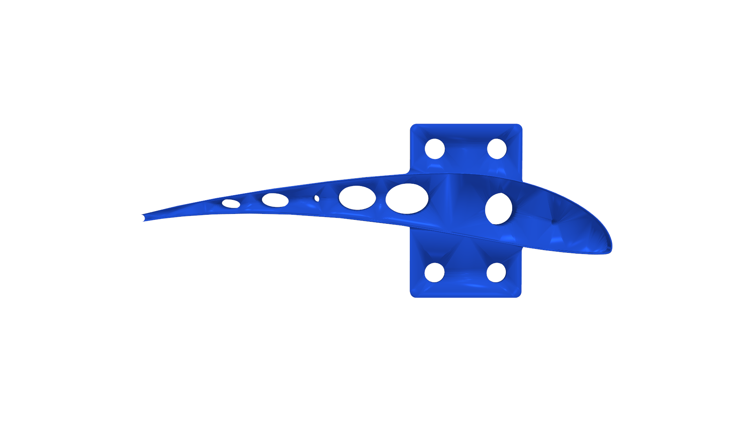
cad/manufactured/s1223_matched_mount.png
