wrbell/dad-ornithopter/cad/manufactured/s1223_matched_segment.png

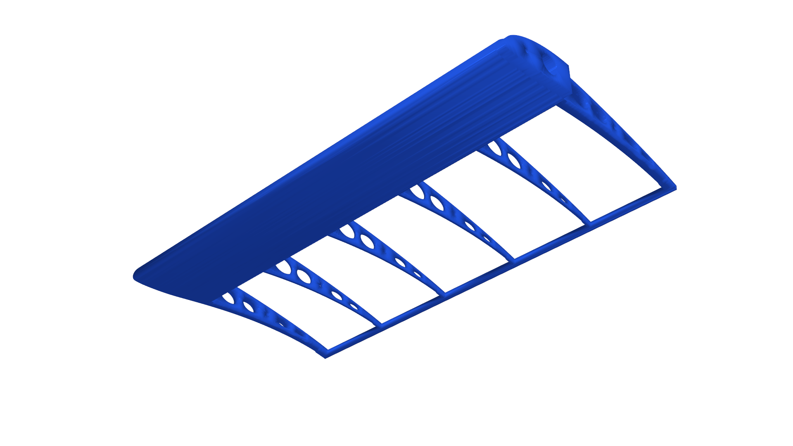
cad/manufactured/s1223_matched_segment.png
