wrbell/dad-ornithopter/cad/manufactured/s1223_mount_lightening_holes_top_preview.png

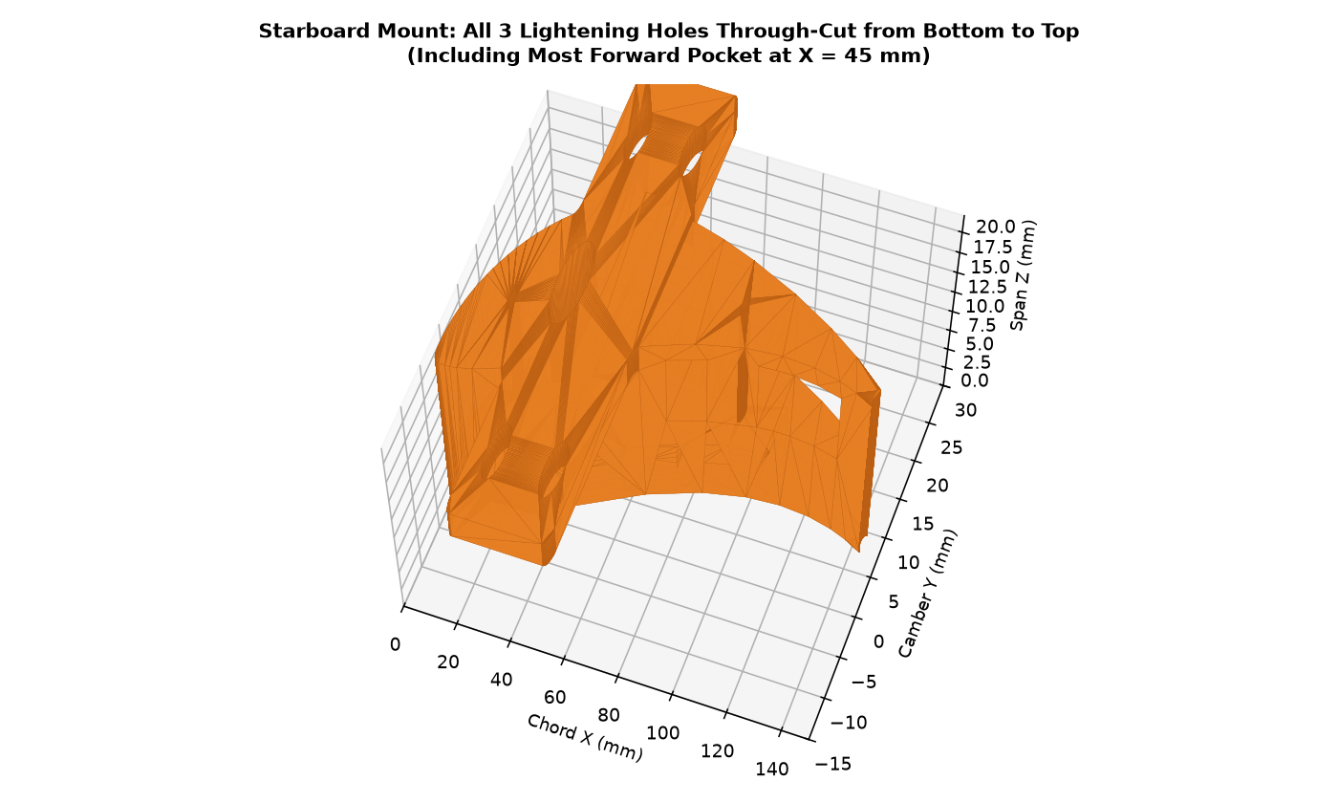
cad/manufactured/s1223_mount_lightening_holes_top_preview.png
