wrbell/dad-ornithopter/cad/manufactured/s1223_segment_oval_ribs_zoom.png

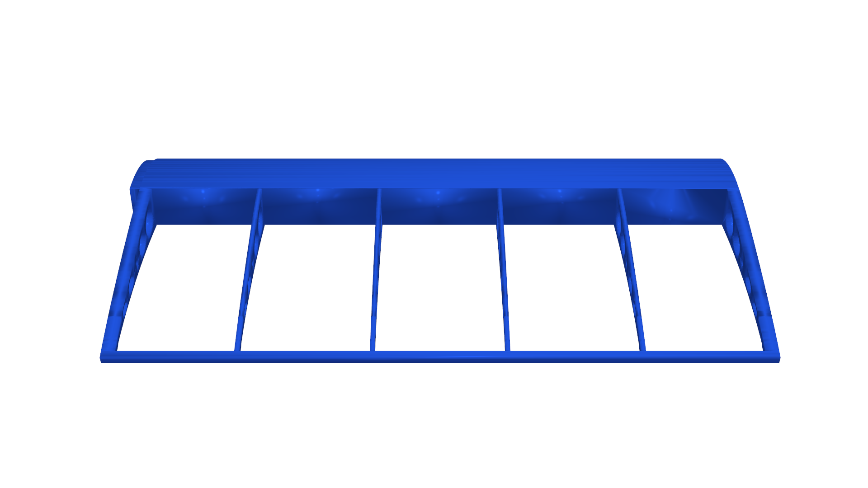
cad/manufactured/s1223_segment_oval_ribs_zoom.png
