wrbell/dad-ornithopter/cad/manufactured/s1223_starboard_wing_assembly_preview.png

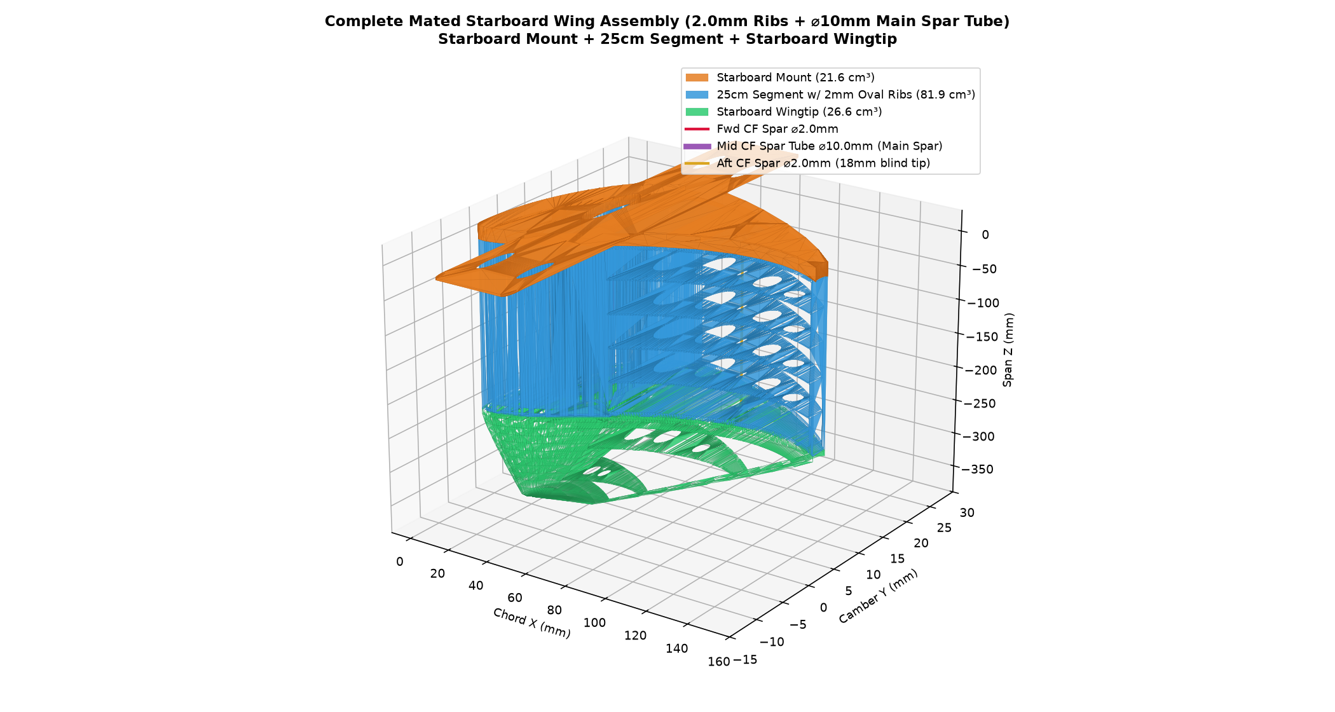
cad/manufactured/s1223_starboard_wing_assembly_preview.png
