wrbell/dad-ornithopter/cad/manufactured/s1223_wing_rib_lightening_holes_zoom.png

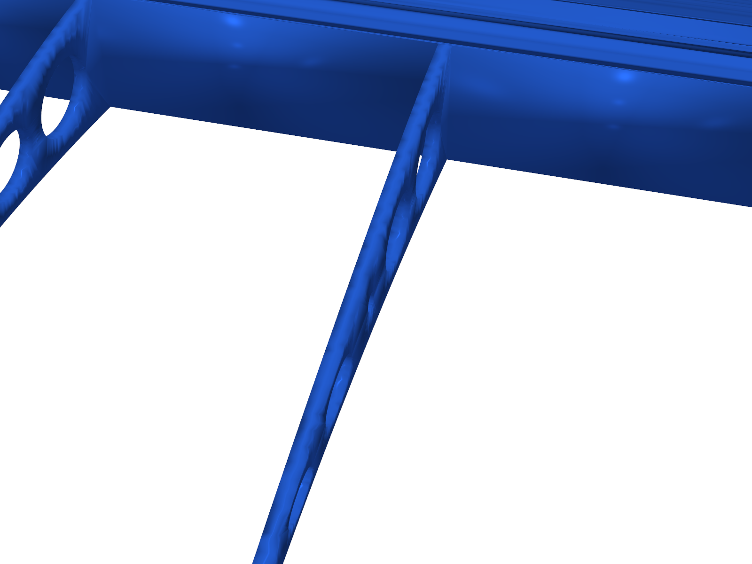
cad/manufactured/s1223_wing_rib_lightening_holes_zoom.png
