wrbell/dad-ornithopter/cad/manufactured/s1223_wing_segment_open_bay_preview.png

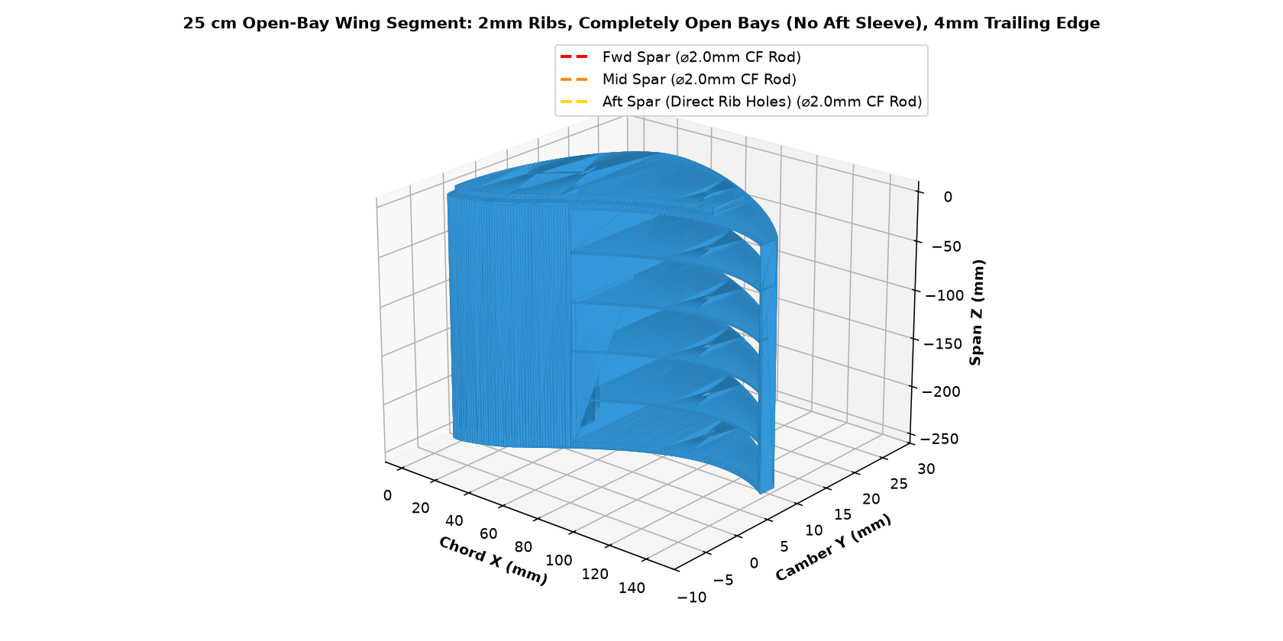
cad/manufactured/s1223_wing_segment_open_bay_preview.png
