wrbell/dad-ornithopter/cad/manufactured/s1223_wingtip_bilateral_preview.png

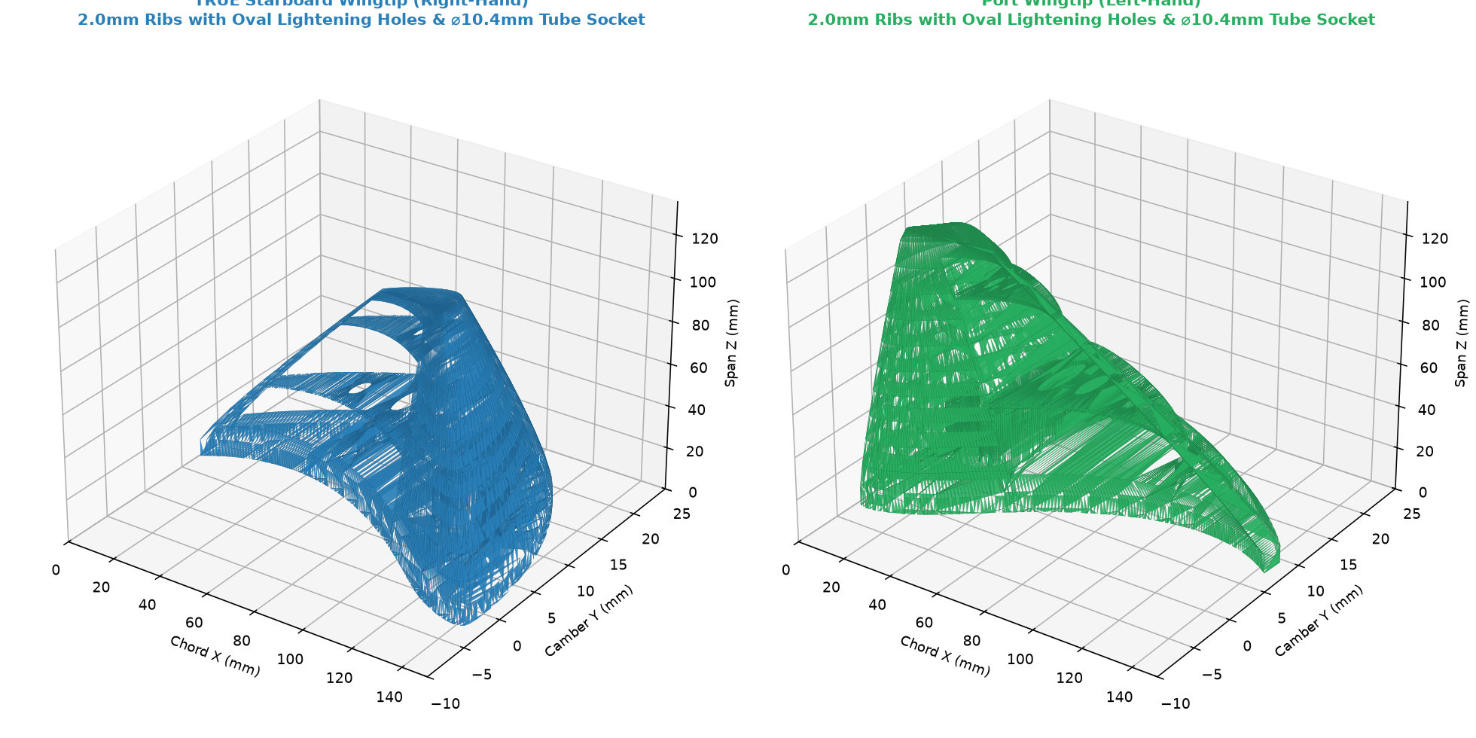
cad/manufactured/s1223_wingtip_bilateral_preview.png
