wrbell/dad-ornithopter/cad/manufactured/s1223_wingtip_check.png

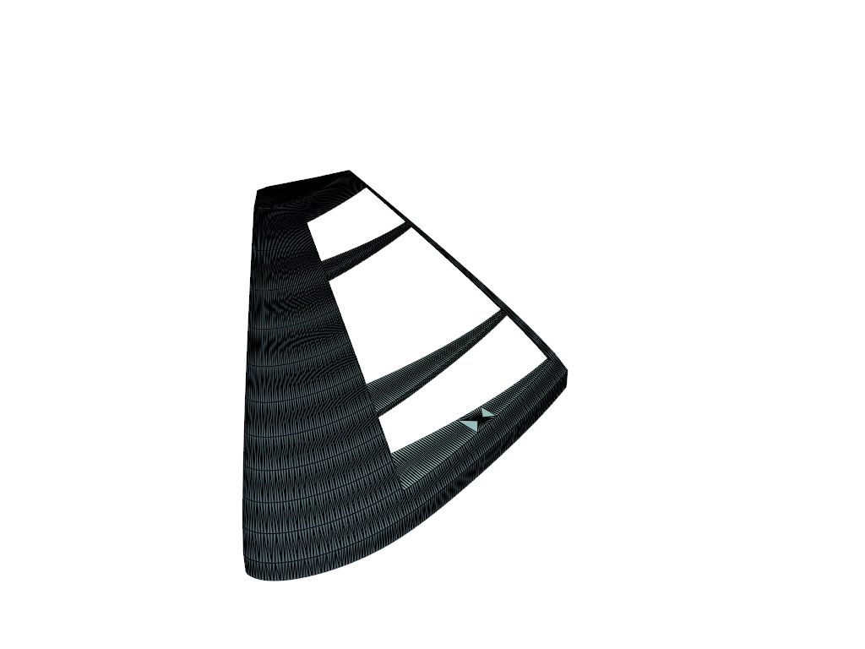
cad/manufactured/s1223_wingtip_check.png
