wrbell/dad-ornithopter/cad/manufactured/s1223_wingtip_iso_aligned.png

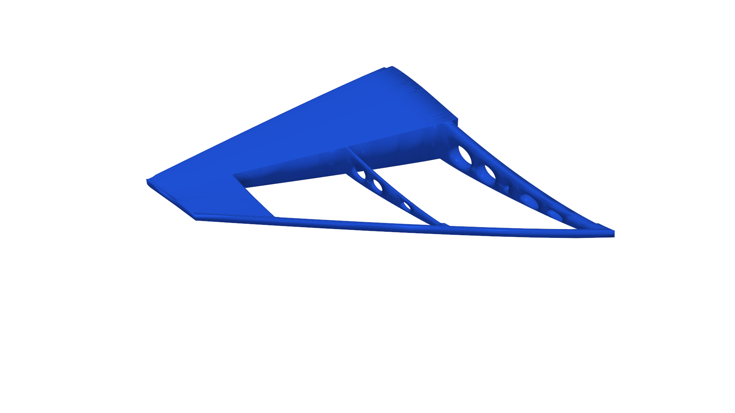
cad/manufactured/s1223_wingtip_iso_aligned.png
