wrbell/dad-ornithopter/cad/manufactured/s1223_wingtip_planform_tilted.png

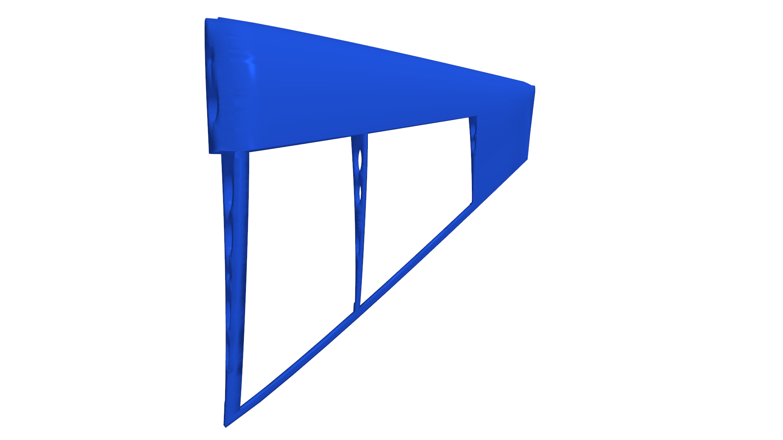
cad/manufactured/s1223_wingtip_planform_tilted.png
