wrbell/dad-ornithopter/cad/manufactured/s1223_wingtip_root_connector.png

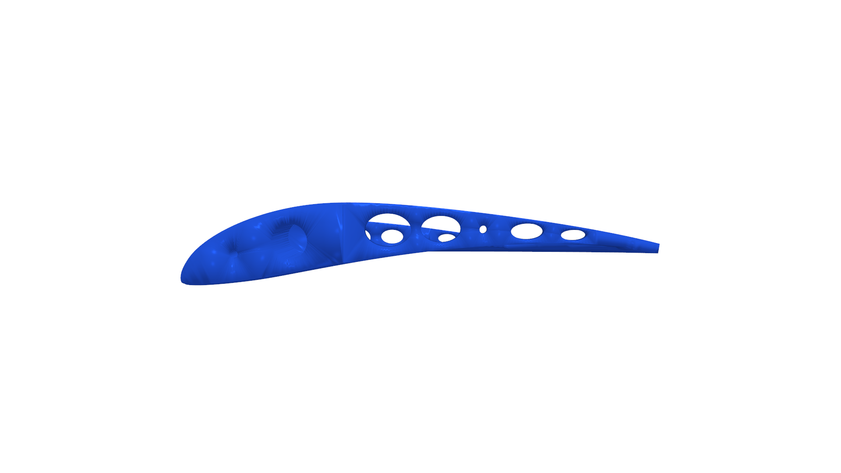
cad/manufactured/s1223_wingtip_root_connector.png
