wrbell/dad-ornithopter/cad/manufactured/s1223_wingtip_skeleton_iso.png

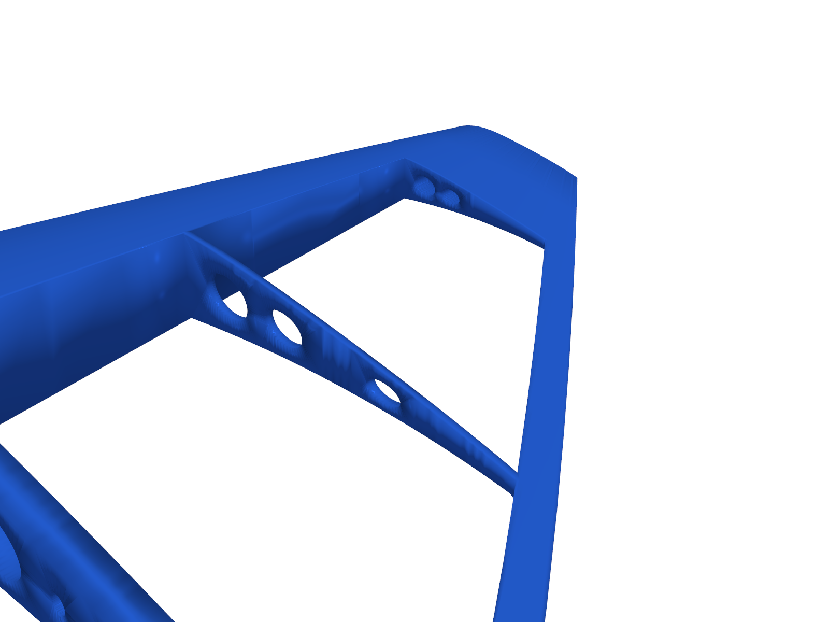
cad/manufactured/s1223_wingtip_skeleton_iso.png
