wrbell/dad-ornithopter/cad/manufactured/s1223_wingtip_skeleton_te_zoom.png

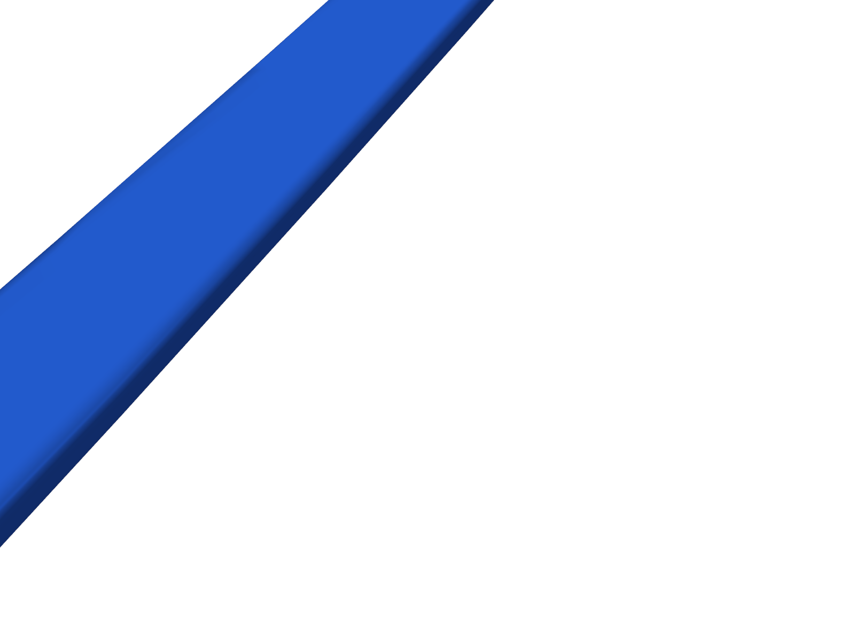
cad/manufactured/s1223_wingtip_skeleton_te_zoom.png
