wrbell/dad-ornithopter/cad/manufactured/s1223_wingtip_skeleton_top.png

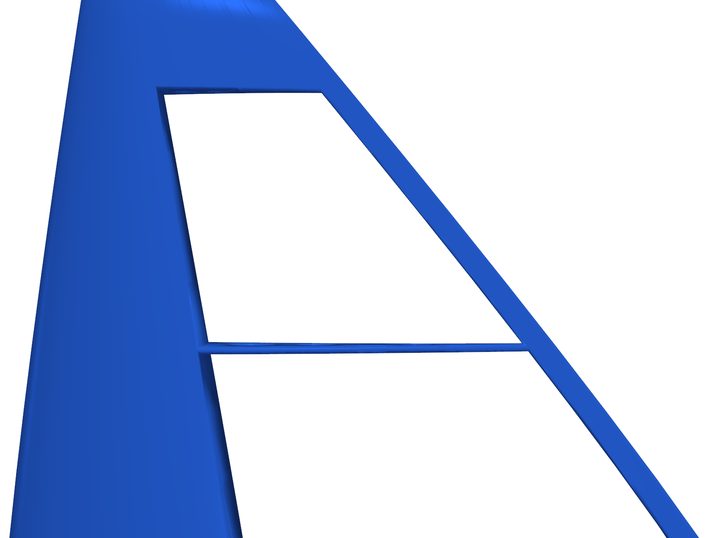
cad/manufactured/s1223_wingtip_skeleton_top.png
