wrbell/dad-ornithopter/cad/manufactured/sd7062_bilateral_wings_assembly_preview.png

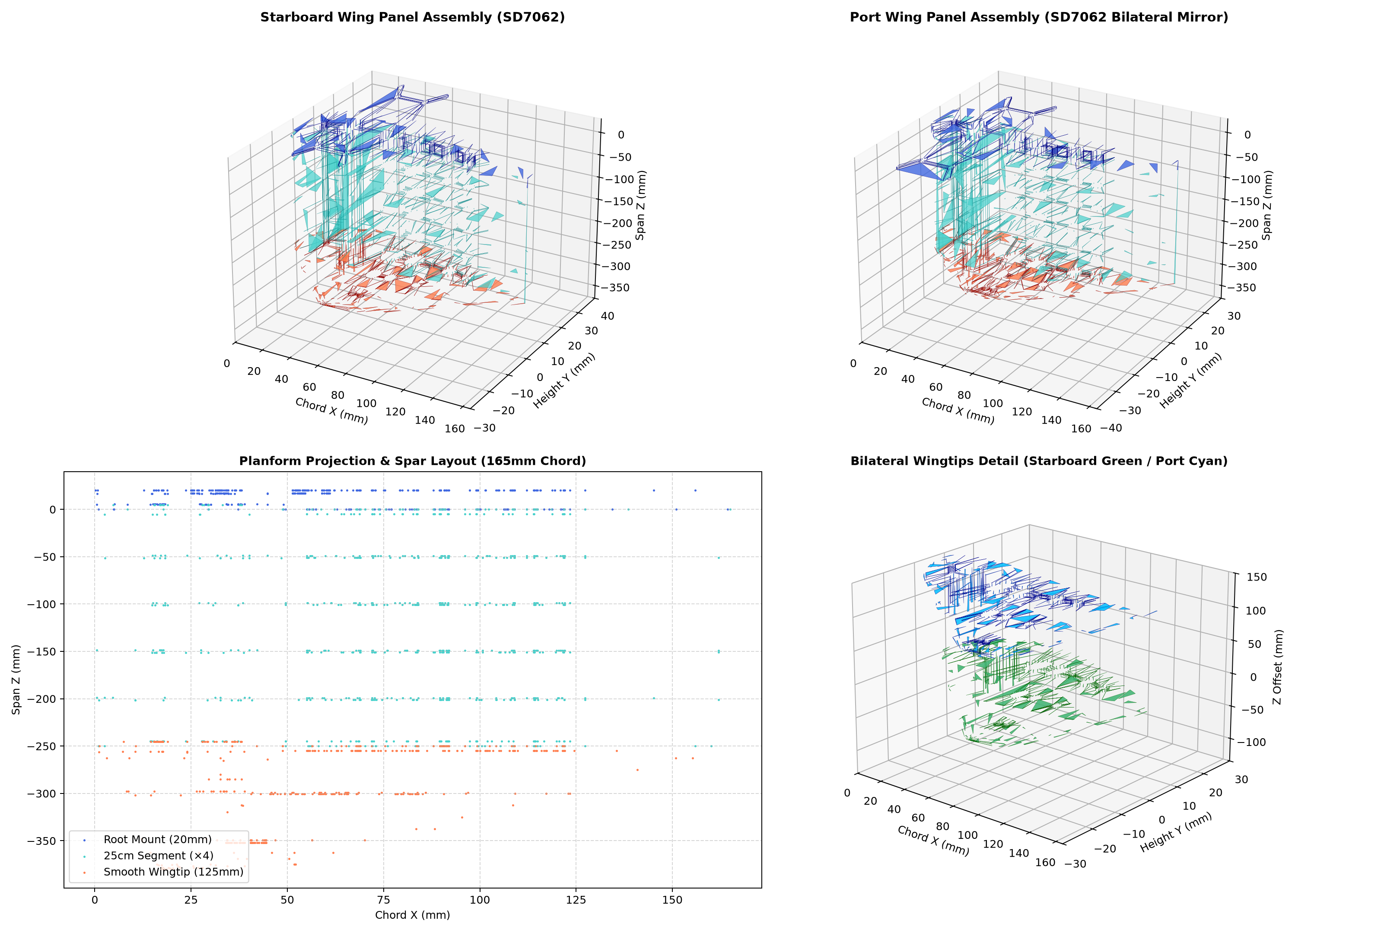
cad/manufactured/sd7062_bilateral_wings_assembly_preview.png
