wrbell/dad-ornithopter/cad/manufactured/sd7062_wing_rib_profile_preview.png

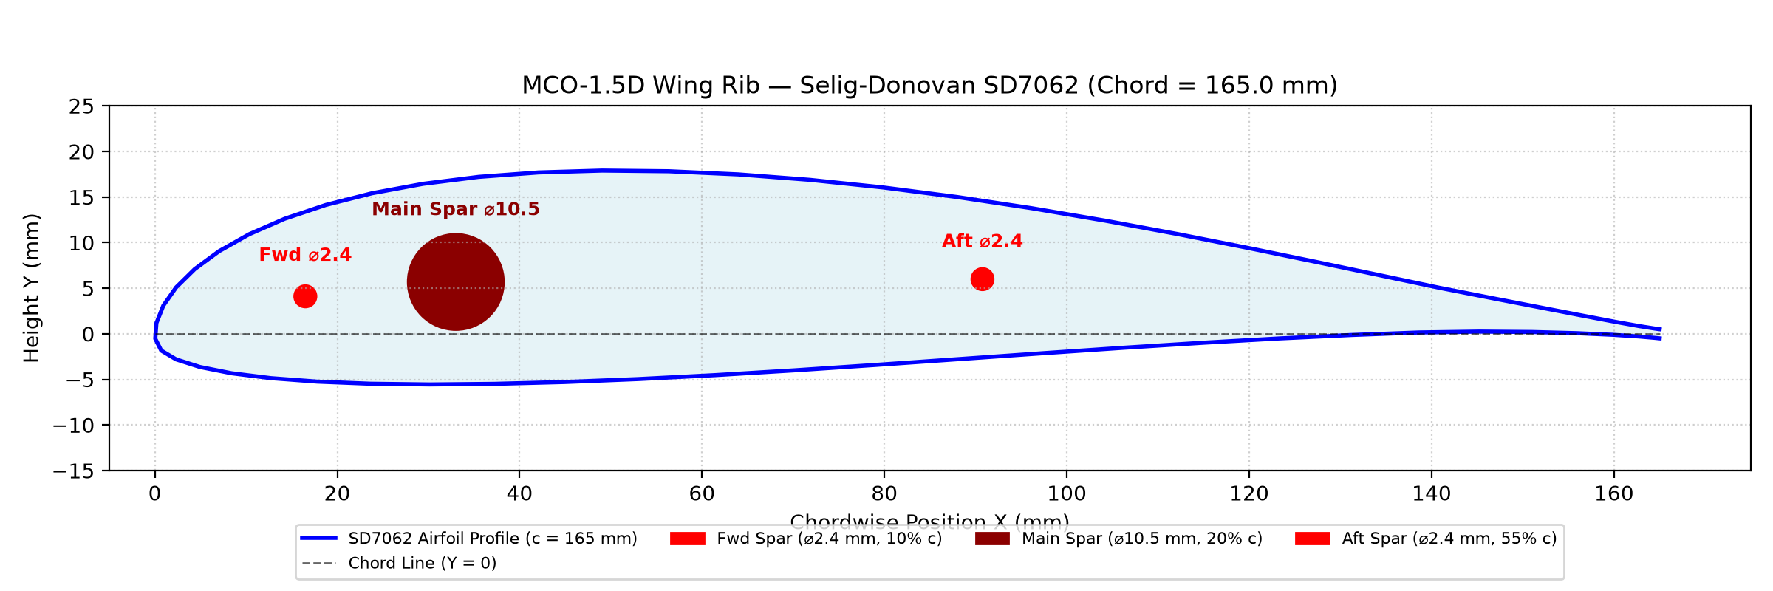
cad/manufactured/sd7062_wing_rib_profile_preview.png
