wrbell/dad-ornithopter/cad/manufactured/sd7062_wing_system_assembly_preview.png

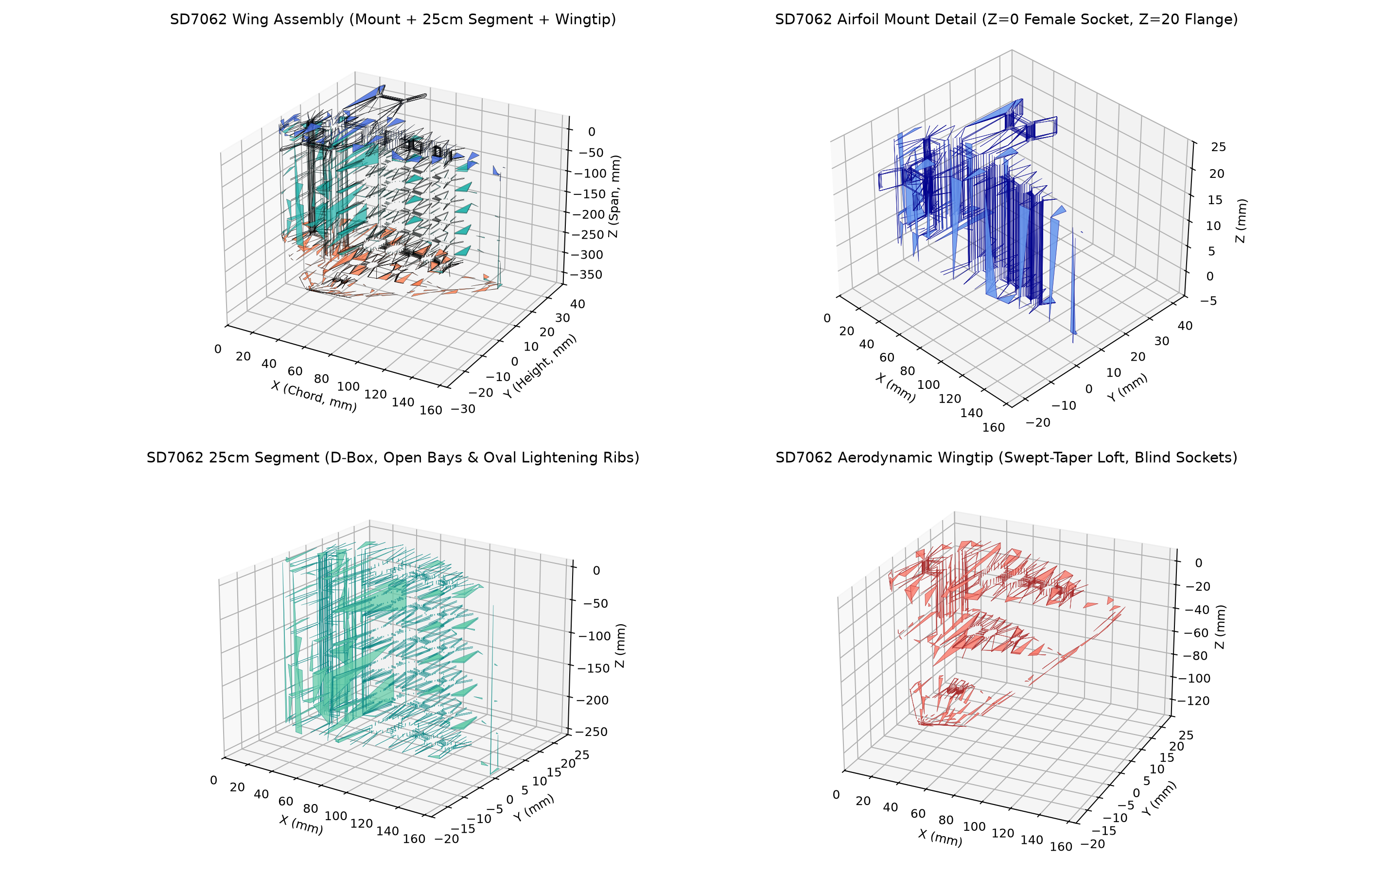
cad/manufactured/sd7062_wing_system_assembly_preview.png
