wrbell/dad-ornithopter/cad/manufactured/seg_iso.png

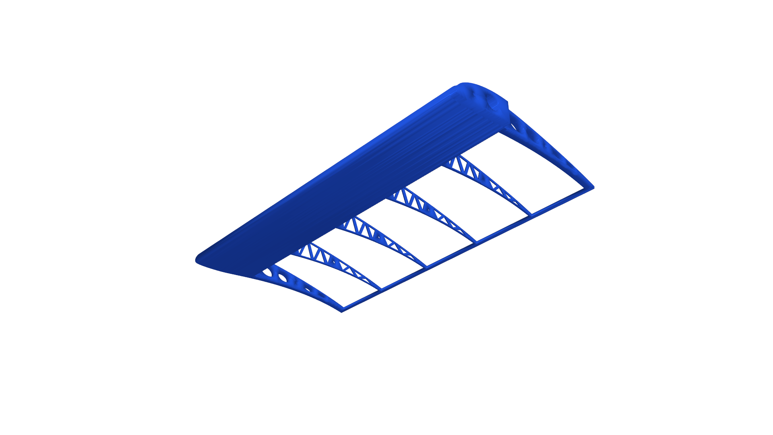
cad/manufactured/seg_iso.png
