wrbell/dad-ornithopter/cad/manufactured/seg_z0_face.png

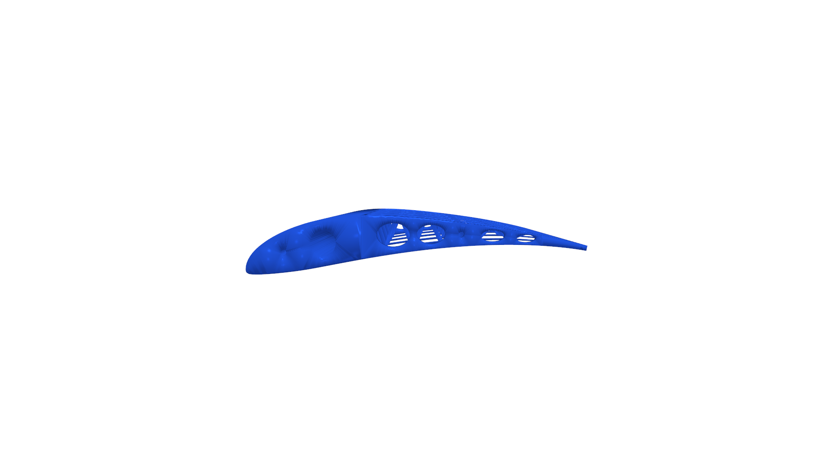
cad/manufactured/seg_z0_face.png
