wrbell/dad-ornithopter/cad/manufactured/stepped_capstan_exploded_render.png

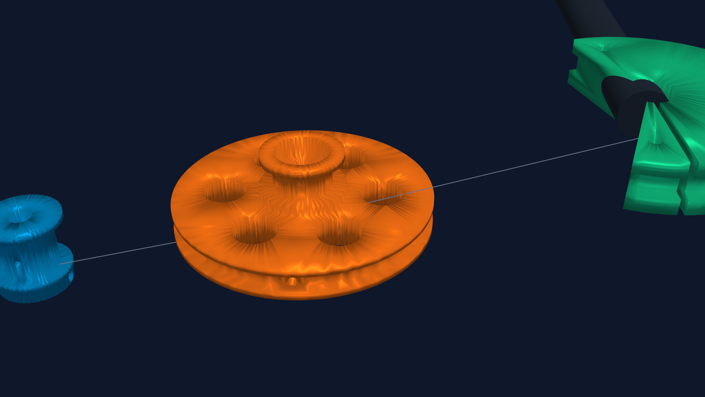
cad/manufactured/stepped_capstan_exploded_render.png
