wrbell/dad-ornithopter/cad/manufactured/stepped_capstan_iso_render.png

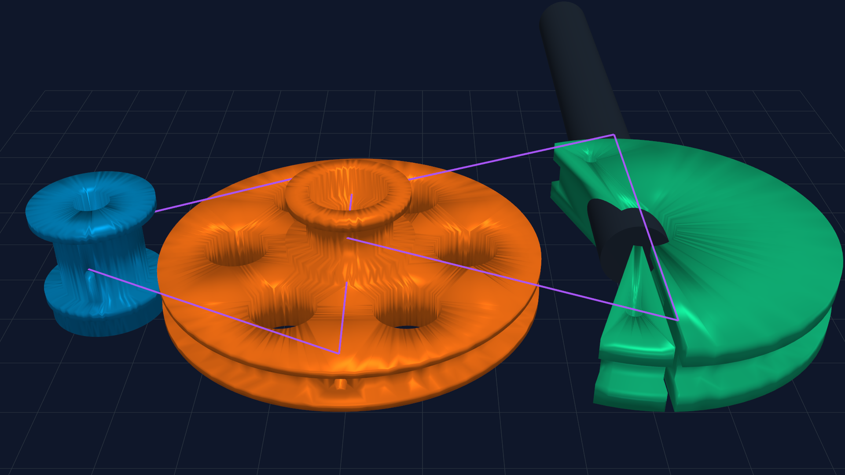
cad/manufactured/stepped_capstan_iso_render.png
