wrbell/dad-ornithopter/cad/manufactured/stepped_capstan_top_render.png

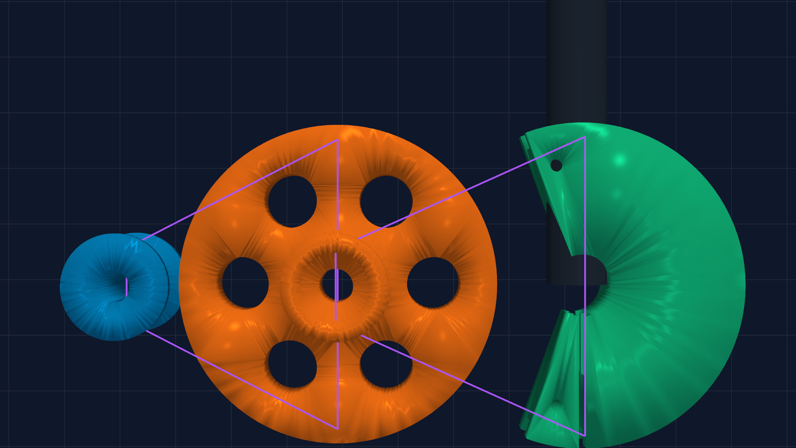
cad/manufactured/stepped_capstan_top_render.png
