wrbell/dad-ornithopter/cad/manufactured/s1223_wingtip_cam_test1.png

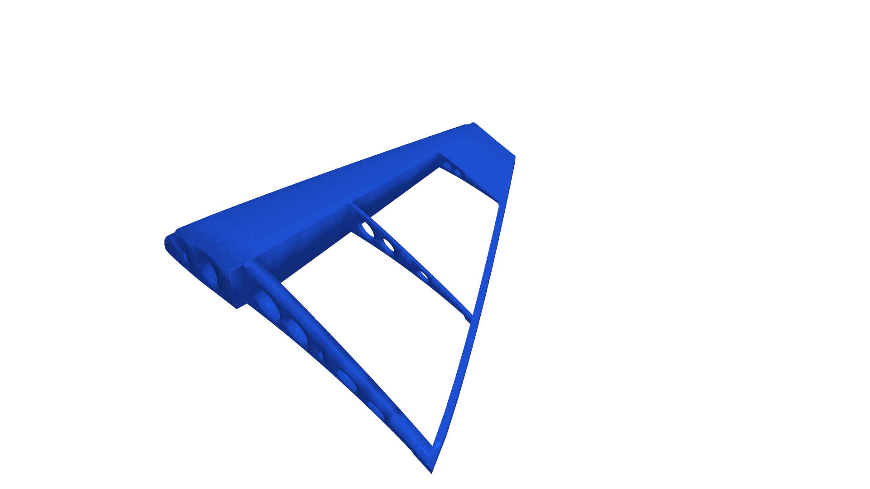
cad/manufactured/s1223_wingtip_cam_test1.png
