wrbell/dad-ornithopter/cad/manufactured/s1223_wingtip_horizontal_test.png

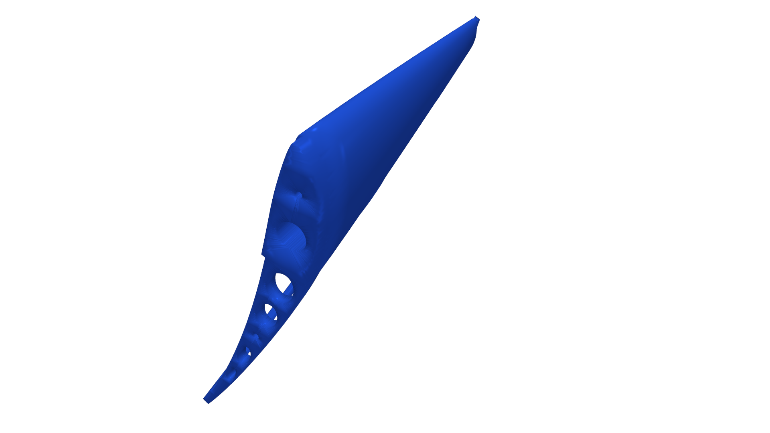
cad/manufactured/s1223_wingtip_horizontal_test.png
