wrbell/dad-ornithopter/cad/manufactured/s1223_wingtip_iso_test.png

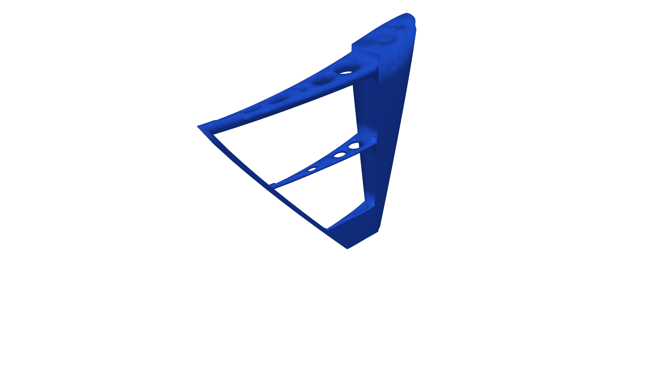
cad/manufactured/s1223_wingtip_iso_test.png
