wrbell/dad-ornithopter/cad/manufactured/test_mount_through_iso.png

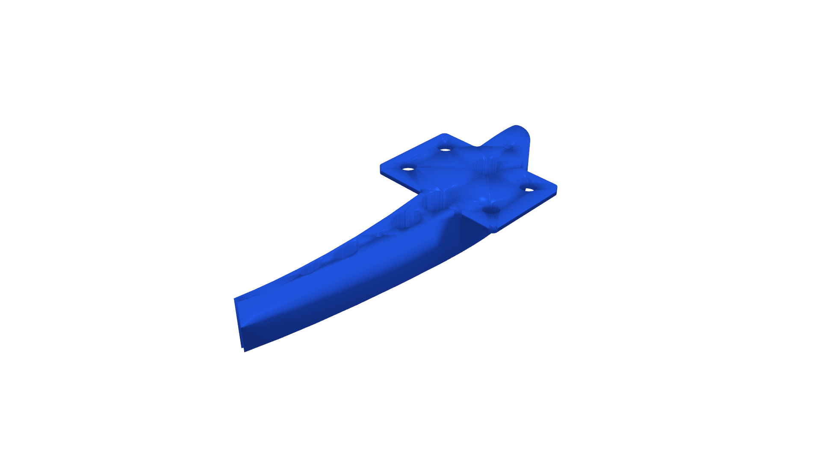
cad/manufactured/test_mount_through_iso.png
