wrbell/dad-ornithopter/cad/manufactured/debug_seg_stl_iso.png

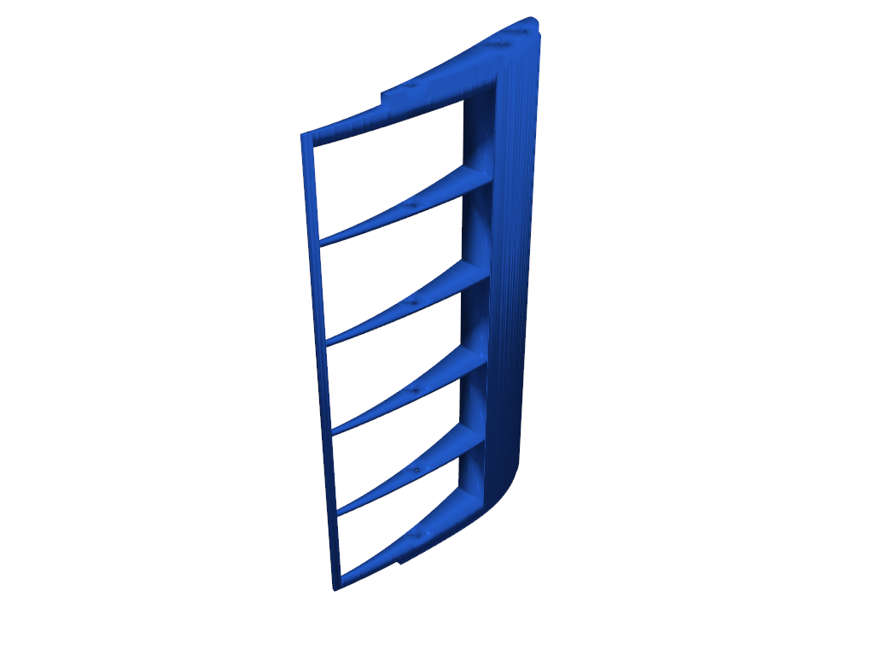
cad/manufactured/debug_seg_stl_iso.png
