wrbell/dad-ornithopter/cad/drawings/MCO_1D_Rib_Drawing.pdf

## MCO-1D WING RIB DRAWING Rev G May 2026

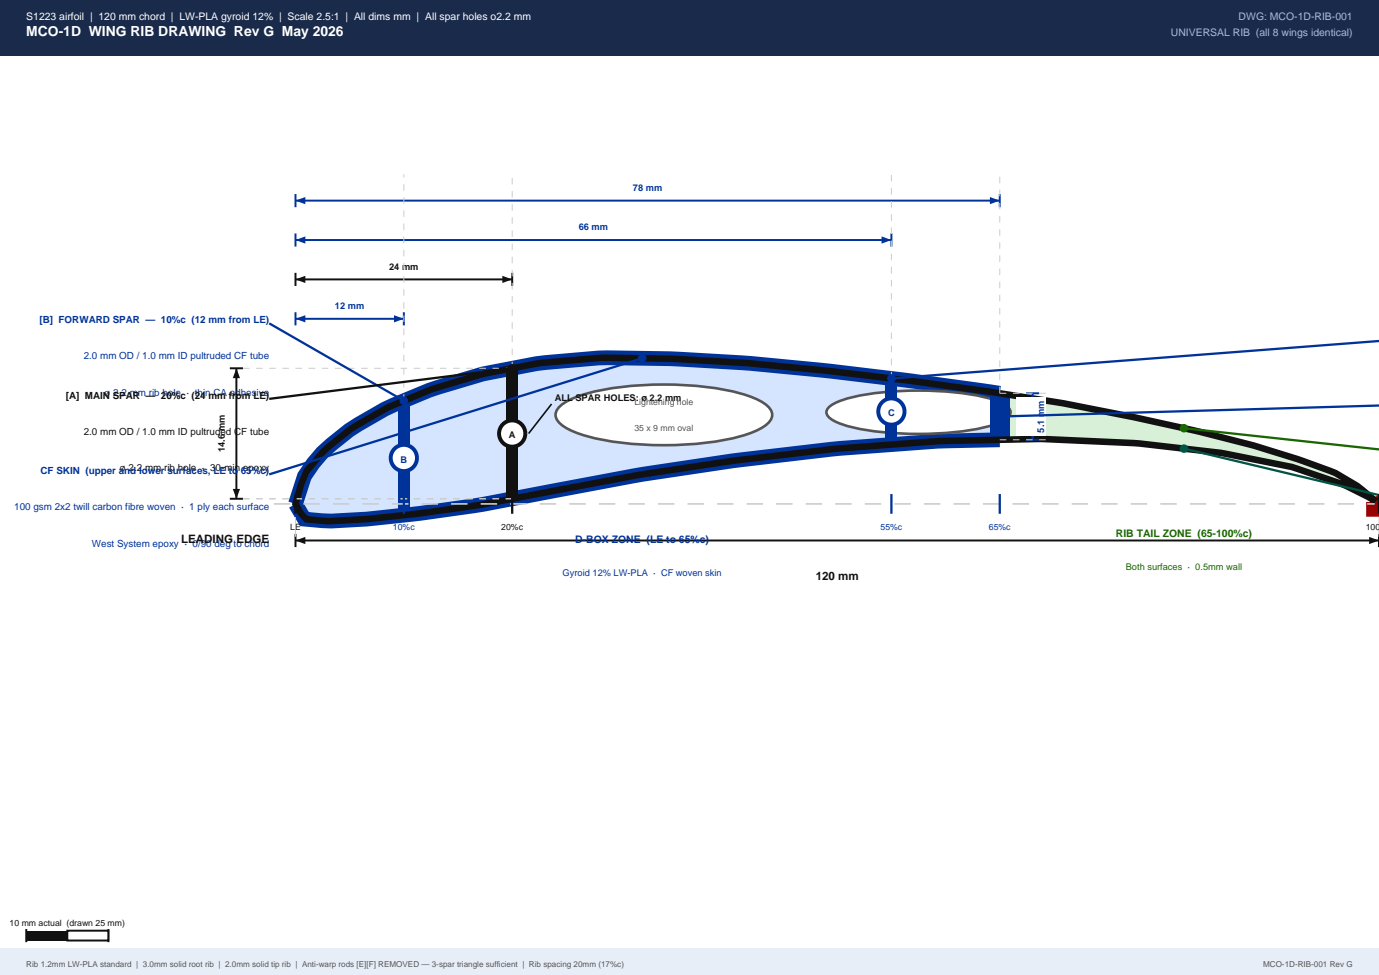
[picture p194: page 1]
Lightening hole; 35 x 9 mm oval; Rib 1.2mm LW-PLA standard | 3.0mm solid root rib | 2.0mm solid tip rib | Anti-warp rods [E][F] REMOVED — 3-spar triangle sufficient | Rib spacing 20mm (17%c); MCO-1D-RIB-001 Rev G

S1223 airfoil | 120 mm chord | LW-PLA gyroid 12% | Scale 2.5:1 | All dims mm | All spar holes o2.2 mm

DWG: MCO-1D-RIB-001

UNIVERSAL RIB (all 8 wings identical)

[B] FORWARD SPAR — 10%c (12 mm from LE)

2.0 mm OD / 1.0 mm ID pultruded CF tube

ø 2.2 mm rib hole · thin CA adhesive [A] MAIN SPAR — 20%c (24 mm from LE)

ALL SPAR HOLES: ø 2.2 mm

CF SKIN (upper and lower surfaces, LE to 65%c) ø 2.2 mm rib hole · 30-min epoxy

100 gsm 2x2 twill carbon fibre woven · 1 ply each surface

West System epoxy · 0/90 deg to chord LEADING EDGE

RIB TAIL ZONE (65-100%c)

D-BOX ZONE (LE to 65%c)

Gyroid 12% LW-PLA · CF woven skin

Both surfaces · 0.5mm wall

10 mm actual (drawn 25 mm)
