wrbell/dad-ornithopter/cad/slicer_profiles/mco_pla_prototype_coreone.ini

# MCO-1D PrusaSlicer 2.9.6 Profile: Official Prusament PLA @COREONE HF0.4 (0.20mm STRUCTURAL)
bed_shape = 0x0,250x0,250x220,0x220
layer_height = 0.20
first_layer_height = 0.20
perimeters = 4
top_solid_layers = 5
bottom_solid_layers = 4
fill_density = 25%
fill_pattern = gyroid
top_fill_pattern = monotonic
bottom_fill_pattern = monotonic
bed_temperature = 60
before_layer_gcode = ;BEFORE_LAYER_CHANGE\nG92 E0.0\n;[layer_z]\n{if layer_z > 150}\nM201 X{interpolate_table(layer_z, (0,7000), (150,7000), (200,4000), (270,2000))} Y{interpolate_table(layer_z, (0,7000), (150,7000), (200,4000), (270,2000))}\n{endif}\n
binary_gcode = 0
bridge_fan_speed = 100
chamber_minimal_temperature = 0
chamber_temperature = 20
color_change_gcode = M600\nG1 E0.3 F1500 ; prime after color change
compatible_printers = 
compatible_printers_condition = printer_model=~/(COREONE|COREONEOAK|COREONEMMU3|COREONEL|COREONELMMU3)/ and nozzle_diameter[0]!=0.8 and nozzle_diameter[0]!=0.6 and nozzle_diameter[0]!=0.5 and nozzle_high_flow[0]
cooling = 1
cooling_perimeter_transition_distance = 10
cooling_slowdown_logic = consistent_surface
cooling_tube_length = 20
cooling_tube_retraction = 45
default_filament_profile = "Prusament PLA @COREONE HF0.4"
default_print_profile = 0.20mm BALANCED @COREONE HF0.4
deretract_speed = 25
disable_fan_first_layers = 1
enable_dynamic_fan_speeds = 1
end_filament_gcode = "; Filament-specific end gcode"
end_gcode = {if layer_z < max_print_height}G1 Z{z_offset+min(max_layer_z+1, max_print_height)} F720 ; Move print head up{endif}\nM104 S0 ; turn off temperature\nM140 S0 ; turn off heatbed\nM141 S0 ; disable chamber control\nM107 ; turn off fan\nG1 X242 Y211 F10200 ; park\nG4 ; wait\nM572 S0 ; reset PA\nM84 X Y E ; disable motors\n; max_layer_z = [max_layer_z]
extra_loading_move = -52
extruder_clearance_height = 33
extruder_clearance_radius = 75
extruder_colour = ""
extruder_offset = 0x0
extrusion_multiplier = 1
fan_always_on = 1
fan_below_layer_time = 40
filament_colour = #FF8000
filament_cooling_final_speed = 3.5
filament_cooling_initial_speed = 10
filament_cooling_moves = 2
filament_cost = 27.99
filament_density = 1.24
filament_diameter = 1.75
filament_infill_max_crossing_speed = 200
filament_infill_max_speed = 0
filament_load_time = 10.9
filament_loading_speed = 10
filament_loading_speed_start = 50
filament_max_volumetric_speed = 24
filament_minimal_purge_on_wipe_tower = 15
filament_notes = ""
filament_purge_multiplier = 81.25%
filament_ramming_parameters = "250 100 39.871 39.871| 0.05 39.9547 0.45 39.9547 0.95 39.9547 1.45 39.9547 1.95 39.9547 2.45 39.9547 2.95 39.9547 3.45 39.9547 3.95 39.9547 4.45 39.9547 4.95 39.9547"
filament_settings_id = "Prusament PLA @COREONE HF0.4"
filament_soluble = 0
filament_spool_weight = 278
filament_stamping_distance = 45
filament_stamping_loading_speed = 29
filament_toolchange_delay = 0
filament_travel_max_lift = 0.6
filament_travel_ramping_lift = 1
filament_travel_slope = 1
filament_type = PLA
filament_unload_time = 8.9
filament_unloading_speed = 40
filament_unloading_speed_start = 30
filament_vendor = Prusa Polymers
first_layer_bed_temperature = 60
first_layer_temperature = 230
full_fan_speed_layer = 3
gcode_flavor = marlin2
idle_temperature = 170
layer_gcode = ;AFTER_LAYER_CHANGE\n;[layer_z]
machine_limits_usage = emit_to_gcode
machine_max_acceleration_e = 5000,2500
machine_max_acceleration_extruding = 7000,2500
machine_max_acceleration_retracting = 2500,2500
machine_max_acceleration_travel = 7000,2500
machine_max_acceleration_x = 10000,2500
machine_max_acceleration_y = 10000,2500
machine_max_acceleration_z = 400,200
machine_max_feedrate_e = 100,100
machine_max_feedrate_x = 350,160
machine_max_feedrate_y = 350,160
machine_max_feedrate_z = 12,12
machine_max_jerk_e = 10,10
machine_max_jerk_x = 10,8
machine_max_jerk_y = 10,8
machine_max_jerk_z = 2,2
machine_max_junction_deviation = 0.01,0.01
machine_min_extruding_rate = 0,0
machine_min_travel_rate = 0,0
max_fan_speed = 100
max_layer_height = 0.3
max_print_height = 270
min_fan_speed = 85
min_layer_height = 0.07
min_print_speed = 20
multimaterial_purging = 140
nozzle_diameter = 0.4
nozzle_high_flow = 1
overhang_fan_speed_0 = 100
overhang_fan_speed_1 = 100
parking_pos_retraction = 84
pause_print_gcode = M601
print_settings_id = 0.20mm STRUCTURAL @COREONE HF0.4
printer_model = COREONE
printer_notes = Don't remove the following keywords! These keywords are used in the "compatible printer" condition of the print and filament profiles to link the particular print and filament profiles to this printer profile.\nPRINTER_MODEL_COREONE\nPG\nNO_TEMPLATES
printer_settings_id = Prusa CORE One HF0.4 nozzle
printer_technology = FFF
printer_variant = HF0.4
remaining_times = 1
retract_before_travel = 1.5
retract_before_wipe = 80%
retract_layer_change = 1
retract_length = 0.7
retract_length_toolchange = 0
retract_lift = 0.2
retract_lift_above = 0
retract_lift_below = 269
retract_restart_extra = 0
retract_restart_extra_toolchange = 0
retract_speed = 45
silent_mode = 1
single_extruder_multi_material = 0
slowdown_below_layer_time = 8
start_filament_gcode = "M572 S{if nozzle_diameter[filament_extruder_id]==0.4}0.036{elsif nozzle_diameter[filament_extruder_id]==0.5}0.026{elsif nozzle_diameter[filament_extruder_id]==0.6}0.022{elsif nozzle_diameter[filament_extruder_id]==0.8}0.015{elsif nozzle_diameter[filament_extruder_id]==0.25}0.12{elsif nozzle_diameter[filament_extruder_id]==0.3}0.08{else}0{endif} ; Filament gcode\n\nM142 S36 ; set heatbreak target temp"
start_gcode = M17 ; enable steppers\nM862.1 P[nozzle_diameter] A{(filament_abrasive[0] ? 1 : 0)} F{(nozzle_high_flow[0] ? 1 : 0)} ; nozzle check\nM862.3 P "COREONE" ; printer model check\nM862.5 P2 ; g-code level check\nM862.6 P"Input shaper" ; FW feature check\nM115 U6.8.1+16182\n\nM555 X{(min(print_bed_max[0], first_layer_print_min[0] + 32) - 32)} Y{(max(0, first_layer_print_min[1]) - 4)} W{((min(print_bed_max[0], max(first_layer_print_min[0] + 32, first_layer_print_max[0])))) - ((min(print_bed_max[0], first_layer_print_min[0] + 32) - 32))} H{((first_layer_print_max[1])) - ((max(0, first_layer_print_min[1]) - 4))}\n\nG90 ; use absolute coordinates\nM83 ; extruder relative mode\n\n{if chamber_minimal_temperature[initial_tool]!=0}\nM140 S115 ; set bed temp for chamber heating\n{else}\nM140 S[first_layer_bed_temperature] ; set bed temp\n{endif}\n\nM109 R{((filament_notes[0]=~/.*MBL160.*/) ? 160 : (filament_notes[0]=~/.*HT_MBL10.*/) ? (first_layer_temperature[0] - 10) : (filament_type[0] == "PC" or filament_type[0] == "PA") ? (first_layer_temperature[0] - 25) : (filament_type[0] == "FLEX") ? 210 : 170)} ; wait for temp\n\nM84 E ; turn off E motor\n\nG28 ; home all without mesh bed level\n\n{if chamber_minimal_temperature[initial_tool]!=0}\n; Min chamber temp section\nM104 S{idle_temperature[initial_tool]} ; set idle temp\nG1 Z10 F720 ; set bed position\nG1 X242 Y-9 F4800 ; set print head position\nM191 S{chamber_minimal_temperature[initial_tool]} ; wait for minimal chamber temp\nM141 S{chamber_temperature[initial_tool]} ; set nominal chamber temp\nM107\nM140 S[first_layer_bed_temperature] ; set bed temp\n{else}\nM141 S{chamber_temperature[initial_tool]} ; set nominal chamber temp\n{endif}\n\n{if first_layer_bed_temperature[initial_tool]<=60}M106 S70{endif}\nG0 Z40 F10000\nM104 T{initial_tool} S{if is_nil(idle_temperature[initial_tool])}100{else}{idle_temperature[initial_tool]}{endif}\nM190 R[first_layer_bed_temperature] ; wait for bed temp\nM107\n\nG29 G ; absorb heat\n\nM109 R{((filament_notes[0]=~/.*MBL160.*/) ? 160 : (filament_notes[0]=~/.*HT_MBL10.*/) ? (first_layer_temperature[0] - 10) : (filament_type[0] == "PC" or filament_type[0] == "PA") ? (first_layer_temperature[0] - 25) : (filament_type[0] == "FLEX") ? 210 : 170)} ; wait for MBL temp\n\nM302 S155 ; lower cold extrusion limit to 155C\n\n{if filament_type[initial_tool]=="FLEX"}\nG1 E-4 F2400 ; retraction\n{else}\nG1 E-2 F2400 ; retraction\n{endif}\n\nM84 E ; turn off E motor\n\nG29 P9 X208 Y-2.5 W32 H4\n\n;\n; MBL\n;\nM84 E ; turn off E motor\nG29 P1 ; invalidate mbl & probe print area\nG29 P1 X150 Y0 W100 H20 C ; probe near purge place\nG29 P3.2 ; interpolate mbl probes\nG29 P3.13 ; extrapolate mbl outside probe area\nG29 A ; activate mbl\n\n; prepare for purge\nM104 S{first_layer_temperature[0]}\nG0 X249 Y-2.5 Z15 F4800 ; move away and ready for the purge\nM109 S{first_layer_temperature[0]}\n\nG92 E0\nM569 S0 E ; set spreadcycle mode for extruder\n\nM591 S0 ; disable stuck detection\n\n;\n; Extrude purge line\n;\nG92 E0 ; reset extruder position\nG1 E{(filament_type[0] == "FLEX" ? 4 : 2)} F2400 ; deretraction after the initial one\nG0 E5 X235 Z0.2 F500 ; purge\nG0 X225 E4 F500 ; purge\nG0 X215 E4 F650 ; purge\nG0 X205 E4 F800 ; purge\nG0 X202 Z0.05 F8000 ; wipe, move close to the bed\nG0 X199 Z0.2 F8000 ; wipe, move quickly away from the bed\n\nM591 R ; restore stuck detection\n\nG92 E0\nM221 S100 ; set flow to 100%
temperature = 230
thumbnails = 16x16/QOI, 313x173/QOI, 480x240/QOI, 380x285/PNG
travel_max_lift = 1.5
travel_ramping_lift = 1
travel_slope = 1
use_relative_e_distances = 1
variable_layer_height = 1
wipe = 0
