wrbell/dad-ornithopter/cad/slicer_profiles/mco_lwpla_aero_fairing_coreone.ini

# MCO-1D PrusaSlicer 2.9.6 Profile: ColorFabb LW-PLA Active Foaming Aerodynamic Fairing & Ribs (Prusa CORE One)
# Target parts: NACA 0018 Aerodynamic Fairing (09), S1223 / SD7062 Wing Ribs & Wingtips
bed_shape = 0x0,250x0,250x220,0x220
max_print_height = 250
nozzle_diameter = 0.4
filament_diameter = 1.75
filament_type = PLA
filament_density = 0.55
filament_cost = 60.0
extrusion_multiplier = 0.55
layer_height = 0.20
first_layer_height = 0.20
perimeters = 2
top_solid_layers = 3
bottom_solid_layers = 3
fill_density = 15%
fill_pattern = gyroid
top_fill_pattern = monotonic
bottom_fill_pattern = monotonic
temperature = 240
first_layer_temperature = 230
bed_temperature = 60
first_layer_bed_temperature = 60
cooling = 1
fan_always_on = 1
min_fan_speed = 30
max_fan_speed = 60
bridge_fan_speed = 80
disable_fan_first_layers = 2
perimeter_speed = 40
external_perimeter_speed = 35
infill_speed = 45
solid_infill_speed = 40
top_solid_infill_speed = 35
first_layer_speed = 25
retract_length = 0.0
support_material = 0
brim_width = 3
seam_position = aligned
binary_gcode = 0
gcode_flavor = marlin2
