wrbell/dad-ornithopter/cad/slicer_profiles/mco_pa12cf_solid_gears_coreone.ini

# MCO-1D PrusaSlicer 2.9.6 Profile: PA12-CF 100% Solid Precision Gears & Yoke (Prusa CORE One / 250x220x250mm)
# Target parts: Dual-Shear Top Brace (03), Stepped Capstan Pinion (05), Differential Gimbal Yoke (06), Bevel Gears (07, 08)
bed_shape = 0x0,250x0,250x220,0x220
max_print_height = 250
nozzle_diameter = 0.4
filament_diameter = 1.75
filament_type = NYLON
filament_density = 1.25
filament_cost = 85.0
extrusion_multiplier = 0.98
layer_height = 0.15
first_layer_height = 0.20
perimeters = 6
top_solid_layers = 8
bottom_solid_layers = 8
fill_density = 100%
fill_pattern = rectilinear
top_fill_pattern = monotonic
bottom_fill_pattern = monotonic
temperature = 290
first_layer_temperature = 290
bed_temperature = 105
first_layer_bed_temperature = 105
chamber_temperature = 55
cooling = 0
fan_always_on = 0
min_fan_speed = 0
max_fan_speed = 20
bridge_fan_speed = 35
disable_fan_first_layers = 4
perimeter_speed = 35
external_perimeter_speed = 25
infill_speed = 45
solid_infill_speed = 40
top_solid_infill_speed = 25
first_layer_speed = 20
support_material = 0
brim_width = 2
seam_position = nearest
binary_gcode = 0
gcode_flavor = marlin2
