wrbell/dad-ornithopter/cad/slicer_profiles/mco_pa12cf_structural_coreone.ini

# MCO-1D PrusaSlicer 2.9.6 Profile: PA12-CF Structural Parts (Prusa CORE One / 250x220x250mm)
# Target parts: Collar (01), Powertrain Stand (02), Stagecoach Sector Drum (04), Single-Bed Structural Plate (PLATE_01)
bed_shape = 0x0,250x0,250x220,0x220
max_print_height = 250
nozzle_diameter = 0.4
filament_diameter = 1.75
filament_type = NYLON
filament_density = 1.25
filament_cost = 85.0
extrusion_multiplier = 0.98
layer_height = 0.16
first_layer_height = 0.20
perimeters = 6
top_solid_layers = 6
bottom_solid_layers = 6
fill_density = 60%
fill_pattern = gyroid
top_fill_pattern = monotonic
bottom_fill_pattern = monotonic
temperature = 290
first_layer_temperature = 290
bed_temperature = 105
first_layer_bed_temperature = 105
chamber_temperature = 55
cooling = 0
fan_always_on = 0
min_fan_speed = 0
max_fan_speed = 15
bridge_fan_speed = 30
disable_fan_first_layers = 4
perimeter_speed = 50
external_perimeter_speed = 35
infill_speed = 65
solid_infill_speed = 50
top_solid_infill_speed = 35
first_layer_speed = 25
support_material = 0
brim_width = 3
seam_position = aligned
binary_gcode = 0
gcode_flavor = marlin2
