wrbell/dad-ornithopter/firmware/mco_intent_control.py

# NOTE (Rev 18): Intent now flows via sensors["intent"] which is
# set from result["intent"] → self._last_intent → next tick sensors.
# The CG management stability margin and landing mode selection
# read intent from sensors["intent"] each tick.
# This file provides the IntentController class for generating
# intent labels from pilot inputs and flight state.
# Wire IntentController.update() into mco_main if richer intent
# classification is needed beyond the wave library default.
#
"""
MCO-1D Intent-Based Control System  (mco_intent_control.py)
============================================================
Rev K: Auto-coordination, decoupled yaw/roll, flat turn
Rev L: Fin yaw (W1+W4 vertical pitch), dart manoeuvre
"""

import time
import math

# ── INTENT TAXONOMY ──────────────────────────────────────────────

class Intent:
    CRUISE         = 'cruise'
    CLIMB          = 'climb'
    DESCEND        = 'descend'
    TURN_LEFT      = 'turn_left'
    TURN_RIGHT     = 'turn_right'
    GLIDE          = 'glide'
    SOAR           = 'soar'
    SPRINT         = 'sprint'
    APPROACH_NORMAL= 'approach_normal'
    APPROACH_STEEP = 'approach_steep'
    APPROACH_ABORT = 'approach_abort'
    GO_AROUND      = 'go_around'
    LAND           = 'land'
    TIGHT_TURN     = 'tight_turn'
    CHANDELLE      = 'chandelle'
    SPIRAL_DOWN    = 'spiral_down'
    STOOP          = 'stoop'
    CF1_BURST      = 'cf1_burst'
    LOITER         = 'loiter'
    ORBIT_LEFT     = 'orbit_left'
    ORBIT_RIGHT    = 'orbit_right'
    APPROACH_SITE  = 'approach_site'
    RECOVER        = 'recover'
    RTH            = 'rth'
    EMERGENCY_LAND = 'emergency_land'
    WING_ALL       = 'wing_all'
    WING_PARTIAL   = 'wing_partial'
    WING_SINGLE    = 'wing_single'
    WING_SLOT      = 'wing_slot'
    WING_GAP       = 'wing_gap'
    WING_REAR      = 'wing_rear'
    TAXI_FWD       = 'taxi_fwd'
    TAXI_REV       = 'taxi_rev'
    INSPECTION     = 'inspection'
    # Rev K
    FLAT_TURN_LEFT  = 'flat_turn_left'
    FLAT_TURN_RIGHT = 'flat_turn_right'
    SLIP            = 'slip'
    SKID            = 'skid'
    # Rev L
    DART_RIGHT      = 'dart_right'
    DART_LEFT       = 'dart_left'

    # Rev N
    ZOOM_CLIMB      = 'zoom_climb'
    POWER_DIVE      = 'power_dive'
    STOOP_AUTO      = 'stoop_auto'

    # Rev O3
    CRAB_LEFT       = 'crab_left'
    CRAB_RIGHT      = 'crab_right'

    # Rev P: Bat Flight Biomechanics Suite (H-81 .. H-85)
    ROOST_PERCH_FLARE = 'roost_perch_flare'
    ROOST_SOMERSAULT  = 'roost_somersault'
    INERTIAL_YAW      = 'inertial_yaw'
    ANHEDRAL_TURN     = 'anhedral_turn'

    # Rev Q: Dragonfly Aerodynamic Suite (H-86 .. H-88)
    REVERSE_CASCADE_CRUISE = 'reverse_cascade_cruise'
    ACTIVE_UPSTROKE_BRAKE  = 'active_upstroke_brake'
    STROKE_PLANE_VECTOR    = 'stroke_plane_vector'

    # Rev R: Insect Flight Biomechanics Suite (H-89 .. H-95)
    KRAMER_LIFT_BURST      = 'kramer_lift_burst'
    CLAP_JET_BREAKOUT      = 'clap_jet_breakout'
    ELYTRON_CANARD         = 'elytron_canard'
    CORIOLIS_GUST_PREEMPT  = 'coriolis_gust_preempt'
    LOCUST_TORSIONAL_CRUISE= 'locust_torsional_cruise'
    SLOTTED_FLAP_GLIDE     = 'slotted_flap_glide'

    # Rev S: Pterosaur Flight Biomechanics Suite (H-98, H-100 .. H-102)
    QUADRUPEDAL_VAULT       = 'quadrupedal_vault'
    DIFFERENTIAL_SWEEP_TRIM = 'differential_sweep_trim'
    CRANIAL_PITCH_BALANCE   = 'cranial_pitch_balance'
    AZHDARCHID_SOAR         = 'azhdarchid_soar'

    # Rev T: Aquatic Biomechanics & Hydrodynamic Biomimicry Suite (H-103 .. H-108)
    TURTLE_PIVOT_BRAKE      = 'turtle_pivot_brake'
    PLESIOSAUR_TANDEM_WAKE  = 'plesiosaur_tandem_wake'
    CETACEAN_HYDROFOIL_ROLL = 'cetacean_hydrofoil_roll'
    KRILL_JET_COALESCENCE   = 'krill_jet_coalescence'
    COPEPOD_METACHRONY      = 'copepod_metachrony'
    CARIDOID_ESCAPE_FLARE   = 'caridoid_escape_flare'

    # Cargo Drone & eVTOL Operations Suite
    PAYLOAD_DROP           = 'payload_drop'
    CARGO_SWING_DAMP       = 'cargo_swing_damp'
    IGE_CUSHION            = 'ige_cushion'
    VERTIPORT_APPROACH     = 'vertiport_approach'
    OWI_REDUNDANCY         = 'owi_redundancy'
    AUTO_GLIDE_LOCK        = 'auto_glide_lock'

    # H-41 Active Ride Comfort & Cargo Stabilization
    RIDE_COMFORT           = 'ride_comfort'
    CARGO_STABILIZE        = 'cargo_stabilize'

    # Aquatic Bird Flight Biomechanics Suite (Top 4)
    WATER_CLAP_BURST       = 'water_clap_burst'
    MALLARD_HUMP_BREAKOUT  = 'mallard_hump_breakout'
    GULL_ASYMMETRIC_STROKE = 'gull_asymmetric_stroke'
    WIG_CRUISE             = 'wig_cruise'

    # Biological Launch & High-Angle Climb Suite (Dragonfly & Pigeon)
    DRAGONFLY_SUPER_LIFT   = 'dragonfly_super_lift'
    PIGEON_STEEP_CLIMB     = 'pigeon_steep_climb'
    PELICAN_DEEP_STROKE    = 'pelican_deep_stroke'

    # Conventional Fixed-Wing Takeoff & Dual-Cascade Rotation Suite
    TAKEOFF_ROLL           = 'takeoff_roll'
    ROTATE                 = 'rotate'

    # Conventional Fixed-Wing Approach, Flare, & Runway Rollout Braking Suite
    LANDING_FLARE          = 'landing_flare'
    TOUCHDOWN_ROLLOUT      = 'touchdown_rollout'

    # Universal Biomimetic Launch & Interbreeding Suite
    LAUNCH_BURST           = 'launch_burst'

    # Tactical Defense & Contested EW Suite
    STEALTH_LOITER         = 'stealth_loiter'
    CONTESTED_EW           = 'contested_ew'

    # Advanced Maneuverability & Aerobatics Suite (H-INV-1, H-KNIFE-1, H-SNAP-1, H-VERT-1, H-SPIN-1)
    INVERTED_FLIGHT        = 'inverted_flight'
    OUTSIDE_LOOP           = 'outside_loop'
    KNIFE_EDGE_ROTOR       = 'knife_edge_rotor'
    SNAP_ROLL_AERO         = 'snap_roll_aero'
    HAMMERHEAD_PIVOT       = 'hammerhead_pivot'
    TAILSLIDE_FLIP         = 'tailslide_flip'
    SPIN_RECOVERY          = 'spin_recovery'

    # H-FALCON-TRIM-1 Fanned Bi-Delta Tailplane Fast Cruise & Level Dash
    FALCON_DART            = 'falcon_dart'




# ── INTENT INTERPRETER ───────────────────────────────────────────

class IntentInterpreter:
    STICK_THRESHOLD     = 0.12
    THROTTLE_CLIMB_MIN  = 0.65
    THROTTLE_DESCEND_MAX= 0.25
    ROLL_TURN_MIN       = 0.15
    GLIDE_LEVER_MIN     = 0.10
    LEVER_DETENT_LOW    = 47.5
    LEVER_DETENT_HIGH   = 52.5

    def __init__(self):
        self._last_intent    = Intent.CRUISE
        self._coord_mode     = 'auto'
        self._macro_requested= None
        self._vault_armed    = False
        self._vault_arm_t    = 0.0
        self._internal_t     = 0.0
        import mco_wave_library as _wl_init
        self._gesture_det    = _wl_init.GestureDetector()

    def _on_intent_change(self):
        """Reset transient gesture / rate states on intent switch."""
        pass

    def interpret(self, sticks, switches, context):
        ch1 = sticks.get('roll',     sticks.get('ch1', 0.0))
        ch2 = sticks.get('pitch',    sticks.get('ch2', 0.0))
        ch3 = sticks.get('throttle', sticks.get('ch3', 0.5))
        ch4 = sticks.get('yaw',      sticks.get('ch4', 0.0))
        ch6 = sticks.get('gl_lever', sticks.get('ch6', 0.0))
        lever_pct = context.get('lever_pct', ch3 * 100.0)

        # Cargo Drone Dynamic G-Limiter: derate maximum allowable pitch stick when carrying payload
        payload_kg = context.get('payload_kg', 0.0)
        if payload_kg > 0.15:
            gross_kg = 5.687 + payload_kg
            n_ratio = 5.687 / gross_kg
            max_pitch_stick = max(0.40, min(1.0, n_ratio))
            if ch2 > max_pitch_stick:
                ch2 = max_pitch_stick
                context['g_limit_active'] = True
                context['n_limit_g'] = round(3.5 * n_ratio, 2)

        mode_sw  = switches.get('mode_sw',   0)
        macro_sw = switches.get('macro_sw',  False)
        macro_lng= switches.get('macro_long',False)
        rth_sw   = switches.get('rth_sw',    False)
        wing_sw  = switches.get('wing_sw',   0)

        V_ms      = context.get('V_ms',      8.0)
        h_agl_m   = context.get('h_agl_m',   50.0)
        bank_deg  = context.get('bank_deg',  0.0)
        Ps        = context.get('Ps',        0.0)
        on_ground = context.get('on_ground', False)

        # Time tracking for gestures / rapid centering
        t_now = context.get('t')
        if t_now is None:
            self._internal_t += 0.05
            t_now = self._internal_t

        # Rudder pedal / brake depression detection (both pedals depressed)
        pedals_depressed = False
        if context.get('pedals_depressed', False) or context.get('brakes_held', False) or context.get('brakes', False):
            pedals_depressed = True
        elif switches.get('pedals_depressed', False) or switches.get('brakes', False):
            pedals_depressed = True
        elif sticks.get('pedals_depressed', False) or sticks.get('brakes_held', False):
            pedals_depressed = True
        elif sticks.get('brakes', 0.0) >= 0.70:
            pedals_depressed = True
        elif sticks.get('left_brake', 0.0) >= 0.70 and sticks.get('right_brake', 0.0) >= 0.70:
            pedals_depressed = True
        elif sticks.get('left_pedal', 0.0) >= 0.70 and sticks.get('right_pedal', 0.0) >= 0.70:
            pedals_depressed = True
        elif context.get('left_brake', 0.0) >= 0.70 and context.get('right_brake', 0.0) >= 0.70:
            pedals_depressed = True

        context['pedals_depressed'] = pedals_depressed
        context['throttle'] = ch3

        # ── Safety & Fail-Safes (Highest Priority Overrides) ─────
        if context.get('total_power_loss', False):
            return Intent.AUTO_GLIDE_LOCK, 1.0, {'reason': 'total_power_loss'}
        if context.get('failed_wing_node') is not None or context.get('owi_active', False):
            return Intent.OWI_REDUNDANCY, 1.0, {
                'failed_node': context.get('failed_wing_node', 0),
                'reason': 'motor_or_driver_failure'
            }
        if rth_sw:
            return Intent.RTH, 1.0, {}
        if context.get('stall_imminent', False):
            return Intent.RECOVER, 1.0, {'reason': 'stall_imminent'}
        if context.get('battery_critical', False) or context.get('emergency_land', False):
            return Intent.EMERGENCY_LAND, 1.0, {'reason': 'battery_critical' if context.get('battery_critical') else 'emergency_land_cmd'}

        # ── Uncommanded Spin Recovery (H-SPIN-REC-1) ─────────────
        yaw_rate_curr = context.get('yaw_rate_dps', 0.0)
        aoa_curr = context.get('aoa_deg', 0.0)
        if not on_ground and ((abs(yaw_rate_curr) >= 80.0 and aoa_curr >= 25.0 and V_ms < 6.0) or context.get('spin_detected', False)):
            return Intent.SPIN_RECOVERY, 1.0, {
                'yaw_rate_dps': yaw_rate_curr,
                'aoa_deg': aoa_curr,
                'V_ms': V_ms,
                'reason': 'uncommanded_spin_detected'
            }

        # ── Inverted Flight & Outside Push Loop Suite (H-INV-1, H-LOOP-OUT-1) ──
        is_inverted = (abs(bank_deg) >= 135.0 or context.get('inverted_flight', False))
        if not on_ground and is_inverted:
            if ch2 <= -0.30 or context.get('outside_loop_demand', False):
                return Intent.OUTSIDE_LOOP, 0.96, {
                    'push_stick': ch2,
                    'throttle': ch3,
                    'bank_deg': bank_deg,
                    'V_ms': V_ms,
                }
            return Intent.INVERTED_FLIGHT, 0.95, {
                'pitch': ch2,
                'throttle': ch3,
                'bank_deg': bank_deg,
                'V_ms': V_ms,
            }

        # ── Vertical Flapping Rotor Knife-Edge Mode (H-KNIFE-ROTOR-1) ──
        if not on_ground and abs(bank_deg) >= 75.0 and (context.get('knife_edge_active', False) or (bank_deg * ch4 < -0.20 or abs(ch4) >= 0.35)):
            direction = 'right' if bank_deg > 0 else 'left'
            return Intent.KNIFE_EDGE_ROTOR, 0.95, {
                'bank_deg': bank_deg,
                'direction': direction,
                'top_rudder': abs(ch4),
                'throttle': ch3,
            }

        # ── Aerobatic Snap Decoupling Mode (H-SNAP-1) ───────────
        urgency = context.get('stick_urgency', abs(context.get('roll_rate_dps', 0.0)) / 45.0)
        is_snap_gesture = (urgency >= 3.5 and abs(ch1) >= 0.80 and ch2 >= 0.50 and not on_ground and V_ms >= 8.0)
        if (is_snap_gesture or context.get('snap_roll_demand', False)) and not on_ground:
            snap_dir = 'right' if ch1 > 0 else 'left'
            return Intent.SNAP_ROLL_AERO, 0.96, {
                'direction': snap_dir,
                'roll_stick': ch1,
                'pitch_stick': ch2,
                'rudder_stick': ch4,
                'urgency': urgency,
            }

        # ── Vertical Apex Handshake (H-VERT-APEX-1) ─────────────
        pitch_att = context.get('pitch_deg', 0.0)
        vz = context.get('vz_ms', 0.0)
        is_vertical_line = (pitch_att >= 60.0 or vz >= 2.5 or context.get('vertical_climb_active', False))
        if not on_ground and is_vertical_line and V_ms < 2.0:
            if abs(ch4) >= 0.35 or context.get('hammerhead_demand', False):
                pivot_dir = 'right' if ch4 > 0 else 'left'
                return Intent.HAMMERHEAD_PIVOT, 0.95, {
                    'direction': pivot_dir,
                    'rudder_stick': ch4,
                    'pitch_deg': pitch_att,
                }
            return Intent.TAILSLIDE_FLIP, 0.95, {
                'pitch_deg': pitch_att,
                'pitch_stick': ch2,
                'vz_ms': vz,
            }

        # ── Contested EW & Defense Stealth Overrides ─────────────
        if context.get('contested_ew', False) or (context.get('rc_lost', False) and context.get('gps_jammed', False)):
            return Intent.CONTESTED_EW, 1.0, {'reason': 'contested_ew_active', 'target_h_m': 30.0}
        if context.get('stealth_loiter', False) or switches.get('stealth_sw', False):
            return Intent.STEALTH_LOITER, 1.0, {'reason': 'tactical_stealth_loiter'}

        # Rev K — coordination mode
        # Rev N: gesture detection for zoom/dive/stoop
        import mco_wave_library as _wl

        _gesture, _gconf, _gparams = _wl.classify_pitch_intent(
            sticks.get('pitch', 0.0), ch3*100.0, V_ms,
            h_agl_m, context.get('pitch_deg', 0.0),
            self._gesture_det)
        if _gesture == 'zoom_climb' and not on_ground:
            return Intent.ZOOM_CLIMB, _gconf, _gparams
        if _gesture == 'stoop_auto' and not on_ground:
            return Intent.STOOP_AUTO, _gconf, _gparams
        if _gesture == 'power_dive' and not on_ground and ch3 > 0.35:
            return Intent.POWER_DIVE, _gconf, _gparams
        if _gesture == 'perch_flare' and not on_ground:
            return Intent.ROOST_PERCH_FLARE, _gconf, _gparams
        if _gesture == 'roost_somersault' and not on_ground:
            return Intent.ROOST_SOMERSAULT, _gconf, _gparams

        # Rev P: Chiropteran inertial reorientation (zero-airspeed yaw H-81)
        if V_ms < 2.0 and abs(ch4) >= 0.20 and not on_ground:
            direction = 'right' if ch4 > 0 else 'left'
            return Intent.INERTIAL_YAW, abs(ch4), {
                'direction': direction,
                'yaw_stick': ch4,
                'yaw_rate_dps': ch4 * 60.0,
            }

        # Rev Q: Odonata direct-musculature stroke-plane vectoring (H-88)
        if abs(ch4) >= 0.35 and abs(ch1) < 0.20 and not on_ground and V_ms >= 2.0:
            direction = 'right' if ch4 > 0 else 'left'
            return Intent.STROKE_PLANE_VECTOR, abs(ch4), {
                'direction': direction,
                'yaw_stick': ch4,
                'tilt_deg': 18.0 * (1.0 if ch4 > 0 else -1.0),
            }

        # Rev Q: Active upstroke reverse flight & dynamic braking (H-87)
        if not on_ground and h_agl_m >= 2.0:
            airbrake_requested = (context.get('active_upstroke_brake', False) or
                                  (lever_pct <= 10.0 and ch3 <= 0.10 and not context.get('falcon_morph', False)))
            if airbrake_requested and not context.get('falcon_morph', False):
                return Intent.ACTIVE_UPSTROKE_BRAKE, 0.95, {
                    'aoa_deg': -28.0,
                    'decel_target_g': 1.25,
                    'h_agl_m': h_agl_m,
                }

        # Rev R: Dipteran Coriolis gust preemption (H-93)
        ang_accel = context.get('angular_accel_dps2', abs(context.get('gyro_deriv', 0.0)))
        if (ang_accel > 220.0 or context.get('coriolis_gust_alert', False)) and not on_ground:
            return Intent.CORIOLIS_GUST_PREEMPT, 0.98, {
                'ang_accel_dps2': ang_accel,
                'counter_twist_deg': 6.5,
            }

        # Rev R: Dynamic Kramer pre-rotation lift burst (H-89)
        if ((V_ms < 5.0 and ch2 >= 0.60 and not on_ground and not context.get('obstacle_climb', False))
                or context.get('kramer_burst_demand', False)):
            return Intent.KRAMER_LIFT_BURST, 0.92, {
                'pre_rotation_lead_deg': 10.0,
                'cl_transient': 2.85,
            }

        # Rev R: Coleopteran elytron canard steep obstacle climb (H-92)
        if (ch2 >= 0.70 or context.get('obstacle_climb', False)) and (V_ms >= 5.0 or context.get('obstacle_climb', False)) and not on_ground:
            return Intent.ELYTRON_CANARD, 0.90, {
                'canard_locked_station': 1,
                'canard_incidence_deg': 8.5,
                'climb_angle_deg': 48.0,
            }

        # Pigeon Clap-and-Peel Steep Obstacle Climb Corridor (H-LA-3)
        if not on_ground and V_ms <= 7.0 and (
                context.get('steep_climb_demand', False) or 
                context.get('obstacle_clearance_active', False) or 
                (ch3 >= 0.80 and context.get('climb_angle_deg', 0.0) >= 70.0)):
            return Intent.PIGEON_STEEP_CLIMB, 0.96, {
                'climb_angle_deg': 80.0,
                'peel_lead_ms': 18.0,
            }

        # Rev R: Lepidopteran dorsal clap jet breakout (H-91)
        is_landing_mode = (
            self._last_intent in (Intent.APPROACH_NORMAL, Intent.LANDING_FLARE, Intent.TOUCHDOWN_ROLLOUT, Intent.GO_AROUND) or
            context.get('landing_approach', False) or
            context.get('landing_flare', False) or
            context.get('touchdown_rollout', False) or
            context.get('landing_regime') is not None
        )
        if not is_landing_mode and ((ch3 * 100.0 >= 85.0 and V_ms < 6.0) or context.get('clap_jet_demand', False)) and not on_ground:
            return Intent.CLAP_JET_BREAKOUT, 0.95, {
                'jet_ejection_ms': 22.0,
                'accel_g': 1.45,
            }

        # Rev S: Tailless metachronal differential sweep directional trim (H-100)
        if not on_ground and (abs(context.get('sideslip_beta_deg', 0.0)) > 3.0 or abs(context.get('yaw_drift_deg', 0.0)) > 2.5 or context.get('tailless_yaw_trim', False)):
            return Intent.DIFFERENTIAL_SWEEP_TRIM, 0.94, {
                'differential_sweep_deg': 12.0,
                'yaw_hold_deg': 0.5,
            }

        # Rev S: Cranial crest dynamic flap-inertia pitch counterbalance (H-101)
        if not on_ground and (context.get('pitch_servo_current_a', 0.0) > 4.2 or context.get('high_pitch_load', False) or context.get('pitch_balance_demand', False)):
            return Intent.CRANIAL_PITCH_BALANCE, 0.93, {
                'pitch_feedforward_gain': 0.82,
                'current_reduction_pct': 42.0,
            }

        # Rev T: Decapod Caridoid Impulse Flare & Escape Pulse (H-108)
        if context.get('caridoid_escape_demand', False) or context.get('emergency_flare', False) or context.get('collision_warning', False):
            return Intent.CARIDOID_ESCAPE_FLARE, 0.98, {
                'escape_thrust_n': 38.0,
                'duration_s': 0.12,
            }

        # Rev T: Sea Turtle In-Stroke Differential Flipper Pivot Braking (H-103)
        if not on_ground and (context.get('pivot_brake_demand', False) or context.get('turtle_turn', False) or (abs(ch4) > 0.40 and ch3 < 0.20 and not is_landing_mode)):
            turn_dir = 'left' if ch4 < 0 else 'right'
            return Intent.TURTLE_PIVOT_BRAKE, 0.95, {
                'direction': turn_dir,
                'turn_radius_m': 0.65,
                'flipper_aoa_deg': 24.0,
            }

        # Rev T: Cetacean Pectoral Hydrofoil Maneuver & Fluke Recoil Damping (H-105)
        if not on_ground and (context.get('cetacean_roll_demand', False) or context.get('recoil_damping_demand', False) or (abs(ch1) > 0.50 and context.get('heave_oscillation_rms', 0.0) > 0.30)):
            return Intent.CETACEAN_HYDROFOIL_ROLL, 0.94, {
                'roll_rate_degs': 180.0,
                'recoil_damping_active': True,
            }

        # Rev T: Plesiosaur Tandem Wake Capture (H-104)
        if not on_ground and (context.get('tandem_wake_demand', False) or context.get('wake_capture', False) or context.get('downstream_wake_detected', False)):
            return Intent.PLESIOSAUR_TANDEM_WAKE, 0.92, {
                'thrust_boost_pct': 22.5,
                'tandem_sync': True,
            }

        # Rev T: Crustacean Adlocomotory Metachronal Jet Coalescence (H-106)
        if not on_ground and (context.get('krill_jet_demand', False) or context.get('jet_coalescence', False) or (ch3 * 100.0 >= 88.0 and V_ms >= 14.0 and context.get('adlocomotory_mode', False))):
            return Intent.KRILL_JET_COALESCENCE, 0.93, {
                'phase_lag_deg': 55.0,
                'thrust_boost_pct': 26.8,
            }

        # Rev T: Copepod Dual-Mode Asymmetric Metachrony (H-107)
        if not on_ground and (context.get('copepod_metachrony_demand', False) or context.get('power_smoothing', False) or context.get('torque_ripple_pct', 0.0) > 28.0):
            return Intent.COPEPOD_METACHRONY, 0.91, {
                'ripple_reduction_pct': 48.5,
                'smoothing_active': True,
            }

        # Rev O3: crab via flat_turn mode + roll stick
        if (self._coord_mode == 'flat_turn'
                and abs(ch1) > 0.2 and not on_ground):
            crab_dir = 'left' if ch1 < 0 else 'right'
            crab_intent = (Intent.CRAB_LEFT
                if ch1 < 0 else Intent.CRAB_RIGHT)
            return crab_intent, abs(ch1), {
                'direction': crab_dir,
                'intensity': abs(ch1)}

        coord_mode = _wl.select_coordination_mode(
            mode_sw, macro_lng, on_ground)
        self._coord_mode = coord_mode

        # ── Ground ───────────────────────────────────────────────
        if on_ground or h_agl_m < 0.15:
            # Rev S: Pterosaur quadrupedal ground-coupled vault takeoff (H-98)
            # 1. Programmatic / autonomous API demand
            if context.get('vault_takeoff_demand', False):
                self._vault_armed = False
                return Intent.QUADRUPEDAL_VAULT, 0.98, {
                    'vault_impulse_g': 1.85,
                    'transition_timeout_s': 0.42,
                    'target_h_agl_m': 1.5,
                    'trigger': 'demand',
                }

            # 2. Pilot gesture arming: dual rudder pedals depressed (brakes held) +
            #    full forward throttle (>=0.85) + full aft stick (pitch >= 0.70)
            if pedals_depressed and ch3 >= 0.85 and ch2 >= 0.70 and abs(ch1) <= 0.25 and abs(ch4) <= 0.25:
                self._vault_armed = True
                self._vault_arm_t = t_now

            # 3. Armed state checks: rapid centering trigger vs cancellations
            elif self._vault_armed:
                dt_arm = t_now - self._vault_arm_t
                if not pedals_depressed:
                    # Cancelled: rudder pedals released on ground
                    self._vault_armed = False
                elif ch3 < 0.80:
                    # Cancelled: throttle backed off
                    self._vault_armed = False
                elif ch2 < -0.20 or abs(ch1) > 0.25 or abs(ch4) > 0.25:
                    # Cancelled: stick pushed forward into dive or lateral deflection
                    self._vault_armed = False
                elif dt_arm > 0.45:
                    # Cancelled: stick centered slowly (>0.45s)
                    self._vault_armed = False
                elif abs(ch2) <= 0.18:
                    # Rapid centering complete within window (dt <= 0.45s): FIRE UNIVERSAL LAUNCH BURST!
                    self._vault_armed = False
                    import mco_advanced_physics as ap
                    chrom, metrics = ap.select_optimal_launch_chromosome(context)
                    launch_mod = context.get('launch_modality', None)
                    if launch_mod == 'universal' or context.get('universal_launch', False):
                        intent = Intent.LAUNCH_BURST
                    elif launch_mod == 'dragonfly':
                        intent = Intent.DRAGONFLY_SUPER_LIFT
                    elif launch_mod == 'pterosaur' or not context.get('universal_launch', False):
                        intent = Intent.QUADRUPEDAL_VAULT
                    else:
                        intent = Intent.LAUNCH_BURST

                    return intent, 0.98, {
                        'chromosome': chrom,
                        'chromosome_name': chrom.name,
                        'vault_impulse_g': 1.85 if intent == Intent.QUADRUPEDAL_VAULT else metrics.get('peak_g', 1.85),
                        'transition_timeout_s': 0.42 if intent == Intent.QUADRUPEDAL_VAULT else chrom.macro_duration_max_s,
                        'target_h_agl_m': 1.5 if intent == Intent.QUADRUPEDAL_VAULT else max(1.5, metrics.get('alt_at_obs_m', 1.5)),
                        'trigger': 'rapid_center',
                        'dt_center_s': round(dt_arm, 3),
                        'fitness': metrics.get('fitness', 100.0),
                    }

            # Dragonfly 0° In-Phase Super-Lift Transition (H-LA-1)
            # Dedicated trigger only: requires explicit demand or launch switch
            if not pedals_depressed and not self._vault_armed and (
                    context.get('dragonfly_launch_demand', False) or context.get('vtol_launch_demand', False) or switches.get('sw_launch', False)) and V_ms <= 3.0:
                return Intent.DRAGONFLY_SUPER_LIFT, 0.98, {
                    'lift_boost_multiplier': 2.42,
                    'duration_s': 0.45,
                    'freq_hz': 2.50,
                }

            if wing_sw == 2:
                return Intent.INSPECTION, 1.0, {}
            if macro_lng:
                return Intent.TAXI_REV, 0.9, {'throttle': ch3, 'yaw': ch4, 'lateral': ch1}

            # ── Conventional Fixed-Wing Takeoff Suite (CTOL/STOL) & Touch-and-Go ────
            regime = context.get('takeoff_regime', context.get('regime', 'standard'))
            # Touch-and-Go / Takeoff Rotation Check: high throttle (>=0.50) or forward wave lever (>=78%)
            is_soft_field = (regime == 'soft_field')
            is_stol = (regime in ('short_field', 'stol', 'stol_takeoff'))
            vr_threshold = 2.5 if is_soft_field else (3.2 if is_stol else 3.5)
            is_takeoff_power = (ch3 >= 0.50 or lever_pct >= 78.0)
            # Rejected Rollout Go-Around / Balked Landing demand
            if is_takeoff_power and (context.get('go_around_demand', False) or context.get('balked_landing', False)):
                return Intent.GO_AROUND, 0.98, {
                    'throttle': ch3,
                    'pitch': ch2,
                    'lever_pct': lever_pct,
                    'regime': regime,
                    'h_agl_m': h_agl_m,
                    'V_ms': V_ms,
                    'vz_ms': context.get('vz_ms', 0.0),
                    'crosswind_ms': context.get('crosswind_ms', 0.0),
                    'lateral': ch1,
                    'yaw': ch4,
                }

            if is_takeoff_power and ch2 > 0.15 and (V_ms >= vr_threshold or context.get('rotate_demand', False)):
                return Intent.ROTATE, 0.95, {
                    'regime': regime,
                    'pitch': ch2,
                    'yaw': ch4,
                }

            # Takeoff Roll / Touch-and-Go Re-acceleration: advancing throttle + neutral/forward stick
            if is_takeoff_power and ch2 <= 0.15:
                return Intent.TAKEOFF_ROLL, 0.95, {
                    'regime': regime,
                    'throttle': ch3,
                    'yaw': ch4,
                }

            # ── Conventional Fixed-Wing Rollout & Aerodynamic Wing Braking ────
            landing_regime = context.get('landing_regime', context.get('regime', 'standard_power_off'))
            in_rollout = (
                context.get('touchdown_rollout', False) or
                context.get('landing_rollout', False) or
                (self._last_intent in (Intent.LANDING_FLARE, Intent.APPROACH_NORMAL, Intent.TOUCHDOWN_ROLLOUT) and lever_pct < 78.0) or
                (V_ms >= 4.5 and not context.get('takeoff_roll_demand', False)) or
                (lever_pct < 40.0 and not context.get('takeoff_roll_demand', False))
            )
            if in_rollout:
                # Auto-transition to ground taxi when speed drops below 4.5 m/s and wave lever is not actively braking (<40%)
                if V_ms < 4.5 and lever_pct >= 40.0 and ch3 <= 0.35 and not (context.get('touchdown_rollout', False) and lever_pct < 40.0):
                    return Intent.TAXI_FWD, 0.9, {'throttle': ch3, 'yaw': ch4, 'lateral': ch1}

                return Intent.TOUCHDOWN_ROLLOUT, 0.96, {
                    'regime': landing_regime,
                    'lever_pct': lever_pct,
                    'throttle': ch3,
                    'yaw': ch4,
                    'pitch': ch2,
                    'lateral': ch1,
                    'V_ms': V_ms,
                }

            # Cracked-throttle taxi (with pedal yaw steering and stick lateral translation)
            return Intent.TAXI_FWD, 0.9, {'throttle': ch3, 'yaw': ch4, 'lateral': ch1}
        else:
            self._vault_armed = False

        # ── Cargo Drone & eVTOL Flight Modes ─────────────────────
        # 1. Cargo Drop de-ballooning pitch step (H-CR-2)
        if context.get('payload_release_cmd', False) or context.get('cargo_drop_cmd', False):
            return Intent.PAYLOAD_DROP, 1.0, {
                'de_balloon_pitch_deg': -2.0,
                'duration_s': 0.50,
            }
        # 2. Cargo sling pendulum suppression (H-HL-3)
        if context.get('sling_pendulum_active', False) or abs(context.get('cargo_swing_deg', 0.0)) > 8.0:
            return Intent.CARGO_SWING_DAMP, 0.95, {
                'swing_deg': context.get('cargo_swing_deg', 0.0),
                'damping_axis': 'pitch_cascade',
            }
        # 3. eVTOL In-Ground Effect (IGE) ground cushion & vertiport pad lock
        if not on_ground and 0.05 <= h_agl_m < 0.50 and (V_ms < 3.5 or context.get('vertiport_hover', False)):
            return Intent.IGE_CUSHION, 0.95, {
                'h_agl_m': h_agl_m,
                'cushion_freq_damping': 0.85,
            }
        # 4. eVTOL Vertiport steep approach (H-FD-2)
        if context.get('vertiport_approach', False) and not on_ground:
            return Intent.VERTIPORT_APPROACH, 0.95, {
                'target_glide_deg': context.get('vertiport_glide_deg', 8.5),
                'steep_dihedral_deg': 50.0,
            }

        # 5. Fragile / Sensitive Cargo Stabilization & G-limit envelope (H-41)
        if (context.get('sensitive_cargo', False) or context.get('fragile_payload', False)
                or context.get('medical_cargo', False)) and not on_ground:
            return Intent.CARGO_STABILIZE, 0.94, {
                'heave_damping': True,
                'anti_phase_pitch': True,
                'peak_g_limit': 1.15,
            }

        # 6. Payload & Sensor Line-of-Sight Active Heave/Pitch Stabilization (H-41)
        if (context.get('comfort_mode', False) or context.get('sensor_stab_mode', False) or context.get('passenger_flight', False)
                or (context.get('imu_rms_g', 0.0) > 0.08 and not on_ground)):
            return Intent.RIDE_COMFORT, 0.92, {
                'heave_damping': True,
                'anti_phase_pitch': True,
                'target_rms_g': 0.03,
            }

        # ── Aquatic Bird Flight Biomechanics Suite (Top 4) ───────
        on_water = context.get('on_water', False) or context.get('surface_is_water', False)
        h_water = context.get('h_water_m', h_agl_m)

        # 7. H-WD-1: Gull Clap-and-Fling Water Departure Synergy Burst
        if on_water and h_water <= 0.54 and V_ms >= 8.5:
            return Intent.WATER_CLAP_BURST, 0.96, {
                'lift_boost_pct': 22.0,
                'h_water_m': h_water,
                'duration_s': 0.40,
            }

        # 8. H-WD-2: Mallard Decoupled Front-Thrust / Rear-Lift Hump Penetration
        if on_water and 3.5 <= V_ms < 8.5:
            return Intent.MALLARD_HUMP_BREAKOUT, 0.94, {
                'front_sweep_deg': 55.0,
                'rear_aoa_deg': 16.0,
            }

        # 9. H-WD-3: Seagull Asymmetric High-Q Water Departure Kinematics
        if on_water and V_ms < 3.5:
            return Intent.GULL_ASYMMETRIC_STROKE, 0.90, {
                'Q_ratio': 1.90,
                'splash_reduction': True,
            }

        # 10. Pelican Wave-Following Wing-In-Ground (WIG) Compression Cruise
        if not on_ground and 0.08 <= h_water <= 0.65 and V_ms >= 6.5 and (
                context.get('wig_cruise_demand', False) or context.get('over_water', False) or on_water):
            return Intent.WIG_CRUISE, 0.93, {
                'target_h_m': 0.25,
                'induced_drag_reduction_pct': 86.0,
            }

        # 11. H-LA-1: Dragonfly 0° In-Phase Super-Lift Transition (explicit demand/switch only)
        if (on_ground or h_agl_m <= 0.6) and (context.get('dragonfly_launch_demand', False) or context.get('vtol_launch_demand', False) or switches.get('sw_launch', False)) and V_ms <= 3.0:
            return Intent.DRAGONFLY_SUPER_LIFT, 0.98, {
                'lift_boost_multiplier': 2.42,
                'duration_s': 0.45,
                'freq_hz': 2.50,
            }

        # ── Conventional Fixed-Wing Approach & Flare Suite ───────
        landing_reg = context.get('landing_regime', context.get('regime', 'standard_power_off'))

        # 0. Universal Go-Around / Balked Landing Trigger:
        # Initiated from approach, flare, or touchdown rollout upon advancing throttle/lever to TOGA
        is_landing_context = (
            self._last_intent in (Intent.APPROACH_NORMAL, Intent.LANDING_FLARE, Intent.TOUCHDOWN_ROLLOUT,
                                  Intent.SLOTTED_FLAP_GLIDE, Intent.GLIDE) or
            context.get('landing_approach', False) or
            context.get('landing_flare', False) or
            context.get('touchdown_rollout', False) or
            context.get('landing_regime') is not None or
            (h_agl_m <= 40.0 and context.get('regime') in ('standard_power_off', 'commercial_powered', 'short_field',
                                                           'soft_field', 'stol', 'stol_landing', 'tailwheel_3point',
                                                           'tailwheel_wheel_landing'))
        )
        is_normal_takeoff_roll = (
            on_ground and
            self._last_intent in (Intent.TAKEOFF_ROLL, Intent.ROTATE) and
            not context.get('touchdown_rollout', False)
        )
        is_toga_demand = (
            ch3 >= 0.60 or
            lever_pct >= 75.0 or
            context.get('go_around_demand', False) or
            context.get('balked_landing', False) or
            switches.get('sw_go_around', False)
        )
        if is_landing_context and not is_normal_takeoff_roll and is_toga_demand and ch2 >= -0.20:
            return Intent.GO_AROUND, 0.98, {
                'throttle': ch3,
                'pitch': ch2,
                'lever_pct': lever_pct,
                'regime': landing_reg,
                'h_agl_m': h_agl_m,
                'V_ms': V_ms,
                'vz_ms': context.get('vz_ms', -0.5),
                'crosswind_ms': context.get('crosswind_ms', 0.0),
                'lateral': ch1,
                'yaw': ch4,
            }
        # 1. Flare: low altitude (h_agl <= 2.0m) during landing approach
        is_takeoff_climb = (
            self._last_intent in (Intent.TAKEOFF_ROLL, Intent.ROTATE, Intent.CLIMB, Intent.PIGEON_STEEP_CLIMB)
            or (ch3 >= 0.50 and not context.get('landing_flare', False) and not context.get('flare_demand', False))
            or context.get('climb_demand', False)
            or context.get('vz_ms', 0.0) > 0.20
        )
        has_flare_demand = context.get('flare_demand', False) or context.get('landing_flare', False)
        is_approach_transition = self._last_intent in (Intent.APPROACH_NORMAL, Intent.LANDING_FLARE)

        if not on_ground and not is_takeoff_climb and (h_agl_m <= 2.0 or has_flare_demand):
            if has_flare_demand or is_approach_transition or (ch2 > 0.05 and ch3 <= 0.40):
                return Intent.LANDING_FLARE, 0.96, {
                    'regime': landing_reg,
                    'pitch': ch2,
                    'throttle': ch3,
                    'h_agl_m': h_agl_m,
                    'V_ms': V_ms,
                    'crosswind_ms': context.get('crosswind_ms', 0.0),
                    'lateral': ch1,
                    'yaw': ch4,
                }

        # 2. Initial Takeoff Climbout (unstick to pattern altitude)
        if context.get('pelican_deep_stroke_demand', False) or (ch3 >= 0.75 and V_ms < 6.0 and context.get('deep_stroke_demand', False)):
            return Intent.PELICAN_DEEP_STROKE, 0.96, {
                'throttle': ch3,
                'pitch': ch2,
                'lever_pct': ch3 * 100.0,
                'V_ms': V_ms,
                'h_agl_m': h_agl_m,
            }

        if not on_ground and self._last_intent in (Intent.ROTATE, Intent.TAKEOFF_ROLL) and ch3 >= 0.50:
            return Intent.CLIMB, 0.95, {
                'throttle': ch3,
                'pitch': max(0.15, ch2),
                'lever_pct': ch3 * 100.0,
                'h_agl_m': h_agl_m,
                'V_ms': V_ms,
            }

        # 3. Approach: explicit approach demand/regime or descending glide path near runway
        is_stol_regime = (landing_reg in ('short_field', 'stol', 'stol_landing', 'stol_spot'))
        is_stol_approach = (context.get('stol_approach', False) or (is_stol_regime and ch3 <= 0.45 and not is_takeoff_climb))
        if not on_ground and (
                context.get('landing_approach', False) or
                context.get('approach_demand', False) or
                context.get('approach_normal', False) or
                context.get('stol_approach', False) or
                (context.get('landing_regime') is not None and h_agl_m <= 50.0 and ch3 <= 0.50) or
                (is_stol_approach and h_agl_m <= 35.0 and V_ms <= 8.0) or
                (h_agl_m <= 25.0 and ch3 <= 0.45 and ch2 <= 0.08 and V_ms >= 4.0 and not context.get('falcon_morph', False))):
            return Intent.APPROACH_NORMAL, 0.94, {
                'regime': landing_reg,
                'throttle': ch3,
                'pitch': ch2,
                'lateral': ch1,
                'yaw': ch4,
                'h_agl_m': h_agl_m,
                'V_ms': V_ms,
                'crosswind_ms': context.get('crosswind_ms', 0.0),
            }
        if wing_sw == 0:
            gs_id = 'GS-0'
        elif wing_sw == 1:
            gs_id = 'GS-2' if (V_ms > 10.0 and ch3 < 0.3) else 'GS-1'
        else:
            if macro_lng:   gs_id = 'GS-5'
            elif macro_sw:  gs_id = 'GS-3'
            else:           gs_id = 'GS-4'

        # ── Macro triggers ───────────────────────────────────────
        if macro_sw or macro_lng:
            if mode_sw == 0:
                if macro_lng:
                    return Intent.STOOP, 0.95, {'gs_id': gs_id}
                return Intent.CF1_BURST, 0.9, {}
            elif mode_sw == 1:
                direction = 'right' if ch1 > 0 else 'left'
                if macro_lng:
                    # Full roll + long press = dart (Rev L)
                    if abs(ch1) > 0.7:
                        di = 'right' if ch1 > 0 else 'left'
                        return (Intent.DART_RIGHT if ch1 > 0
                                else Intent.DART_LEFT), 0.95, {
                                    'direction': di}
                    return Intent.CHANDELLE, 0.9, {'direction': direction}
                return Intent.TIGHT_TURN, 0.95, {
                    'bank_deg': 65.0, 'direction': direction}
            elif mode_sw == 2:
                if macro_lng:
                    return Intent.APPROACH_SITE, 0.9, {}
                return Intent.SPIRAL_DOWN, 0.9, {}

        # ── SAR mode ────────────────────────────────────────────
        if mode_sw == 2:
            if context.get('thermal_loiter', False) or context.get('sar_loiter', False):
                # Rev S: Azhdarchid thermal soaring deep-camber loiter (H-102)
                return Intent.AZHDARCHID_SOAR, 0.95, {
                    'min_sink_ms': 0.38,
                    'endurance_boost_pct': 86.0,
                    'gs_id': gs_id,
                }
            if abs(ch1) < self.STICK_THRESHOLD:
                return Intent.LOITER, 0.8, {'gs_id': gs_id}
            if ch1 > self.ROLL_TURN_MIN:
                return Intent.ORBIT_RIGHT, 0.8, {
                    'bank_deg': 30 + ch1*20, 'gs_id': gs_id}
            return Intent.ORBIT_LEFT, 0.8, {
                'bank_deg': 30 + abs(ch1)*20, 'gs_id': gs_id}

        # ── Manoeuvre mode ───────────────────────────────────────
        if mode_sw == 1:
            if abs(ch1) > self.STICK_THRESHOLD:
                direction = 'right' if ch1 > 0 else 'left'
                bank = min(30 + abs(ch1)*35, 65.0)
                if abs(ch1) > 0.85:
                    # Rev P: Anhedral gull-wing knife-edge turn trapping (H-82)
                    return Intent.ANHEDRAL_TURN, abs(ch1), {
                        'direction': direction,
                        'bank_deg': bank,
                        'gs_id': gs_id,
                    }
                if ch2 > 0.3 and abs(ch1) > 0.5:
                    return Intent.CHANDELLE, 0.85, {
                        'direction': direction, 'gs_id': gs_id}
                mt = 'MT-4' if bank > 60 else 'MT-3' if bank > 45 else 'MT-2'
                return Intent.TIGHT_TURN, abs(ch1), {
                    'bank_deg': bank, 'direction': direction,
                    'mt_id': mt, 'gs_id': gs_id,
                    'coord_mode': coord_mode}

        # ── Cruise mode ──────────────────────────────────────────
        lever_pct = ch3 * 100.0

        if context.get('falcon_dart', False) or context.get('falcon_trim', False) or (lever_pct >= 85.0 and V_ms >= 14.0 and not context.get('force_sprint', False)):
            # H-FALCON-TRIM-1: Fanned bi-delta tailplane fast cruise & level dash
            return Intent.FALCON_DART, 0.96, {
                'lever_pct': lever_pct,
                'V_ms': V_ms,
                'sweep_schedule_deg': [5.0, 15.0, 28.0, 50.0],
                'tailplane_aoa_deg': -5.5,
                'gs_id': gs_id,
            }

        if lever_pct >= 85.0:
            if V_ms < 6.0:
                # Rev R: Lepidopteran dorsal clap jet breakout (H-91)
                return Intent.CLAP_JET_BREAKOUT, 0.95, {
                    'jet_ejection_ms': 22.0,
                    'accel_g': 1.45,
                    'gs_id': gs_id,
                }
            return Intent.SPRINT, 1.0, {'lever_pct': lever_pct, 'gs_id': gs_id}

        if abs(ch1) > self.ROLL_TURN_MIN:
            direction = 'right' if ch1 > 0 else 'left'
            roll_abs  = abs(ch1)
            if   roll_abs > 0.70: mt = 'MT-3'; bank = 55 + roll_abs*10
            elif roll_abs > 0.30: mt = 'MT-2'; bank = 35 + roll_abs*20
            else:                  mt = 'MT-1'; bank = 20 + roll_abs*30
            bank = min(bank, 65.0)
            return (Intent.TIGHT_TURN if bank > 50 else
                    Intent.TURN_RIGHT if ch1 > 0 else Intent.TURN_LEFT), \
                   roll_abs, {'bank_deg': bank, 'direction': direction,
                              'mt_id': mt, 'gs_id': gs_id,
                              'coord_mode': coord_mode}

        if lever_pct > 52.5 and (ch2 >= 0.12 or (ch3 >= 0.65 and h_agl_m < 50.0 and ch2 >= 0.05)):
            if ch2 >= 0.70 or context.get('obstacle_climb', False):
                # Rev R: Coleopteran elytron canard obstacle climb (H-92)
                return Intent.ELYTRON_CANARD, 0.90, {
                    'canard_locked_station': 1,
                    'canard_incidence_deg': 8.5,
                    'climb_angle_deg': 48.0,
                    'gs_id': gs_id,
                }
            return Intent.CLIMB, ch2, {'lever_pct': lever_pct, 'gs_id': gs_id}

        if 65.0 <= lever_pct < 85.0 and V_ms >= 10.0:
            # Rev Q: Reverse metachronal cascade cruise thrust boost (H-86)
            return Intent.REVERSE_CASCADE_CRUISE, 0.90, {
                'lever_pct': lever_pct,
                'cascade_phase_deg': -60.0,
                'thrust_boost_pct': 24.5,
                'gs_id': gs_id,
            }

        if 47.5 <= lever_pct <= 65.0 and V_ms >= 9.0 and not context.get('high_turbulence', False):
            # Rev R: Orthopteran traveling torsional wave cruise (H-94)
            return Intent.LOCUST_TORSIONAL_CRUISE, 0.88, {
                'lever_pct': lever_pct,
                'torsional_amplitude_deg': 4.2,
                'drag_reduction_pct': 32.0,
                'gs_id': gs_id,
            }

        if lever_pct < 47.5:
            if not on_ground and (context.get('thermal_loiter', False) or context.get('sar_loiter', False) or context.get('azhdarchid_soar', False) or ('w_sink_ms' in context and context['w_sink_ms'] > -0.8 and V_ms >= 6.0)):
                # Rev S: Azhdarchid thermal soaring deep-camber loiter (H-102)
                return Intent.AZHDARCHID_SOAR, 0.95, {
                    'lever_pct': lever_pct,
                    'min_sink_ms': 0.38,
                    'endurance_boost_pct': 86.0,
                    'gs_id': gs_id,
                }
            if ch2 < -0.05 or context.get('falcon_morph', False) or context.get('morphing_polar', False):
                return Intent.GLIDE, 1.0, {'lever_pct': lever_pct, 'gs_id': gs_id, 'falcon_morph': True}
            if V_ms >= 4.0:
                # Rev R: Tandem dynamic slotted Fowler flap glide (H-95)
                return Intent.SLOTTED_FLAP_GLIDE, 0.92, {
                    'lever_pct': lever_pct,
                    'slot_fowler_cl_max': 2.45,
                    'gs_id': gs_id,
                }
            return Intent.GLIDE, 1.0, {'lever_pct': lever_pct, 'gs_id': gs_id}

        if self.LEVER_DETENT_LOW <= lever_pct <= self.LEVER_DETENT_HIGH:
            return Intent.CRUISE, 0.7, {'lever_pct': lever_pct, 'gs_id': gs_id}

        return Intent.CRUISE, 0.8, {'lever_pct': lever_pct, 'throttle': ch3, 'gs_id': gs_id}


# ── BEHAVIOUR NODE BASE ──────────────────────────────────────────

RUNNING = 'RUNNING'
SUCCESS = 'SUCCESS'
FAILURE = 'FAILURE'


class BehaviourNode:
    name          = 'base'
    priority      = 99
    interruptible = True

    def __init__(self):
        self._state   = None
        self._t_start = None
        self._log     = []

    def on_enter(self, context):
        self._t_start = context.get('t', 0.0)
        self._state   = RUNNING

    def tick(self, context, ctrl):
        return RUNNING

    def on_exit(self, context, completed):
        pass

    def can_be_preempted_by(self, other_priority, is_safety=False):
        if is_safety: return True
        if not self.interruptible: return False
        return other_priority <= self.priority

    def elapsed(self, context):
        if self._t_start is None: return 0.0
        return context.get('t', 0.0) - self._t_start

    def log(self, msg):
        self._log.append(msg)


# ── CONTINUOUS BEHAVIOURS ────────────────────────────────────────

class CruiseBehaviour(BehaviourNode):
    name = 'cruise'; priority = 10; interruptible = True
    def tick(self, context, ctrl):
        import mco_wave_library as wl
        Ps    = context.get('Ps', 0.2)
        V     = context.get('V_ms', 8.5)
        pitch = context.get('pitch_deg', 0.0)
        lever = context.get('lever_pct', 60.0)
        p = wl.lever_airspeed_params(lever, V, pitch, Ps, ctrl.freq_hz)
        ctrl._tgt_freq      = p['freq_hz']
        ctrl._tgt_sweeps    = [p['sweep_deg']] * 8
        ctrl._tgt_dihedrals = [p['dihedral_deg']] * 8
        ctrl._tgt_pitches   = [p['pitch_deg']] * 8
        return RUNNING


class ClimbBehaviour(BehaviourNode):
    name = 'climb'; priority = 9; interruptible = True
    def tick(self, context, ctrl):
        import mco_wave_library as wl
        Ps    = context.get('Ps', 0.5)
        V     = context.get('V_ms', 8.5)
        pitch = context.get('pitch_deg', 10.0)
        lever = context.get('lever_pct', 82.0)
        # Rev O3: near stall → X-29 forward sweep for retained authority
        x29 = wl.x29_high_aoa_params(V, Ps, ctrl.freq_hz)
        if x29 is not None:
            ctrl._tgt_freq      = x29['freq_hz']
            ctrl._tgt_sweeps    = x29['sweeps']
            ctrl._tgt_dihedrals = x29['dihedrals']
            ctrl._tgt_pitches   = x29['pitches']
        else:
            p = wl.lever_airspeed_params(lever, V, pitch, Ps, ctrl.freq_hz)
            ctrl._tgt_freq      = p['freq_hz']
            ctrl._tgt_sweeps    = [p['sweep_deg']] * 8
            ctrl._tgt_dihedrals = [0.0] * 8
            ctrl._tgt_pitches   = [p['pitch_deg']] * 8
        return RUNNING


class GlideBehaviour(BehaviourNode):
    """Unified lever — glide/approach/airbrake zones with Falcon Morphing Polar (Glide-Dive-Stoop)."""
    name = 'glide'; priority = 9; interruptible = True
    def tick(self, context, ctrl):
        import mco_wave_library as wl
        import mco_advanced_physics as ap

        sticks = context.get('sticks', {})
        ch2 = context.get('pitch', sticks.get('pitch', sticks.get('ch2', context.get('ch2', 0.0))))
        lever = context.get('lever_pct', 35.0)
        V     = context.get('V_ms', 8.0)
        Ps    = context.get('Ps', 0.0)
        pitch = context.get('pitch_deg', 0.0)
        h_agl = context.get('h_agl_m', context.get('h_agl', 100.0))

        # Check if Falcon morphing polar active (continuous stick pitch modulation or explicit flag)
        if ch2 < -0.05 or context.get('falcon_morph', False) or context.get('morphing_polar', False):
            alc_bias = context.get('alc_bias', None)
            if alc_bias is None and 'w_netto_ms' in context:
                alc_bias = ap.alc_maccready_glide_bias(context['w_netto_ms'])
            pilot_ctrl = {
                'ch1': context.get('roll', sticks.get('roll', sticks.get('ch1', context.get('ch1', 0.0)))),
                'ch4': context.get('yaw', sticks.get('yaw', sticks.get('ch4', context.get('ch4', 0.0)))),
            }
            cmds, freq_hz, diag = ap.falcon_morphing_glide_polar(
                pitch_stick=ch2,
                V_ms=V,
                h_agl_m=h_agl,
                gross_weight_kg=context.get('gross_weight_kg', 5.687),
                alc_bias=alc_bias,
                pilot_controls=pilot_ctrl
            )
            ctrl._tgt_freq      = freq_hz
            ctrl._tgt_sweeps    = [c['sweep_deg'] for c in cmds]
            ctrl._tgt_dihedrals = [c['dihedral_deg'] for c in cmds]
            ctrl._tgt_pitches   = [c['pitch_deg'] for c in cmds]
            ctrl.falcon_morph_diag = diag
            return RUNNING

        safe, _ = wl.lever_stall_check(lever, V)
        if not safe:
            lever = max(lever, 15.0)
        if wl.lever_in_detent(lever):
            return RUNNING
        p = wl.lever_airspeed_params(lever, V, pitch, Ps, ctrl.freq_hz)
        ctrl._tgt_freq      = p['freq_hz']
        ctrl._tgt_sweeps    = [p['sweep_deg']]    * 8
        ctrl._tgt_dihedrals = [p['dihedral_deg']] * 8
        ctrl._tgt_pitches   = [p['pitch_deg']]    * 8
        return RUNNING


class TurnBehaviour(BehaviourNode):
    """Four-phase Boyd turn with Rev K auto-coordination."""
    name = 'turn'; priority = 8; interruptible = True
    PHASE_ENTRY   = 'entry'
    PHASE_BANKED  = 'banked'
    PHASE_ROLLOUT = 'rollout'
    PHASE_RESUME  = 'resume'

    def on_enter(self, context):
        super().on_enter(context)
        self._phase      = self.PHASE_ENTRY
        self._phase_t    = context.get('t', 0.0)
        self._mt_id      = context.get('mt_id', 'MT-1')
        self._dir        = context.get('direction', 'right')

    def tick(self, context, ctrl):
        import mco_wave_library as wl
        t         = context.get('t', 0.0)
        V_ms      = context.get('V_ms', 9.0)
        bank_deg  = context.get('bank_deg', 0.0)
        Ps        = context.get('Ps', 0.5)
        coord     = context.get('coord_mode', 'auto')
        dt_phase  = t - self._phase_t
        mm        = wl.MANOEUVRE_MODES.get(self._mt_id, {})
        bank_tgt  = mm.get('bank_deg', 30.0)

        if self._phase == self.PHASE_ENTRY:
            cmd = wl.turn_entry_commands(bank_tgt, self._dir, V_ms, ctrl.freq_hz)
            ctrl._tgt_freq      = cmd['freq_hz']
            ctrl._tgt_sweeps    = cmd['sweeps']
            ctrl._tgt_dihedrals = cmd['dihedrals']
            ctrl._tgt_pitches   = [cmd['pitch_deg']] * 8
            if dt_phase >= 0.5 or abs(bank_deg) > 5.0:
                self._phase   = self.PHASE_BANKED
                self._phase_t = t

        elif self._phase == self.PHASE_BANKED:
            cmd = wl.turn_in_progress_commands(
                bank_deg=abs(bank_deg), turn_direction=self._dir,
                V_ms=V_ms, Ps=Ps, current_freq_hz=ctrl.freq_hz)
            ctrl._tgt_freq   = cmd['freq_hz']
            ctrl._tgt_sweeps = cmd['sweeps']
            base_d = cmd['dihedrals']
            if coord == 'auto':
                base_d = wl.auto_coordinated_params(
                    base_d, bank_deg, V_ms,
                    context.get('yaw_rate_radps', 0.0), self._dir)
            elif coord in ('decoupled', 'semi'):
                yd = wl.yaw_dihedral_asymmetry(context.get('yaw', 0.0))
                base_d = [base_d[i] + yd[i] for i in range(8)]
            ctrl._tgt_dihedrals = base_d
            ctrl._tgt_pitches   = [cmd['pitch_deg']] * 8

        elif self._phase == self.PHASE_ROLLOUT:
            cmd = wl.turn_rollout_commands(abs(bank_deg), self._dir)
            ctrl._tgt_freq      = cmd['freq_hz']
            ctrl._tgt_sweeps    = cmd['sweeps']
            ctrl._tgt_dihedrals = cmd['dihedrals']
            ctrl._tgt_pitches   = [cmd['pitch_deg']] * 8
            if abs(bank_deg) < 5.0 and dt_phase > 0.5:
                self._phase   = self.PHASE_RESUME
                self._phase_t = t

        elif self._phase == self.PHASE_RESUME:
            ctrl._tgt_freq      = wl.TURN_CRUISE_FREQ_HZ
            ctrl._tgt_sweeps    = [60.0] * 8
            ctrl._tgt_dihedrals = [0.0]  * 8
            ctrl._tgt_pitches   = [0.0]  * 8
            if dt_phase >= 2.0:
                self._state = SUCCESS
                return SUCCESS

        return RUNNING

    def begin_rollout(self, context):
        if self._phase == self.PHASE_BANKED:
            self._phase   = self.PHASE_ROLLOUT
            self._phase_t = context.get('t', 0.0)


class SprintBehaviour(BehaviourNode):
    name = 'sprint'; priority = 9; interruptible = True
    def tick(self, context, ctrl):
        import mco_wave_library as wl
        Ps = context.get('Ps', 1.0)
        V  = context.get('V_ms', 12.0)
        freq, sweep, dihs, pitch = wl.sprint_params(Ps, V, 0.02, ctrl.freq_hz)
        ctrl._tgt_freq      = freq
        ctrl._tgt_sweeps    = [sweep] * 8
        ctrl._tgt_dihedrals = dihs
        ctrl._tgt_pitches   = [pitch] * 8
        return RUNNING


class FalconDartBehaviour(BehaviourNode):
    """
    H-FALCON-TRIM-1: Fanned Bi-Delta Tailplane Fast Cruise & Level Dash.
    Stations 1-3 active propulsive cascade (+5°, +15°, +28° sweep, ±18° stroke),
    Station 4 stationary FBW tailplane (+50° sweep, 0° stroke, -5.5° pitch trim).
    Adversarially hardened with 350ms S-curve motor deceleration and 120ms pitch lead.
    """
    name = 'falcon_dart'; priority = 6; interruptible = True

    def tick(self, context, ctrl):
        import mco_wave_library as wl
        import mco_flight_governor as fg
        V = context.get('V_ms', 20.80)
        t = context.get('t', 0.0)
        dt = context.get('dt_s', 0.02)
        sticks = context.get('sticks', {})
        p_stk = context.get('pitch_stick', sticks.get('pitch', sticks.get('ch2', 0.0)))
        r_stk = context.get('roll_stick', sticks.get('roll', sticks.get('ch1', 0.0)))
        y_stk = context.get('yaw_stick', sticks.get('yaw', sticks.get('ch4', 0.0)))
        on_gnd = context.get('on_ground', False)

        f_hz = 3.0 if V >= 24.0 else 2.8
        wave_res = wl.wave_falcon_dart(
            t_sec=t, f_hz=f_hz, flap_amp_deg=18.0,
            v_ms=V, pitch_stick=p_stk, roll_stick=r_stk, yaw_stick=y_stk,
            on_ground=on_gnd
        )

        # Coordinate spin-down and pitch-lead handshake
        trans = fg.govern_falcon_dart_transition(
            dt_s=dt,
            falcon_mode_requested=(not wave_res['aborted']),
            current_f_hz=f_hz,
            nominal_amp_deg=18.0,
            w4_pitch_cmd=-5.5,
            w4_dih_cmd=0.0
        )

        ctrl._tgt_freq = wave_res['f_hz']
        # 8 wings: W1 port/stbd (5°), W2 port/stbd (15°), W3 port/stbd (28°), W4 port/stbd (50°)
        ctrl._tgt_sweeps = [5.0, 5.0, 15.0, 15.0, 28.0, 28.0, 50.0, 50.0]
        # W4 dihedral is thermally clamped to safe low holding range (0.0° to 3.0°)
        w4_dih = trans['w4_dihedral_deg']
        ctrl._tgt_dihedrals = [5.0, 5.0, 5.0, 5.0, 5.0, 5.0, w4_dih, w4_dih]
        # Washout trim: W1 (+2.5°), W2 (+1.5°), W3 (+1.0°), W4 (active lead/handshake pitch)
        w4_pitch = trans['w4_pitch_trim_deg']
        ctrl._tgt_pitches = [2.5, 2.5, 1.5, 1.5, 1.0, 1.0, w4_pitch, w4_pitch]

        # Station 4 stationary tailplane lock flag and amplitude scale
        if hasattr(ctrl, 'stationary_tailplane_active'):
            ctrl.stationary_tailplane_active = (trans['state'] == 'DART_LOCKED')
        if hasattr(ctrl, 'w4_amp_scale'):
            ctrl.w4_amp_scale = trans['w4_amp_scale']

        wave_res['transition_gov'] = trans
        ctrl.falcon_dart_diag = wave_res
        return RUNNING


# ── MACRO BEHAVIOURS ─────────────────────────────────────────────

class StoopMacro(BehaviourNode):
    """
    Falcon high-speed diving stoop with automated pullout.

    [AUTOPILOT DEFERRED]
    Designated as an autonomous trajectory function deferred to the post-first-flight
    autopilot implementation bucket (see _AUTOPILOT_DEFERRED['STOOP_MACRO']
    in mco_wave_library.py). Not part of active manual-pilot flight laws.
    """
    name = 'stoop'; priority = 2; interruptible = False
    PHASES = ['entry', 'dive', 'pullout', 'recovery']

    def on_enter(self, context):
        super().on_enter(context)
        self._phase   = 'entry'
        self._phase_t = context.get('t', 0.0)

    def tick(self, context, ctrl):
        import mco_wave_library as wl
        t     = context.get('t', 0.0)
        V_ms  = context.get('V_ms', 0.0)
        h_agl = context.get('h_agl_m', 100.0)
        Ps    = context.get('Ps', 0.0)
        dt    = t - self._phase_t

        if self._phase == 'entry':
            freq, sw, dihs, pt = wl.stoop_dive_params(V_ms, h_agl, ctrl.freq_hz)
            ctrl._tgt_sweeps    = [sw]  * 8
            ctrl._tgt_dihedrals = dihs
            ctrl._tgt_freq      = freq
            ctrl._tgt_pitches   = [pt] * 8
            if all(s > 200 for s in ctrl._tgt_sweeps):
                self._phase = 'dive'; self._phase_t = t

        elif self._phase == 'dive':
            freq, sw, dihs, pt = wl.stoop_dive_params(V_ms, h_agl, ctrl.freq_hz)
            ctrl._tgt_freq      = freq
            ctrl._tgt_sweeps    = [sw]  * 8
            ctrl._tgt_dihedrals = dihs
            ctrl._tgt_pitches   = [pt] * 8
            pullout, reason = wl.ps_pullout_recommended(
                Ps, h_agl, V_ms, V_ms - wl.VS_KT/1.944)
            if pullout:
                self._phase = 'pullout'; self._phase_t = t

        elif self._phase == 'pullout':
            freq, sw, dihs, pt = wl.stoop_pullout_params(Ps, V_ms, 0.02, ctrl.freq_hz)
            ctrl._tgt_freq      = freq
            ctrl._tgt_sweeps    = [sw]  * 8
            ctrl._tgt_dihedrals = dihs
            ctrl._tgt_pitches   = [pt] * 8
            if V_ms < 12.0 and dt > 2.0:
                self._phase = 'recovery'; self._phase_t = t

        elif self._phase == 'recovery':
            ctrl._tgt_sweeps    = [60.0] * 8
            ctrl._tgt_freq      = 0.8
            ctrl._tgt_dihedrals = [0.0]  * 8
            ctrl._tgt_pitches   = [0.0]  * 8
            if dt > 3.0:
                self._state = SUCCESS; return SUCCESS

        return RUNNING

    def can_be_preempted_by(self, other_priority, is_safety=False):
        return is_safety or other_priority == 0


class CF1Macro(BehaviourNode):
    """
    Clap-and-fling high-thrust vortex burst sequence.

    [AUTOPILOT DEFERRED]
    Designated as an autonomous trajectory function deferred to the post-first-flight
    autopilot implementation bucket (see _AUTOPILOT_DEFERRED['CF1_BURST_MACRO']
    in mco_wave_library.py). Not part of active manual-pilot flight laws.
    """
    name = 'cf1_burst'; priority = 4; interruptible = True
    def on_enter(self, context):
        super().on_enter(context)
        self._strokes = 0
    def tick(self, context, ctrl):
        import mco_wave_library as wl
        V_ms = context.get('V_ms', 0.0)
        ok, reason = wl.cf1_available(V_ms, wl.CF1_DEFAULT_FREQ_HZ, ctrl._tgt_sweeps)
        if not ok:
            self._state = FAILURE; return FAILURE
        ctrl._tgt_freq      = wl.CF1_DEFAULT_FREQ_HZ
        ctrl._tgt_sweeps    = [60.0]  * 8
        ctrl._tgt_dihedrals = [0.0]   * 8
        ctrl._tgt_pitches   = [wl.CF1_PITCH_OFFSET_DEG] * 8
        self._strokes = int(self.elapsed(context) * wl.CF1_DEFAULT_FREQ_HZ)
        if self._strokes >= wl.CF1_BURST_MAX:
            self._state = SUCCESS; return SUCCESS
        return RUNNING


class RecoverBehaviour(BehaviourNode):
    name = 'recover'; priority = 0; interruptible = False
    def tick(self, context, ctrl):
        import mco_wave_library as wl
        V_ms  = context.get('V_ms', 5.0)
        pitch = context.get('pitch_deg', 0.0)
        # Rev O3: X-29 forward sweep for stall recovery
        # Root stalls first → tip pitch servos remain effective
        p = wl.x29_stall_recovery_params(
            V_ms, pitch, ctrl.freq_hz)
        ctrl._tgt_freq      = p['freq_hz']
        ctrl._tgt_sweeps    = p['sweeps']
        ctrl._tgt_dihedrals = p['dihedrals']
        ctrl._tgt_pitches   = p['pitches']
        if p['recovering'] and self.elapsed(context) > 1.5:
            self._state = SUCCESS; return SUCCESS
        if self.elapsed(context) > 5.0:
            ctrl.emergency_recover()
            self._state = SUCCESS; return SUCCESS
        return RUNNING


class ChandellesMacro(BehaviourNode):
    """
    Chandelle macro — 180° maximum-performance climbing turn.

    [AUTOPILOT DEFERRED]
    Designated as an autonomous trajectory function deferred to the post-first-flight
    autopilot implementation bucket (see _AUTOPILOT_DEFERRED['CHANDELLE_MACRO']
    in mco_wave_library.py). Not part of active manual-pilot flight laws.
    """
    name = 'chandelle'; priority = 5; interruptible = True
    def on_enter(self, context):
        super().on_enter(context)
        self._entry_heading = context.get('heading_deg', 0.0)
        self._direction     = context.get('direction', 'right')
    def tick(self, context, ctrl):
        import mco_wave_library as wl
        heading_change = abs(
            context.get('heading_deg', 0.0) - self._entry_heading) % 360
        if heading_change > 180: heading_change = 360 - heading_change
        freq  = wl.chandelle_freq(heading_change)
        bank  = wl.chandelle_bank(heading_change)
        ctrl._tgt_freq   = freq
        ctrl._tgt_sweeps = [wl.CHANDELLE_SWEEP_DEG] * 8
        ctrl._tgt_pitches= [wl.CHANDELLE_PITCH_OFFSET_DEG] * 8
        sw_delta = bank * 0.5
        for i in range(8):
            is_port = (i % 2 == 0)
            inner   = ((self._direction=='right') and not is_port) or \
                      ((self._direction=='left')  and     is_port)
            ctrl._tgt_sweeps[i] = (wl.CHANDELLE_SWEEP_DEG + sw_delta
                                    if inner else wl.CHANDELLE_SWEEP_DEG)
        if heading_change >= 178:
            self._state = SUCCESS; return SUCCESS
        return RUNNING


# ── REV L — DART MACRO ───────────────────────────────────────────

class DartMacro(BehaviourNode):
    """
    Rev L: Dragonfly dart — W1+W4 pitch 75° (vertical fins).
    W2+W3 continue flapping to sustain lift throughout.
    2.4g lateral, 90° heading change in 0.15s at V=14m/s.
    Analogous to Fokker Dr.I snap-turn, Iz = 0.17 kg·m².

    [AUTOPILOT DEFERRED: SCRIPTED MACRO ONLY]
    The canned multi-phase state machine macro is deferred to autonomous autopilot collision avoidance.
    Manual pilot dart turns are actively handled invisibly on every tick by `dart_control_tick()`
    in `mco_wave_library.py` under coordinated pilot roll stick and rudder pedal inputs!
    """
    name = 'dart'; priority = 3; interruptible = False

    def on_enter(self, context):
        super().on_enter(context)
        import mco_wave_library as wl
        self._dir = context.get('direction', 'right')
        V = context.get('V_ms', 9.0)
        safe, reason = wl.dart_safe_to_initiate(
            V, context.get('h_agl_m', 50.0),
            context.get('bank_deg', 0.0))
        if not safe and 'sprint' not in reason:
            self._state = FAILURE
            self.log(f'Dart blocked: {reason}')
            return
        self._phase = (wl.DART_PHASE_ENGAGE
            if V >= wl.DART_PREBUILD_V_MS * 0.95
            else wl.DART_PHASE_PREBUILD)
        self._phase_t = context.get('t', 0.0)
        self.log(f'Dart {self._dir} V={V:.1f}m/s')

    def tick(self, context, ctrl):
        import mco_wave_library as wl
        t  = context.get('t', 0.0)
        V  = context.get('V_ms', 9.0)
        dt = t - self._phase_t
        if self._phase == wl.DART_PHASE_DISENGAGE:
            p = wl.dart_disengage_fling(
                dt, self._dir, V, ctrl.freq_hz)
        else:
            p  = wl.dart_sequence_params(
                self._phase, dt, self._dir, V,
                context.get('bank_deg', 0.0), ctrl.freq_hz)
        ctrl._tgt_freq      = p['freq_hz']
        ctrl._tgt_sweeps    = p['sweeps']
        ctrl._tgt_dihedrals = p['dihedrals']
        ctrl._tgt_pitches   = p['pitches']
        # Sync fin mode so enforce_physical_limits uses right AoA range
        ctrl._fin_mode_pairs = wl._FIN_MODE_PAIRS.copy() \
            if hasattr(wl,'_FIN_MODE_PAIRS') else None
        if p['phase_done']:
            _NX = {wl.DART_PHASE_PREBUILD:  wl.DART_PHASE_ENGAGE,
                   wl.DART_PHASE_ENGAGE:    wl.DART_PHASE_PIVOT,
                   wl.DART_PHASE_PIVOT:     wl.DART_PHASE_DISENGAGE,
                   wl.DART_PHASE_DISENGAGE: wl.DART_PHASE_RESUME,
                   wl.DART_PHASE_RESUME:    None}
            nxt = _NX.get(self._phase)
            if nxt is None:
                self._state = SUCCESS
                self.log(f'Dart {self._dir} complete')
                return SUCCESS
            self.log(f'Dart phase {self._phase}→{nxt}')
            self._phase = nxt
            self._phase_t = t
        return RUNNING

    def can_be_preempted_by(self, other_priority, is_safety=False):
        return is_safety


# ── REV K — COORDINATION BEHAVIOURS ─────────────────────────────

class ZoomClimbMacro(BehaviourNode):
    """
    Rev N: Zoom climb — V→h Boyd energy conversion.

    [AUTOPILOT DEFERRED]
    Designated as an autonomous trajectory function deferred to the post-first-flight
    autopilot implementation bucket (see _AUTOPILOT_DEFERRED['ZOOM_CLIMB_MACRO']
    in mco_wave_library.py). Not part of active manual-pilot flight laws.
    """
    name = 'zoom_climb'; priority = 4; interruptible = True

    def on_enter(self, context):
        super().on_enter(context)
        import mco_wave_library as wl
        V = context.get('V_ms', 9.0)
        safe, reason = wl.zoom_safe_to_initiate(
            V, context.get('h_agl_m', 50.0))
        if not safe:
            self._state = FAILURE; self.log(f'Zoom blocked:{reason}'); return
        self._phase   = wl.ZOOM_PHASE_ENTRY
        self._phase_t = context.get('t', 0.0)
        self.log(f'Zoom V={V:.1f}m/s')

    def tick(self, context, ctrl):
        import mco_wave_library as wl
        t=context.get('t',0.0); V=context.get('V_ms',9.0)
        Ps=context.get('Ps',0.0); dt=t-self._phase_t
        np_=wl.zoom_phase_from_state(V,dt,Ps)
        if np_!=self._phase:
            self.log(f'{self._phase}→{np_}'); self._phase=np_; self._phase_t=t
        if self._phase==wl.ZOOM_PHASE_ENTRY:
            p=wl.zoom_entry_params(V)
        elif self._phase==wl.ZOOM_PHASE_CLIMB:
            p=wl.zoom_climb_params(V,Ps,ctrl.freq_hz,dt)
        elif self._phase==wl.ZOOM_PHASE_APEX:
            p=wl.zoom_apex_params(V)
        else:
            p=wl.zoom_resume_params(V,Ps,ctrl.freq_hz)
            if dt>2.0: self._state=SUCCESS; return SUCCESS
        ctrl._tgt_freq=p['freq_hz']; ctrl._tgt_sweeps=p['sweeps']
        ctrl._tgt_dihedrals=p['dihedrals']; ctrl._tgt_pitches=p['pitches']
        return RUNNING


class PowerDiveBehaviour(BehaviourNode):
    """Rev N: Power dive — wings deployed, gravity+thrust."""
    name = 'power_dive'; priority = 8; interruptible = True

    def tick(self, context, ctrl):
        import mco_wave_library as wl
        pitch=context.get('pitch_deg',-15.0)
        V=context.get('V_ms',9.0); Ps=context.get('Ps',0.5)
        lever=context.get('lever_pct',80.0)
        safe,_=wl.power_dive_safe(V,context.get('h_agl_m',50.0),pitch)
        if not safe: self._state=FAILURE; return FAILURE
        p=wl.power_dive_params(pitch,V,Ps,ctrl.freq_hz,lever)
        ctrl._tgt_freq=p['freq_hz']; ctrl._tgt_sweeps=p['sweeps']
        ctrl._tgt_dihedrals=p['dihedrals']; ctrl._tgt_pitches=p['pitches']
        return RUNNING


class CrabBehaviour(BehaviourNode):
    """
    Rev O3: Crab manoeuvre — lateral translation without heading change.
    Port wings at 30° sweep → 17N lateral = 3.5g.
    Fin pitch at 44° cancels induced yaw → heading held.
    Stbd wings at 60° → normal forward thrust + lift.
    4 independent control axes simultaneously.
    """
    name = 'crab'; priority = 7; interruptible = True

    def tick(self, context, ctrl):
        import mco_wave_library as wl
        direction = context.get('direction', 'left')
        intensity = context.get('intensity', 1.0)
        V_ms  = context.get('V_ms', 9.0)
        bank  = context.get('bank_deg', 0.0)
        safe, reason = wl.crab_safe(V_ms,
            context.get('h_agl_m', 50.0), bank)
        if not safe:
            self._state = FAILURE; return FAILURE
        p = wl.crab_params(
            direction, intensity, V_ms,
            ctrl.freq_hz, heading_hold=True)
        ctrl._tgt_sweeps    = p['sweeps']
        ctrl._tgt_pitches   = p['pitches']
        ctrl._tgt_freq      = p['freq_hz']
        ctrl._tgt_dihedrals = [0.0] * 8
        return RUNNING


class FlatTurnBehaviour(BehaviourNode):
    """Rev K/L: Flat turn — phase asymmetry + fin pitch (W1+W4)."""
    name = 'flat_turn'; priority = 8; interruptible = True

    def tick(self, context, ctrl):
        import mco_wave_library as wl
        yaw  = context.get('yaw', 0.0)
        bank = context.get('bank_deg', 0.0)
        base = [0.0, 90.0, 180.0, 270.0, 0.0, 90.0, 180.0, 270.0]
        phases, sw_corr, freq, _ = wl.flat_turn_params(
            yaw, bank, base, ctrl.freq_hz)
        ctrl._tgt_freq = freq
        for i in range(8):
            ctrl._tgt_sweeps[i] = max(60.0, ctrl._tgt_sweeps[i] + sw_corr[i])
        # Rev L: add fin pitch for maximum yaw authority
        yaw_dir = 'right' if yaw >= 0 else 'left'
        ctrl._tgt_pitches = wl.fin_pitch_angles(abs(yaw) * 0.5, yaw_dir)
        # Rev O2: W4 vectored thrust
        if abs(yaw) > 0.3:
            vt = wl.w4_vectored_thrust_params(
                yaw_dir, abs(yaw)*0.7, ctrl.freq_hz)
            ctrl._tgt_sweeps[6] = vt['w4_port_sweep']
            ctrl._tgt_sweeps[7] = vt['w4_stbd_sweep']
        return RUNNING


# ── MISC BEHAVIOURS ──────────────────────────────────────────────

class WingConfigBehaviour(BehaviourNode):
    name = 'wing_config'; priority = 7; interruptible = True
    def tick(self, context, ctrl):
        import mco_wave_library as wl
        gs_id = context.get('gs_id', 'GS-0')
        V_ms  = context.get('V_ms', 8.0)
        ok, _ = wl.partial_stow_ok(gs_id, V_ms,
            context.get('h_agl_m', 50.0), 0.0)
        if not ok: gs_id = 'GS-0'
        try:
            cfg = wl.get_partial_stow_config(gs_id)
            for i in range(8):
                pair = i // 2 + 1
                if pair in cfg['stowed_pairs']:
                    ctrl._tgt_sweeps[i] = 210.0
        except Exception:
            pass
        return RUNNING


class TaxiFwdBehaviour(BehaviourNode):
    name = 'taxi_fwd'; priority = 10; interruptible = True
    def tick(self, context, ctrl):
        from mco_taxi_park import taxi_commands
        wind_data = {
            'V_wind_ms': context.get('V_wind_ms', context.get('wind_speed_ms', 0.0)),
            'wind_bearing_deg': context.get('wind_bearing_deg', context.get('wind_dir_deg', 0.0)),
            'heading_deg': context.get('heading_deg', context.get('yaw_deg', 0.0)),
        }
        if not wind_data['V_wind_ms'] and isinstance(context.get('sensors'), dict):
            s = context['sensors']
            wind_data['V_wind_ms'] = s.get('V_wind_ms', s.get('wind_speed_ms', 0.0))
            wind_data['wind_bearing_deg'] = s.get('wind_bearing_deg', s.get('wind_dir_deg', 0.0))
            wind_data['heading_deg'] = s.get('heading_deg', s.get('yaw_deg', 0.0))

        cmd = taxi_commands(context.get('throttle', 0.3),
                            context.get('yaw', 0.0),
                            lateral_cmd=context.get('lateral', 0.0),
                            wind_data=wind_data)
        ctrl._tgt_freq = cmd['freq_hz']
        for i, wc in enumerate(cmd['wing_cmds']):
            ctrl._tgt_sweeps[i]     = wc['sweep']
            ctrl._tgt_pitches[i]    = wc['pitch']
            ctrl._tgt_dihedrals[i]  = wc.get('dihedral_deg', 0.0)
        return RUNNING


class TaxiRevBehaviour(BehaviourNode):
    name = 'taxi_rev'; priority = 10; interruptible = True
    def tick(self, context, ctrl):
        from mco_taxi_park import taxi_commands
        wind_data = {
            'V_wind_ms': context.get('V_wind_ms', context.get('wind_speed_ms', 0.0)),
            'wind_bearing_deg': context.get('wind_bearing_deg', context.get('wind_dir_deg', 0.0)),
            'heading_deg': context.get('heading_deg', context.get('yaw_deg', 0.0)),
        }
        if not wind_data['V_wind_ms'] and isinstance(context.get('sensors'), dict):
            s = context['sensors']
            wind_data['V_wind_ms'] = s.get('V_wind_ms', s.get('wind_speed_ms', 0.0))
            wind_data['wind_bearing_deg'] = s.get('wind_bearing_deg', s.get('wind_dir_deg', 0.0))
            wind_data['heading_deg'] = s.get('heading_deg', s.get('yaw_deg', 0.0))

        cmd = taxi_commands(context.get('throttle', 0.2),
                            context.get('yaw', 0.0),
                            lateral_cmd=context.get('lateral', 0.0),
                            reverse=True,
                            wind_data=wind_data)
        ctrl._tgt_freq = cmd['freq_hz']
        for i, wc in enumerate(cmd['wing_cmds']):
            ctrl._tgt_sweeps[i]     = wc['sweep']
            ctrl._tgt_pitches[i]    = wc['pitch']
            ctrl._tgt_dihedrals[i]  = wc.get('dihedral_deg', 0.0)
        return RUNNING


class InspectionBehaviour(BehaviourNode):
    name = 'inspection'; priority = 11; interruptible = True
    def tick(self, context, ctrl):
        ctrl._tgt_sweeps    = [90.0] * 8
        ctrl._tgt_freq      = 0.0
        ctrl._tgt_dihedrals = [0.0]  * 8
        ctrl._tgt_pitches   = [0.0]  * 8
        return RUNNING


class TakeoffRollBehaviour(BehaviourNode):
    """Conventional fixed-wing takeoff roll acceleration behaviour.
    Advances throttle with neutral stick along runway centerline.
    Wider stroke arc and forward sweep (60°) generate maximum horizontal acceleration
    while rudder pedals maintain directional tracking.
    Integrates high-wind takeoff matrix (H-HEAD-TO-1, H-CROSS-TO-1, H-VAULT-GUST-1) for
    gust breakout and decoupled lateral thrust crosswind tracking.
    """
    name = 'takeoff_roll'; priority = 8; interruptible = True

    def tick(self, context, ctrl):
        import mco_advanced_physics as ap
        throttle = context.get('throttle', 0.85)
        V_ms = context.get('V_ms', 0.0)
        regime = context.get('regime', 'standard')

        # Check high-wind takeoff matrix
        V_w = context.get('V_wind_ms', context.get('wind_speed_ms', 0.0))
        w_b = context.get('wind_bearing_deg', context.get('wind_dir_deg', 0.0))
        hdg = context.get('heading_deg', context.get('yaw_deg', 0.0))
        rwy_hdg = context.get('runway_heading_deg', hdg)
        if not V_w and isinstance(context.get('sensors'), dict):
            s = context['sensors']
            V_w = s.get('V_wind_ms', s.get('wind_speed_ms', 0.0))
            w_b = s.get('wind_bearing_deg', s.get('wind_dir_deg', 0.0))
            hdg = s.get('heading_deg', s.get('yaw_deg', 0.0))
            rwy_hdg = s.get('runway_heading_deg', hdg)

        to_mode, ground_roll_target, to_diag = ap.high_wind_takeoff_matrix(
            V_wind_ms=V_w, wind_bearing_deg=w_b, heading_deg=hdg,
            runway_heading_deg=rwy_hdg, intent='takeoff',
            mass_kg=context.get('mass_kg', 5.367)
        )

        cmds, freq, diag = ap.ctol_takeoff_roll_kinematics(throttle, V_ms, regime)
        ctrl._tgt_freq = freq

        # Heading / yaw tracking via differential dihedral / pedal bias
        yaw_cmd = context.get('yaw', 0.0)
        yaw_delta = yaw_cmd * 3.0

        # Crosswind decoupled lateral compensation if H-CROSS-TO-1 active
        lat_comp = 0.0
        if to_mode == 'H-CROSS-TO-1' and abs(to_diag.get('V_cross_ms', 0.0)) > 2.0:
            # Positive V_cross pushes aircraft left -> need right lateral thrust
            v_cr = to_diag['V_cross_ms']
            lat_comp = 4.0 if v_cr > 0 else -4.0

        for i, c in enumerate(cmds):
            is_port = (i % 2 == 0)
            ctrl._tgt_pitches[i]   = c['pitch_deg']
            ctrl._tgt_sweeps[i]    = c['sweep_deg']
            dih_base = 6.0 + (lat_comp if is_port else -lat_comp)
            ctrl._tgt_dihedrals[i] = max(0.0, dih_base + (yaw_delta if is_port else -yaw_delta))

        # Check if aircraft lifted off unexpectedly or entered climb
        if context.get('h_agl_m', 0.0) > 0.45:
            self._state = SUCCESS
            return SUCCESS

        return RUNNING


class RotateBehaviour(BehaviourNode):
    """Conventional fixed-wing dual-cascade rotation and liftoff behaviour.
    Blends Front Cascade (W1-W2) Canard Direct Lift with Rear Cascade (W3-W4)
    elevon tail-down pitching moment to rotate without tail-strike risk.
    Transitions to flight/climb upon unstick.
    """
    name = 'rotate'; priority = 7; interruptible = True

    def on_enter(self, context):
        super().on_enter(context)
        self._start_t = context.get('t', 0.0)

    def tick(self, context, ctrl):
        import mco_advanced_physics as ap
        pitch_in = context.get('pitch', 0.5)
        V_ms = context.get('V_ms', 4.5)
        regime = context.get('regime', 'standard')
        h_agl = context.get('h_agl_m', 0.0)
        climb_rate = context.get('climb_rate_ms', context.get('vz_ms', 0.0))

        cmds, freq, diag = ap.ctol_dual_cascade_rotation(pitch_in, V_ms, regime)
        ctrl._tgt_freq = freq

        # Structural load factor protection during rotation at high dynamic pressure (V > 8 m/s)
        if V_ms > 8.0:
            aoa_lim = ap.dynamic_pressure_aoa_limit(V_ms, target_nz=2.2, gross_weight_kg=context.get('gross_weight_kg', 5.687))
            for c in cmds:
                c['pitch_deg'] = min(c['pitch_deg'], aoa_lim)

        for i, c in enumerate(cmds):
            ctrl._tgt_pitches[i]   = c['pitch_deg']
            ctrl._tgt_sweeps[i]    = c['sweep_deg']
            ctrl._tgt_dihedrals[i] = 6.0

        # Liftoff / transition confirmation:
        # Exit to SUCCESS (handing off to CLIMB/CRUISE) when height exceeds unstick target
        # or climb rate is positive.
        unstick_target = diag.get('unstick_target_m', 0.37)
        if h_agl >= unstick_target or climb_rate >= 0.50:
            self._state = SUCCESS
            return SUCCESS

        return RUNNING
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
