wrbell/dad-ornithopter/(commit log)

2026-09-28 feat: complete repository baseline with all 28 test suites, CAD assets, docs, and simulation scripts
2026-09-28 fix(cad): upgrade 25cm wing segment to use robust oval lightening holes on all ribs for support removal survival
2026-09-29 fix(cad): thicken wingtip trailing edge by 1.0mm chordwise and reduce spanwise vertical thickness to eliminate ragged overhangs
2026-09-30 feat(aero): implement Path 2 physical calibration and regression test baseline
2026-09-30 docs(mark1): update authoritative specifications, manuals, software reference, and audit report to reflect Path 2 physical calibration and TC-01 bench qualification
2026-09-30 fix(sim): calibrate H-CMP-3 and H-CMP-5 frequencies to hardware limit, enable fin_mode on H-54, and add exhaustive hypothesis simulation harness
2026-09-30 feat: add printable PDF test card worksheets and generator script
2026-09-30 docs: incorporate printable worksheets and automated telemetry export instructions across Mark 1 manuals
2026-10-01 Recalculate flight envelope for baseline GoolRC 5010 motor baseline (5.367 kg MTOW)
2026-10-03 Reinforce wingtip trailing edge with +2mm chordwise solid land and export starboard aliases
2026-10-06 Lock in compact delta fuselage frame CAD, BOM, and firmware parameters
2026-10-16 feat: V10 Wing Root Assembly, Sector Drum Restoration, PrusaSlicer MCP & CI Infrastructure
    - Delete obsolete NACA 0018 fairing across Fusion assembly, 3D print package, and master STEP
    - Restore 7-spoke Stagecoach sector drum with dual helical Dyneema tracks and internal routing tunnels to M3 clamp bolts
    - Verify zero pairwise Boolean interference (0.0000 mm³) across all 9 assembled solid bodies
    - Build 19-component, 18 As-Built joint Assembly in Autodesk Fusion 360 via live MCP and export MCO-1D_V10_Wing_Root_Assembly.f3d
    - Add native FastMCP PrusaSlicer 2.9.6 server and CLI integration with Prusa CORE One profiles
    - Add GitHub Actions CI workflow (.github/workflows/ci.yml) running hygiene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
2026-10-16 feat(slicer): configure 0.20mm structural PLA prototype profile and single-bed slicing workflow
2026-10-16 Refactor repo: strip 710MB slop, establish SSoT, fix CAD/firmware/kinematics bugs, add AGENTS.md & 7-gate doctor
