wrbell/dad-ornithopter/(notices)

Notices in the files:
README.md:
License: MIT
